Agile-and-Adaptive-Robotics/Bipedal_Robot/Documentation/Posters/Template/biorobotics_poster_template.pptx

The Insect Brain as a Model for Robotic Sensing
and Decision Making

Andrew D. Horchler¹, Roy E. Ritzmann², and Roger D. Quinn¹

1) Dept. of Mechanical and Aerospace Engineering and 2) Dept. of Biology, Case Western Reserve University

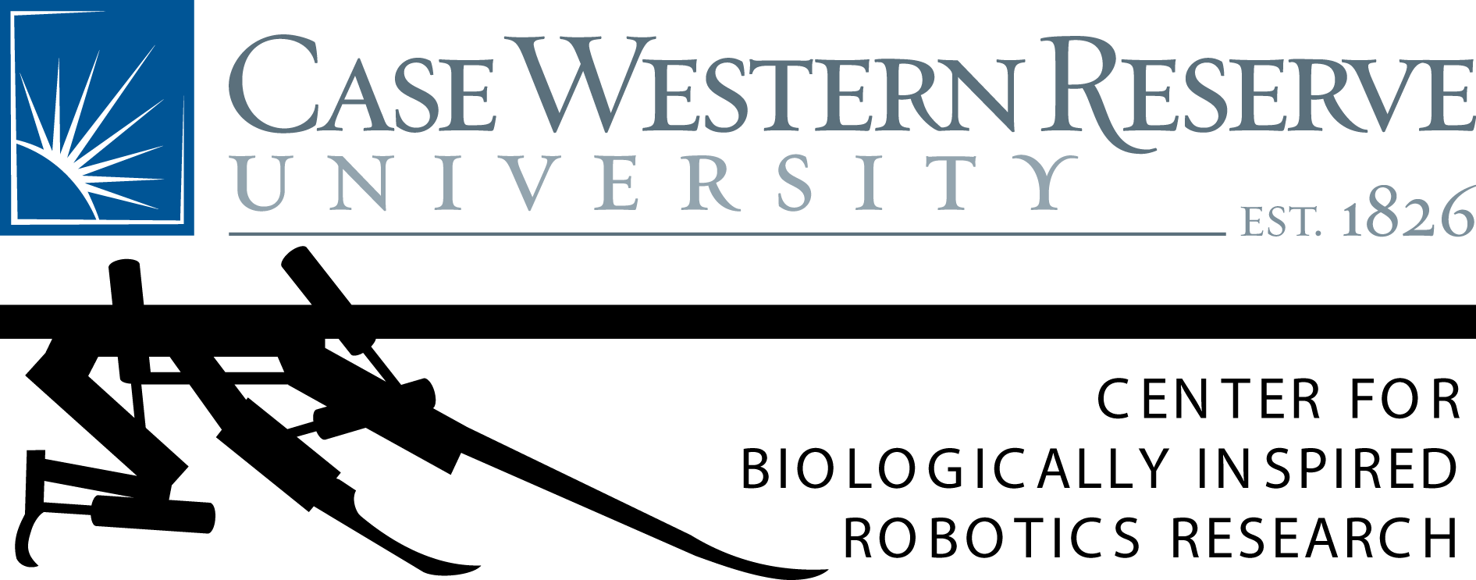
[picture p17: figure]

Introduction
Despite many technical advances, current mobile robots lack true autonomy, often require an operator, are restricted to constrained environments and tasks, and are difficult to program and tune. Insects function well in dynamic and uncertain environments that challenge the sensing and autonomous capabilities of existing robots. The insect brain relies on multiple sensory channels and a large behavioral repertoire to accomplish the complex goal-directed tasks needed for survival. The multi-sensory integration and decision-making capabilities of a brain are necessary to trigger, modulate, and provide context to the low-level, reflexive motor control. We’re developing a biologically-inspired sensorimotor system modeled on the architecture and behavioral functionality of the central complex (CC) of the insect brain and general principles of vertebrate brains to enhance the state-of-the-art in sensory integration and control for mobile robots. A simulated agent uses simple models of antennal sensing, vision, and ego-motion to navigate a 2-D environment. Percepts are organized via sensory maps that correlate the unique spatiotemporal and statistical properties of each sensing modality. These topographic maps are based on the distinct columnar design of the insect CC and are modeled as arrays of interconnected neural populations using Wilson-Cowan equations. The maps converge onto a network of neural circuits, based on a model of the primate lateral intraparietal cortex, that accumulates time-varying evidence in order to make behavioral decisions. The attractor dynamics of these circuits generate a winner-take-all competition that guarantees a decision within a fixed time period and the overall activity pattern captures the associated degree of confidence. Experiments have been performed to characterize the robustness of this biophysically plausible architecture in the presence noisy, ambiguous, and conflicting multi-sensory stimuli in the agent’s environment.

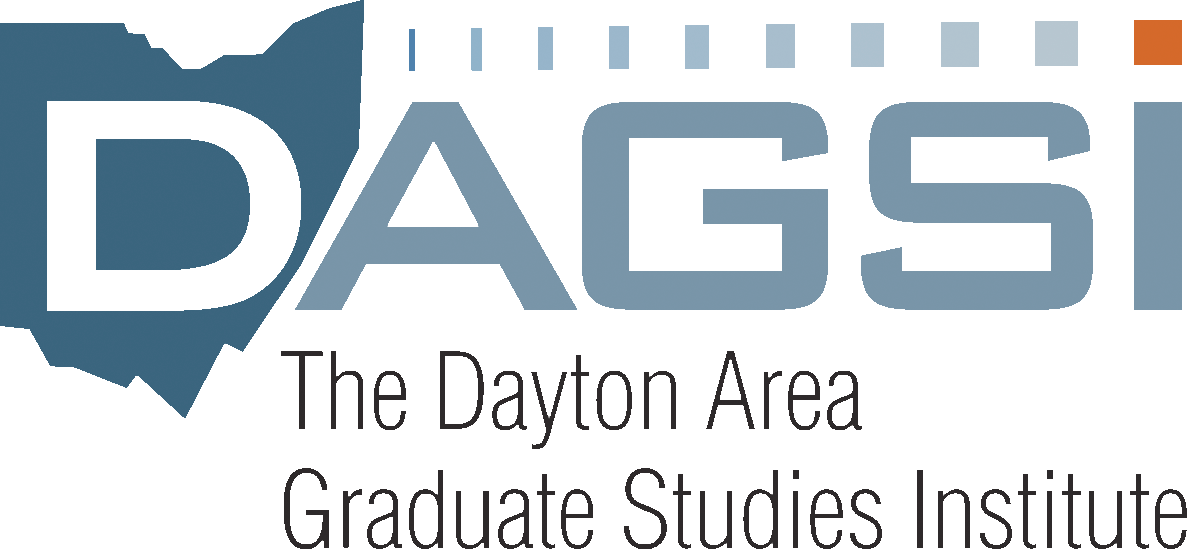
[picture p18: figure]
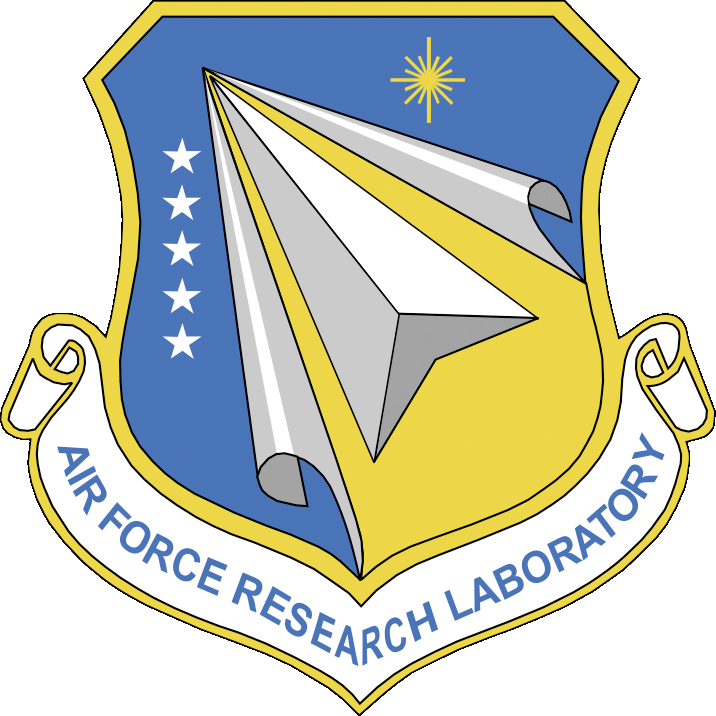
[picture p19: figure]
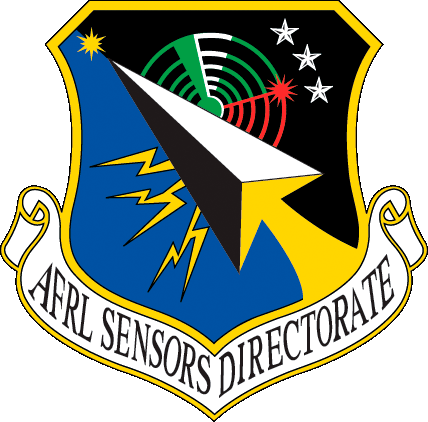
[picture p20: figure]

Heading

Regular text
- Bullet 1
- Bullet 2

References
1. Reference 1
2. Reference 2
3. Reference 3
