Agile-and-Adaptive-Robotics/Bipedal_Robot/Documentation/Meeting Notes/Bipedal Project Fa2020.rtf

Bipedal project meetings
Fall Term, 2020
10-6-2020

- Ben recap of priorities
- High priority: Femur and Tibia design. Two mounting holes, 1/4-20.
- Hose air fittings: design, test, print -> repeat as needed
- Note to self: Check out Microsoft surfacebook (pro 2.0?).
- Figure out questions we're hoping to answer with knee paper. what we're hoping to learn from the knee test.
- Quadriceps wrapping around knee or attach to a patella?
- Which method of calculating moment arm is correct?
- Insights from comparison of hamstring and quad?
- What torque values about the knee do we get from muscle x of xx diameter and xx length?
- How much time do we have to work on the project?
- Lindie, one class, but hopes to be done with project by the end of November.
- Ben, one class, but can spend a lot of time on the class.
- Lindie shows a prototype of the testing jig.
- Discussion about photographic data discussion. Ben and Lindie will both investigate methods to do it accurately. Connor will review for potential problems.
- Deliverables:
• Lindie: One or two more iterations of the prototype. Manufacturing in the garage will take a while.
• Ben: Have Femur and Tibia design done by the weekend. Where to put attachment point locations. Pin one end. How to wrap around knee? Multiple conisderations. Have design for review by the weekend, but don't necessarily print it
