Agile-and-Adaptive-Robotics/Bipedal_Robot/Documentation/Reports and Papers/Aidan Vogt Summer Overview.pptx

## KneeTest.m

- Used with KneeTorqueTest.ino and SLoadCell_ZeroFactorSketch.ino
- With KneeTorqueTest, Run command like this:
- Opens valve and reads pressure and force data

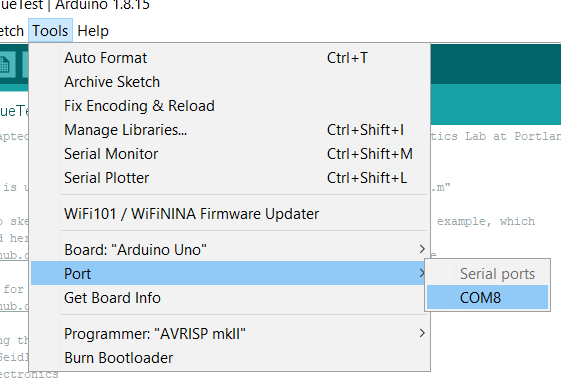
[picture p27: figure]

Protocol id (1 for zeroing the load cell, 2 for knee torque test)

The number of data points to collect

Port that the arduino is connected to (the number after the COM as seen in the example)

## KneeTorqueTest.ino

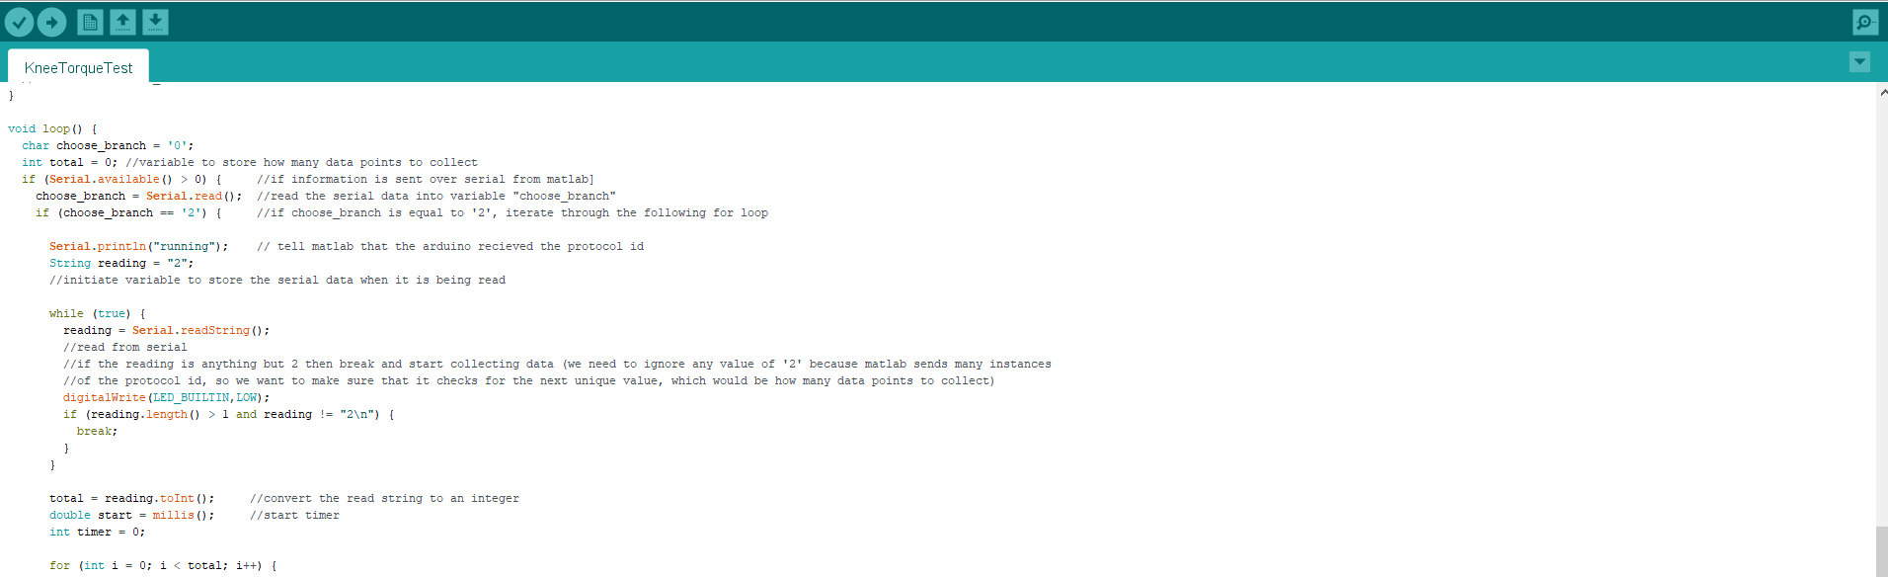
[picture p28: figure]

- Used with KneeTest.m
- To use without KneeTest.m:
  a. Open serial monitor inside arduino
  b. Send “2” until “running” is received
  c. Send number for how many data points to collect
  d. The arduino will start sending the data and open the valve

A

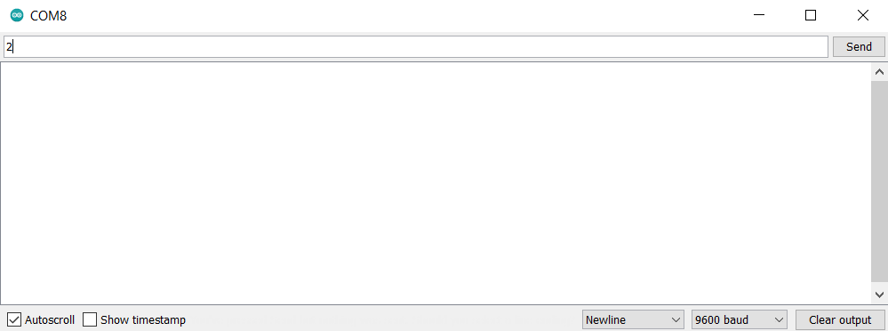
[picture p29: figure]
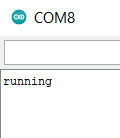
[picture p30: figure]

B

C

D

## ValvePWM.m

- Used with ValvePWM.ino
- Split into two phases: inflating and deflating
- Run command like this:

Amount of data points to be inflating

Period while inflating

Pulse width while deflating

Protocol id (2 for pwm test)

Port of arduino board (COM4 in this example)

Amount of data points to be deflating

Pulse width while inflating

Period while deflating

## ValvePWM.ino

- Used with ValvePWM.m
- To use without ValvePWM.m
  - Open Serial Monitor
  - Send “2” until “running” is received
  - Send values for data_in, data_out, pw_in, period_in, pw_out, and period_out in that order, separated by commas

## PressureTest.m

- Used for leak/fill test with PressureTest.ino
- Operated in the same way as KneeTest.m
- Only reports pressure

## PressureTest.ino

- Used for leak/fill test with PressureTest.m
- Operated in the same way as KneeTorqueTest.ino
- Only reports pressure

## Slide 7

Knee Joint

Physical Connection

BPA

Pressurized Air

Physical Connection

Valves

Air

Air

Air

Pressure Sensor

Load Cell

Data

Amp

Data

Data

Microcontroller

Transistors

Negative

On/Off

24V

Ground

Power Supply

Knee Test

## Slide 8

BPA

Pressurized Air

Physical Connection

Valves

Air

Air

Air

Pressure Sensor

Load Cell

Data

Amp

Data

Data

Microcontroller

Transistors

Negative

On/Off

24V

Ground

Power Supply

BPA characterization

## Slide 9

BPA

Pressurized Air

Valves

Air

Air

Air

Pressure Sensor

Data

Microcontroller

Transistors

Negative

On/Off

24V

Ground

Power Supply

Leak/fill test

## Slide 10

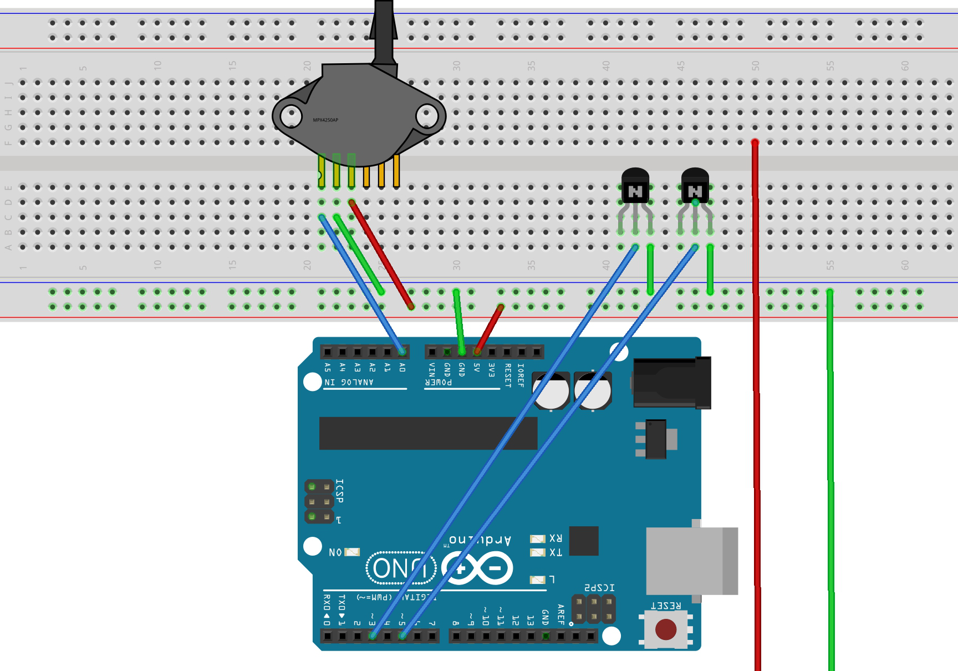
[picture p31: figure]

24v

24v

GND
