Agile-and-Adaptive-Robotics/Bipedal_Robot/Documentation/Reports and Papers/Bolen_3MT_PresentationSpeech.rtf

Neural control of locomotion is a complex process of sensing, processing, and acting that is not well understood. Greater understanding of this complex process necessitates modeling biomechanics and neural circuits, and investigating how interactions between the nervous system, the body, and the environment result in effective movement and behaviors. I propose that creating a bipedal (bipedal which means "two legs") robot that uses biologically inspired neural controllers to mimic human movements will deepen our understanding of muscle motor control.
Some of my work has been to design, from a biomechancial and engineering design approach, a bipedal human-like robot that mimics human movements. Our focus is on the lower portion of the human body. The picture on the left is a 3D printed skeleton. The bone segments are moved, or actuated, by Festo-brand pneumatic artificial muscles (PAMs). Theses artificial muscless can be used as muscles because they have force-length curves grossly similar to real muscles. The picture in the middle shows these artificial muscles as red lines attached to the robot skeleton. The attachment points of these muscles follow a similar path to human muscles, but slightly adjusted so that we can get similar joint torques as are found in human bodies.
So that's the physical robot side. My other work is to integrate these robots with neural controllers and feedback. [Feedback types include touch, stretch, and proprioception (the sixth sense)]. The picture on the right is the current neural controller schematic. It represents a 2-layer central pattern generator. This is how we believe certain movements are controlled via spinal cord circuits, before the need to involve higher order control from the brain. [Integrating biologically inspired neural controllers with biologically inspired robots will improve our understanding of neuroscience and biomechanics]
Much of my research work revolves around humanoid robots but the results are broadly applicable to other biomimetic robots that use PAMs, including the quadruped robot our lab is working on. Indeed, it is my hope that these robots will deepen our understanding of biological systems. Thank you for your consideration.

In our current work we build part of that robot (the knee, femur, and tibia), with uniarticular knee flexor and extensor PAMs, to test for the maximum isometric torque about the knee joint at various knee positions. However, previous experiments have only fully characterized the 10 mm diameter Festo PAM. Since our design uses 20 and 40 mm diameter Festo PAMs, we thought it important to fully characterize these PAM sizes and the results are included in this work. We compare the measured isometric torque values about the knee joint to the expected results, and discuss any deviation of the results. The results of these experiments help in better modeling and designing biomimetic humanoid robots.
