Agile-and-Adaptive-Robotics/Bipedal_Robot/Documentation/Reports and Papers/Solidworks Naming Convention.docx

Solidworks Naming Convention

Having the same naming convention for our parts and assemblies are important, especially when merging files and doing collaborative projects.

Here is the standard naming convention to use for Solidworks files:

Naming components

Separate with Underscores.

project #, assembly #, subassembly #, part #, Initials

Example:

01_01_01_01_AC

This is an example of the convention used for a project, the first assembly for it (which should be the main assembly), the subassembly (even if you don't really have a subassembly, just use the 01, you or someone else might make a second subassembly later), and the part number, which should start at 01 and continue (02 then 03 next, etc) in the timeline that you make the parts, regardless of assembly or subassembly.

Keep in mind that your timeline of parts creation should make sense (ex: main foot part > front foot part > toe part), that way your part names are somewhat recognized as being grouped, even without opening an assembly.

Naming Assemblies

Separate with underscores.

Project #, assembly #, subassembly #, Initials

Example

01_01_01_AC

This was a first project, first and main assembly, first subassembly, and initials. Refer to the explanation above for more information.

Suggestions for Naming Assemblies List (As created):

One project being worked on is the Bipedal Robot, it is considered project 01, with the below assembly numbers:

1. Foot Group
2. Lower leg Group
3. Knee Group
4. Upper leg Group

EX: A part for the knee group for the bipedal robot would be 01_03_01_01_AC
