Agile-and-Adaptive-Robotics/Bipedal_Robot/Code/Matlab/Bone_Mesh_Plots/Bone_Mesh_Plots_Readme.docx

Folder: Bone_Mesh_Plots

These scripts are meant to visualize both the skeletal structure and the muscle placement on the skeleton. No outputs are generated other than plots for quickly seeing how the muscles are placed on the structure.

Files and Descriptions:

Bone_Mesh_Plotting.m – This scrip plots the OpenSim skeletal points in Matlab. This script should be listed at the end of an muscle optimization script, as it will also pull location data from the optimization and plot the muscle on the skeletal structure. Requires no user input to run.

BoneMeshCode.m – This script creates a plot for ever skeletal structure from OpenSim as well as the overall skeleton. Requires no user input to run.

HipMotion.m – This script plots the OpenSim skeletal structure and rotates the Hip joint through it’s full range of flexion. Includes two muscles to display how they change in length as the hip actuates. Requires no user input to run
