Agile-and-Adaptive-Robotics/Bipedal_Robot/Documentation/Reports and Papers/Solidworks Naming Tree.xlsx

Prospective Parts | 01_00_00_Foot | 01_02_00_Foot | 01_01_02_01_FAxle.SLDPRT
 |  |  | 01_01_02_01_SmallAxle_Copy.SLDPRT
 |  |  | 01_01_02_02_FTLock.SLDPRT
 |  |  | 01_01_02_03_largeAxleLock.SLDPRT
 |  |  | 01_01_02_04_LeftMidFoot.SLDPRT
 |  |  | 01_01_02_05_NewFoot_Copy_ Copy.SLDPRT
 |  |  | 01_01_02_06_NewFrontFoot _Copy.SLDPRT
 |  |  | 01_01_02_07_NewFrontFoot.SLDPRT
 |  |  | 01_01_02_08_SmallAxleLock.SLDPRT
 |  |  | 01_01_02_09_SmallAxle.SLDPRT
 |  |  | 01_01_02_10_Toe.SLDPRT
 |  | 01_01_00_Ankle
 |  |  | 01_01_01_00_Ankle.SLDASM
 |  |  | 01_01_01_01_ABottom.SLDPRT
 |  |  | 01_01_01_02_AExterior.SLDPRT
 |  |  | 01_01_01_03_AInterior.SLDPRT
 |  |  | 01_01_01_04_ALock1.SLDPRT
 |  |  | 01_01_01_05_ALock2.SLDPRT
 |  |  | 01_01_01_06_AMiddleShell.SLDPRT
 |  |  | 01_01_01_07_FootAxle.SLDPRT
 |  |  | 01_01_01_08_Foot T Lock.SLDPRT
 | 02_00_00_InternFoot
 |  | 01_01_00_01_ML.SLDPRT
 |  | 01_01_00_02_ML.SLDPRT
 |  | 01_01_00_03_ML.SLDPRT
 |  | 01_01_00_04_ML.SLDPRT
 |  | 01_01_01_01_ML.SLDPRT
 |  | 01_01_01_02_ML.SLDPRT
 |  | 01_01_01_03_ML.SLDPRT
 |  | 01_01_01_ML.SLDASM
 |  | 01_ML.SLDASM
RobotAssembly2019 | 01-Vertebrae
 |  | 01_01_L2 with Attachments.SLDPRT
 |  | 01_02_L4.SLDPRT
 |  | 01_02_L5 with Attatchments.SLDPRT
 | 02-Sacrum
 |  | 02_01_Sacrum.SLDPRT
 | 03-Ilium
 |  | 03_01_Left Ilium Wing.SLDPRT
 |  | 03_02_Right Ilium Wing.SLDPRT
 | 04-Femor
 |  | 04_01_Femoral Knob.SLDPRT
 |  | 04_02_Femoral Head.SLDPRT
 |  | 04_03_Femoral Head Mirrored.SLDPRT
 |  | 04_04_Femor Bone.SLDPRT
 |  | 04_05_Femor Bone Mirrored.SLDPRT
 |  | 04_05_Femoral End.SLDPRT
 |  | 04_06_Femoral End Mirrored.SLDPRT
 |  | 04_07_Femor-Tibia Link.SLDPRT
 |  | Femoral end with hardware - Latest.SLDPRT
 | 05-Tibia
 |  | 05_01_Tibial Head.SLDPRT
 |  | 05_02_Tibial Head Mirrored.SLDPRT
 |  | 05_03_Tibial Rotator.SLDPRT
 |  | 05_04_Tibial Rotator Mirrored.SLDPRT
 |  | 05_05_Tibial Bone Connection.SLDPRT
 |  | 05_06_Tibial End.SLDPRT
 |  | 05_07_Tibial End Mirrored.SLDPRT
 |  | Base part tibial bone connection.SLDPRT
 |  | Tibial assemb.SLDASM
 |  | Tibial head with hardware - bone connection - test.SLDPRT
 |  | Tibial head with hardware - bone connection -Latest.SLDPRT
 | 06-Foot
 |  | 06_01_Foot.SLDASM
 |  | Metatarsals - Left side.SLDPRT
 |  | Metatarsals.SLDPRT
 |  | Phalanges - Left side.SLDPRT
 |  | Phalanges.SLDPRT
 |  | Talus - New201810205.SLDPRT
 | 07-David Leg | RobotAssembly2019_07_01-David Femor
 |  |  | FemorBone_111219_V2_DP.SLDPRT
 |  |  | FemorKneeEnd_103119_V13_DP.SLDPRT
 |  |  | FemoralHead_010620_V1_DP.SLDPRT
 |  |  | ~$FemorBone_111219_V2_DP.SLDPRT
 |  |  | ~$FemorKneeEnd_103119_V13_DP.SLDPRT
 |  |  | ~$FemoralHead_010620_V1_DP.SLDPRT
 |  | RobotAssembly2019_07_02-David Tibia
 |  |  | TibialHead_103119_V1_DP.SLDPRT
 |  |  | Tibial_011020_V2_DP.SLDPRT
 |  |  | ~$TibialHead_103119_V1_DP.SLDPRT
 |  |  | ~$Tibial_011020_V2_DP.SLDPRT
 |  | RobotAssembly2019_07_03-David Connection
 |  |  | BackLinkV1.SLDPRT
 |  |  | BoneConnectionScrews_97763A348_McMaster.SLDPRT
 |  |  | BrassInsert_94459A380_McMaster.SLDPRT
 |  |  | CushioningWasher_93650A145_McMaster.SLDPRT
 |  |  | FrontLinkV1.SLDPRT
 |  |  | ThreadedStud_97042A216_McMaster.SLDPRT
 |  |  | ~$BackLinkV1.SLDPRT
 |  |  | ~$BoneConnectionScrews_97763A348_McMaster.SLDPRT
 |  |  | ~$BrassInsert_94459A380_McMaster.SLDPRT
 |  |  | ~$CushioningWasher_93650A145_McMaster.SLDPRT
 |  |  | ~$FrontLinkV1.SLDPRT
 |  |  | ~$ThreadedStud_97042A216_McMaster.SLDPRT
 |  | FemoralAssembly_V3_022820.SLDASM
 |  | ~$FemoralAssembly_V3_022820.SLDASM
 | robot2019.SLDASM
 | ~$Tibial assemb.SLDASM
 | ~$Tibial head with hardware - bone connection - test.SLDPRT
