Agile-and-Adaptive-Robotics/Bipedal_Robot/Documentation/Reports and Papers/Isometric_Force_Test/Paper Gantt chart.xlsx

Sheet: Project schedule
Knee Torque paper |  |  |  |  | Project start: |  |  |  |  |  |  |  | 2023-12-07
Ben Bolen | Project lead |  |  |  | Display week: |  |  |  |  |  |  |  | 1
SIMPLE GANTT CHART by Vertex42.com (https://www.vertex42.com/ExcelTemplates/simple-gantt-chart.html)
https://www.vertex42.com/ExcelTemplates/simple-gantt-chart.html |  |  |  |  | 2023-12-04 |  |  |  |  |  |  | 2023-12-11 |  |  |  |  |  |  | 2023-12-18 |  |  |  |  |  |  | 2023-12-25 |  |  |  |  |  |  | 2024-01-01 |  |  |  |  |  |  | 2024-01-08 |  |  |  |  |  |  | 2024-01-15 |  |  |  |  |  |  | 2024-01-22
TASK | ASSIGNED TO | PROGRESS | START | END | 2023-12-04 | 2023-12-05 | 2023-12-06 | 2023-12-07 | 2023-12-08 | 2023-12-09 | 2023-12-10 | 2023-12-11 | 2023-12-12 | 2023-12-13 | 2023-12-14 | 2023-12-15 | 2023-12-16 | 2023-12-17 | 2023-12-18 | 2023-12-19 | 2023-12-20 | 2023-12-21 | 2023-12-22 | 2023-12-23 | 2023-12-24 | 2023-12-25 | 2023-12-26 | 2023-12-27 | 2023-12-28 | 2023-12-29 | 2023-12-30 | 2023-12-31 | 2024-01-01 | 2024-01-02 | 2024-01-03 | 2024-01-04 | 2024-01-05 | 2024-01-06 | 2024-01-07 | 2024-01-08 | 2024-01-09 | 2024-01-10 | 2024-01-11 | 2024-01-12 | 2024-01-13 | 2024-01-14 | 2024-01-15 | 2024-01-16 | 2024-01-17 | 2024-01-18 | 2024-01-19 | 2024-01-20 | 2024-01-21 | 2024-01-22 | 2024-01-23 | 2024-01-24
 |  |  |  |  | M | T | W | T | F | S | S | M | T | W | T | F | S | S | M | T | W | T | F | S | S | M | T | W | T | F | S | S | M | T | W | T | F | S | S | M | T | W | T | F | S | S | M | T | W | T | F | S | S | M | T | W
Initiation
Submit paper | Ben Bolen | 15% | 2023-11-30 | 2023-12-18
Revise draft | Ben Bolen | 0% | 2023-12-12 | 2023-12-17
Working draft | Ben Bolen | 50% | 2023-11-30 | 2023-12-12
Analysis
Update algorithms with new 10,20 mm force equations | Ben Bolen | 25% | 2023-12-02 | 2023-12-07
Create optimization for KSE | Ben Bolen | 25% | 2023-12-07 | 2023-12-08
Compare and run algorithm | Ben Bolen | 0% | 2023-12-02 | 2023-12-09
Update other algorithms with KSE | Ben Bolen |  | 2023-12-09 | 2023-12-10
Revise figures | Ben Bolen |  | 2023-12-10 | 2023-12-11
total | Ben Bolen |  | 2023-12-02 | 2023-12-11
Section writing
Intro: C3NS references | Ben Bolen | 2% | 2023-12-08 | 2023-12-09
Method: Hybrid torque | Ben Bolen | 2% | 2023-12-07 | 2023-12-10
Method: optimization? | Ben Bolen | 2% | 2023-12-07 | 2023-12-09
Results | Ben Bolen | 66% | 2023-12-07 | 2023-12-11
Conclusion | Ben Bolen | 5% | 2023-12-11 | 2023-12-12
total | Ben Bolen | 0% | 2023-12-07 | 2023-12-12
Figures
Fmax (A) | Ben Bolen | 100% | 2023-12-09 | 2023-12-12
Fmax (D) | Ben Bolen | 100% | 2023-12-12 | 2023-12-13
10mm biomimetic extensor | Ben Bolen | 50% | 2023-12-14 | 2023-12-15
20mm biomimetic flexor | Ben Bolen | 33% | 2023-12-15 | 2023-12-16
total | Ben Bolen | 10% | 2023-12-09 | 2023-12-16
Insert new rows ABOVE this one

Sheet: About
SIMPLE GANTT CHART by Vertex42.com (https://www.vertex42.com/ExcelTemplates/simple-gantt-chart.html)
About This Template
This template provides a simple way to create a Gantt chart to help visualize and track your project. Simply enter your tasks and start and end dates - no formulas required. The bars in the Gantt chart represent the duration of the task and are displayed using conditional formatting. Insert new tasks by inserting new rows.
Guide for Screen Readers
There are 2 worksheets in this workbook. TimeSheet About The instructions for each worksheet are in the A column starting in cell A1 of each worksheet. They are written with hidden text. Each step guides you through the information in that row. Each subsequent step continues in cell A2, A3, and so on, unless otherwise explicitly directed. For example, instruction text might say "continue to cell A6" for the next step. This hidden text will not print. To remove these instructions from the worksheet, simply delete column A.
Additional Help
Click on the link below to visit vertex42.com and learn more about how to use this template, such as how to calculate days and work days, create task dependencies, change the colors of the bars, add a scroll bar to make it easier to change the display week, extend the date range displayed in the chart, etc.
How to Use the Simple Gantt Chart (https://www.vertex42.com/ExcelTemplates/simple-gantt-chart.html)
More Project Management Templates
Visit Vertex42.com to download other project management templates, including different types of project schedules, Gantt charts, tasks lists, etc.
Project Management Templates (https://www.vertex42.com/ExcelTemplates/excel-project-management.html)
About Vertex42
Vertex42.com provides over 300 professionally designed spreadsheet templates for business, home, and education - most of which are free to download. Their collection includes a variety of calendars, planners, and schedules as well as personal finance spreadsheets for budgeting, debt reduction, and loan amortization.
Businesses will find invoices, time sheets, inventory trackers, financial statements, and project planning templates. Teachers and students will find resources such as class schedules, grade books, and attendance sheets. Organize your family life with meal planners, checklists, and exercise logs. Each template is thoroughly researched, refined, and improved over time through feedback from thousands of users.
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
