Agile-and-Adaptive-Robotics/Bipedal_Robot/Code/Matlab/github_repo/HX711.jpg

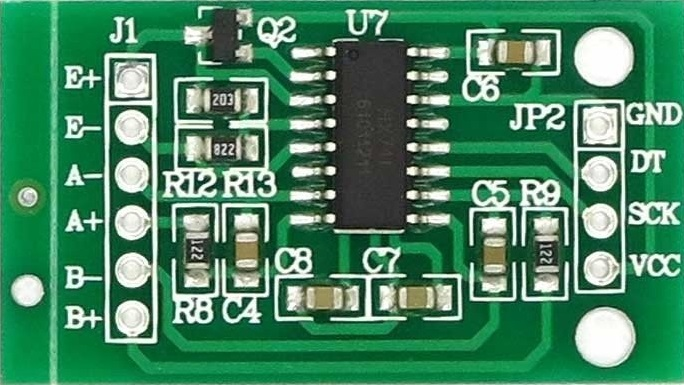
Code/Matlab/github_repo/HX711.jpg
