Agile-and-Adaptive-Robotics/Bipedal_Robot/Documentation/Posters/Bolen_NWBS_2021/Bolen_B9.jpg

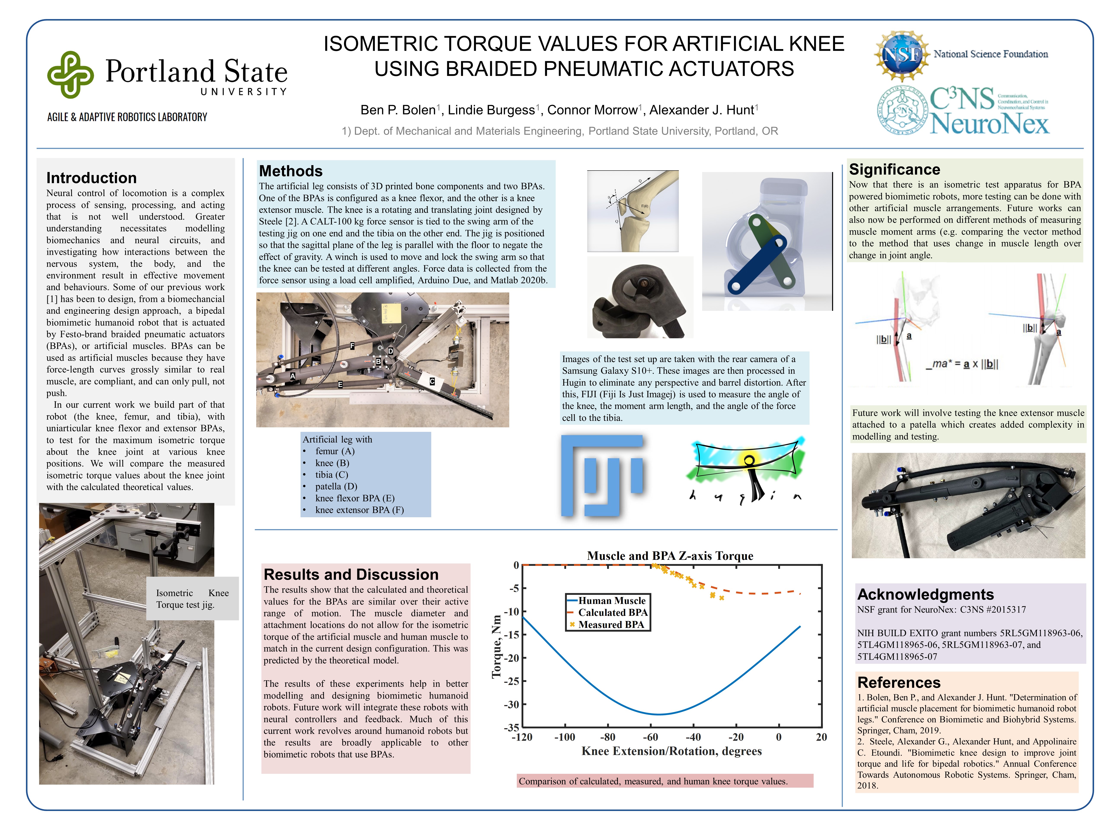
Documentation/Posters/Bolen_NWBS_2021/Bolen_B9.jpg
