Agile-and-Adaptive-Robotics/Bipedal_Robot/Documentation/Reports and Papers/Bolen_LM2023/Figures/GeneralizedForceFit.png

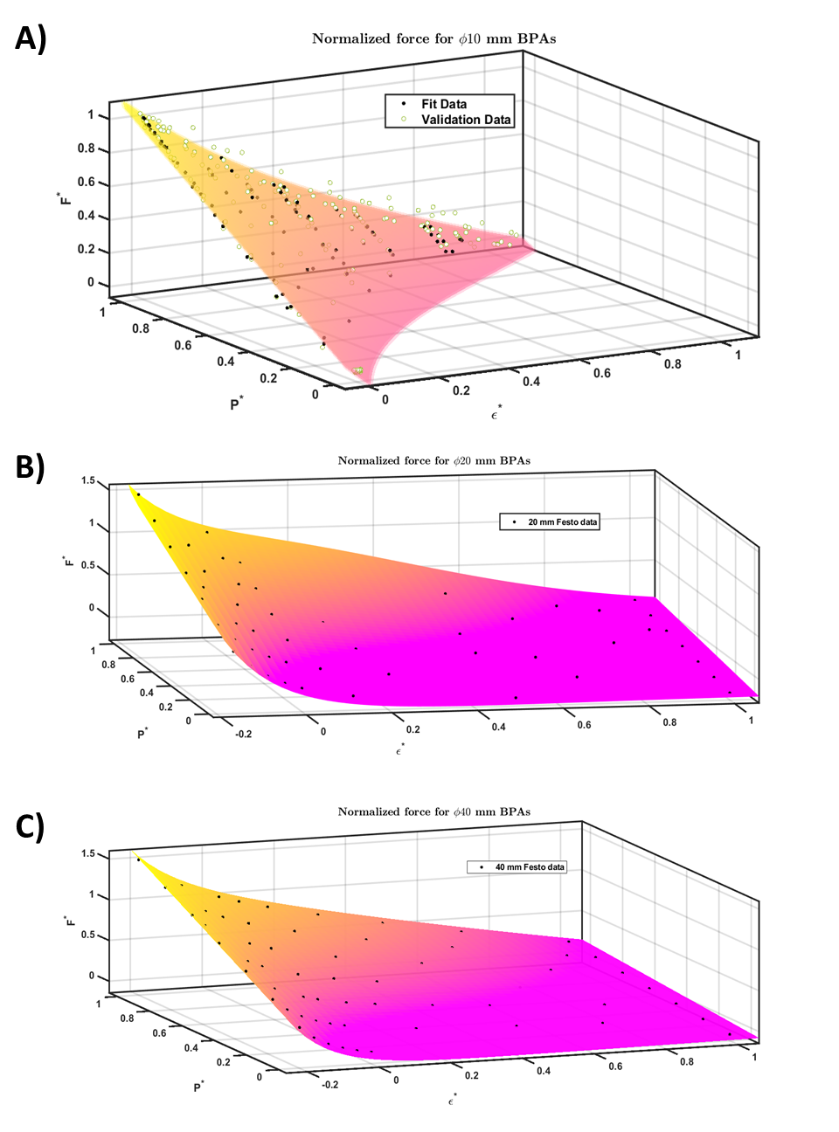
Documentation/Reports and Papers/Bolen_LM2023/Figures/GeneralizedForceFit.png
