Agile-and-Adaptive-Robotics/Bipedal_Robot/Pictures/PictureAnalysis/20mm_fullinflate.PNG

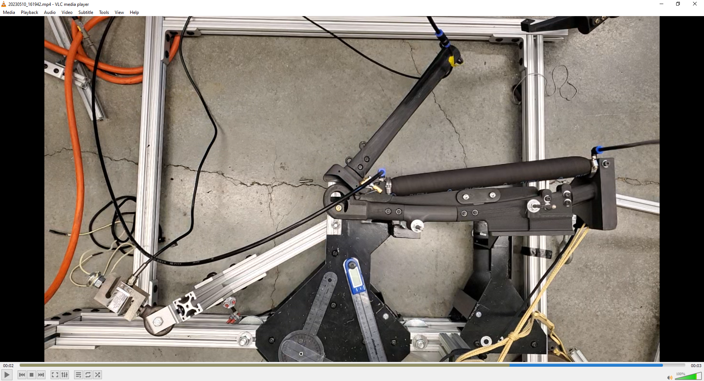
Pictures/PictureAnalysis/20mm_fullinflate.PNG
