Agile-and-Adaptive-Robotics/Bipedal_Robot/Pictures/PictureAnalysis/20mm_inflating_90deg.PNG

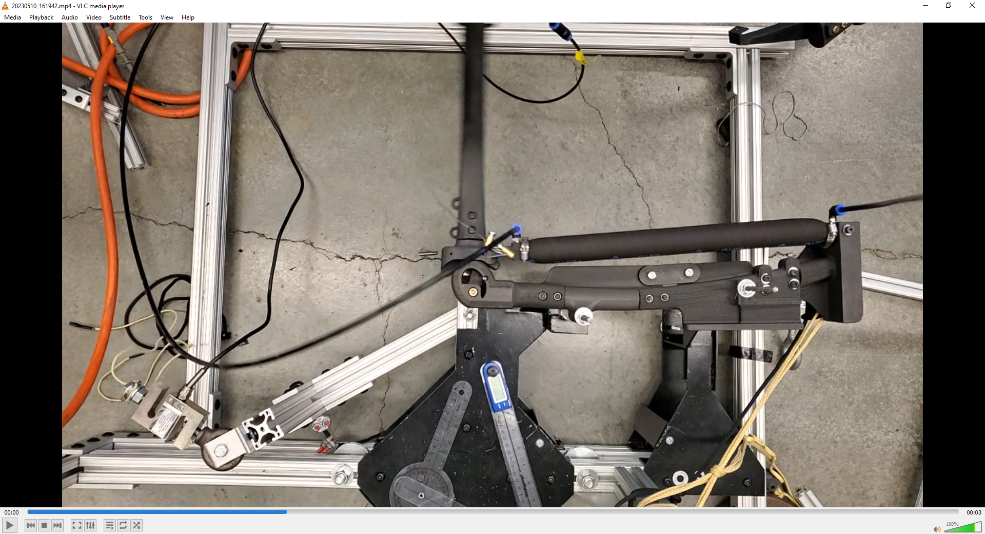
Pictures/PictureAnalysis/20mm_inflating_90deg.PNG
