Agile-and-Adaptive-Robotics/Bipedal_Robot/Pictures/PictureAnalysis/20mm_uninflate.PNG

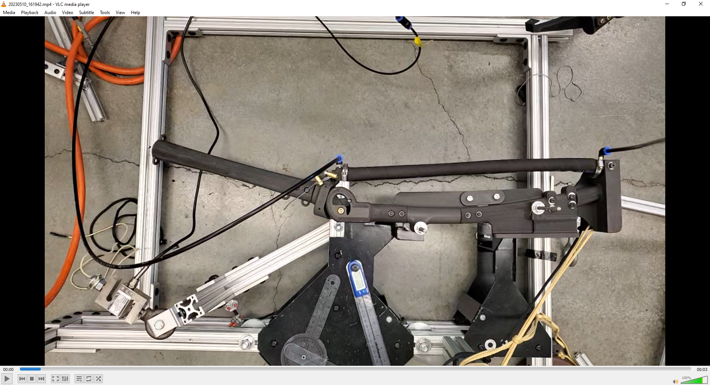
Pictures/PictureAnalysis/20mm_uninflate.PNG
