Agile-and-Adaptive-Robotics/Bipedal_Robot/Pictures/PictureAnalysis/20220202_134828.jpg

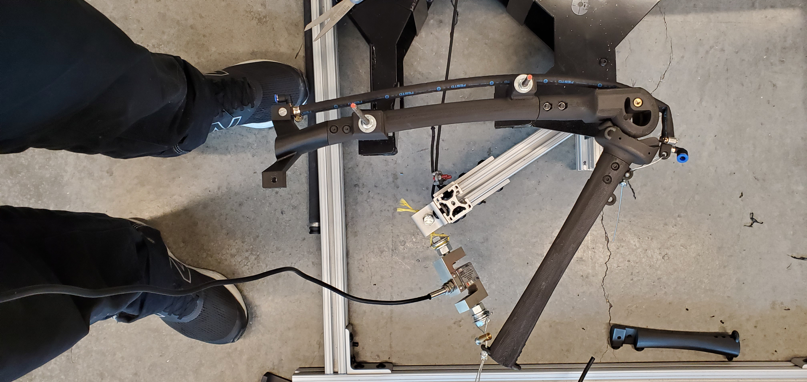
Pictures/PictureAnalysis/20220202_134828.jpg
