Agile-and-Adaptive-Robotics/Bipedal_Robot/Pictures/PictureAnalysis/20220307_222908.jpg

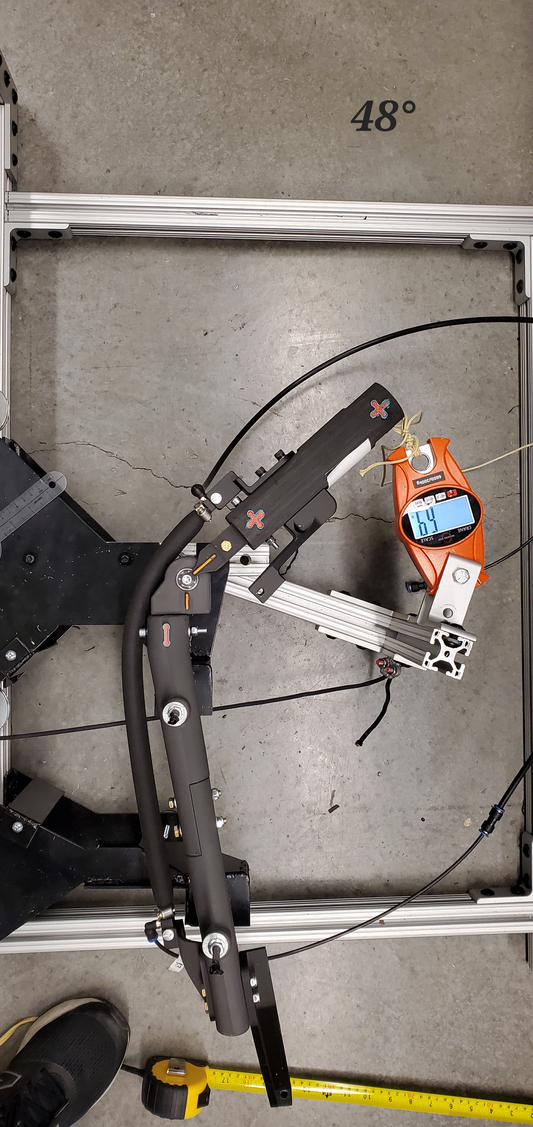
Pictures/PictureAnalysis/20220307_222908.jpg
