Agile-and-Adaptive-Robotics/Bipedal_Robot/Pictures/PictureAnalysis/20220308_031822.jpg

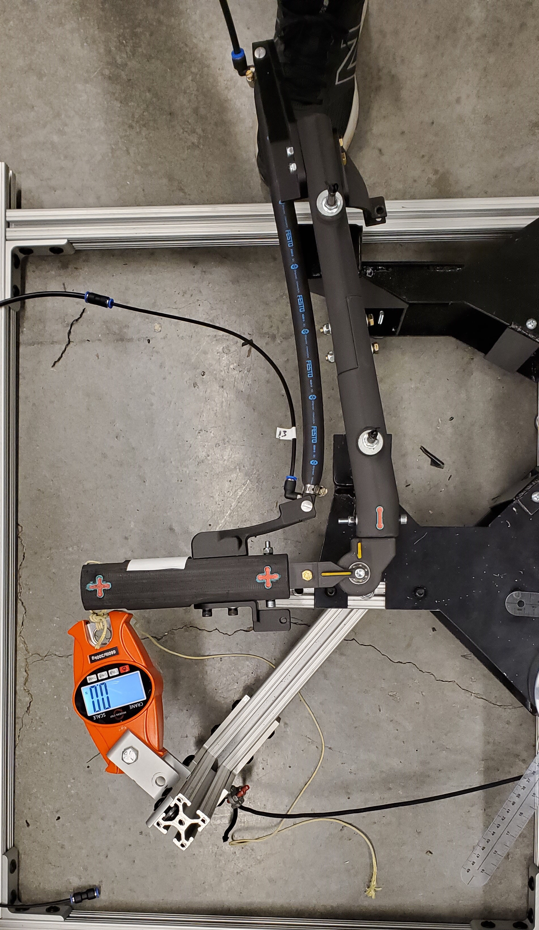
Pictures/PictureAnalysis/20220308_031822.jpg
