Agile-and-Adaptive-Robotics/Bipedal_Robot/Pictures/PictureAnalysis/20220308_032827.jpg

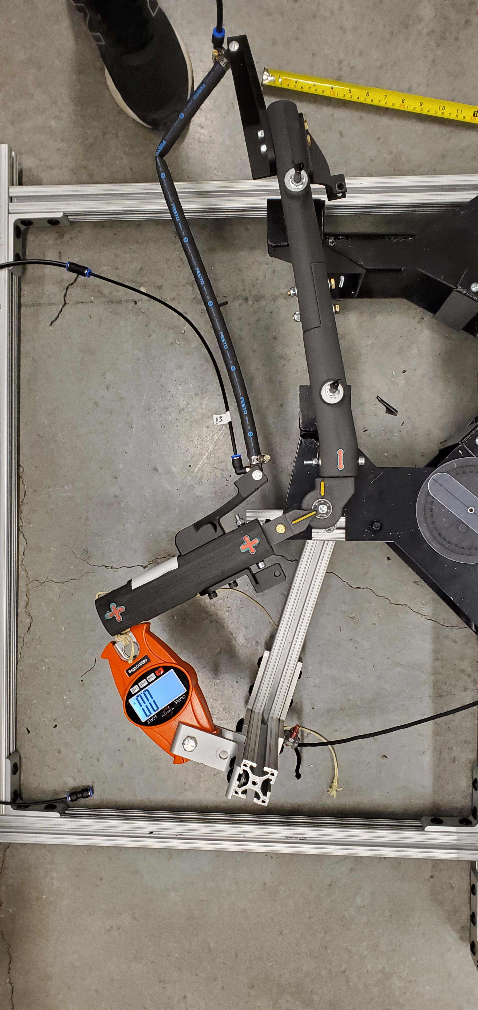
Pictures/PictureAnalysis/20220308_032827.jpg
