Agile-and-Adaptive-Robotics/Bipedal_Robot/Pictures/PictureAnalysis/20220319_150454.jpg

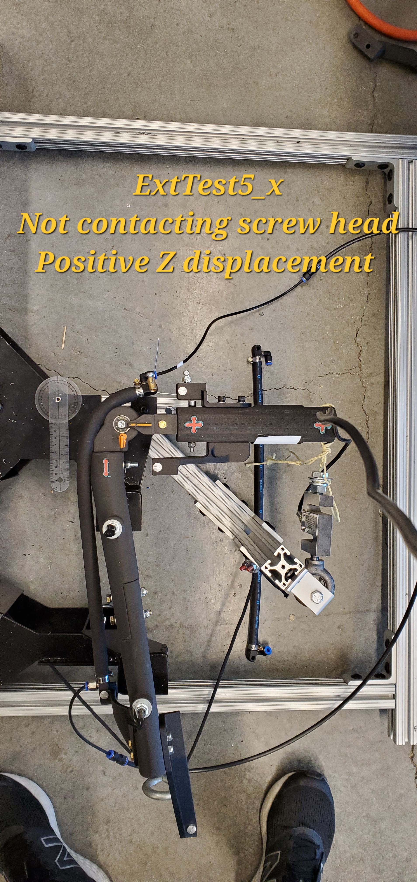
Pictures/PictureAnalysis/20220319_150454.jpg
