Agile-and-Adaptive-Robotics/Bipedal_Robot/Pictures/PictureAnalysis/20230419_225929.jpg

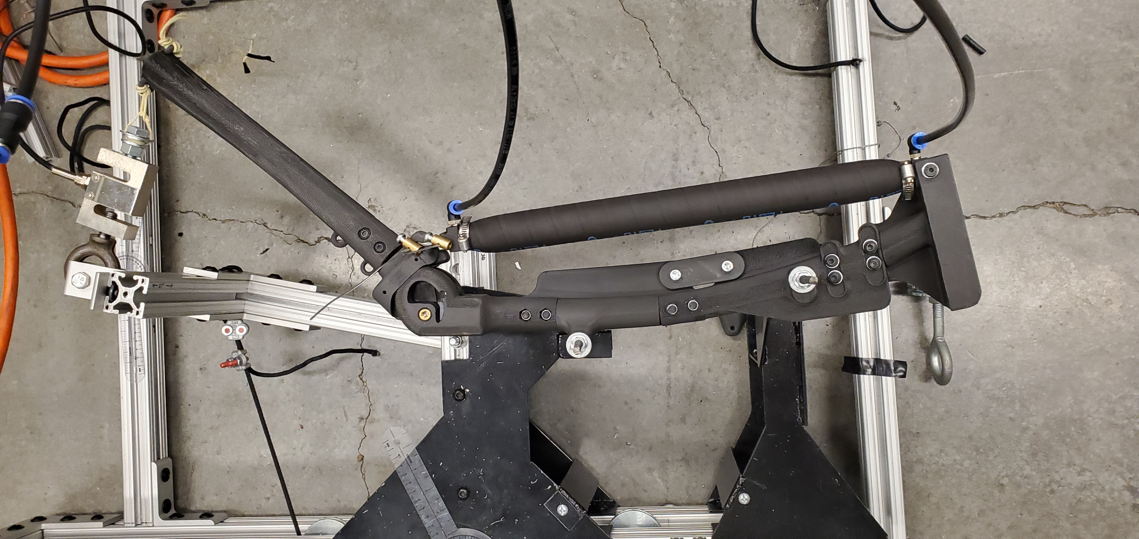
Pictures/PictureAnalysis/20230419_225929.jpg
