Agile-and-Adaptive-Robotics/Bipedal_Robot/Pictures/PictureAnalysis/20230419_230556.jpg

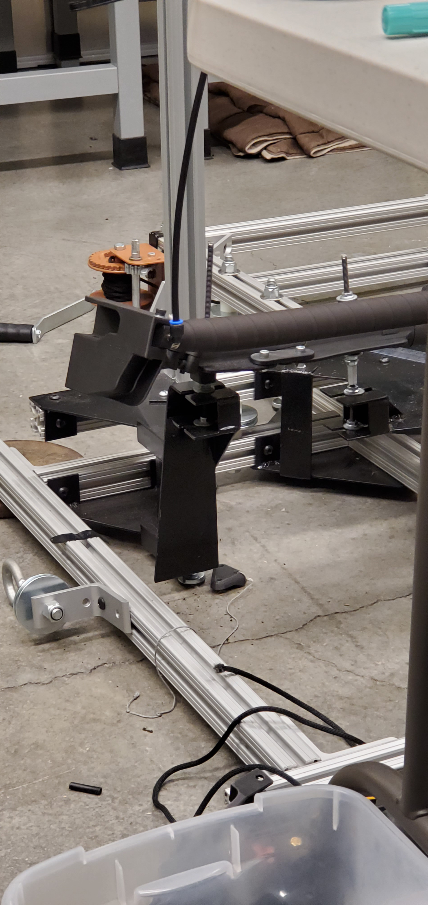
Pictures/PictureAnalysis/20230419_230556.jpg
