Agile-and-Adaptive-Robotics/Bipedal_Robot/Pictures/PictureAnalysis/FlexText4_pinned_FishScale_leak.jpg

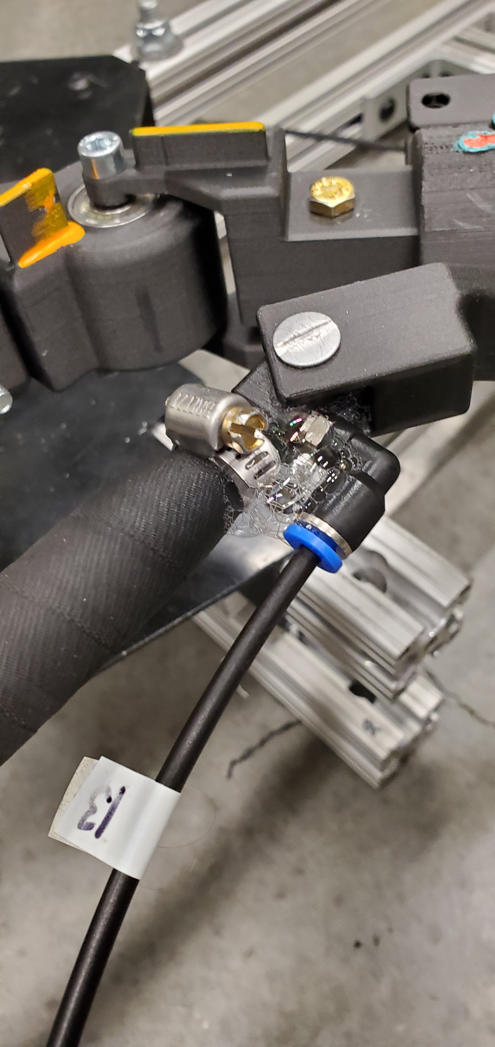
Pictures/PictureAnalysis/FlexText4_pinned_FishScale_leak.jpg
