Agile-and-Adaptive-Robotics/Bipedal_Robot/Pictures/PictureAnalysis/KneeExt_10mm_passthru.png

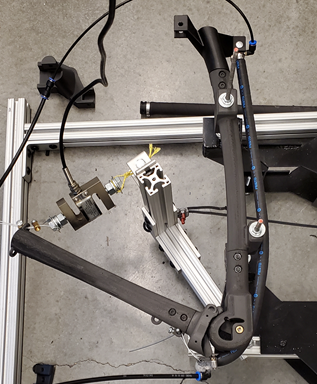
Pictures/PictureAnalysis/KneeExt_10mm_passthru.png
