Agile-and-Adaptive-Robotics/Bipedal_Robot/Pictures/PictureAnalysis/Screenshot_20230113-141339_Gallery.png

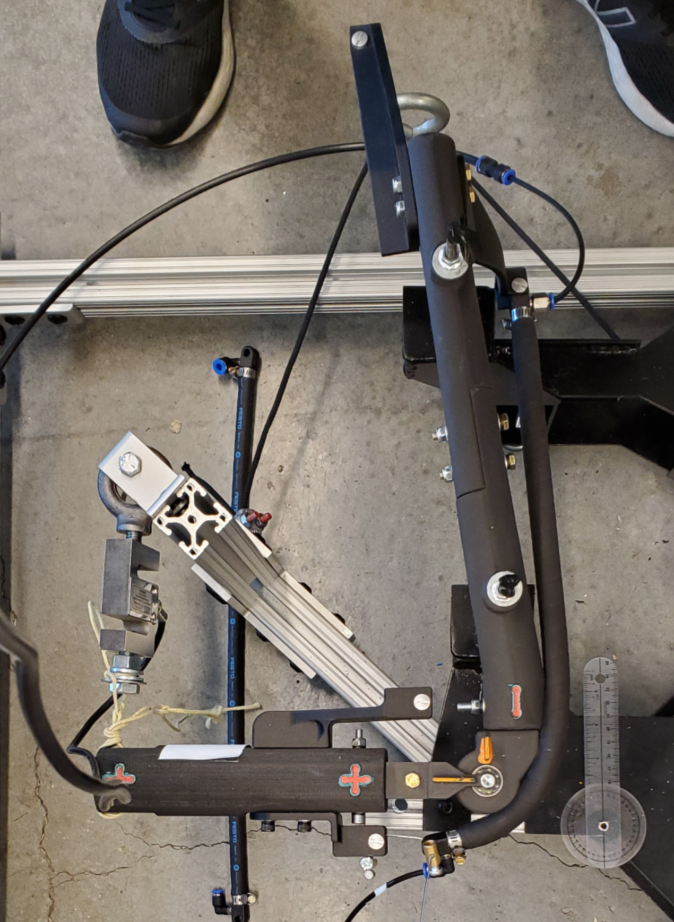
Pictures/PictureAnalysis/Screenshot_20230113-141339_Gallery.png
