Agile-and-Adaptive-Robotics/Bipedal_Robot/Pictures/PictureAnalysis/Screenshot_20230113-141639_Gallery.png

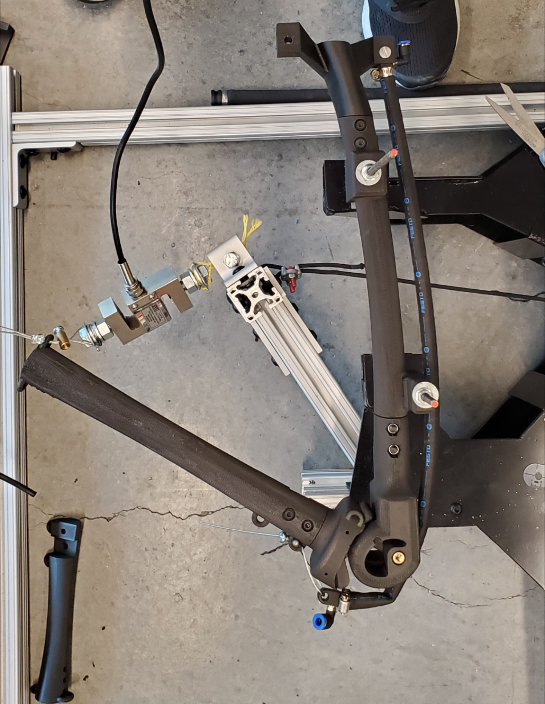
Pictures/PictureAnalysis/Screenshot_20230113-141639_Gallery.png
