Agile-and-Adaptive-Robotics/Bipedal_Robot/Pictures/PictureAnalysis/Screenshot_20230113_141917.png

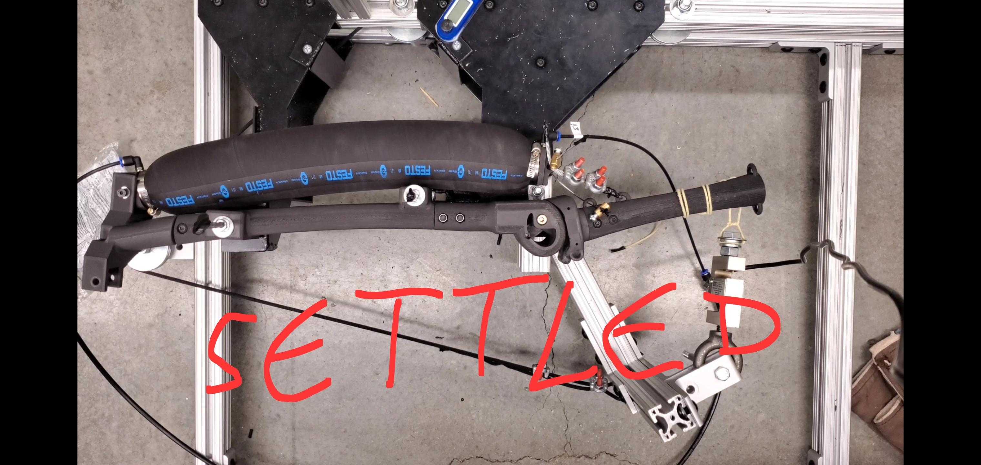
Pictures/PictureAnalysis/Screenshot_20230113_141917.png
