Agile-and-Adaptive-Robotics/Bipedal_Robot/Pictures/PictureAnalysis/Screenshot_20230122_211647.png

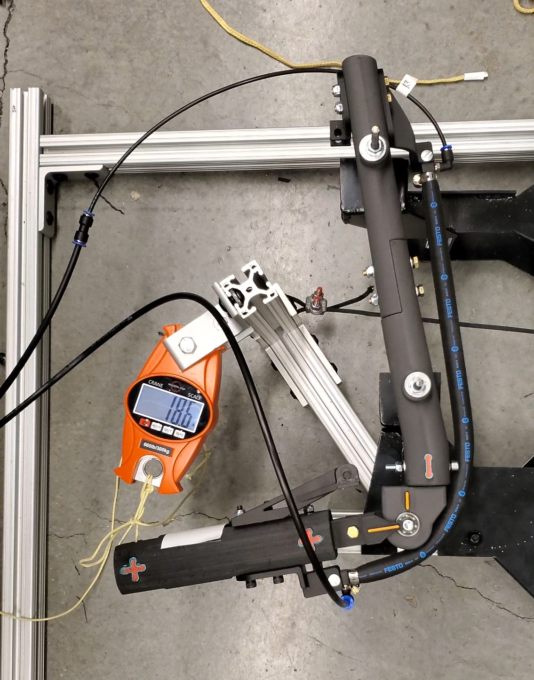
Pictures/PictureAnalysis/Screenshot_20230122_211647.png
