Agile-and-Adaptive-Robotics/Bipedal_Robot/Pictures/PictureAnalysis/Screenshot_20240324_184313.png

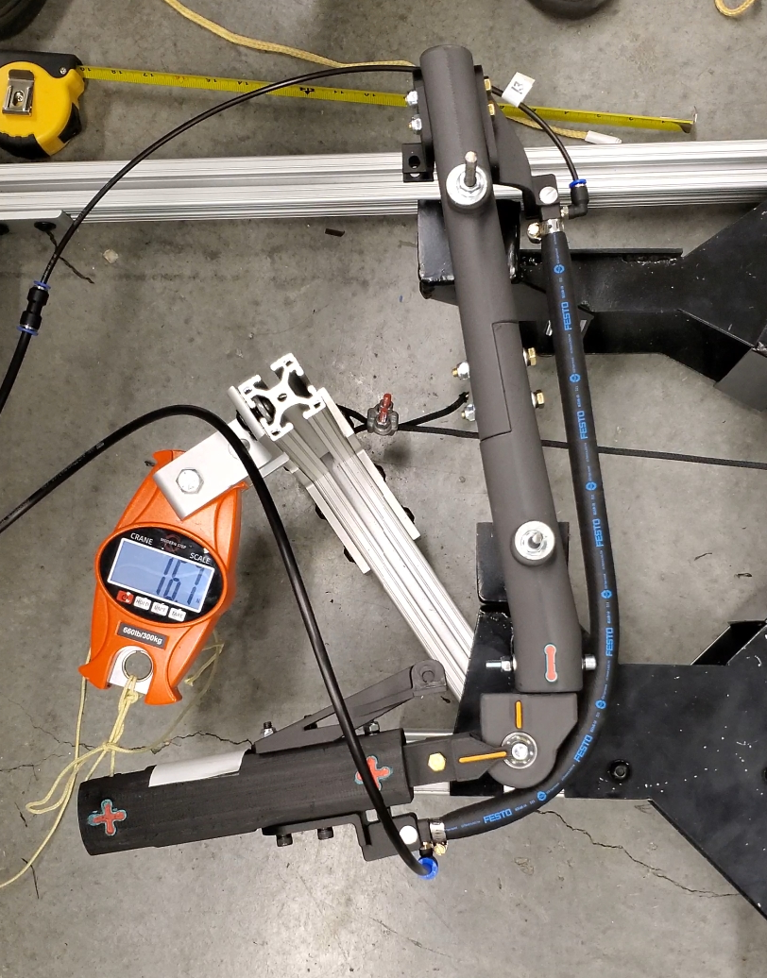
Pictures/PictureAnalysis/Screenshot_20240324_184313.png
