Agile-and-Adaptive-Robotics/Bipedal_Robot/Solid_Models/Biomimetics_2022-Knee_Test/Artificial tendon concepts/caliper-brake-anatomy.jpg

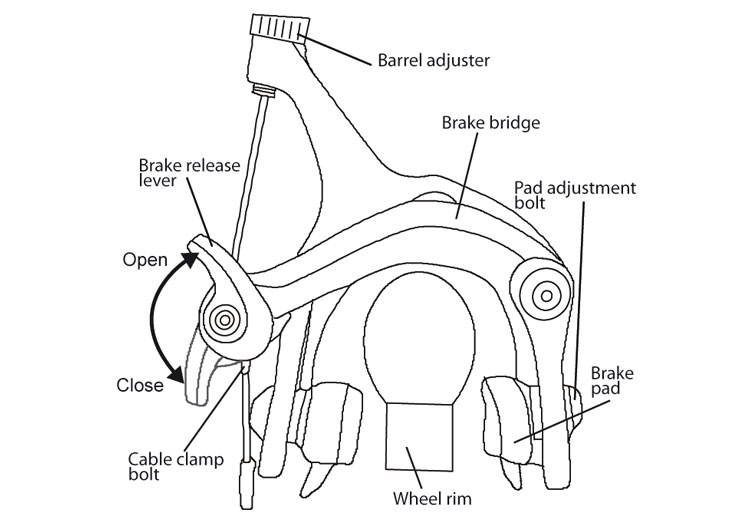
Solid_Models/Biomimetics_2022-Knee_Test/Artificial tendon concepts/caliper-brake-anatomy.jpg
