Agile-and-Adaptive-Robotics/Bipedal_Robot/Solid_Models/Biomimetics_2022-Knee_Test/Artificial tendon concepts/Push-pull cable.jpg

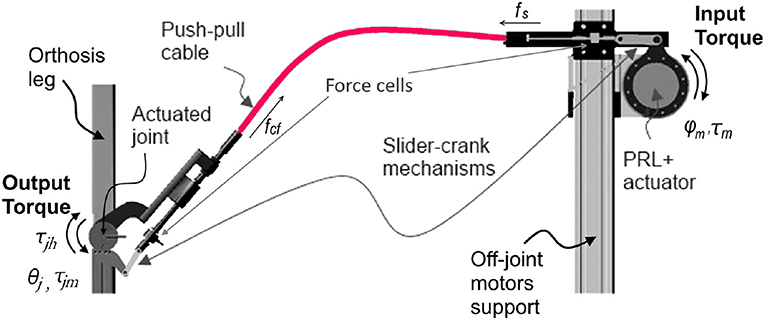
Solid_Models/Biomimetics_2022-Knee_Test/Artificial tendon concepts/Push-pull cable.jpg
