Agile-and-Adaptive-Robotics/Bipedal_Robot/Solid_Models/Vendor_Parts/BoM.xlsx

Part Number | Type | Description | Vendor | File | Ordering Link
5779K246 | Push-to-Connect Tube Fitting for Air | Straight Adapter, for 1/4" Tube OD x 10-32 Thread Male | McMaster-Carr | 5779K246_PUSH-TO-CONNECT TUBE FITTING FOR AIR.SLDPRT | https://www.mcmaster.com/5779K246/
5779K494 | Push-to-Connect Tube Fitting for Air | Straight Adapter for 1/4" Tube OD, M5 x 0.8 Male | McMaster-Carr | 5779K494_PUSH-TO-CONNECT TUBE FITTING FOR AIR.SLDPRT | https://www.mcmaster.com/5779K494/
5779K109 | Push-to-Connect Tube Fitting for Air | Straight Adapter, for 1/4" Tube OD x 1/4 NPT Male | McMaster-Carr | 5779K109_PUSH-TO-CONNECT TUBE FITTING FOR AIR.SLDPRT | https://www.mcmaster.com/5779K109/
5779K286 | Push-to-Connect Tube Fitting for Air | 90 Degree Swivel Elbow, 1/4" Tube x 10-32 Thread Male Pipe | McMaster-Carr | 5779K286_PUSH-TO-CONNECT TUBE FITTING FOR AIR.SLDPRT | https://www.mcmaster.com/5779K286/
5225K566 | Push-to-Connect Tube Fitting for Air | 90 Degree Swivel Elbow, 6 mm Tube, M5 x 0.8 mm Pipe | McMaster-Carr | 5225K566_PUSH-TO-CONNECT TUBE FITTING FOR AIR.SLDPRT | https://www.mcmaster.com/5225K566/
5779K152 | Push-to-Connect Tube Fitting for Air | 90 Degree Swivel Elbow, for 1/4" Tube OD x 1/4 NPT Male | McMaster-Carr | 5779K152_PUSH-TO-CONNECT TUBE FITTING FOR AIR.SLDPRT | https://www.mcmaster.com/5779K152/
5388K18 | Worm-Drive Clamps for Firm Hose and Tube | Steel Screw, 5/16" Band Width, 9/16" to 1-1/16" Clamp ID | McMaster-Carr | 5388K180_WORM-DRIVE CLAMPS FOR FIRM HOSE AND TUBE.SLDPRT | https://www.mcmaster.com/5388K18/
5388K26 | Worm-Drive Clamps for Firm Hose and Tube | Steel Screw, 5/16" Wide Band, 1-3/16" to 1-3/4" Clamp ID | McMaster-Carr | 5388K260_WORM-DRIVE CLAMPS FOR FIRM HOSE AND TUBE.SLDPRT | https://www.mcmaster.com/5388K26/
91239A418 | Button Head Hex Drive Screw | Black-Oxide Alloy Steel, M8 x 1.25 mm Thread, 16 mm Long | McMaster-Carr | 91239A418_CLASS 10.9 STL BUTTON-HEAD SOCKET CAP SCREW.SLDPRT | https://www.mcmaster.com/91239A418/
96025A249 | Clipped Washer | Steel, for M8 Screw Size, 8.4 mm ID, 15 mm OD | McMaster-Carr | 96025A249_CLIPPED WASHER.SLDPRT | https://www.mcmaster.com/96025a249
93800A650 | Nylon Hex Nut | M8 x 1.25 mm Thread | McMaster-Carr |  | https://www.mcmaster.com/93800A650/
