Agile-and-Adaptive-Robotics/Bipedal_Robot/Solid_Models/00_BipedalRobot_Redesign/07_HardWare/BOM.xlsx

Part | Usage | McMaster Part # | Link
Button Head Screw | Connecting various parts | 91239A330 | Link (https://www.mcmaster.com/91239A330/)
Locknut | Nut for screw, nylon resists loosening | 94645A205 | Link (https://www.mcmaster.com/94645A205/)
Thin Hex Nut | Used for the tightening the femoral neck bolt to the femur | 90695A038 | Link (https://www.mcmaster.com/90695A038/)
Hex Head Screw | Femoral Neck that connects the femur to the ball | 95327A531 | Link (https://www.mcmaster.com/95327A531/)
Dowel Pin | for Connecting the 2 part Ilium together | 91595A476 | Link (https://www.mcmaster.com/91595A476/)
