Agile-and-Adaptive-Robotics/Bipedal_Robot/Documentation/Reports and Papers/Bolen_LM2023/Figures/Figure components/Fmax_fit/Fmax_fit.pptx

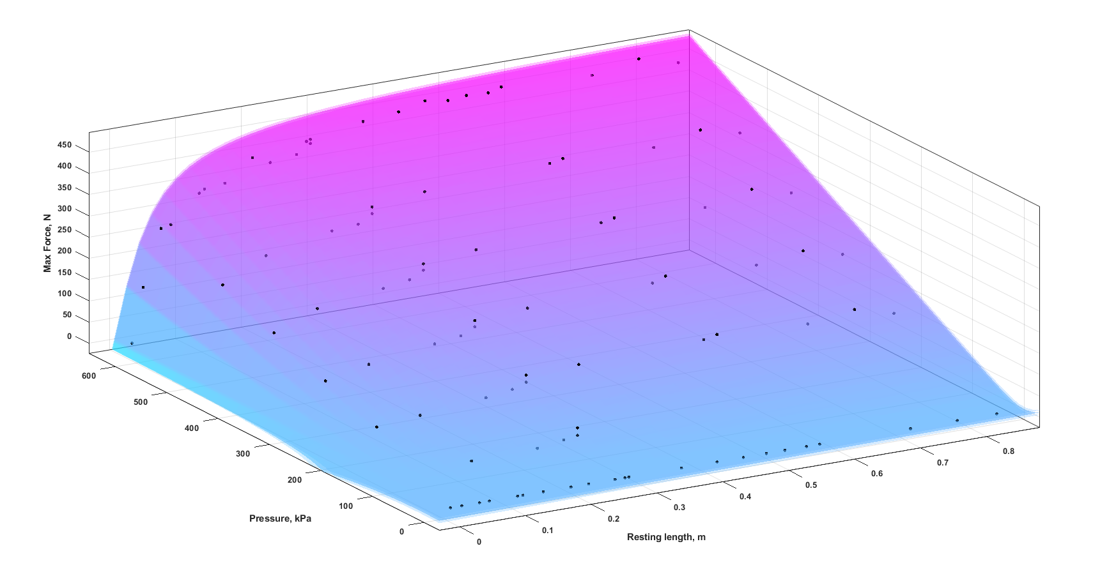
[picture p92: figure]

A

B

C
