Agile-and-Adaptive-Robotics/Bipedal_Robot/Documentation/Reports and Papers/Bolen_LM2023/Figures/Figure components/GeneralizedFoceFit/GeneralizedForceFit.pptx

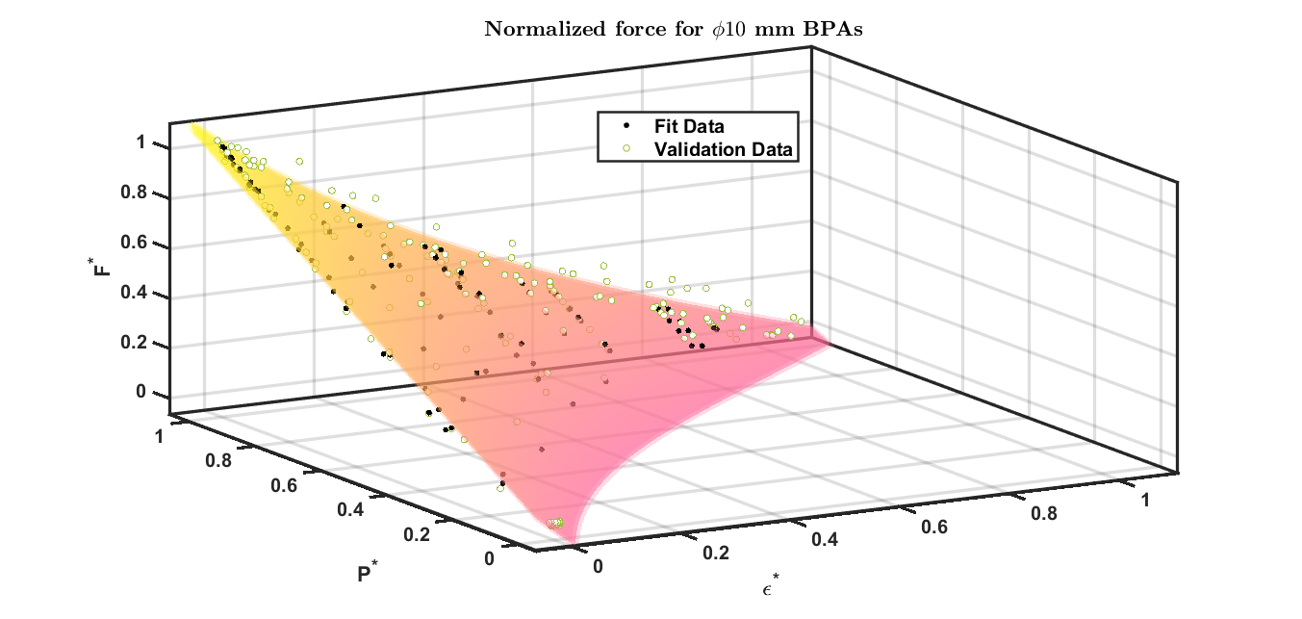
[picture p93: figure]

A)

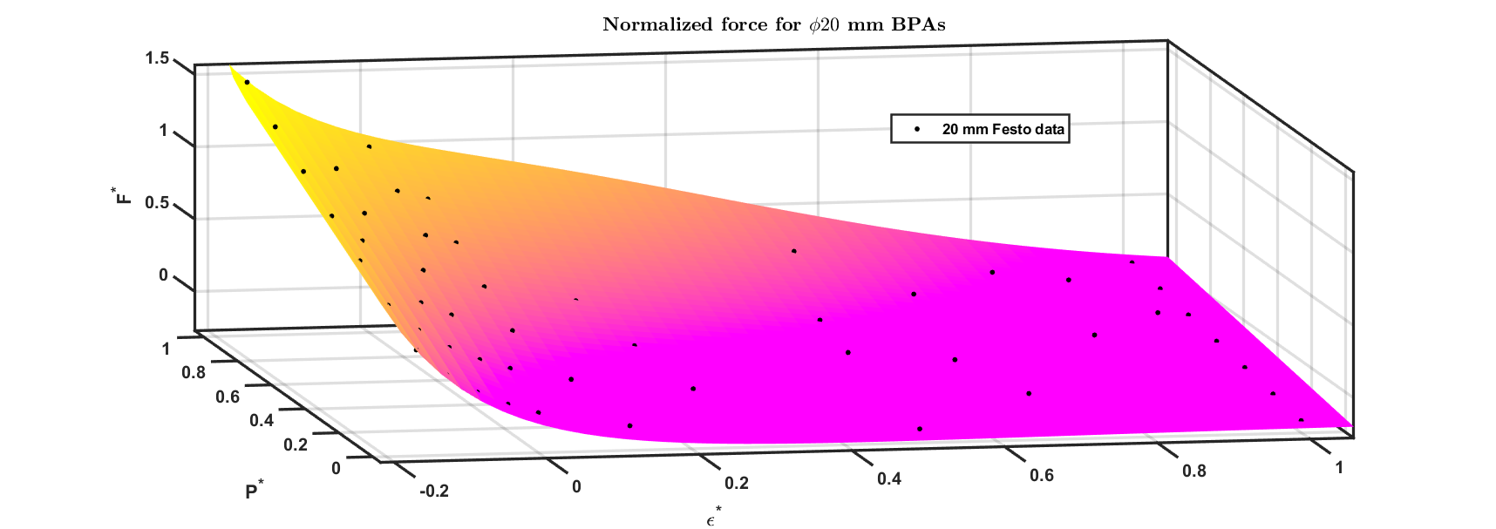
[picture p94: figure]

B)

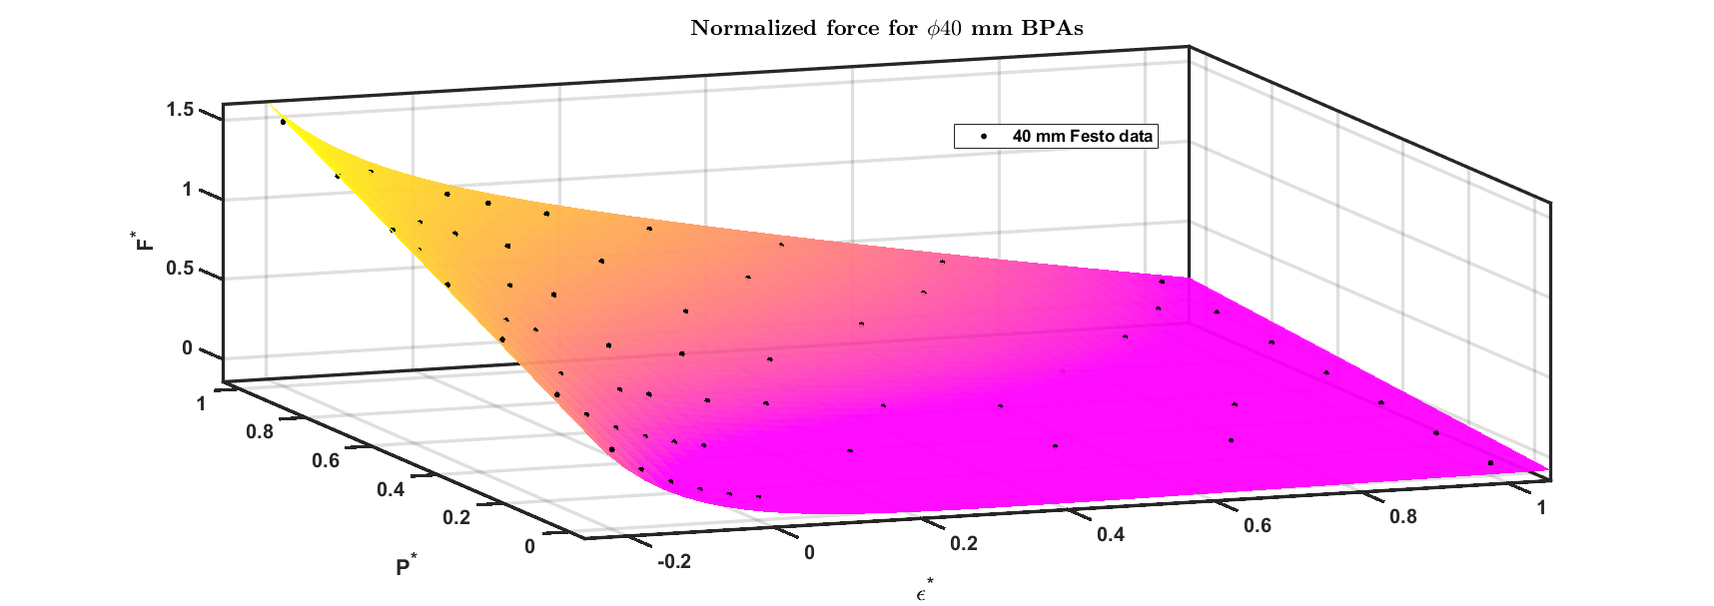
[picture p95: figure]

C)
