Agile-and-Adaptive-Robotics/Bipedal_Robot/Documentation/Reports and Papers/Knee_Torque_Test/Figures/Figure components/bktFrame/bktFrame.pptx

(A)

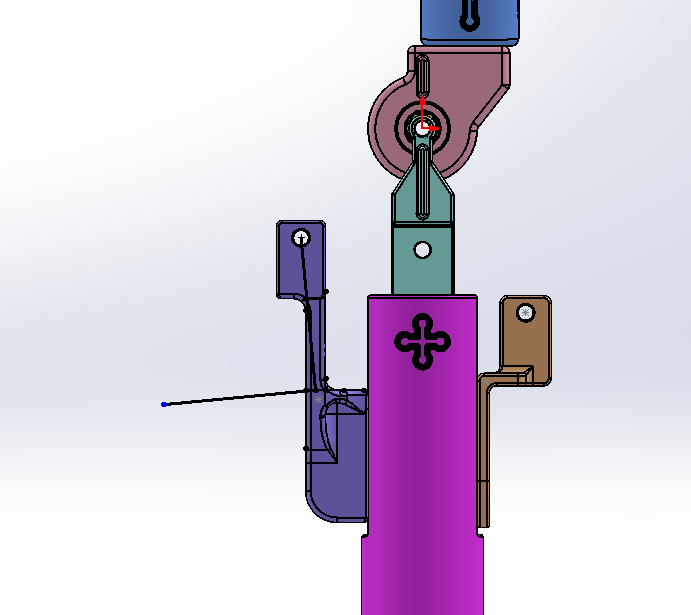
[picture p96: figure]

(B)

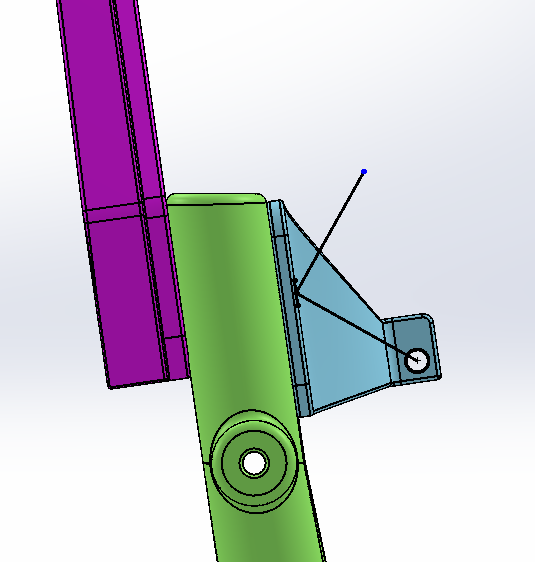
[picture p97: figure]

Xbr

Ybr

Ybr

Xbr

(C)

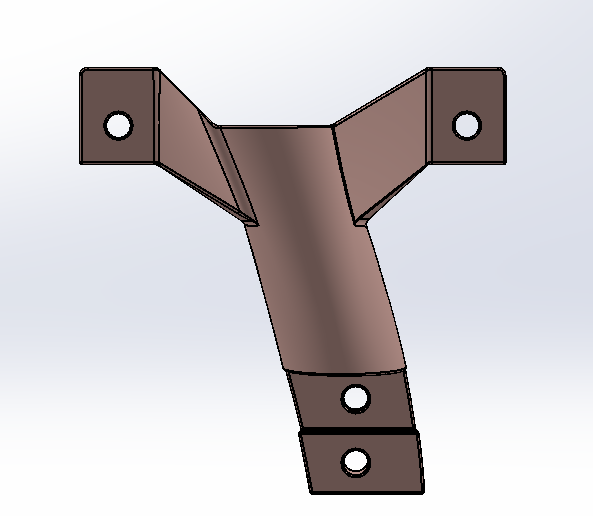
[picture p98: figure]

Ybr

(D)

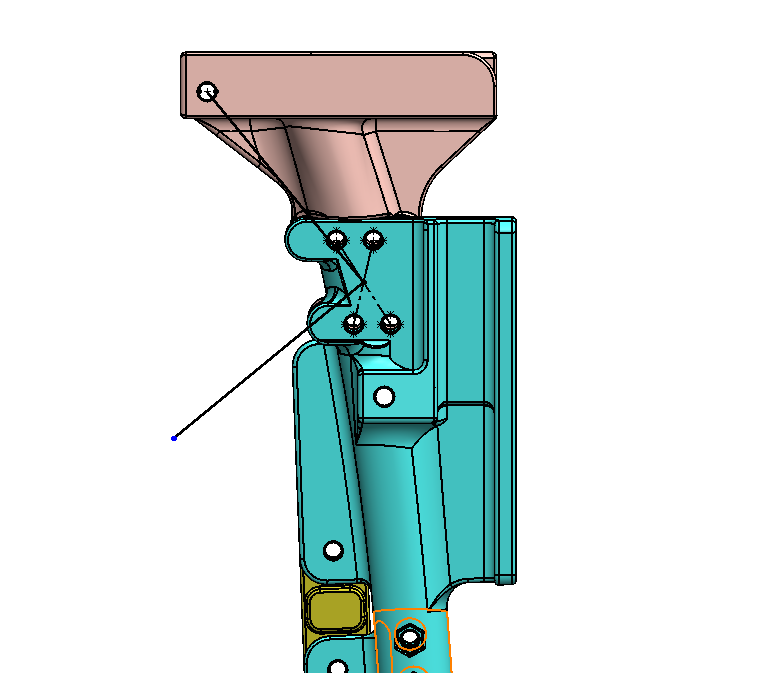
[picture p99: figure]

Xbr

Xbr

Xbr

Ybr

Ybr
