Agile-and-Adaptive-Robotics/Bipedal_Robot/Documentation/Reports and Papers/Knee_Torque_Test/Figures/Figure components/Flx_brktBend/Flx_brktBend.pptx

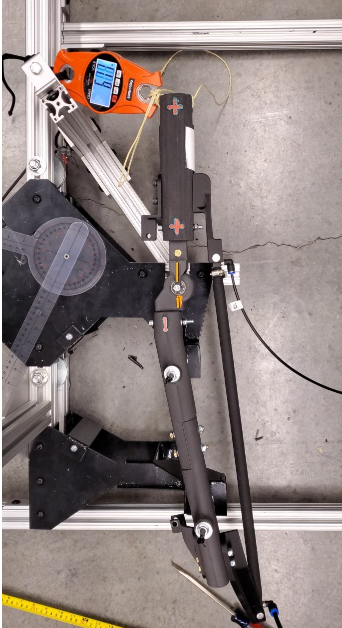
[picture p100: figure]
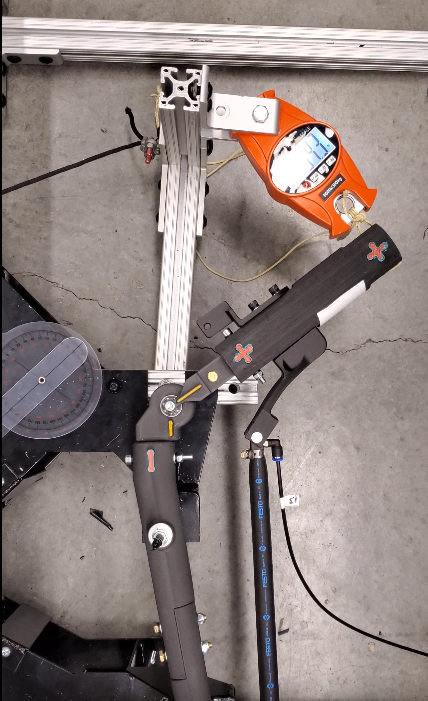
[picture p101: figure]
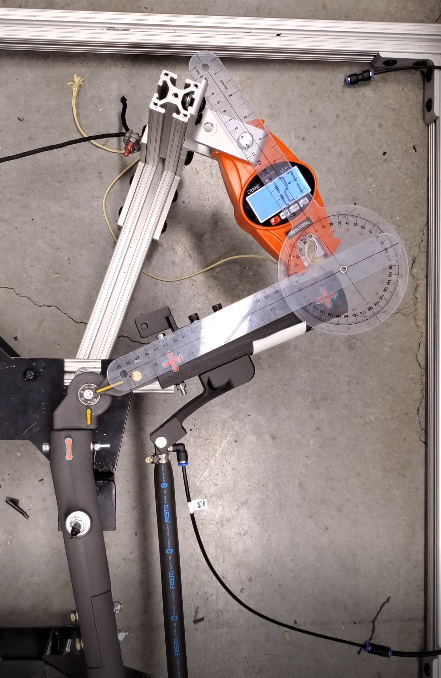
[picture p102: figure]

A

B

C
