Agile-and-Adaptive-Robotics/Bipedal_Robot/Documentation/Reports and Papers/Bolen_LM2023/Figures/Figure components/GeneralizedFoceFit/GeneralizedForceFit10.pdf

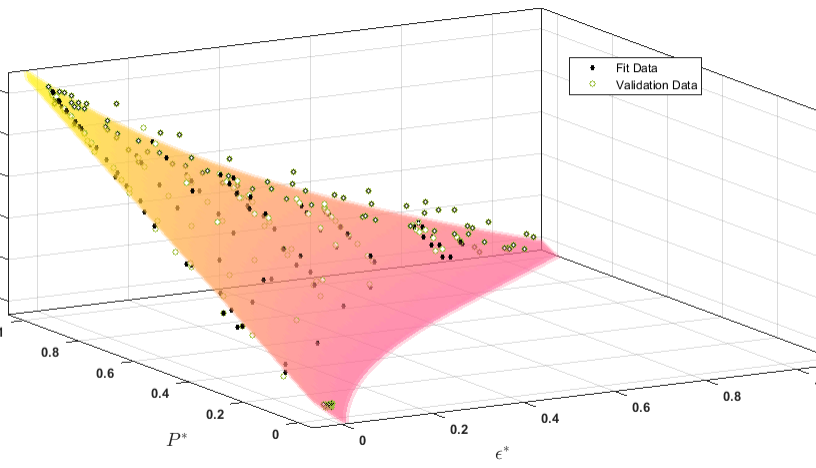
[picture p103: figure]
