Agile-and-Adaptive-Robotics/Bipedal_Robot/Documentation/Reports and Papers/Bolen_LM2023/Figures/Figure components/GeneralizedFoceFit/GenForce.pdf

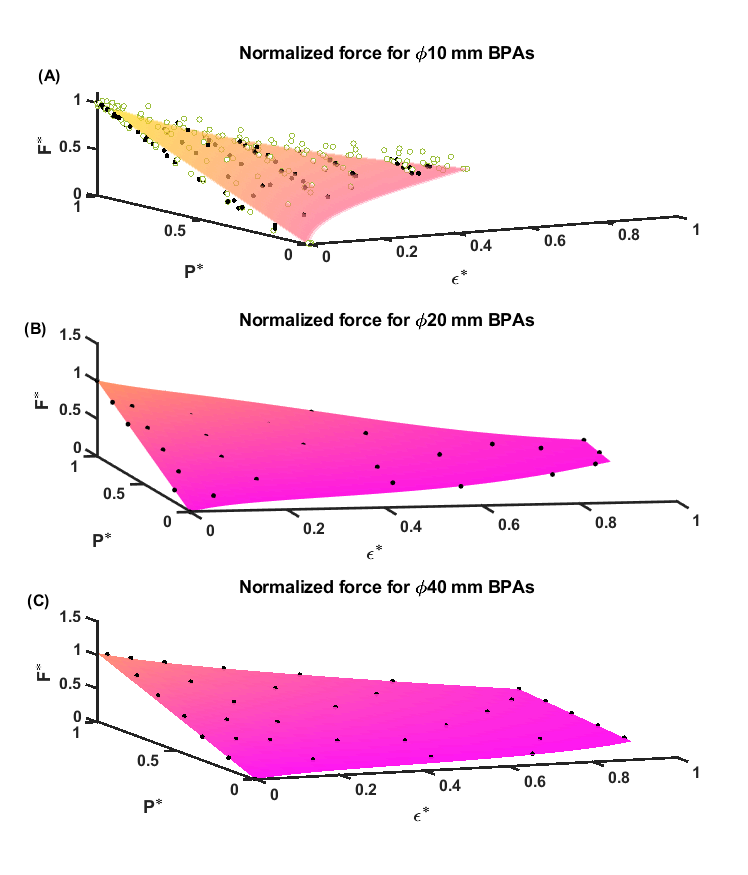
[picture p104: page 1]
