Agile-and-Adaptive-Robotics/Bipedal_Robot/Documentation/Reports and Papers/Knee_Torque_Test/Figures/Figure components/KneeICR/KneeICR.pdf

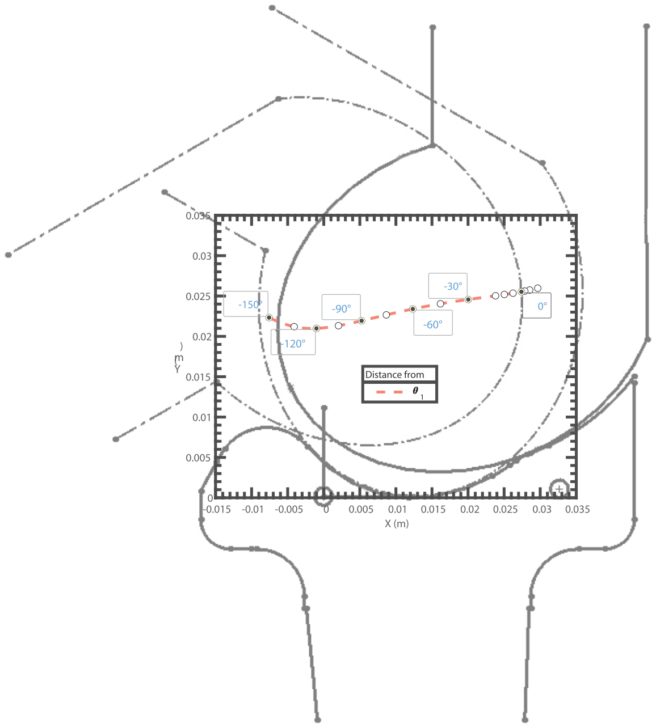
[picture p105: page 1]

-0.015 -0.01 -0.005 0 0.005 0.01 0.015 0.02 0.025 0.03 0.035 X(m)

0

0.005

0.01

0.015

0.02

0.025

0.03

0.035

Y

(m

)

-150° | -90°

-120°

-60°

-30°
0°

1

Distancefrom
