Agile-and-Adaptive-Robotics/Bipedal_Robot/Documentation/Reports and Papers/Knee_Torque_Test/Figures/Figure components/_deprecated/extensor_misalign/extensor_misalign.pptx

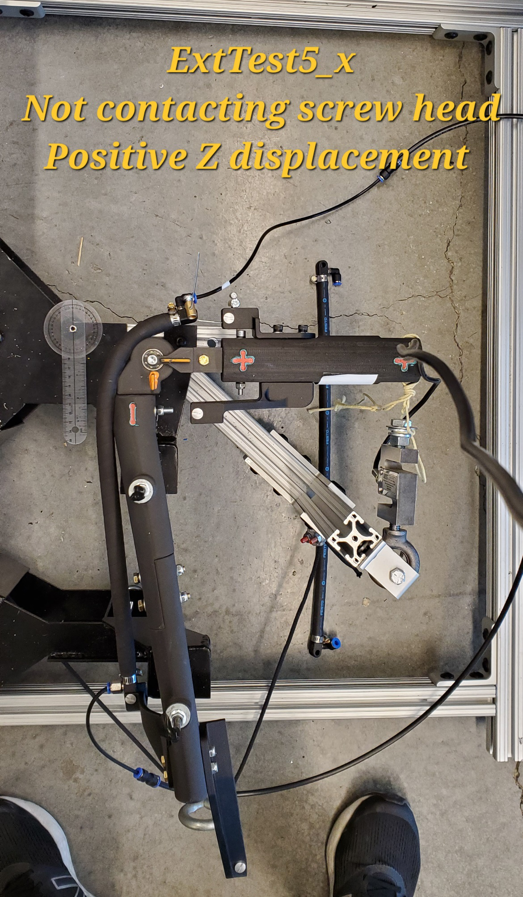
[picture p106: figure]

A

B

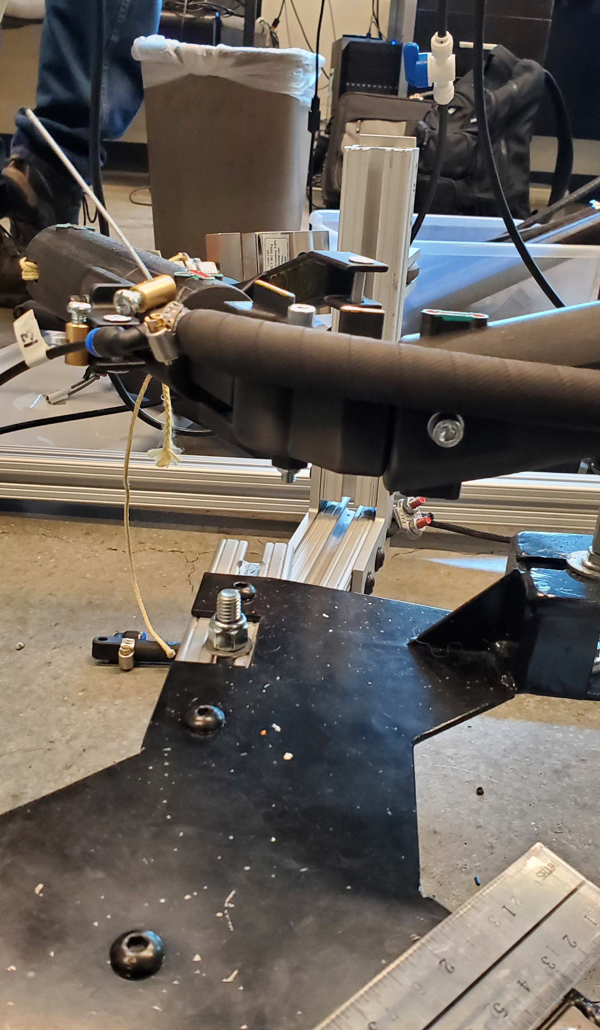
[picture p107: figure]

+20 mm z axis
