Agile-and-Adaptive-Robotics/Bipedal_Robot/Documentation/Reports and Papers/Knee_Torque_Test/Figures/Figure components/_deprecated/KneeJoint_loc/KneeJoint_loc.pptx

A

B

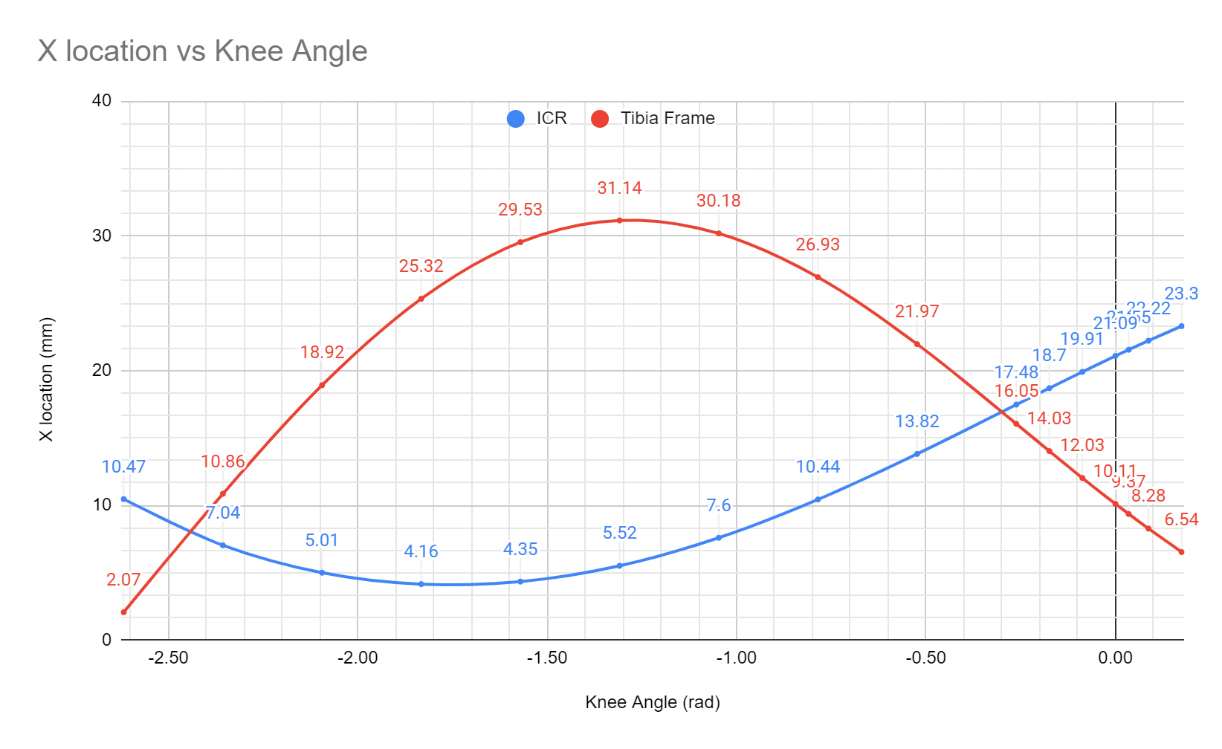
[picture p108: figure]
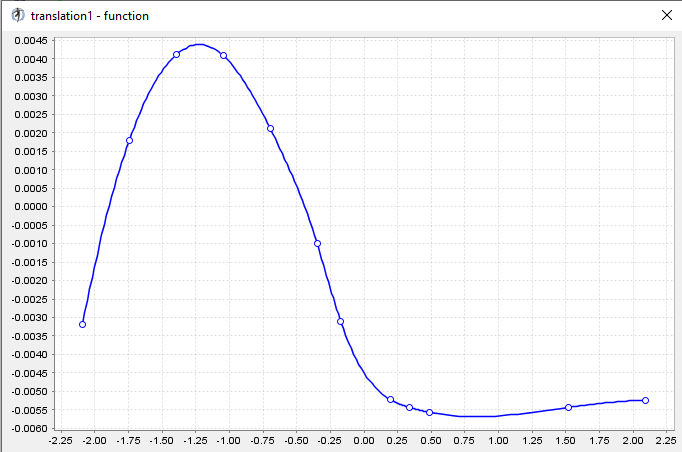
[picture p109: figure]

C

D

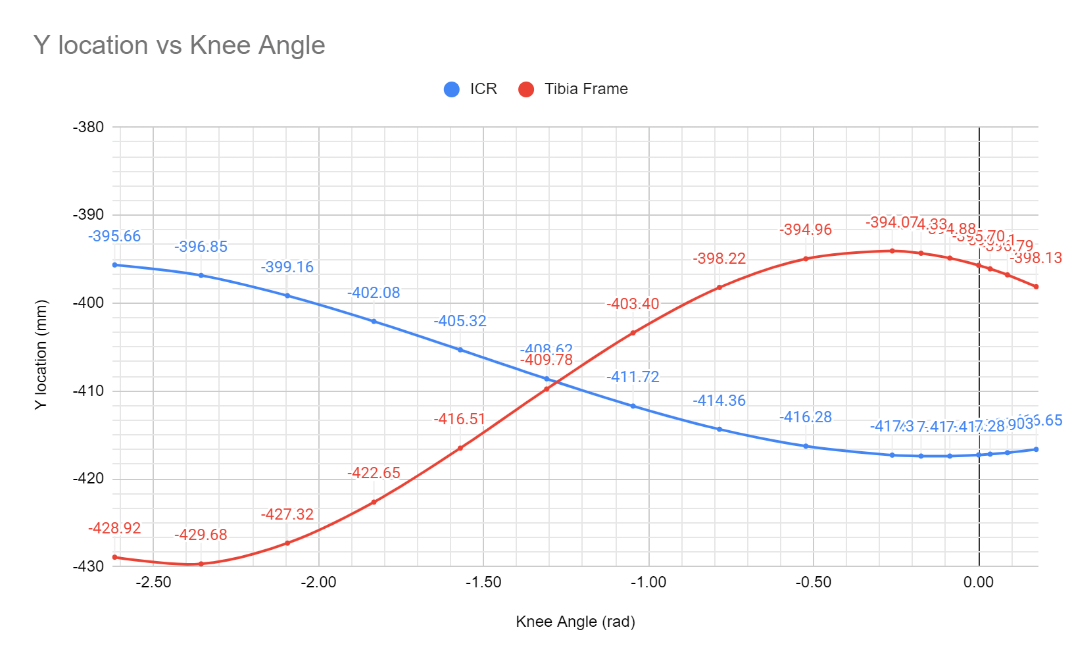
[picture p110: figure]
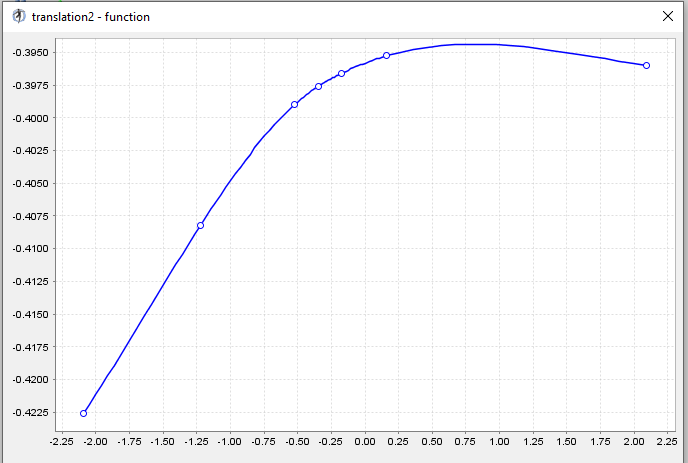
[picture p111: figure]
