Agile-and-Adaptive-Robotics/Bipedal_Robot/Documentation/Reports and Papers/Knee_Torque_Test/Figures/Figure components/_deprecated/RobotSim_frames/RobotSim_frames.pptx

A

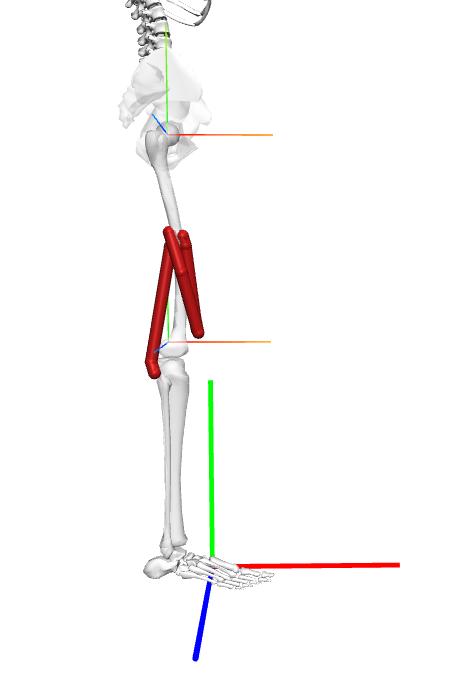
[picture p112: figure]

B

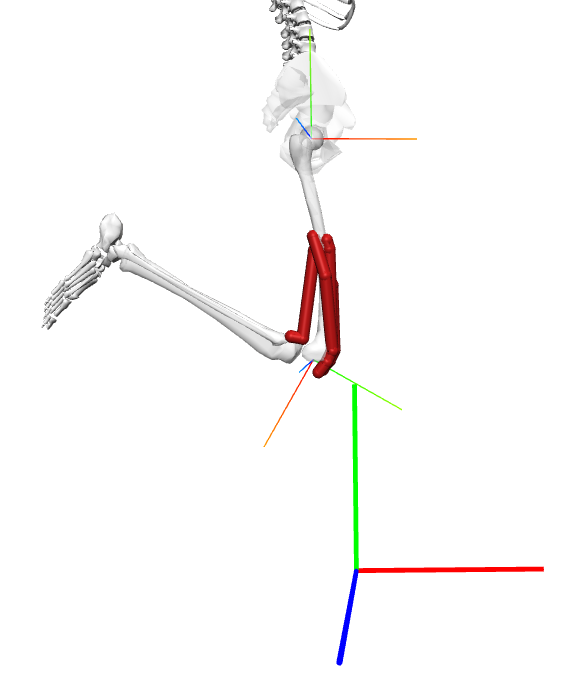
[picture p113: figure]
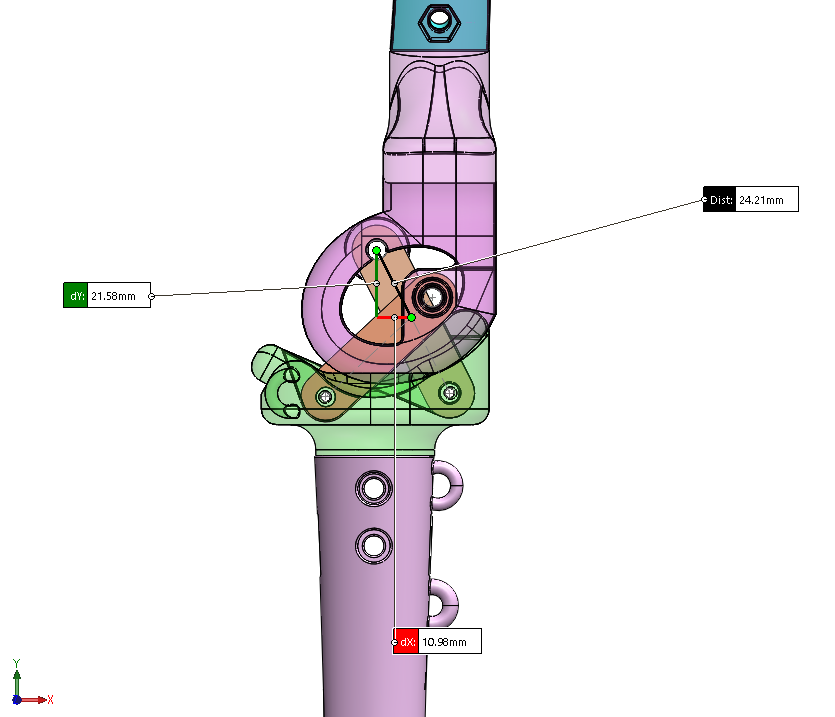
[picture p114: figure]

C

D

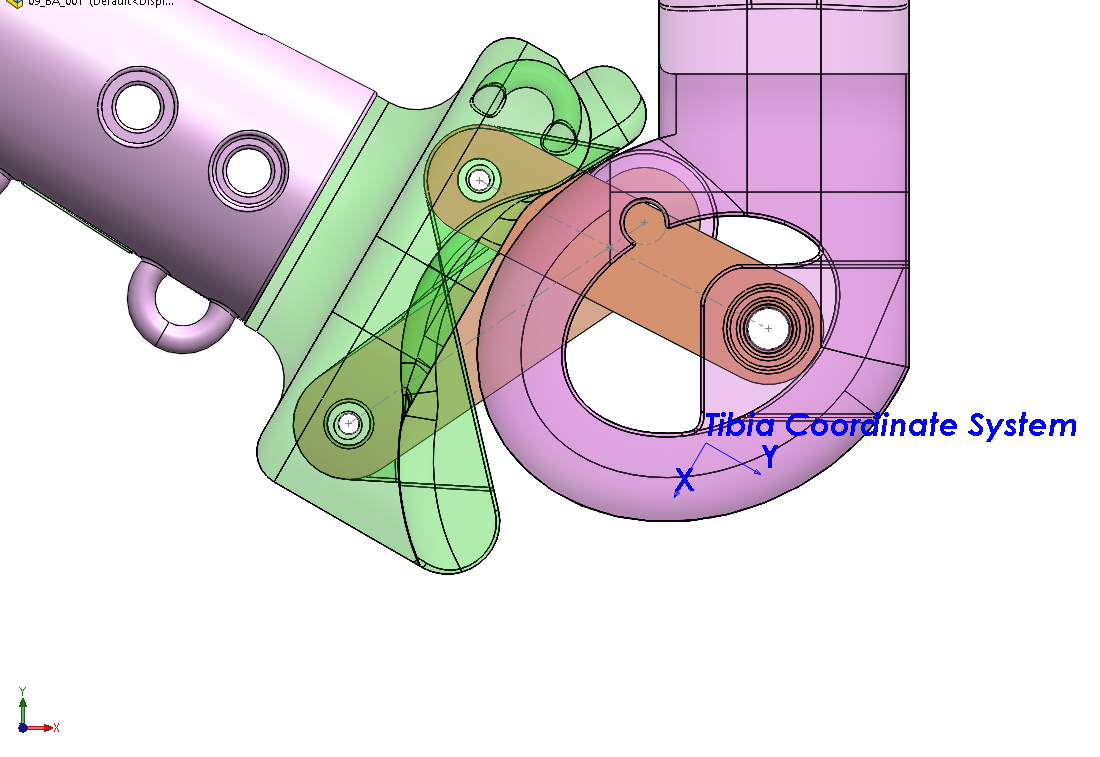
[picture p115: figure]
