Agile-and-Adaptive-Robotics/Bipedal_Robot/Documentation/Reports and Papers/Knee_Torque_Test/Figures/Figure components/_deprecated/KneeJoint_loc.pdf

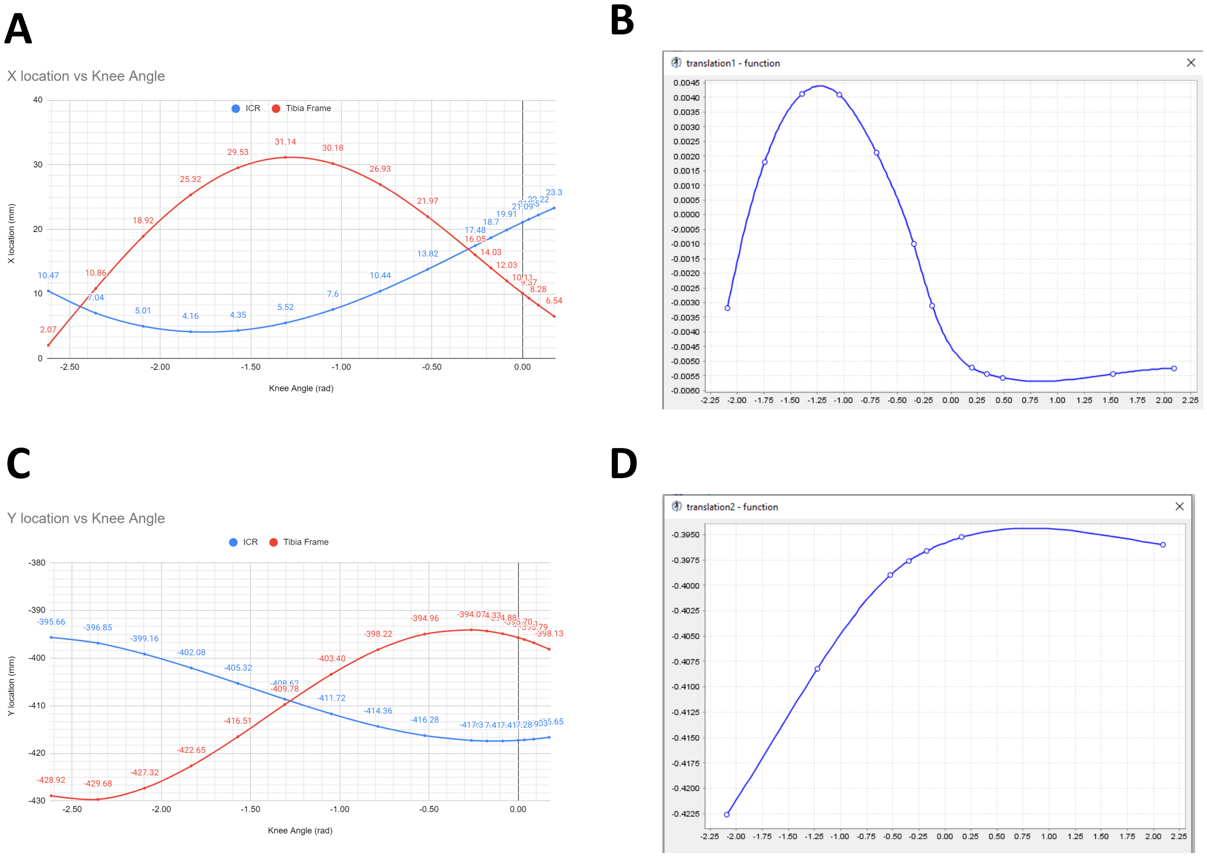
[picture p116: page 1]

A

B

C

D
