Agile-and-Adaptive-Robotics/Bipedal_Robot/Documentation/Reports and Papers/Knee_Torque_Test/Figures/Figure components/_deprecated/RobotSim_frames.pdf

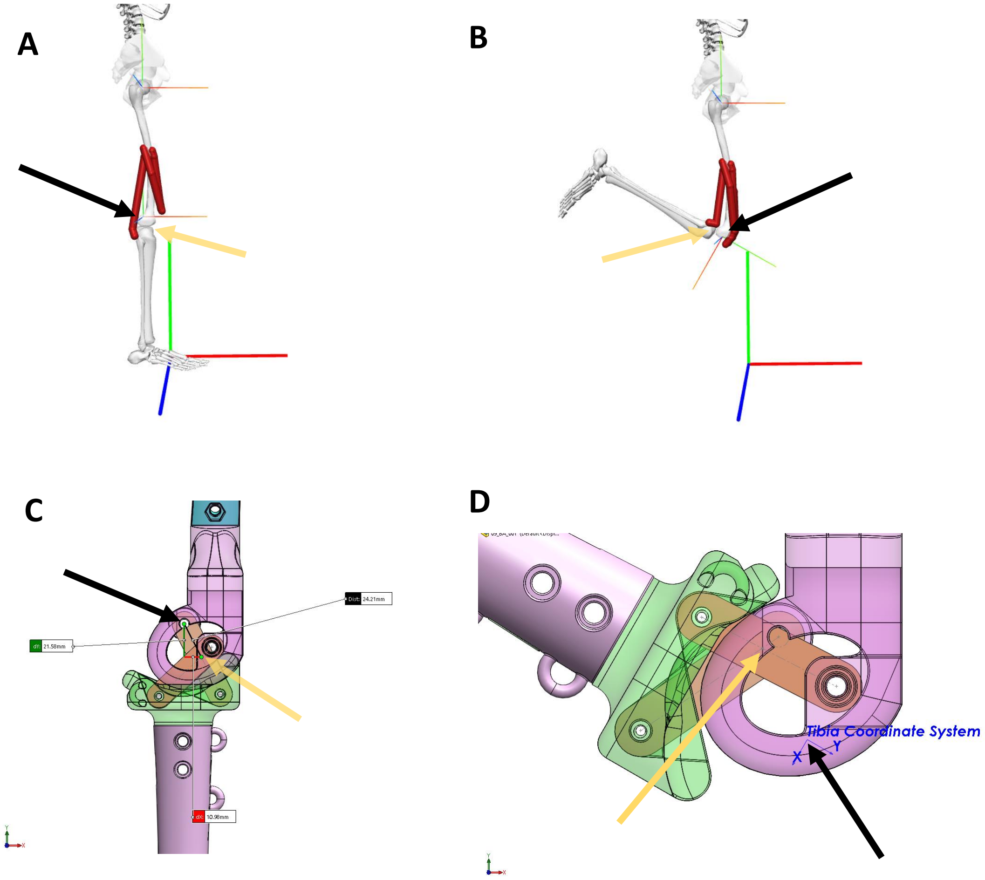
[picture p117: page 1]

A

B

C

D
