Agile-and-Adaptive-Robotics/Bipedal_Robot/Documentation/Reports and Papers/Knee_Torque_Test/Figures/Figure components/Ext40m_56_cm/Ext40mm_56cm.png

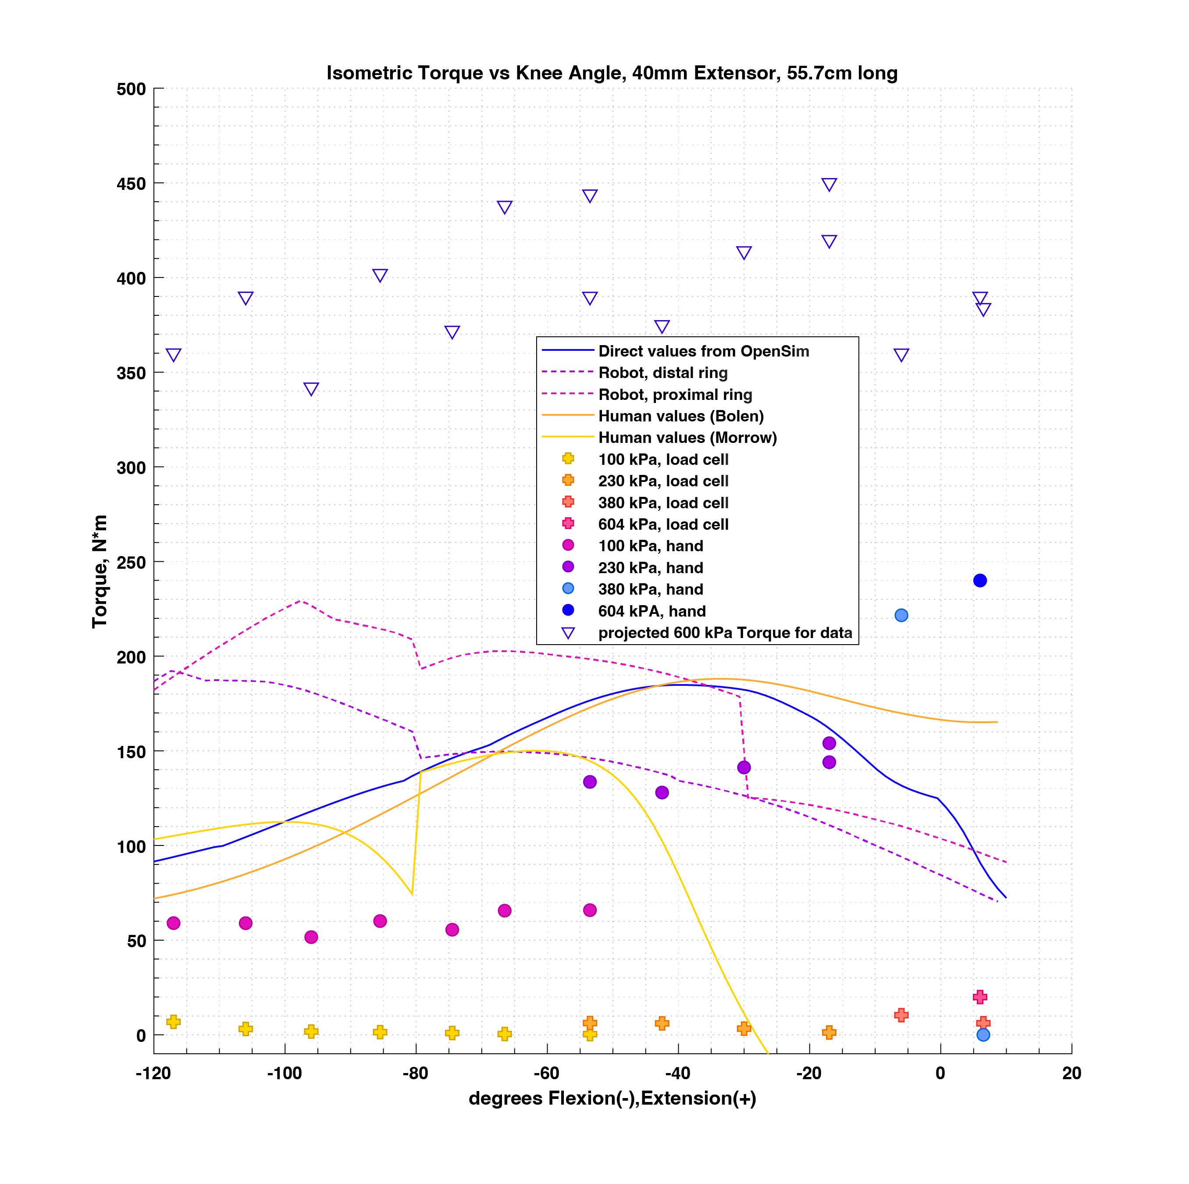
Documentation/Reports and Papers/Knee_Torque_Test/Figures/Figure components/Ext40m_56_cm/Ext40mm_56cm.png
