Agile-and-Adaptive-Robotics/Bipedal_Robot/Documentation/Reports and Papers/Knee_Torque_Test/Figures/Figure components/ExtPin_group/ExtPin_group.png

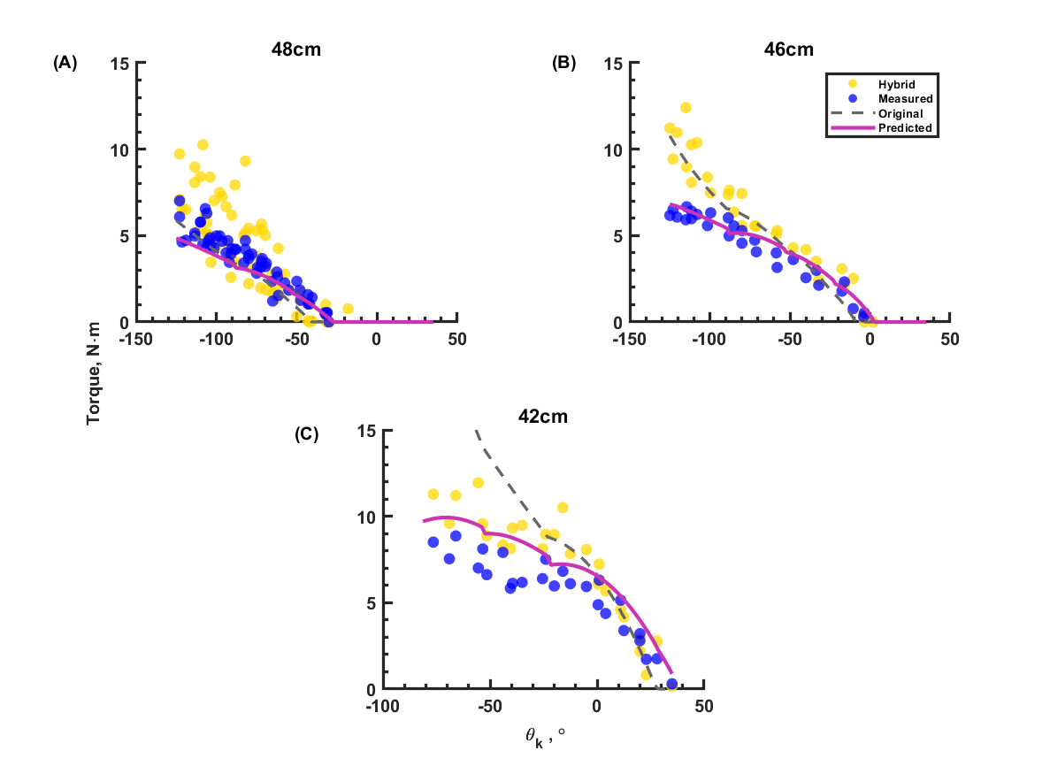
Documentation/Reports and Papers/Knee_Torque_Test/Figures/Figure components/ExtPin_group/ExtPin_group.png
