Agile-and-Adaptive-Robotics/Bipedal_Robot/Documentation/Reports and Papers/Knee_Torque_Test/Figures/Figure components/Flx_brktBend/KneeFlxPin_10mm_bendBrkt.PNG

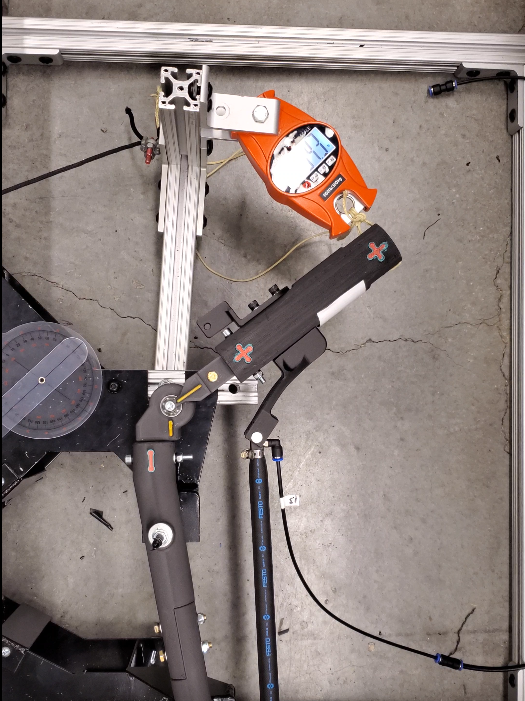
Documentation/Reports and Papers/Knee_Torque_Test/Figures/Figure components/Flx_brktBend/KneeFlxPin_10mm_bendBrkt.PNG
