Agile-and-Adaptive-Robotics/Bipedal_Robot/Documentation/Reports and Papers/Knee_Torque_Test/Figures/Figure components/KneeICR/Capture.PNG

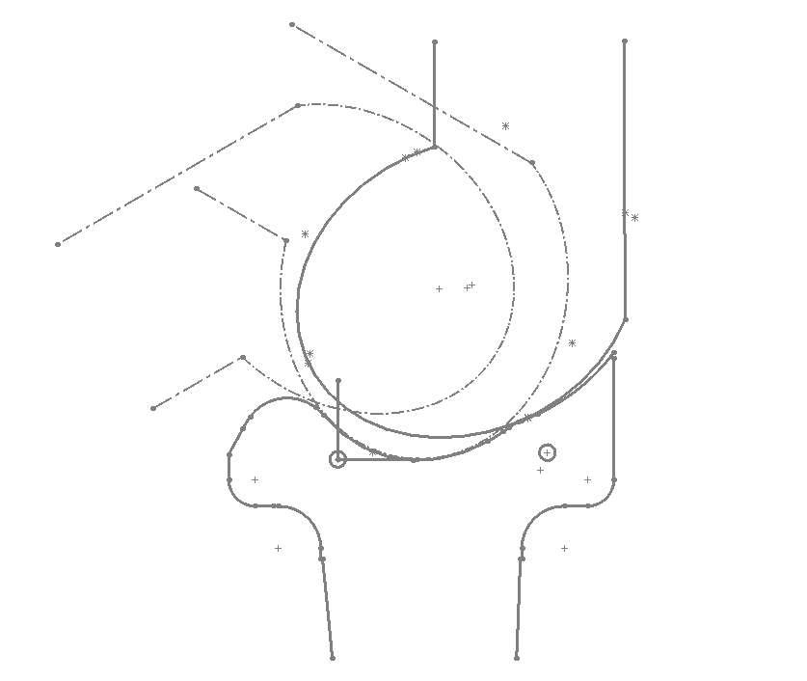
Documentation/Reports and Papers/Knee_Torque_Test/Figures/Figure components/KneeICR/Capture.PNG
