Agile-and-Adaptive-Robotics/Bipedal_Robot/Solid_Models/Prospective_Parts/Ty Ankle Foot/Agility Robotics/IMG_9767.jpeg

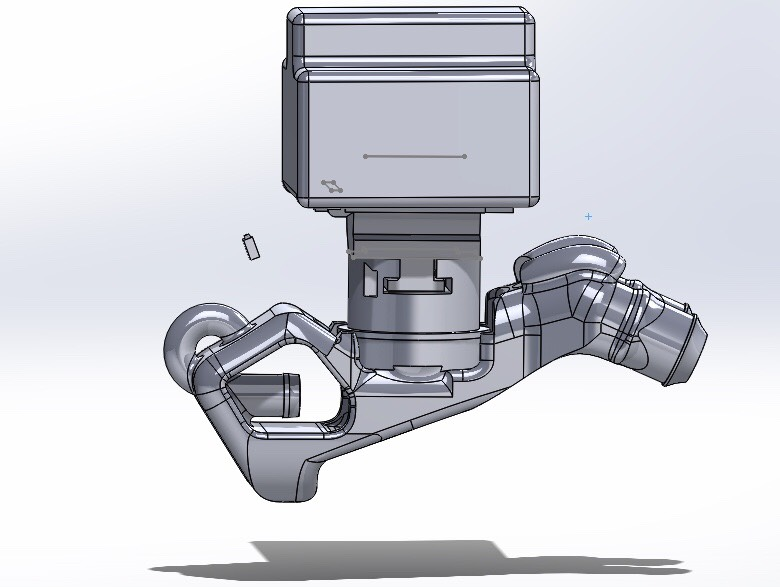
Solid_Models/Prospective_Parts/Ty Ankle Foot/Agility Robotics/IMG_9767.jpeg
