Agile-and-Adaptive-Robotics/Bipedal_Robot/Solid_Models/Prospective_Parts/Ty Ankle Foot/Agility Robotics/Screenshot (26).png

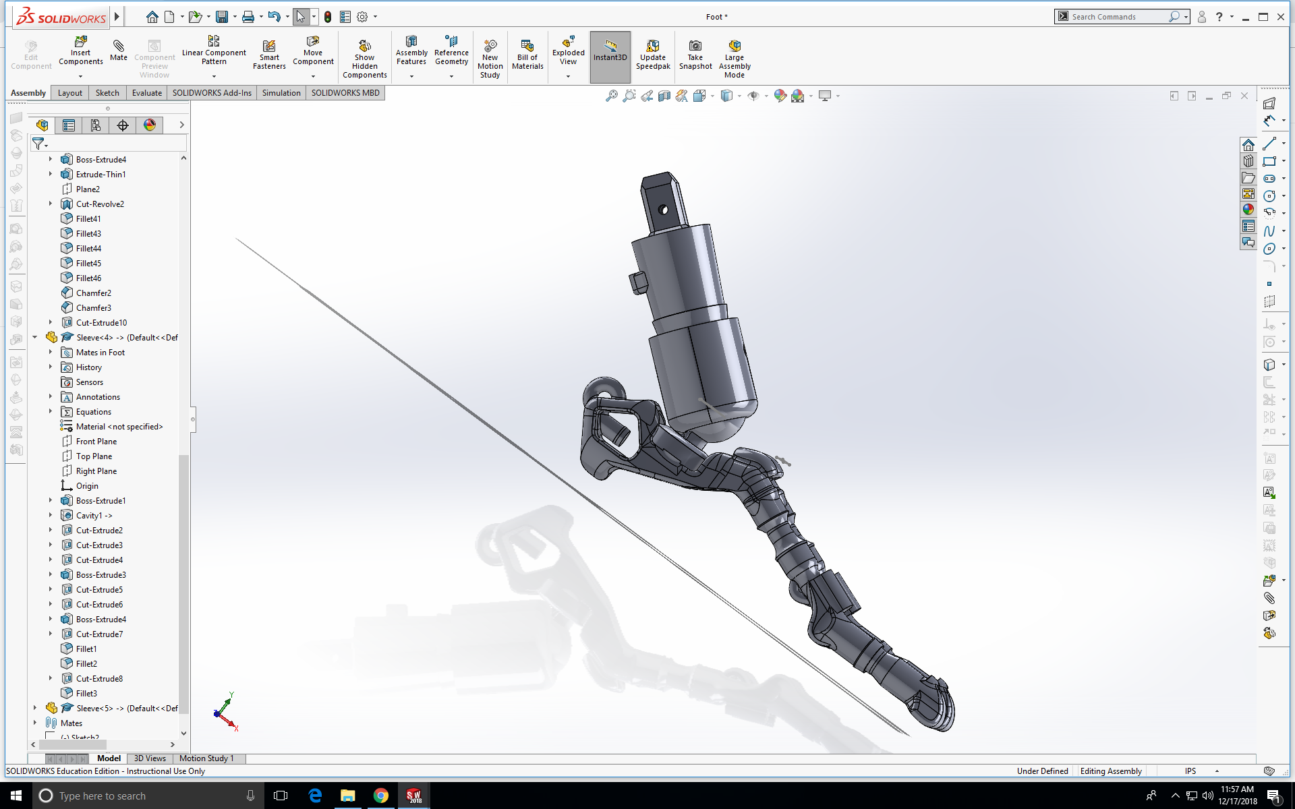
Solid_Models/Prospective_Parts/Ty Ankle Foot/Agility Robotics/Screenshot (26).png
