Agile-and-Adaptive-Robotics/Bipedal_Robot/Solid_Models/00_BipedalRobot_Redesign/09_BA_001.SLDASM

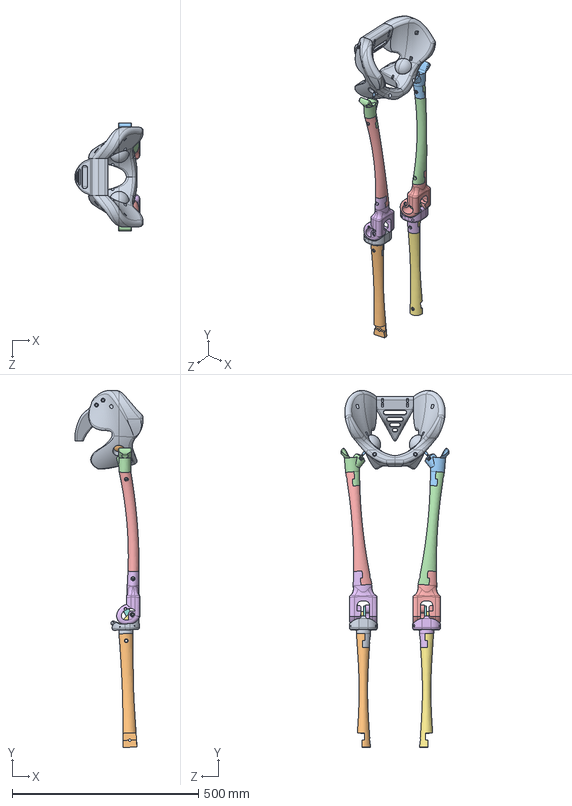
[picture p127: CAD file, 2021-10-08]
Solid_Models/00_BipedalRobot_Redesign/09_BA_001.SLDASM
182.9 x 957.3 x 290.8 mm
02_01_PE_001
6630T310_METRIC BLACK POLYPROPYLENE BALL KNOB x 2
92997A108_CORROSION-RESISTANT SETUP STUD x 2
03_02_FH_R_001
03_01_FB_R_001
04_01_KT_R_001
04_05_BL_001 x 2
04_06_FL_001 x 2
04_02_KB_R_001
05_01_TI_R_001
03_04_FH_L_001
03_03_FB_L_001
04_03_KT_L_001
04_04_KB_L_001
05_02_TI_001
