Agile-and-Adaptive-Robotics/Bipedal_Robot/Solid_Models/Prospective_Parts/01_00_00_Foot/FootAnkle.SLDASM

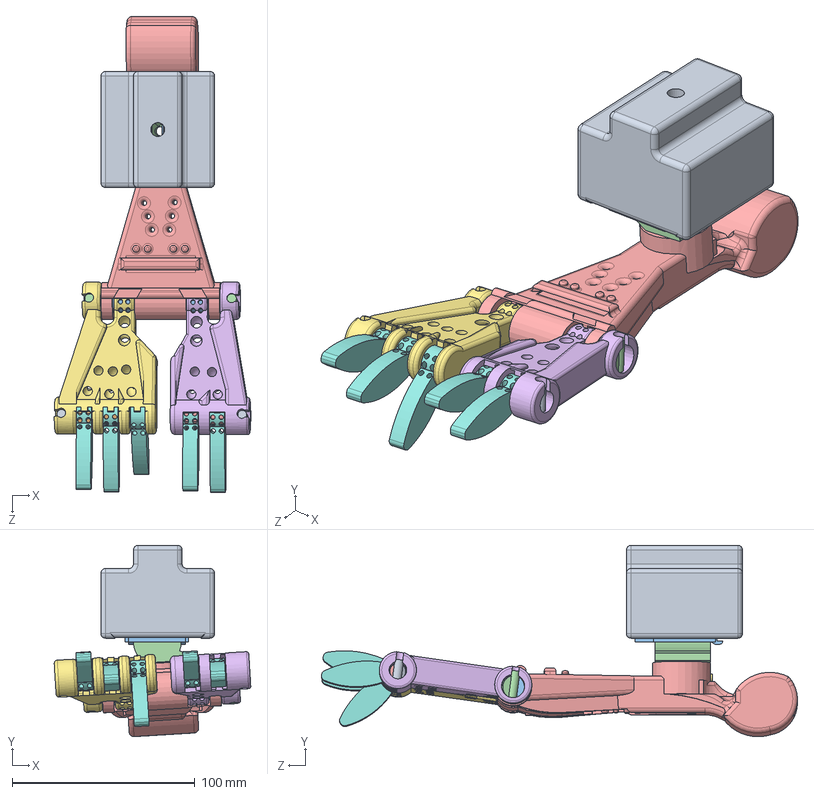
[picture p128: CAD file, 2020-07-20]
Solid_Models/Prospective_Parts/01_00_00_Foot/FootAnkle.SLDASM
107.5 x 104.6 x 260.2 mm
Ankle Exterior
Ankle Middle Joint Shell
Ankle Interior Joint
Ankle Bottom Joint
New foot - Copy - Copy
Left mid foot
New Front foot
Toe x 5
small axle lock x 2
small axle
foot axle x 2
large axle lock x 2
small axle - Copy
Ankle Lock 1
Foot T Lock
