Agile-and-Adaptive-Robotics/Bipedal_Robot/Solid_Models/Prospective_Parts/David Leg/FemoralAssembly_V3_022820.SLDASM

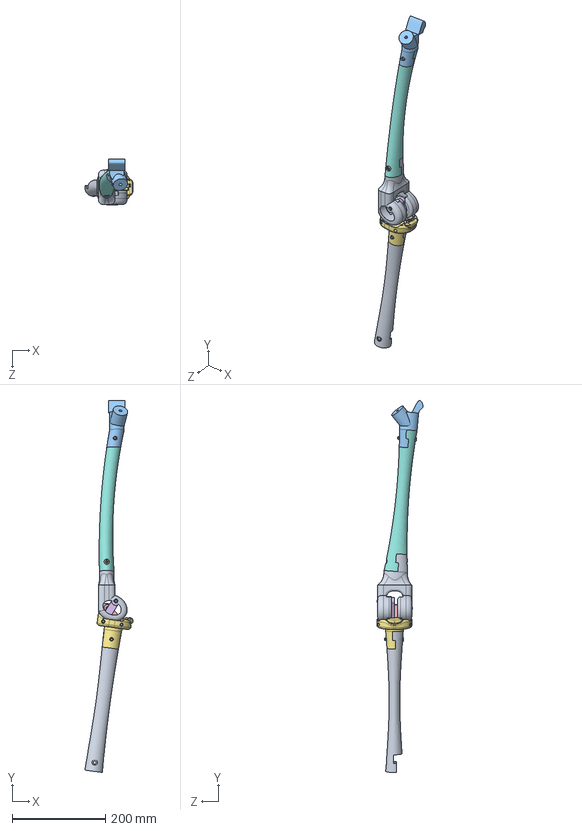
[picture p129: CAD file, 2020-09-08]
Solid_Models/Prospective_Parts/David Leg/FemoralAssembly_V3_022820.SLDASM
103.7 x 797.9 x 99.0 mm
FemorKneeEnd_103119_V13_DP
CushioningWasher_93650A145_McMaster x 2
BrassInsert_94459A380_McMaster x 7
ThreadedStud_97042A216_McMaster x 4
BackLinkV1
FrontLinkV1
TibialHead_103119_V1_DP
FemorBone_111219_V2_DP
Tibial_011020_V2_DP
BoneConnectionScrews_97763A348_McMaster x 3
FemoralHead_010620_V1_DP
