Agile-and-Adaptive-Robotics/Bipedal_Robot/Solid_Models/00_Bipedal_Robot/04_Femur_Left/04_Femur_Left.SLDASM

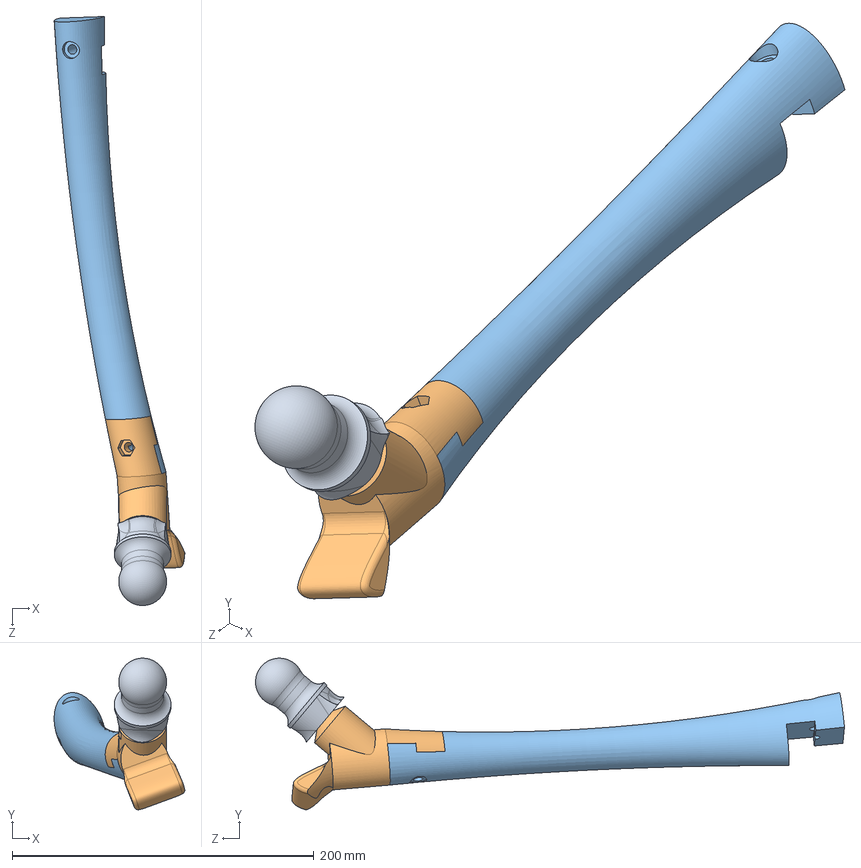
[picture p130: CAD file, 2021-10-08]
Solid_Models/00_Bipedal_Robot/04_Femur_Left/04_Femur_Left.SLDASM
86.7 x 100.6 x 390.6 mm
04_01_FK_L_001
04_02_FH_L_001
04_03_FE_L_001
