Agile-and-Adaptive-Robotics/Bipedal_Robot/Solid_Models/Biomimetics_2022-Knee_Test/Knee - reference/Assem3 - LEFT.SLDASM

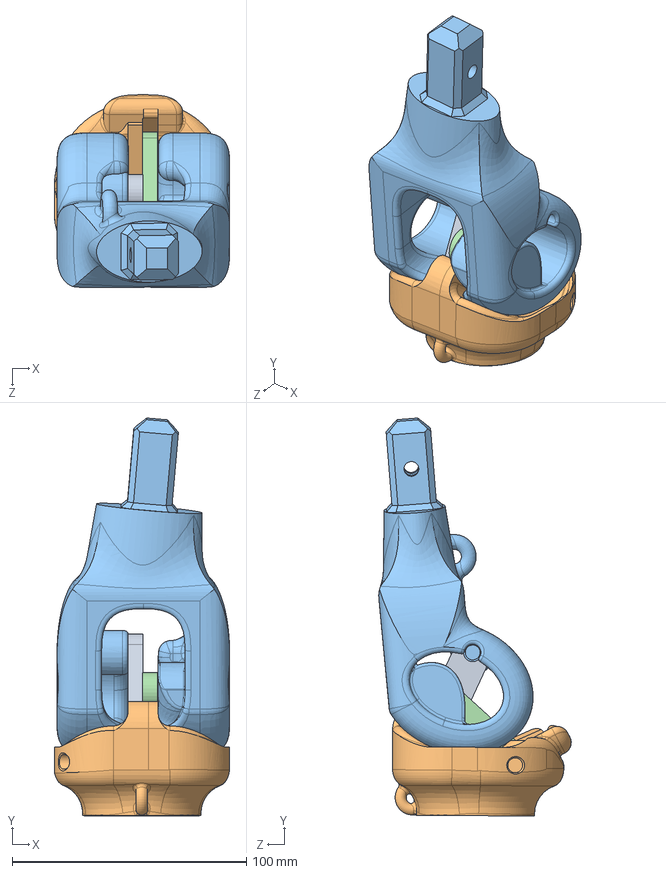
[picture p132: CAD file, 2020-10-16]
Solid_Models/Biomimetics_2022-Knee_Test/Knee - reference/Assem3 - LEFT.SLDASM
74.8 x 169.9 x 82.2 mm
New link 1
Tibial head with hardware - bone connection - Latest - LEFT
Femoral end with hardware - Latest - LEFT
Split link 2
