Agile-and-Adaptive-Robotics/Bipedal_Robot/Solid_Models/Prospective_Parts/02_00_00_InternFoot/01_01_01_ML.SLDASM

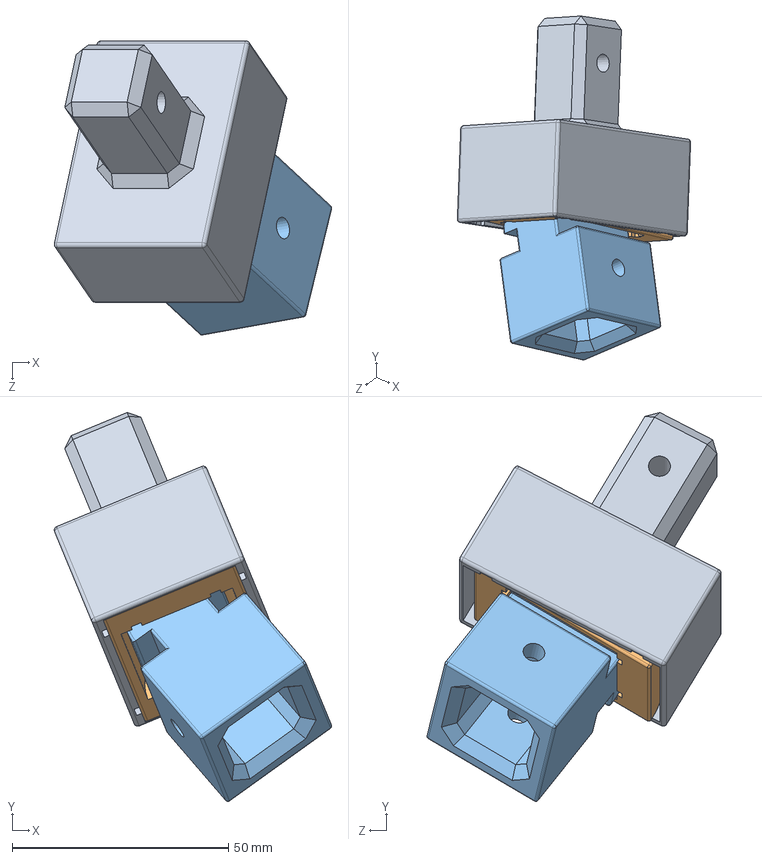
[picture p133: CAD file, 2020-09-08]
Solid_Models/Prospective_Parts/02_00_00_InternFoot/01_01_01_ML.SLDASM
64.1 x 89.9 x 67.9 mm
01_01_01_01_ML
01_01_01_02_ML
01_01_01_03_ML
