Agile-and-Adaptive-Robotics/Bipedal_Robot/Solid_Models/Prospective_Parts/Assem1.SLDASM

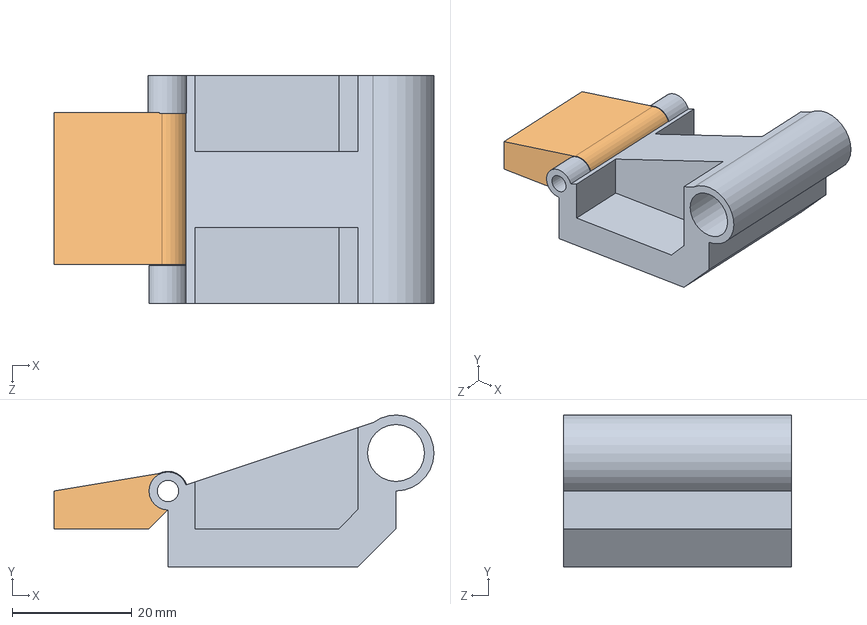
[picture p135: CAD file, 2020-09-08]
Solid_Models/Prospective_Parts/Assem1.SLDASM
63.5 x 25.4 x 38.1 mm
