Agile-and-Adaptive-Robotics/Bipedal_Robot/Solid_Models/Biomimetics_2022-Knee_Test/TAROS Knee/Assem2.51.SLDASM

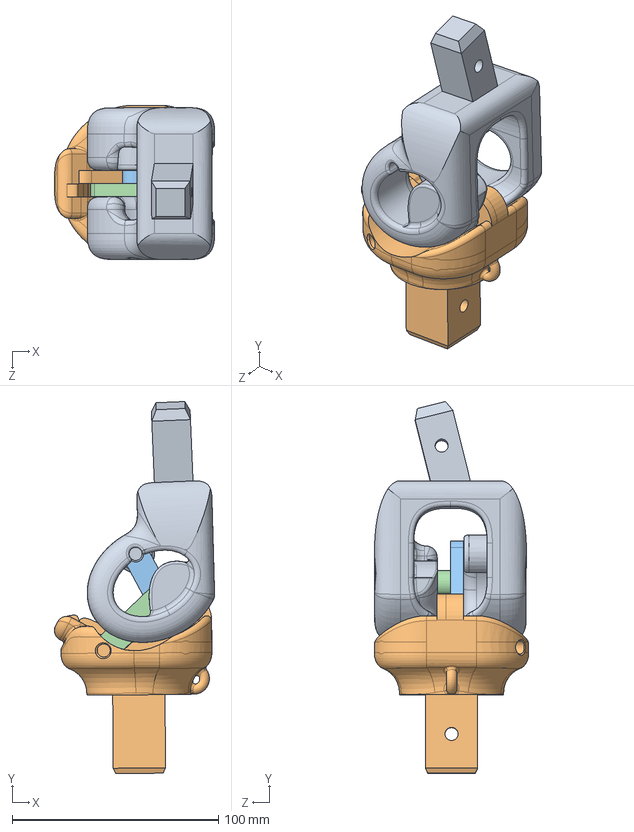
[picture p136: CAD file, 2020-10-16]
Solid_Models/Biomimetics_2022-Knee_Test/TAROS Knee/Assem2.51.SLDASM
77.7 x 180.5 x 74.9 mm
Femoral end with hardware - bone connection
Tibial head with hardware - bone connection
New link 1
Split link 2
