Agile-and-Adaptive-Robotics/Bipedal_Robot/Solid_Models/Prospective_Parts/Ty Ankle Foot/Agility Robotics/Room assembly.SLDASM

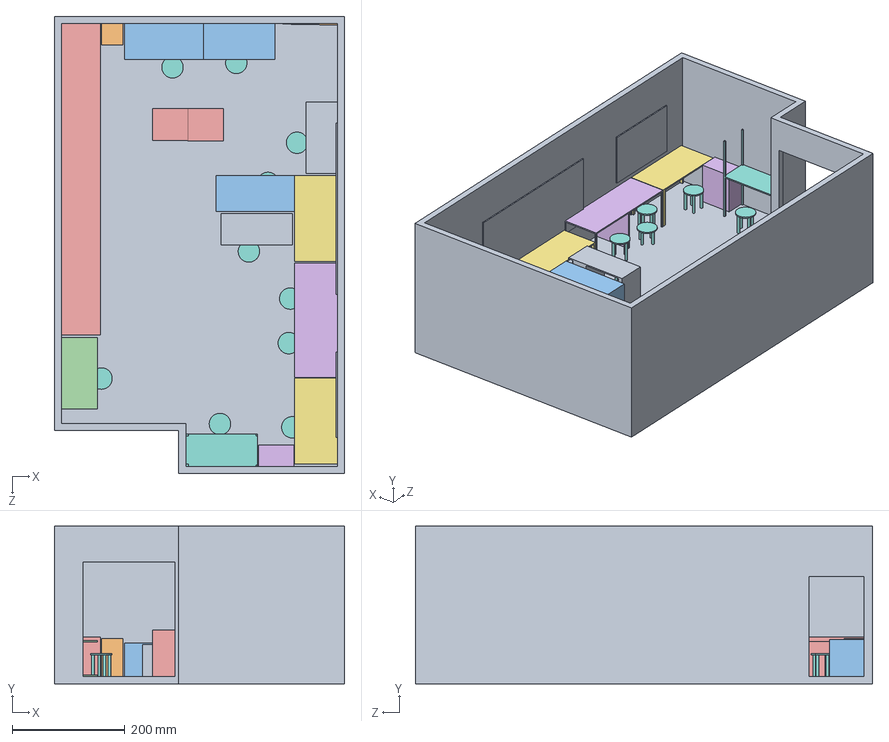
[picture p137: CAD file, 2020-06-29]
Solid_Models/Prospective_Parts/Ty Ankle Foot/Agility Robotics/Room assembly.SLDASM
514.4 x 279.4 x 810.8 mm
Room outline
Door
Connor_s desk x 2
Linux desk
Tool desk
Circuits floating desk
Table that has concrete on it
Dog treadmill
Cody_s desk x 2
Fridge
New computer_s desk
random file cabnet
Fusball thing x 2
Andreas cabnet
Andreas table
chair x 11
