Agile-and-Adaptive-Robotics/Bipedal_Robot/Solid_Models/Prospective_Parts/01_00_00_Foot/01_01_00_Ankle/01_01_01_00_Ankle.SLDASM

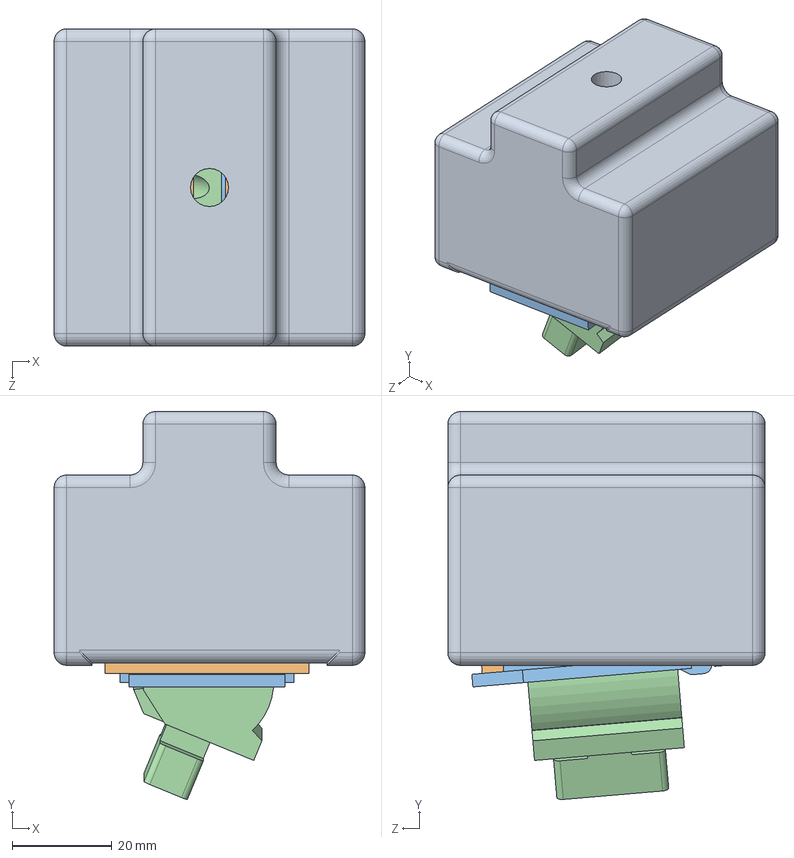
[picture p138: CAD file, 2020-07-20]
Solid_Models/Prospective_Parts/01_00_00_Foot/01_01_00_Ankle/01_01_01_00_Ankle.SLDASM
62.2 x 77.6 x 63.5 mm
Ankle Exterior
Ankle Middle Joint Shell
Ankle Interior Joint
Ankle Bottom Joint
Ankle Lock 1
Ankle Lock 2
