Agile-and-Adaptive-Robotics/Bipedal_Robot/Solid_Models/Prospective_Parts/Ty Ankle Foot/Foot and ankle (11-20-19)/Foot assembly.SLDASM

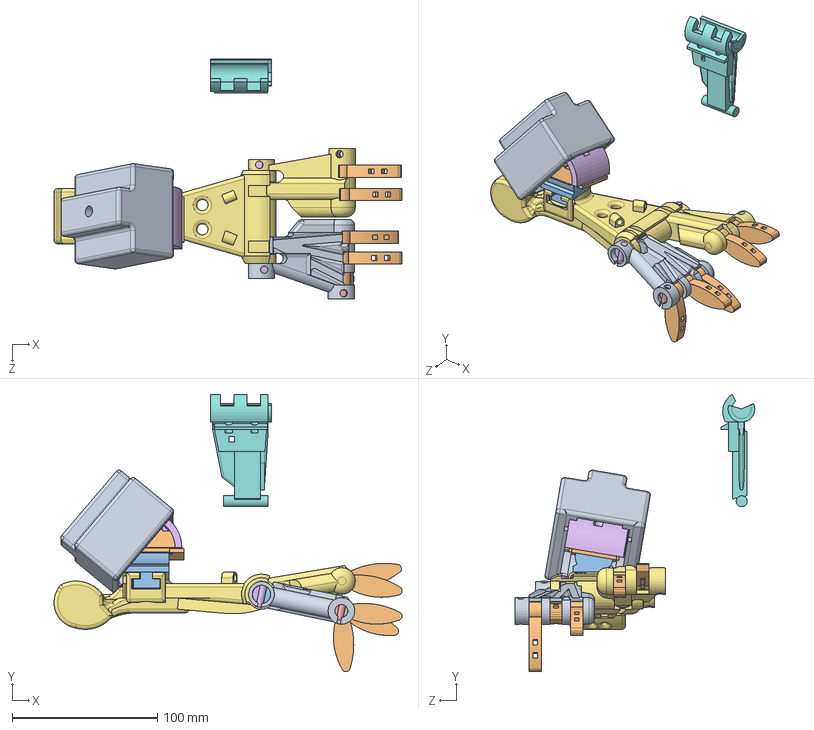
[picture p139: CAD file, 2020-06-29]
Solid_Models/Prospective_Parts/Ty Ankle Foot/Foot and ankle (11-20-19)/Foot assembly.SLDASM
239.4 x 190.7 x 164.8 mm
Ty talus
Ty Part 2
Part 3 Talus
Part 5 Ty
Part 4 Ty
Ankle shell
New foot
Midfoot
Toe x 5
foot axle
small axle
small axle lock
large axle lock x 2
Midfoot - Copy (2)
