Agile-and-Adaptive-Robotics/Bipedal_Robot/Solid_Models/00_Bipedal_Robot/knee encoder/02_Pelvis/02_11_Pelvis_Assembly.SLDASM

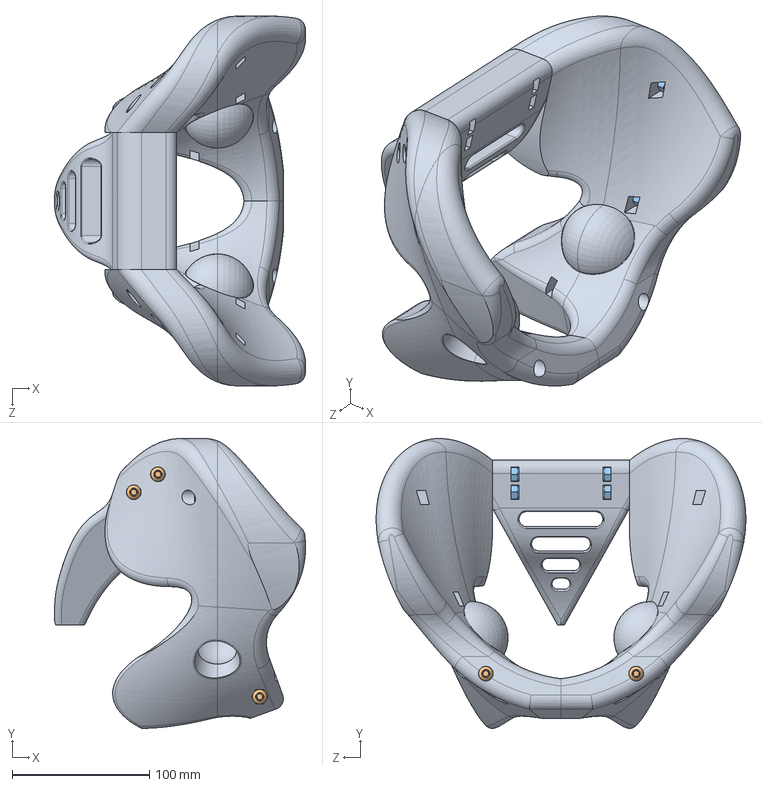
[picture p140: CAD file, 2022-02-05]
Solid_Models/00_Bipedal_Robot/knee encoder/02_Pelvis/02_11_Pelvis_Assembly.SLDASM
182.9 x 211.1 x 269.2 mm
02_01_Pelvis
91239A330_CLASS 10.9 STL BUTTON-HEAD SOCKET CAP SCREW x 11
94645A205_HIGH-STRENGTH STEEL NYLON-INSERT LOCKNUT x 11
