Agile-and-Adaptive-Robotics/Bipedal_Robot/Solid_Models/Biomimetics_2022-Knee_Test/Knee - reference/Assem - test.SLDASM

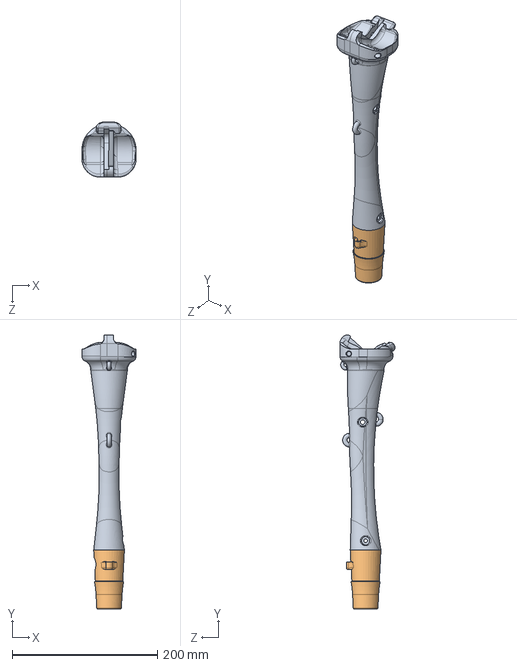
[picture p141: CAD file, 2020-10-16]
Solid_Models/Biomimetics_2022-Knee_Test/Knee - reference/Assem - test.SLDASM
74.8 x 377.7 x 76.3 mm
Tibial head with hardware - bone connection - test
Tibial End
