Agile-and-Adaptive-Robotics/Bipedal_Robot/Solid_Models/Biomimetics_2022-Knee_Test/Reference models/03_Femur_Right.SLDASM

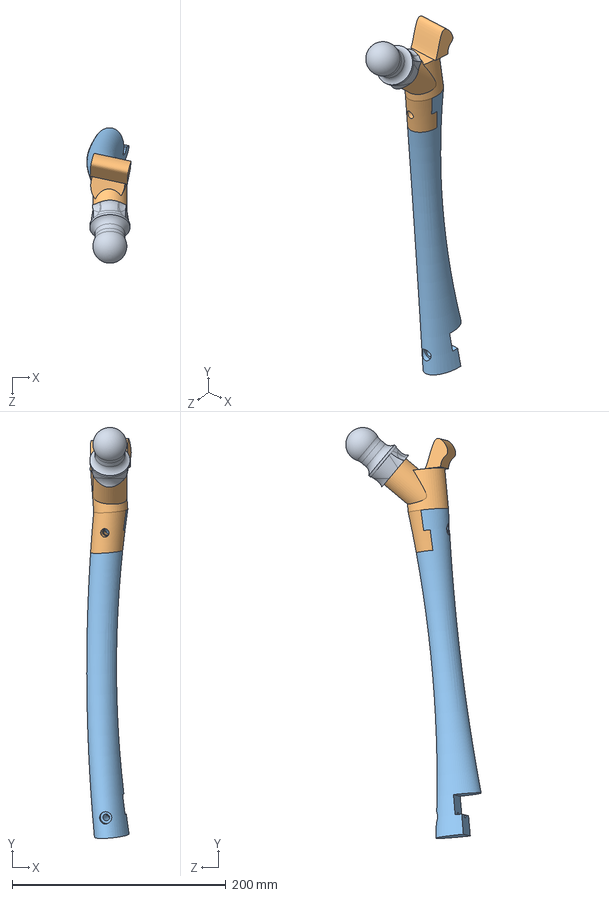
[picture p142: CAD file, 2020-11-11]
Solid_Models/Biomimetics_2022-Knee_Test/Reference models/03_Femur_Right.SLDASM
41.6 x 384.3 x 126.6 mm
03_01_Femoral_Knob_Right
03_02_Femoral_Head_Right
03_03_Femur_Right
