Agile-and-Adaptive-Robotics/Bipedal_Robot/Solid_Models/Prospective_Parts/02_00_00_InternFoot/01_ML.SLDASM

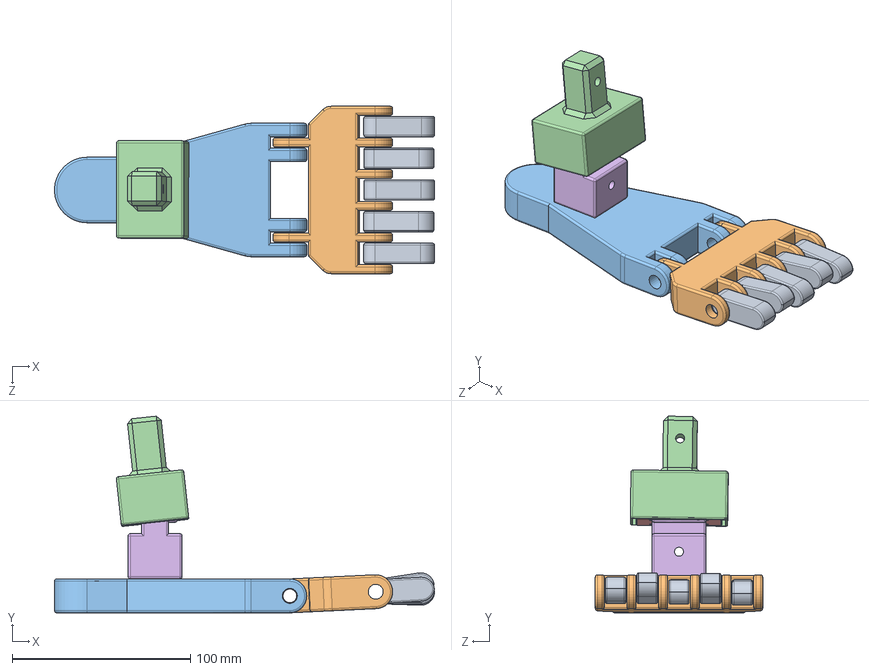
[picture p143: CAD file, 2020-09-08]
Solid_Models/Prospective_Parts/02_00_00_InternFoot/01_ML.SLDASM
213.2 x 110.4 x 94.0 mm
01_01_00_01_ML x 5
01_01_00_02_ML
01_01_00_03_ML
01_01_01_01_ML
01_01_01_02_ML
01_01_01_03_ML
