Agile-and-Adaptive-Robotics/Bipedal_Robot/Solid_Models/Prospective_Parts/Ty Ankle Foot/Agility Robotics/Foot - side_to_side_motion.SLDASM

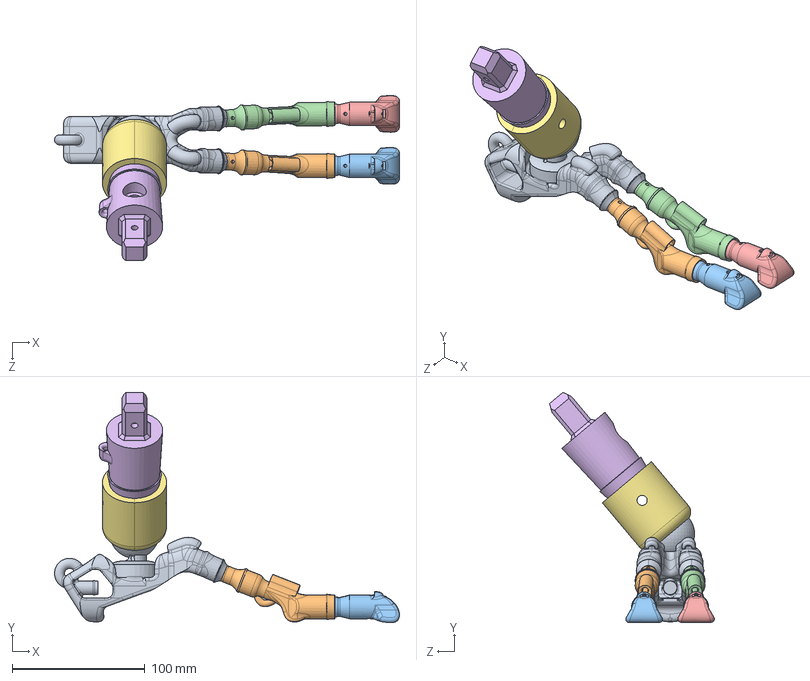
[picture p144: CAD file, 2020-06-29]
Solid_Models/Prospective_Parts/Ty Ankle Foot/Agility Robotics/Foot - side_to_side_motion.SLDASM
259.6 x 173.3 x 124.1 mm
Talus - New
Metatarsals
Phalanges
Metatarsals - Left side
Phalanges - Left side
Tibial End
Sleeve x 2
