Agile-and-Adaptive-Robotics/Bipedal_Robot/Solid_Models/Biomimetics_2022-Knee_Test/Test_Jig/Test_Jig.SLDASM

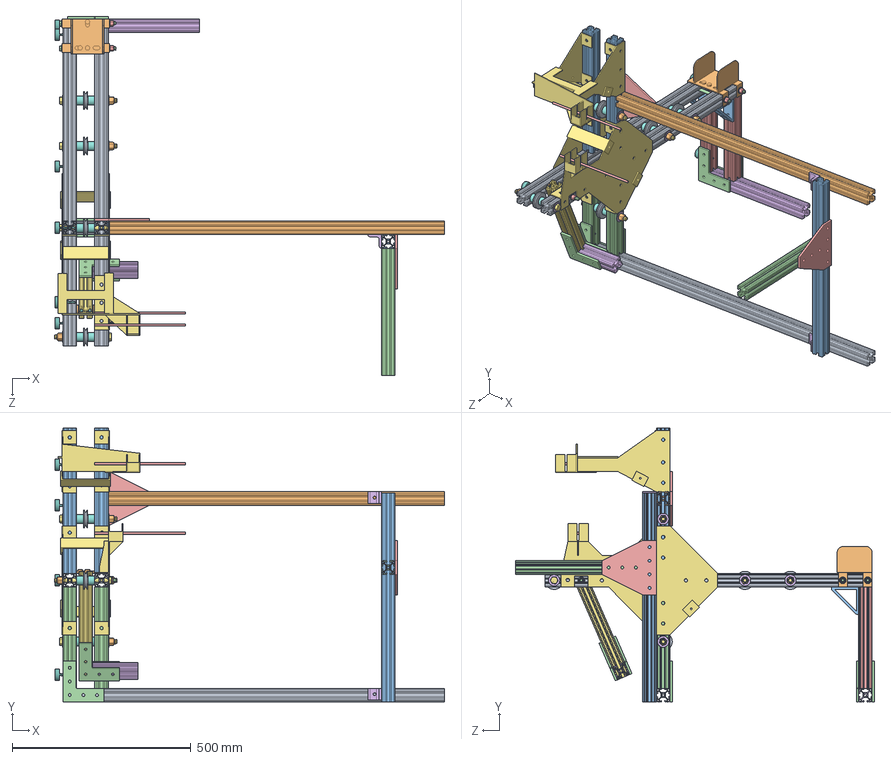
[picture p145: CAD file, 2026-01-05]
Solid_Models/Biomimetics_2022-Knee_Test/Test_Jig/Test_Jig.SLDASM
1090.8 x 765.2 x 1003.3 mm
8020_1515UL_GeneralFrameHorizontal_36in x 2
WinchAndSled
McCarr_Washer_0.375 x 6
McCarr_Bolt_0.375inx6in x 3
McCarr_Nut_0.375 x 3
McCarr_Washer_0.5 x 10
McCarr_Bolt_0.5inx6in x 5
McCarr_Spacer_0.75 x 10
McCarr_Pulley_0.5inD x 5
McCarr_Nut_0.5 x 5
8020_1515UL_GeneralFrame_UpperPulleySupport_20in x 2
8020_1515UL_GeneralFrame_LowerPulleySupport_12in x 2
8020_1515UL_GeneralFrame_LowerRearUpright_12in x 2
8020_1515UL_GeneralFrame_Foot_15in
8020_1515UL_SwingLength_12in
McCarr_FlangedSleeveBearing_0.375ID x 2
McCarr_SleeveBearing_0.375ID
McCarr_Spacer_0.1875 x 2
8020_90TallCornerBrace x 2
8020_LFlat x 6
0.25-20_Rod_Model x 2
8020_1515UL_SwingArm
FemurJig
McCarr_LevelingMount_0.25-20x1.5in x 7
8020_1515UL_GeneralFrame_Foot_42in
8020_1515UL_CameraFrame_37in
8020_1515UL_CameraFrame_23in
8020_1515UL_CameraFrame_14in
8020_TeeFlatPlate x 2
8020_inside90 x 2
