Agile-and-Adaptive-Robotics/Bipedal_Robot/Solid_Models/Prospective_Parts/Tibia_Right/Tibial assemb.SLDASM

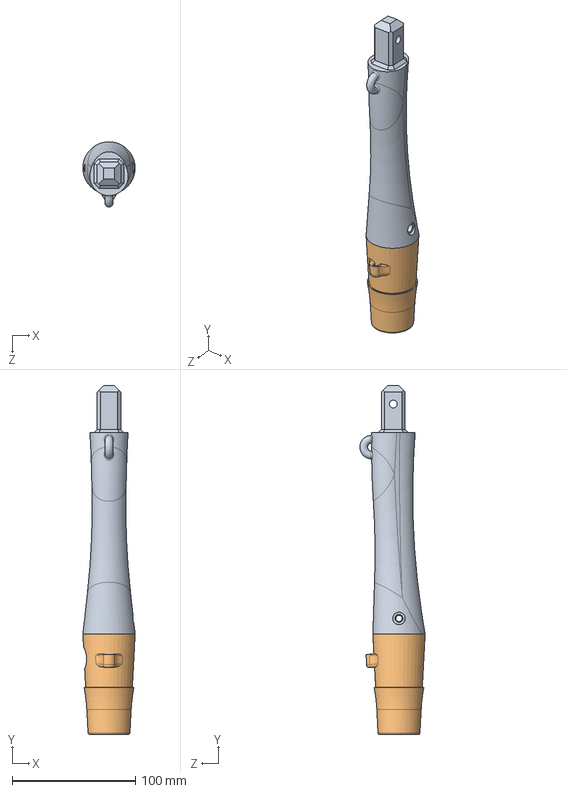
[picture p146: CAD file, 2020-06-24]
Solid_Models/Prospective_Parts/Tibia_Right/Tibial assemb.SLDASM
42.4 x 282.6 x 52.9 mm
Tibial head with hardware - bone connection - test
Tibial End - New air plug
