Agile-and-Adaptive-Robotics/Bipedal_Robot/Solid_Models/Biomimetics_2022-Knee_Test/AARL_Puppy_18_02_01_000-FLFE/AARL_Puppy_18_02_01_000.SLDASM

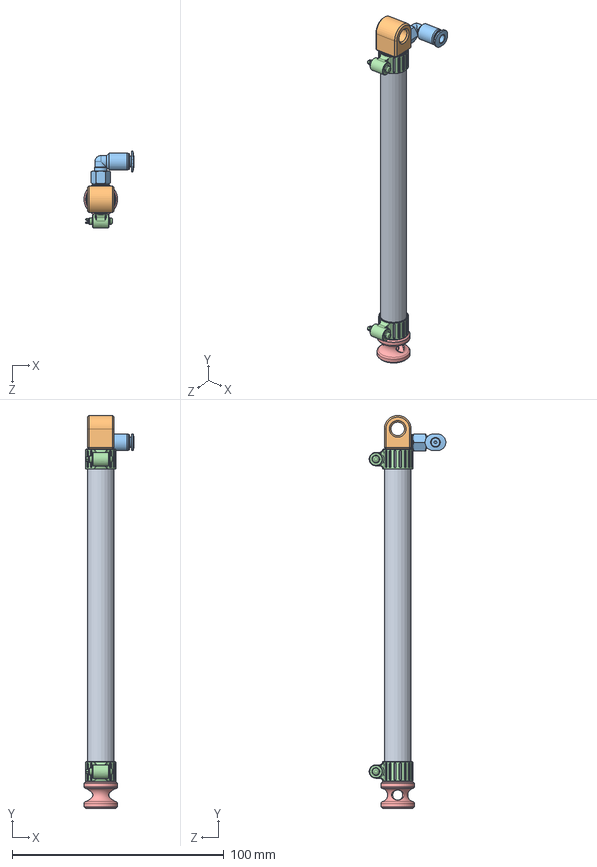
[picture p147: CAD file, 2021-07-26]
Solid_Models/Biomimetics_2022-Knee_Test/AARL_Puppy_18_02_01_000-FLFE/AARL_Puppy_18_02_01_000.SLDASM
23.6 x 185.8 x 36.2 mm
AARL_Puppy_18_02_01_001
AARL_Puppy_18_02_01_002
AARL_Puppy_18_02_01_004-QSML-M3-4
AARL_Puppy_18_02_01_005-SK-8-16 x 2
AARL_Puppy_18_02_01_007
