Agile-and-Adaptive-Robotics/Bipedal_Robot/Solid Models/Updated Robot parts with attachments/Assem2.SLDASM

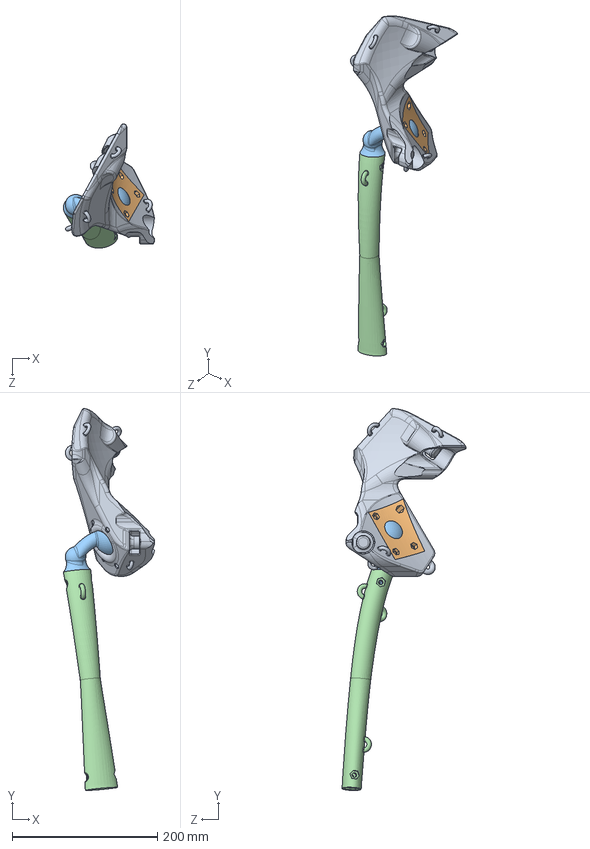
[picture p148: CAD file, 2020-06-24]
Solid Models/Updated Robot parts with attachments/Assem2.SLDASM
125.9 x 526.7 x 171.3 mm
hip ball_socket
illiumbackplate
ball3
femor bone mirror
