Agile-and-Adaptive-Robotics/Bipedal_Robot/Solid Models/Updated Robot parts with attachments/more sizing.SLDASM

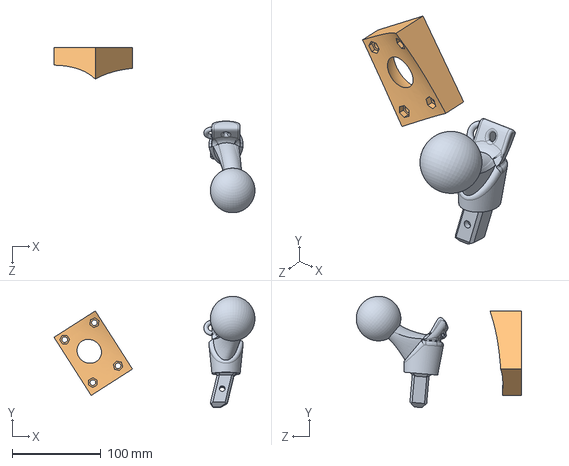
[picture p149: CAD file, 2020-06-24]
Solid Models/Updated Robot parts with attachments/more sizing.SLDASM
226.5 x 125.4 x 186.5 mm
Femoral head attachments ball
illiumbackplate
