Agile-and-Adaptive-Robotics/Bipedal_Robot/Solid Models/Updated Robot parts with attachments/ball and socket assembly.SLDASM

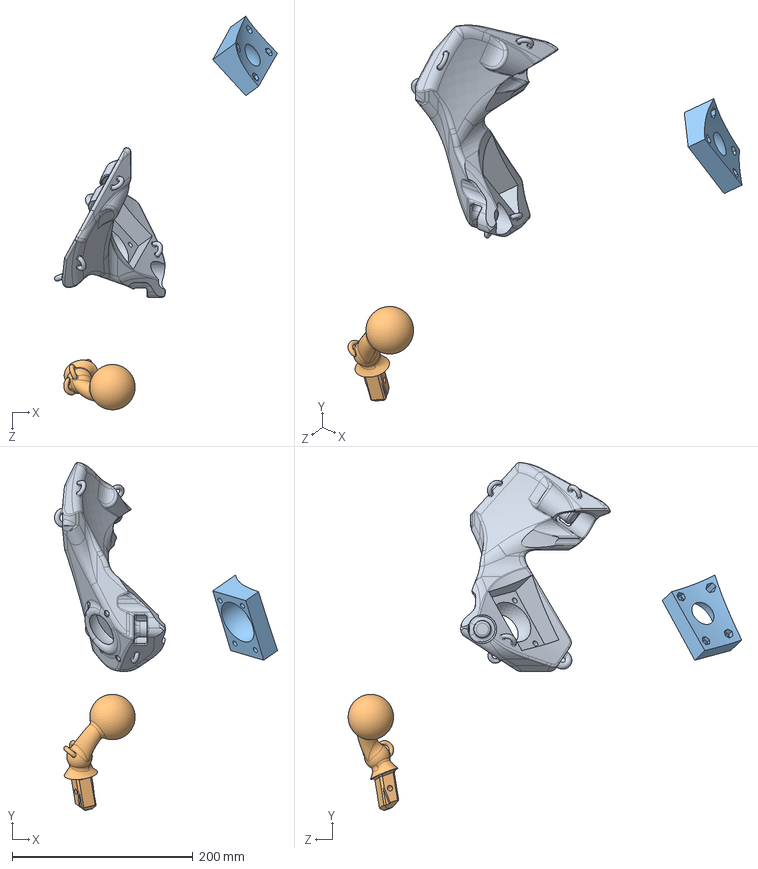
[picture p150: CAD file, 2020-06-24]
Solid Models/Updated Robot parts with attachments/ball and socket assembly.SLDASM
247.1 x 385.4 x 436.0 mm
hip ball_socket
ball3
illiumbackplate
