Agile-and-Adaptive-Robotics/Bipedal_Robot/Solid Models/Updated Robot parts with attachments/sizing.SLDASM

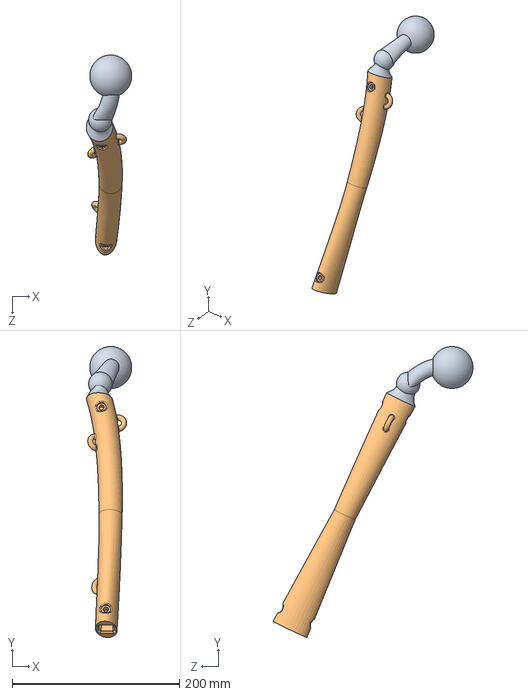
[picture p151: CAD file, 2020-06-24]
Solid Models/Updated Robot parts with attachments/sizing.SLDASM
54.4 x 348.4 x 239.4 mm
ball3
femor bone mirror
