Agile-and-Adaptive-Robotics/Bipedal_Robot/Solid Models/Updated Robot parts with attachments/femoral head sizing.SLDASM

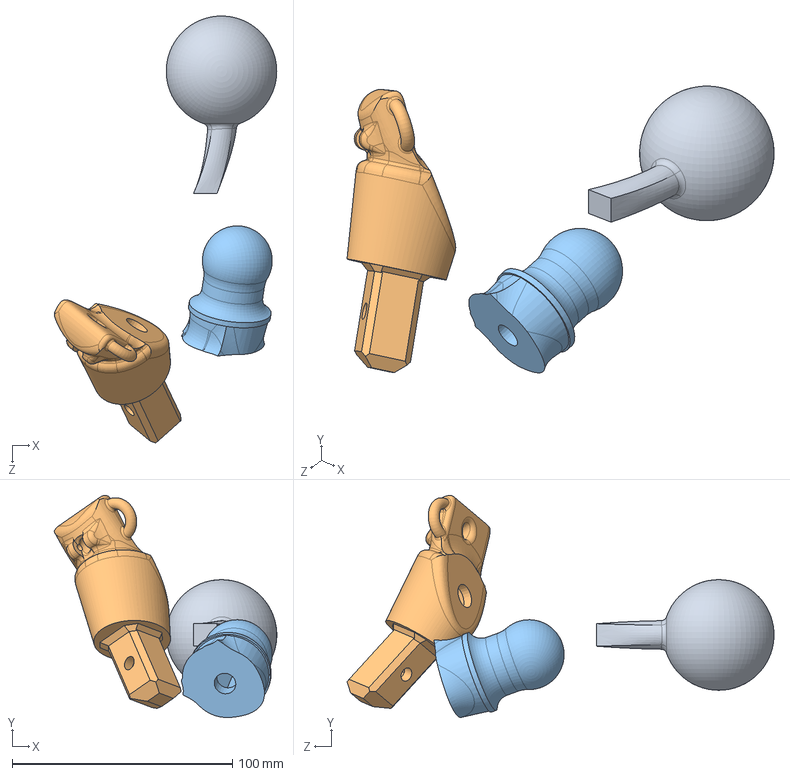
[picture p152: CAD file, 2020-06-24]
Solid Models/Updated Robot parts with attachments/femoral head sizing.SLDASM
101.1 x 100.9 x 194.0 mm
ball2
Femoral head attachments
Femoral knob 011819
