Agile-and-Adaptive-Robotics/Bipedal_Robot/Solid_Models/Prospective_Parts/Ty Ankle Foot/Agility Robotics/Ankle assembly.SLDASM

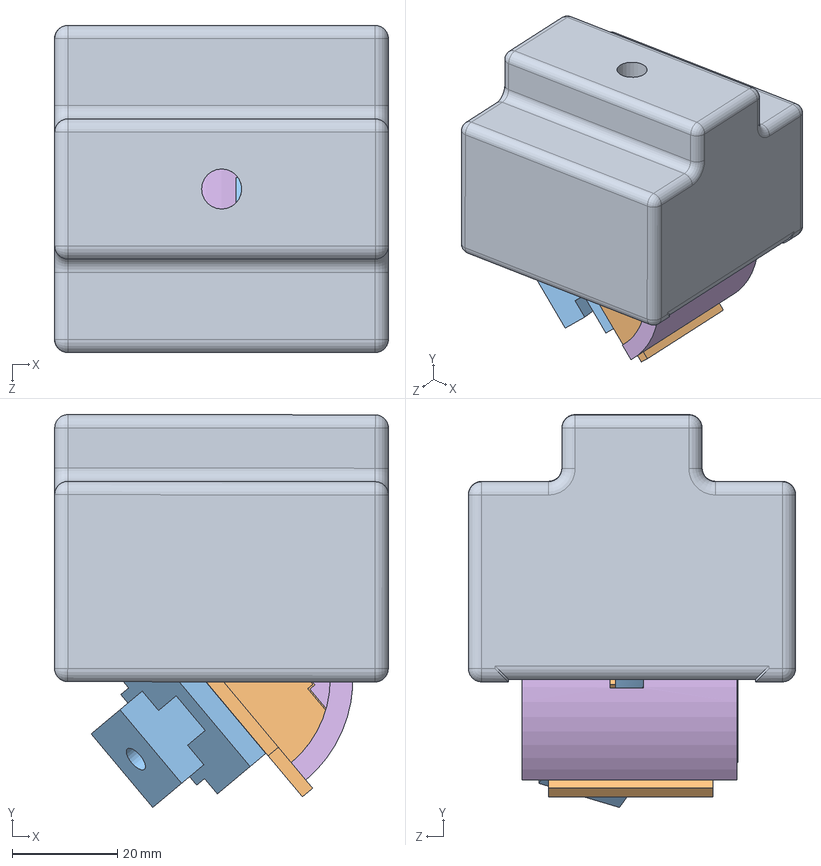
[picture p153: CAD file, 2020-06-29]
Solid_Models/Prospective_Parts/Ty Ankle Foot/Agility Robotics/Ankle assembly.SLDASM
63.6 x 74.7 x 62.2 mm
Ty talus
Ty Part 2
Part 3 Talus
Part 5 Ty
Part 4 Ty
Ankle shell
