Agile-and-Adaptive-Robotics/Bipedal_Robot/Solid_Models/Biomimetics_2022-Knee_Test/Knee assembly/09_BA_001.SLDASM

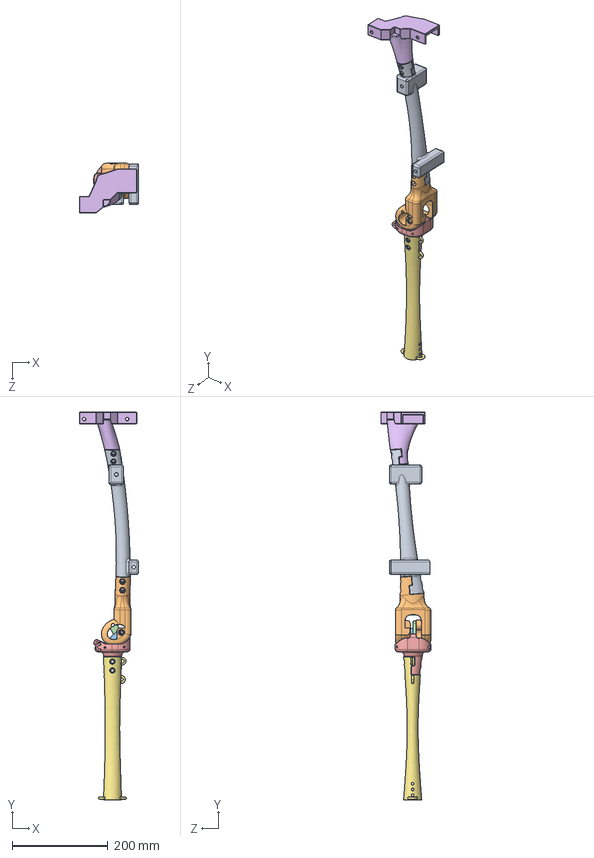
[picture p154: CAD file, 2022-03-13]
Solid_Models/Biomimetics_2022-Knee_Test/Knee assembly/09_BA_001.SLDASM
123.9 x 811.7 x 104.9 mm
03_01_FB_R_002
04_01_KT_R_002
04_05_BL_001
04_06_FL_001
04_02_KB_R_002
MuscleOrigins_001
05_01_TI_R_003
