Agile-and-Adaptive-Robotics/Bipedal_Robot/Solid_Models/Prospective_Parts/Ty Ankle Foot/Agility Robotics/Ty foot.SLDASM

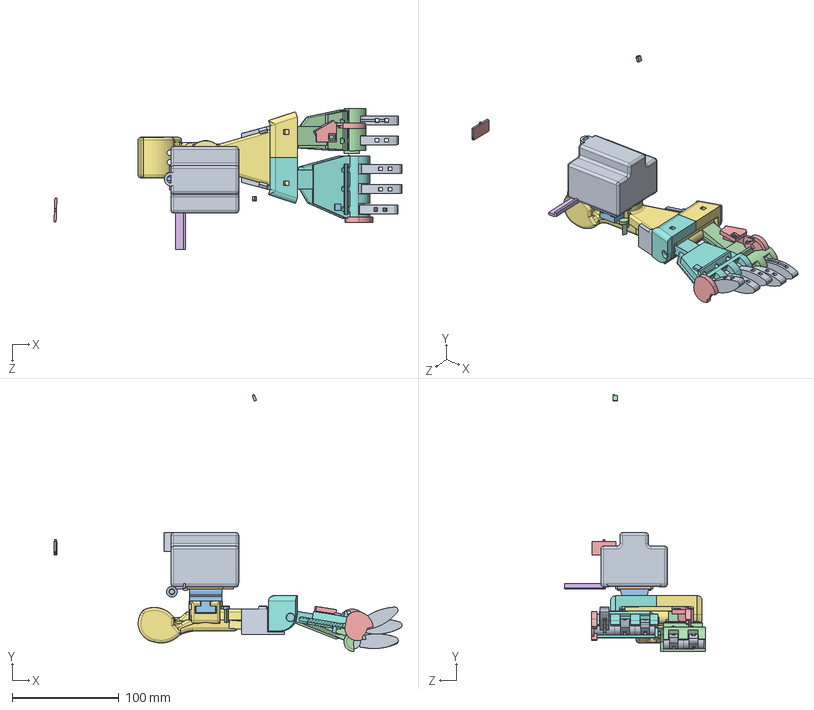
[picture p155: CAD file, 2020-06-29]
Solid_Models/Prospective_Parts/Ty Ankle Foot/Agility Robotics/Ty foot.SLDASM
326.0 x 240.9 x 131.8 mm
Ty talus
Ty Part 2
Part 3 Talus
Ty Lock
Part 5 Ty
Part 4 Ty
New foot
Falanges RB
Toe x 5
Foot Pin
pin 2
Ankle shell
Foot cover
Axle
Wheel
Falanges RL new
lock
