Agile-and-Adaptive-Robotics/Bipedal_Robot/Solid_Models/Prospective_Parts/Ty Ankle Foot/Agility Robotics/Foot assembly.SLDASM

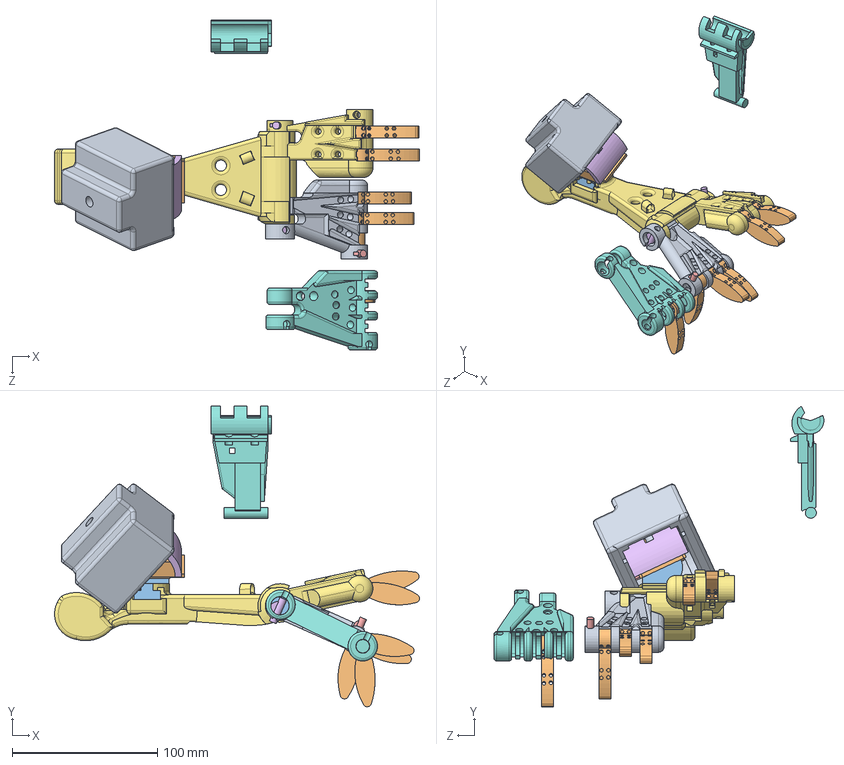
[picture p156: CAD file, 2020-06-29]
Solid_Models/Prospective_Parts/Ty Ankle Foot/Agility Robotics/Foot assembly.SLDASM
251.6 x 207.2 x 227.4 mm
Ty talus
Ty Part 2
Part 3 Talus
Part 5 Ty
Part 4 Ty
Ankle shell
New foot
Midfoot
Toe x 6
foot axle
small axle
Midfoot - Copy (2)
large axle lock
New Front foot
