Agile-and-Adaptive-Robotics/Bipedal_Robot/Solid_Models/Prospective_Parts/Ty Ankle Foot/Agility Robotics/Shell foot.SLDASM

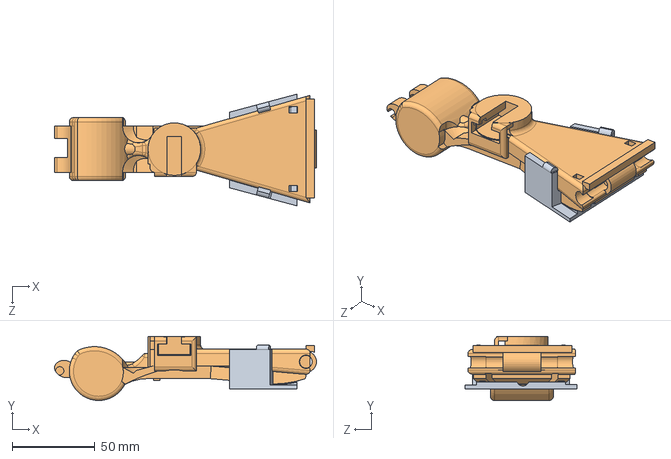
[picture p157: CAD file, 2020-06-29]
Solid_Models/Prospective_Parts/Ty Ankle Foot/Agility Robotics/Shell foot.SLDASM
158.0 x 38.6 x 67.4 mm
foot shell
New foot
