Agile-and-Adaptive-Robotics/Bipedal_Robot/Solid_Models/Prospective_Parts/Ty Ankle Foot/Agility Robotics/Foot.SLDASM

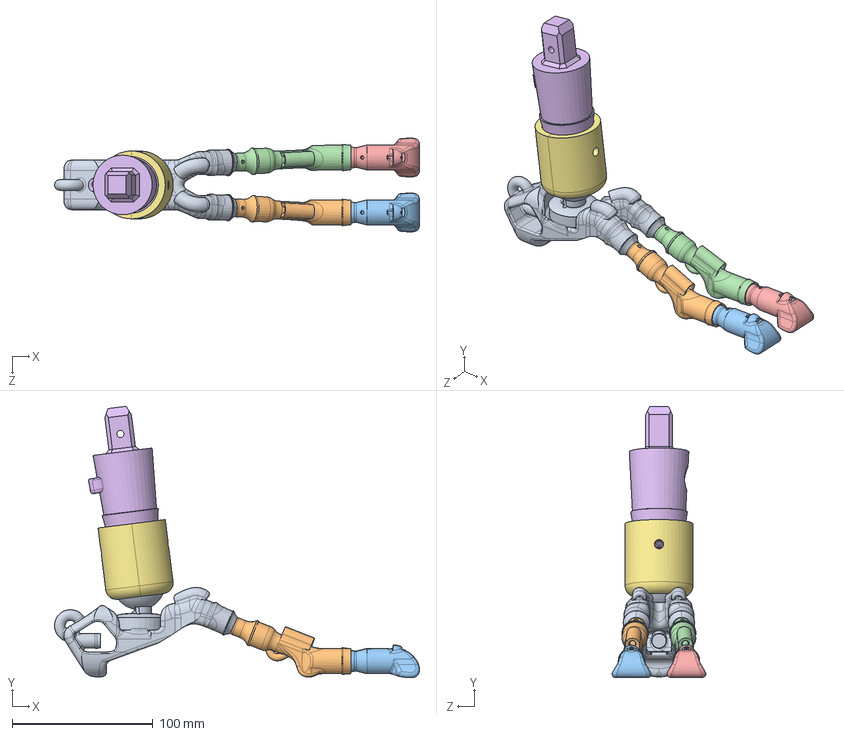
[picture p158: CAD file, 2020-06-29]
Solid_Models/Prospective_Parts/Ty Ankle Foot/Agility Robotics/Foot.SLDASM
259.6 x 193.1 x 66.7 mm
Talus - New
Metatarsals
Phalanges
Metatarsals - Left side
Phalanges - Left side
Tibial End
Sleeve x 2
