Agile-and-Adaptive-Robotics/Bipedal_Robot/Solid_Models/Prospective_Parts/Ty Ankle Foot/Agility Robotics/Sleeve-redone.SLDASM

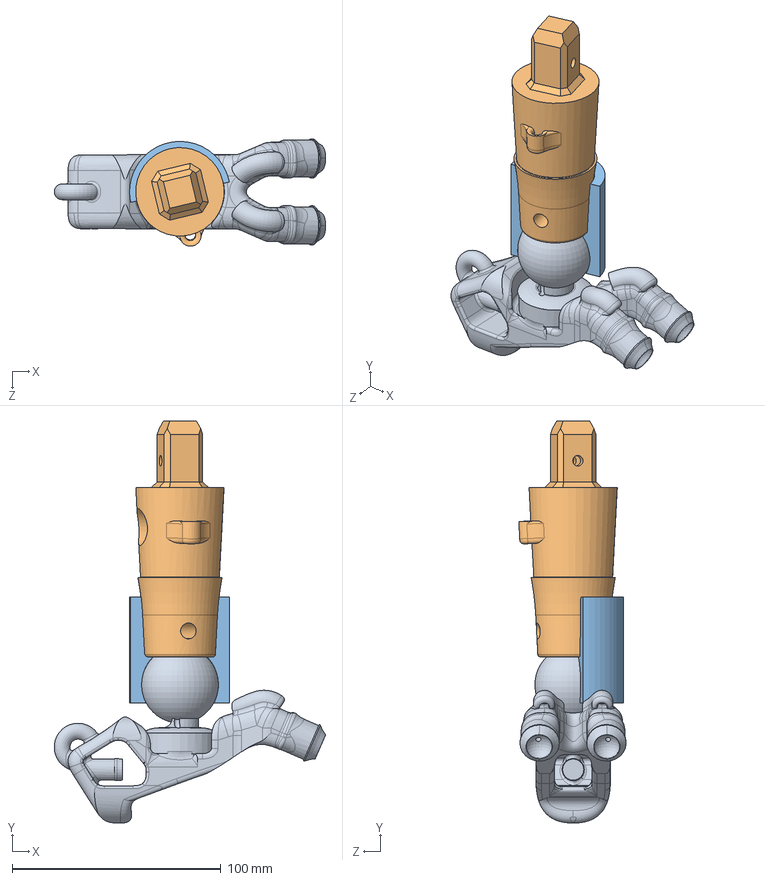
[picture p159: CAD file, 2020-06-29]
Solid_Models/Prospective_Parts/Ty Ankle Foot/Agility Robotics/Sleeve-redone.SLDASM
130.1 x 192.6 x 51.5 mm
Talus - New
Tibial End
