Agile-and-Adaptive-Robotics/Bipedal_Robot/Solid Models/Living Machines 2021 - Knee Test/STL Files/Tibia.STL

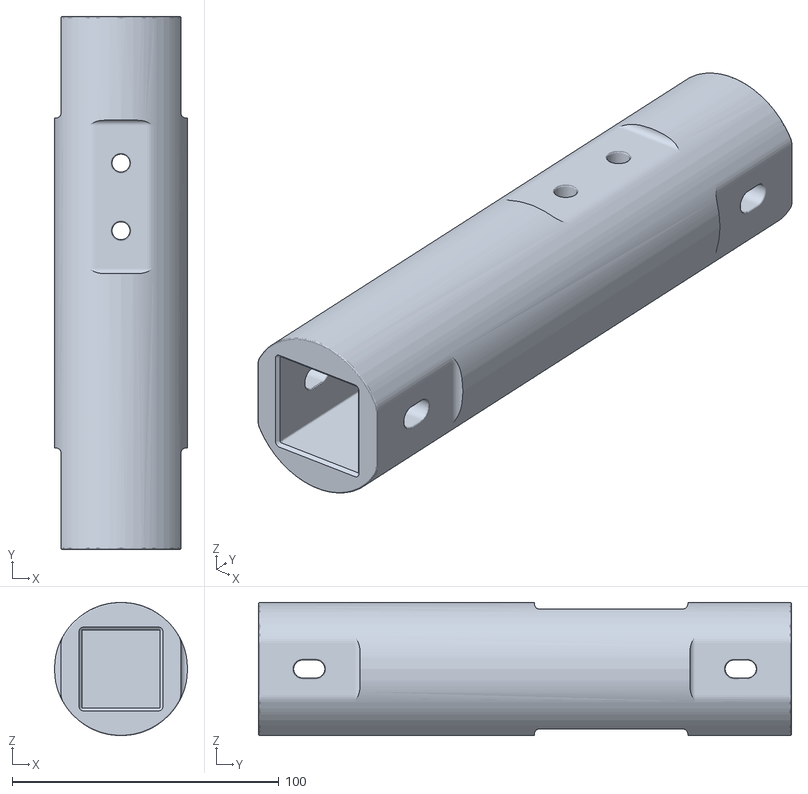
[picture p161: CAD file, 2020-11-11]
Solid Models/Living Machines 2021 - Knee Test/STL Files/Tibia.STL
50.0 x 200.0 x 50.0
