Agile-and-Adaptive-Robotics/Bipedal_Robot/Solid Models/Updated Robot parts with attachments/Tibial Rotator-Split11.SLDPRT

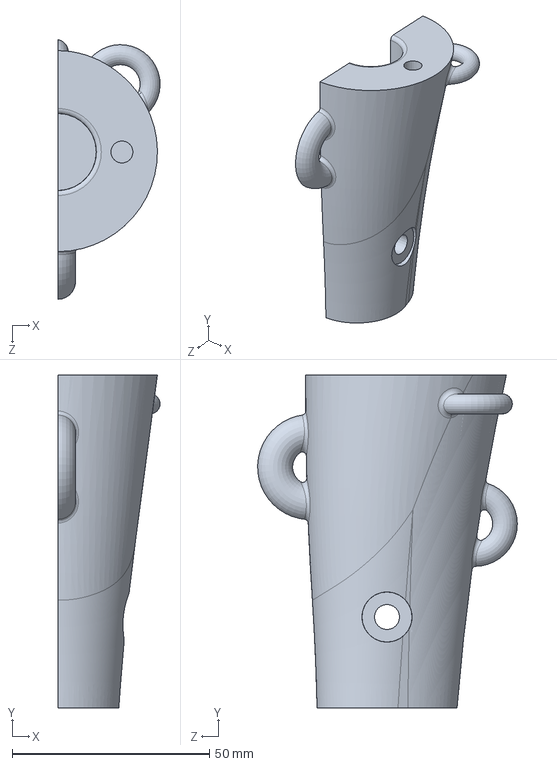
[picture p162: CAD file, 2020-06-24]
Solid Models/Updated Robot parts with attachments/Tibial Rotator-Split11.SLDPRT
25.9 x 84.5 x 65.9 mm
