Agile-and-Adaptive-Robotics/Bipedal_Robot/Solid_Models/00_Bipedal_Robot/04_Femur_Left/04_02_FH_L_001.SLDPRT

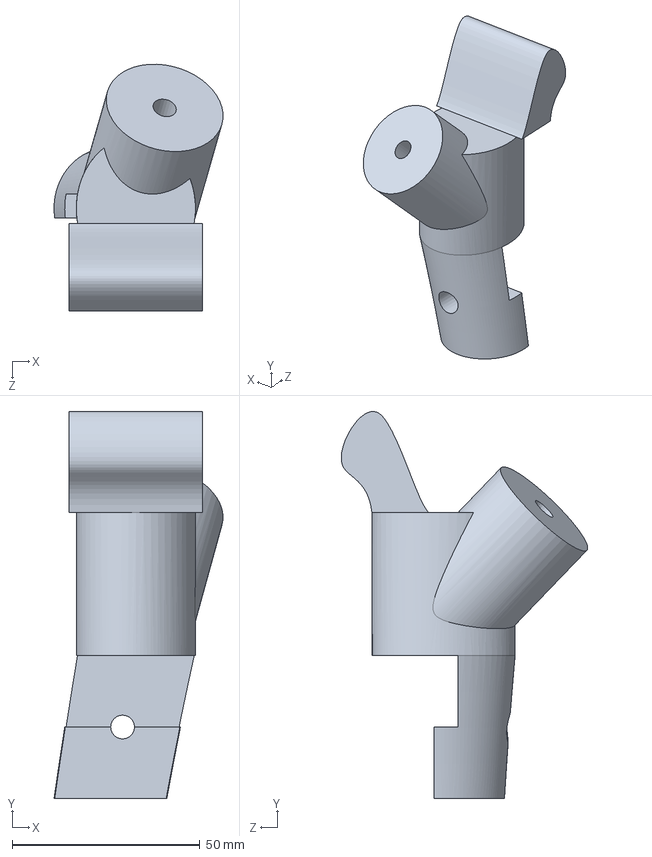
[picture p163: CAD file, 2021-10-08]
Solid_Models/00_Bipedal_Robot/04_Femur_Left/04_02_FH_L_001.SLDPRT
45.0 x 103.1 x 65.7 mm
