Agile-and-Adaptive-Robotics/Bipedal_Robot/Solid_Models/00_Bipedal_Robot/05_Knee_Right/05_01_KT_R_001.SLDPRT

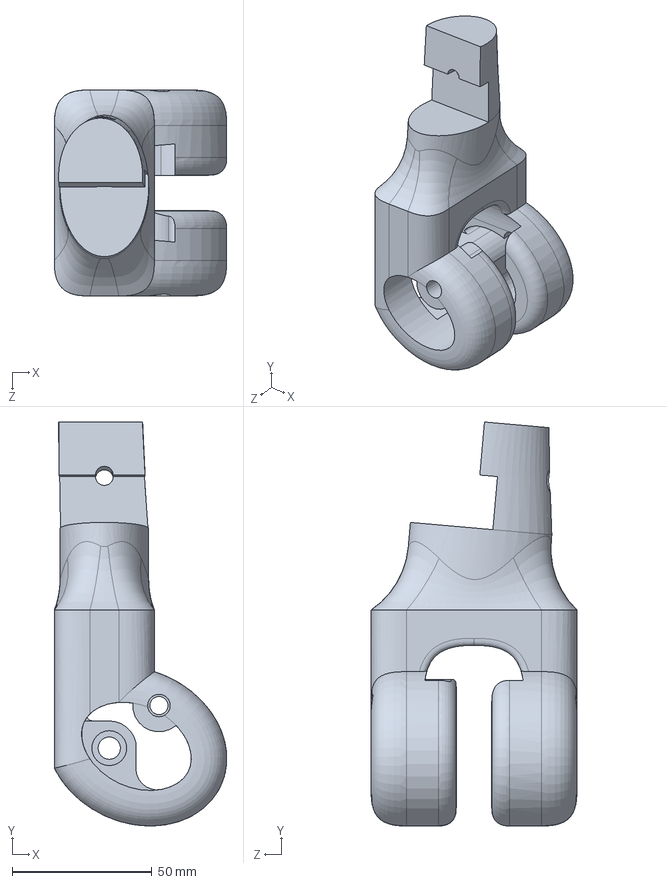
[picture p164: CAD file, 2022-02-05]
Solid_Models/00_Bipedal_Robot/05_Knee_Right/05_01_KT_R_001.SLDPRT
61.7 x 144.5 x 73.7 mm
