Agile-and-Adaptive-Robotics/Bipedal_Robot/Solid_Models/00_Bipedal_Robot/07_Tibia_Right/07_TI_R_001.SLDPRT

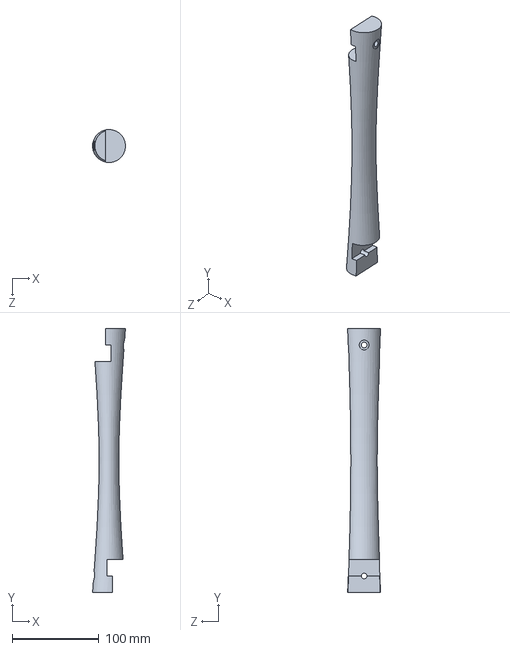
[picture p165: CAD file, 2021-06-29]
Solid_Models/00_Bipedal_Robot/07_Tibia_Right/07_TI_R_001.SLDPRT
38.1 x 304.8 x 38.0 mm
