Agile-and-Adaptive-Robotics/Bipedal_Robot/Solid_Models/00_Bipedal_Robot/10_Foot_Left/10_07_MM_L_001.SLDPRT

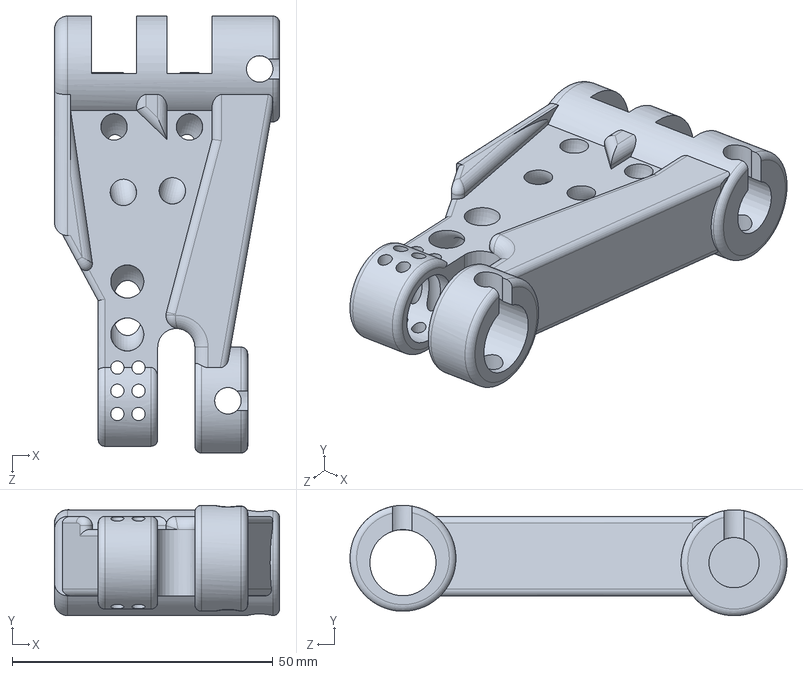
[picture p166: CAD file, 2021-10-08]
Solid_Models/00_Bipedal_Robot/10_Foot_Left/10_07_MM_L_001.SLDPRT
43.2 x 21.2 x 83.8 mm
