Agile-and-Adaptive-Robotics/Bipedal_Robot/Solid_Models/00_Bipedal_Robot/knee encoder/03_Femur/03_04_FemurHead_Left.SLDPRT

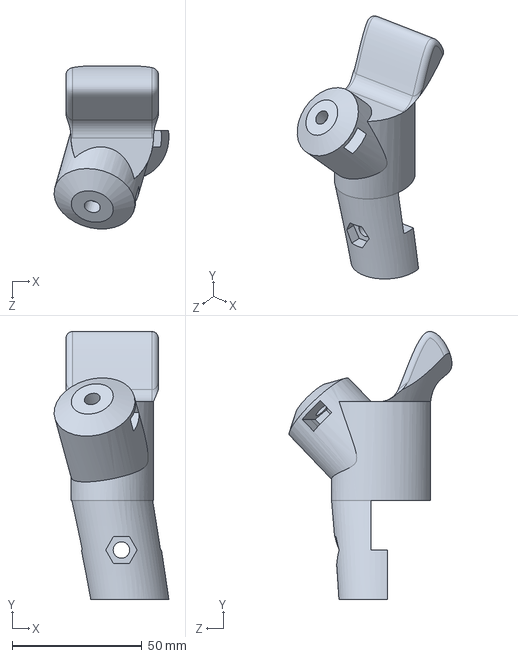
[picture p167: CAD file, 2022-02-05]
Solid_Models/00_Bipedal_Robot/knee encoder/03_Femur/03_04_FemurHead_Left.SLDPRT
44.2 x 103.1 x 62.7 mm
