Agile-and-Adaptive-Robotics/Bipedal_Robot/Solid_Models/00_Bipedal_Robot/knee encoder/03_Femur/03_06_FemurHeadConnection_3dPrinted/Femoral_Head_Ver1_Cap.SLDPRT

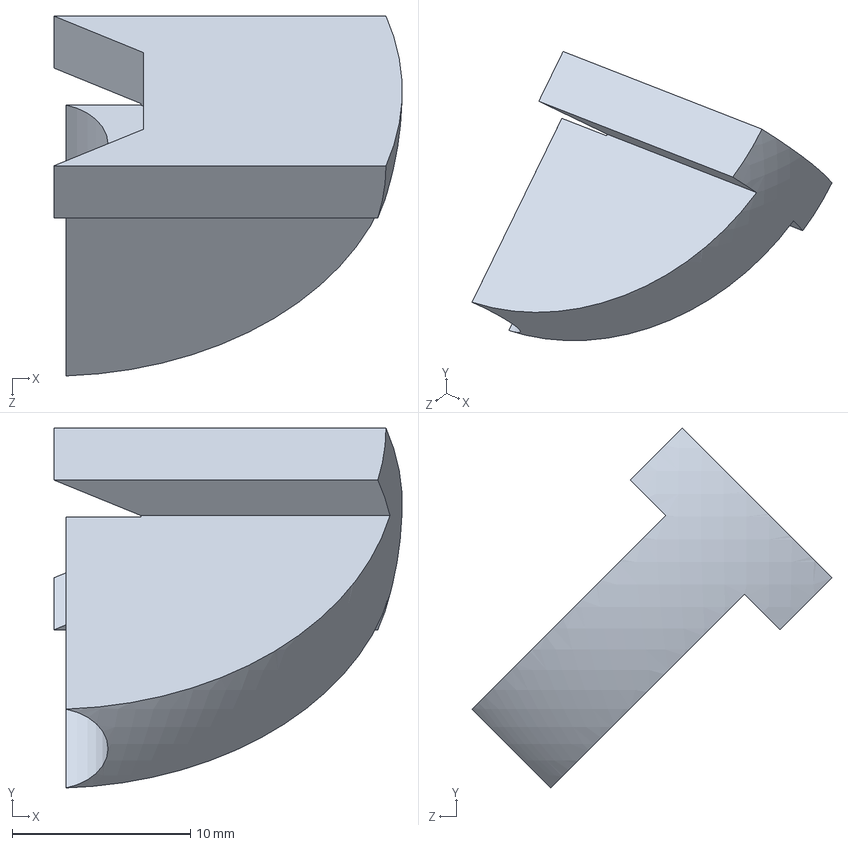
[picture p168: CAD file, 2021-10-08]
Solid_Models/00_Bipedal_Robot/knee encoder/03_Femur/03_06_FemurHeadConnection_3dPrinted/Femoral_Head_Ver1_Cap.SLDPRT
19.5 x 20.2 x 20.2 mm
