Agile-and-Adaptive-Robotics/Bipedal_Robot/Solid_Models/00_Bipedal_Robot/knee encoder/04_Knee/04_01_KneeTop_Right.SLDPRT

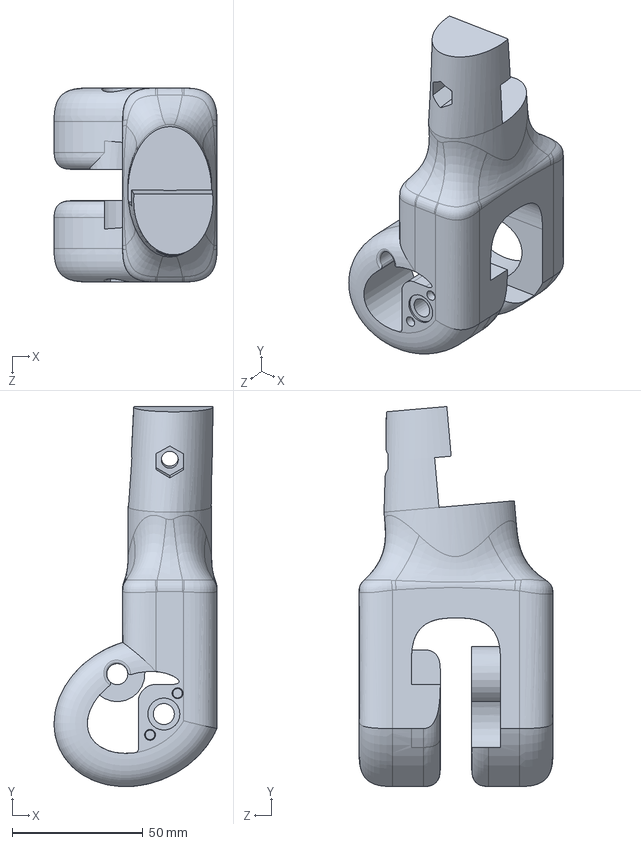
[picture p169: CAD file, 2022-02-05]
Solid_Models/00_Bipedal_Robot/knee encoder/04_Knee/04_01_KneeTop_Right.SLDPRT
62.2 x 145.1 x 74.0 mm
