Agile-and-Adaptive-Robotics/Bipedal_Robot/Solid_Models/00_Bipedal_Robot/knee encoder/05_Tibia/05_01_Tibial_Right.SLDPRT

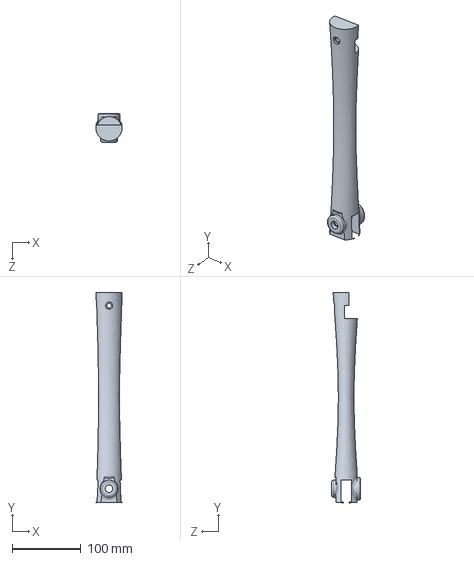
[picture p170: CAD file, 2022-02-05]
Solid_Models/00_Bipedal_Robot/knee encoder/05_Tibia/05_01_Tibial_Right.SLDPRT
38.0 x 304.8 x 41.5 mm
