Agile-and-Adaptive-Robotics/Bipedal_Robot/Solid_Models/Biomimetics_2022-Knee_Test/AARL_Puppy_18_02_01_000-FLFE/AARL_Puppy_18_02_01_010.SLDPRT

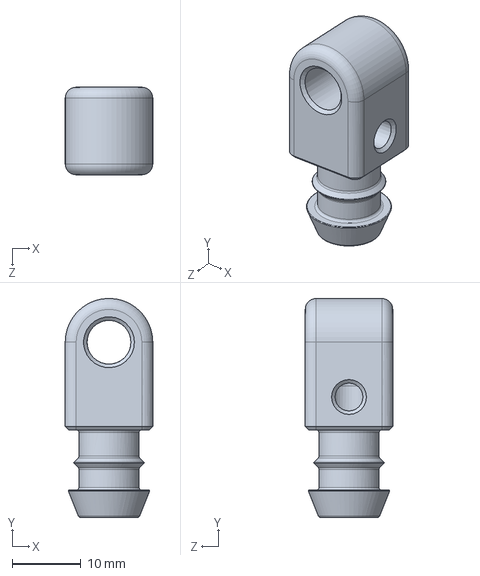
[picture p171: CAD file, 2026-01-05]
Solid_Models/Biomimetics_2022-Knee_Test/AARL_Puppy_18_02_01_000-FLFE/AARL_Puppy_18_02_01_010.SLDPRT
12.7 x 31.7 x 12.7 mm
