Agile-and-Adaptive-Robotics/Bipedal_Robot/Solid_Models/Biomimetics_2022-Knee_Test/Knee - reference/Femoral end with hardware - Latest.SLDPRT

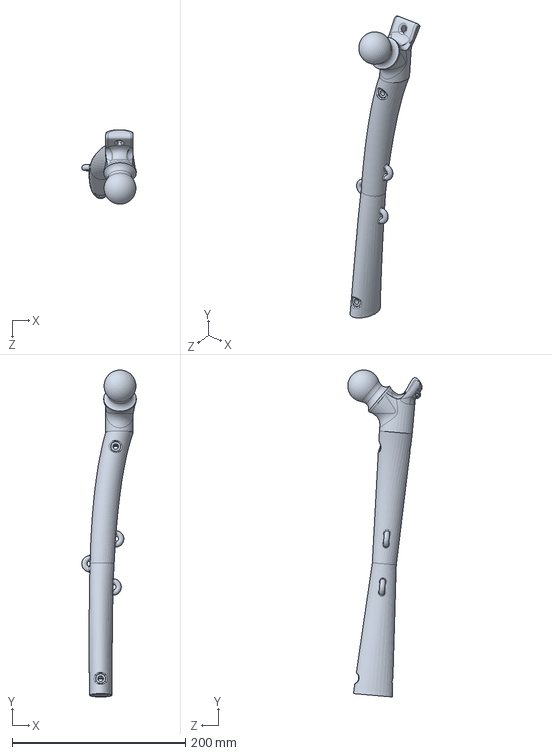
[picture p172: CAD file, 2020-11-11]
Solid_Models/Biomimetics_2022-Knee_Test/Knee - reference/Femoral end with hardware - Latest.SLDPRT
63.0 x 377.6 x 85.9 mm
