Agile-and-Adaptive-Robotics/Bipedal_Robot/Solid_Models/Biomimetics_2022-Knee_Test/Knee assembly/BifemSH_brkt_origin.SLDPRT

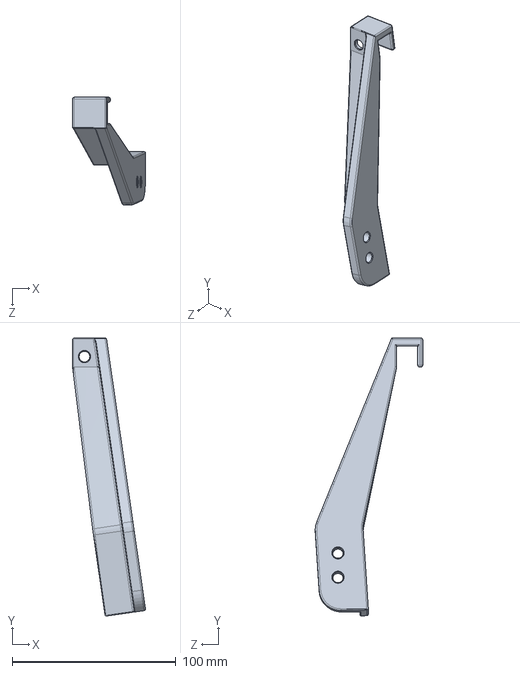
[picture p173: CAD file, 2026-01-05]
Solid_Models/Biomimetics_2022-Knee_Test/Knee assembly/BifemSH_brkt_origin.SLDPRT
44.5 x 169.7 x 65.7 mm
