Agile-and-Adaptive-Robotics/Bipedal_Robot/Solid_Models/Biomimetics_2022-Knee_Test/Point_cloud/Assem2^Assem2.51_test_with_patella_sketch.SLDPRT

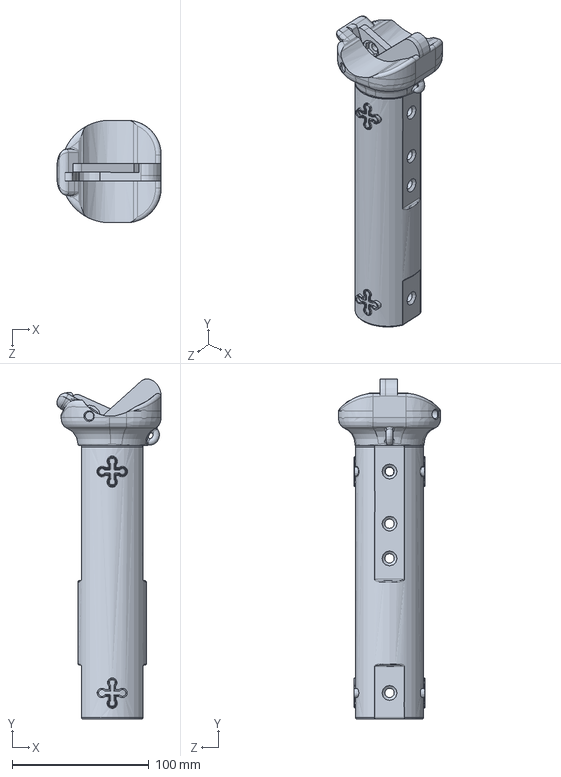
[picture p174: CAD file, 2022-02-05]
Solid_Models/Biomimetics_2022-Knee_Test/Point_cloud/Assem2^Assem2.51_test_with_patella_sketch.SLDPRT
76.3 x 248.6 x 74.9 mm
