Agile-and-Adaptive-Robotics/Bipedal_Robot/Solid_Models/Biomimetics_2022-Knee_Test/Reference models/Femoral head - Knee Test.SLDPRT

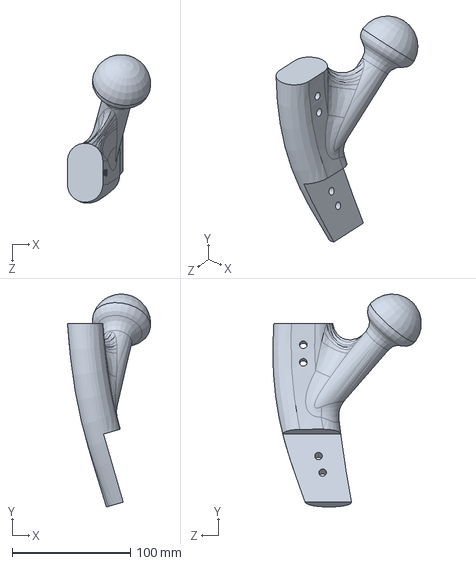
[picture p175: CAD file, 2021-03-03]
Solid_Models/Biomimetics_2022-Knee_Test/Reference models/Femoral head - Knee Test.SLDPRT
70.4 x 180.4 x 125.7 mm
