Agile-and-Adaptive-Robotics/Bipedal_Robot/Solid_Models/Biomimetics_2022-Knee_Test/STL Files/AARL_Puppy_18_02_01_012_Festo20mm_M5port_ring.STL

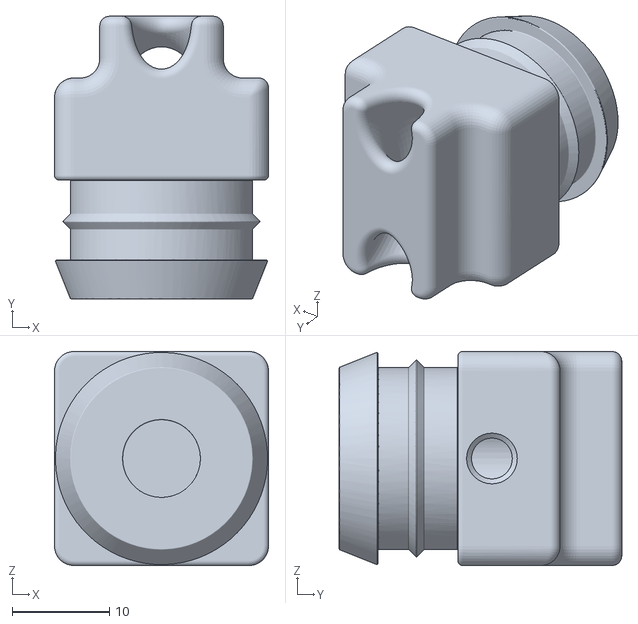
[picture p176: CAD file, 2026-01-05]
Solid_Models/Biomimetics_2022-Knee_Test/STL Files/AARL_Puppy_18_02_01_012_Festo20mm_M5port_ring.STL
22.0 x 29.1 x 22.0
