Agile-and-Adaptive-Robotics/Bipedal_Robot/Solid_Models/Biomimetics_2022-Knee_Test/TAROS Knee/Tibial head with hardware - bone connection.SLDPRT

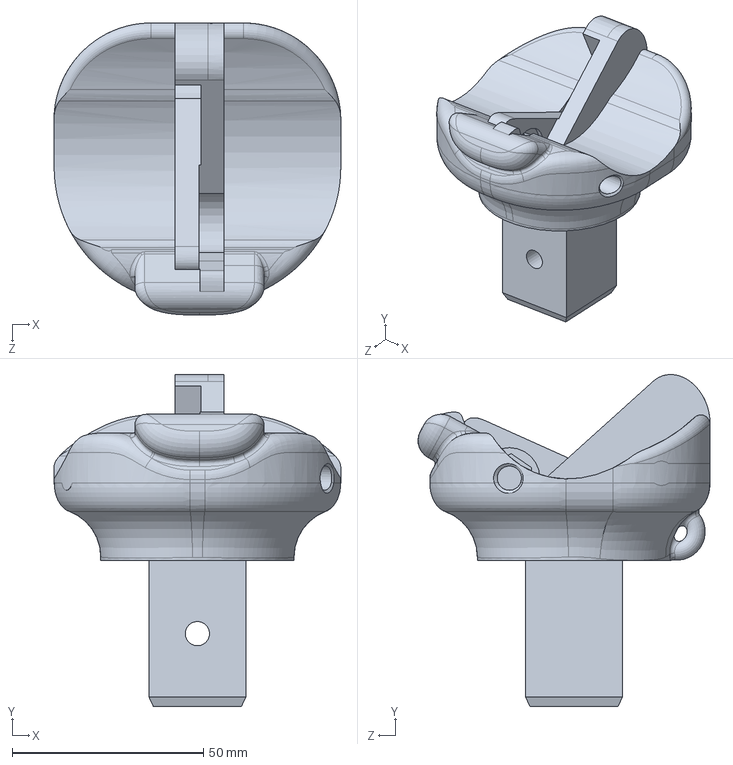
[picture p177: CAD file, 2021-03-03]
Solid_Models/Biomimetics_2022-Knee_Test/TAROS Knee/Tibial head with hardware - bone connection.SLDPRT
74.9 x 86.8 x 76.3 mm
