Agile-and-Adaptive-Robotics/Bipedal_Robot/Solid_Models/Biomimetics_2022-Knee_Test/Test_Jig/8020_1515UL_SwingArm.SLDPRT

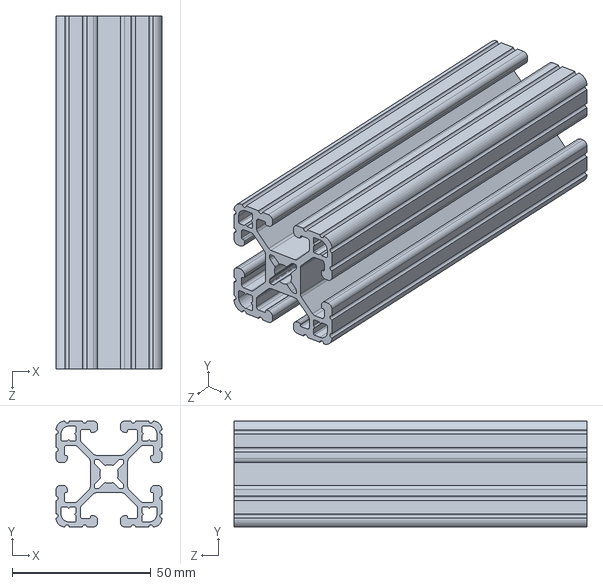
[picture p178: CAD file, 2026-01-05]
Solid_Models/Biomimetics_2022-Knee_Test/Test_Jig/8020_1515UL_SwingArm.SLDPRT
38.1 x 38.1 x 127.0 mm
