Agile-and-Adaptive-Robotics/Bipedal_Robot/Solid_Models/Prospective_Parts/01_00_00_Foot/01_01_00_Ankle/01_01_01_01_ABottom.SLDPRT

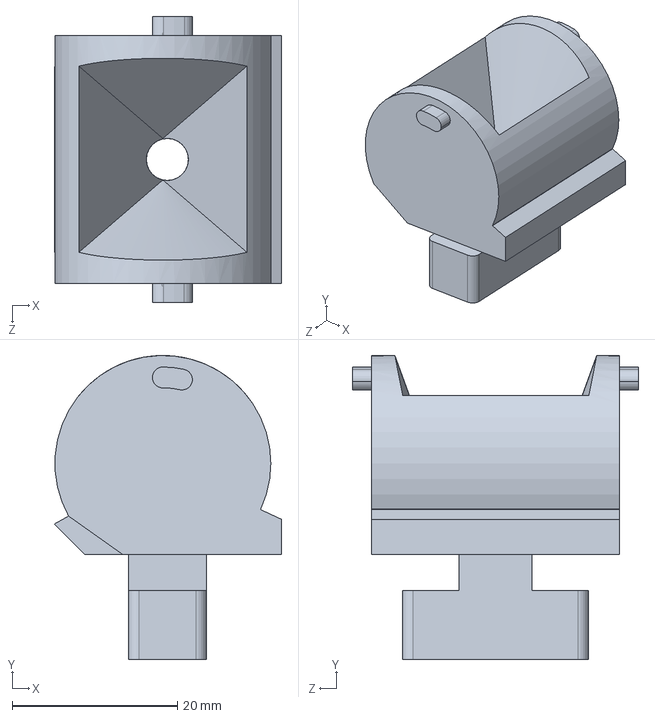
[picture p179: CAD file, 2020-07-20]
Solid_Models/Prospective_Parts/01_00_00_Foot/01_01_00_Ankle/01_01_01_01_ABottom.SLDPRT
27.5 x 36.8 x 34.7 mm
