Agile-and-Adaptive-Robotics/Bipedal_Robot/Solid_Models/Prospective_Parts/01_00_00_Foot/01_02_00_Foot/01_01_02_01_SmallAxle_Copy.SLDPRT

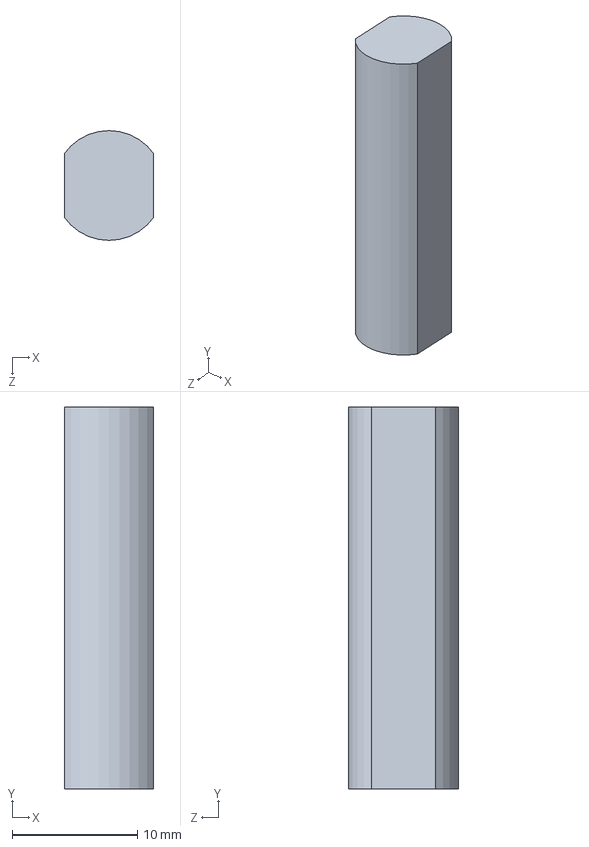
[picture p180: CAD file, 2020-07-20]
Solid_Models/Prospective_Parts/01_00_00_Foot/01_02_00_Foot/01_01_02_01_SmallAxle_Copy.SLDPRT
7.14 x 30.5 x 8.76 mm
