Agile-and-Adaptive-Robotics/Bipedal_Robot/Solid_Models/Prospective_Parts/02_00_00_InternFoot/01_01_00_03_ML.SLDPRT

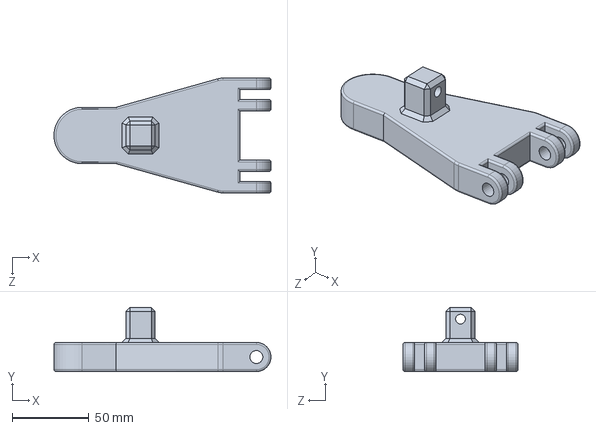
[picture p181: CAD file, 2020-09-08]
Solid_Models/Prospective_Parts/02_00_00_InternFoot/01_01_00_03_ML.SLDPRT
141.6 x 41.9 x 74.9 mm
