Agile-and-Adaptive-Robotics/Bipedal_Robot/Solid_Models/Prospective_Parts/02_00_00_InternFoot/STL Files/01_ML - 01_01_01_ML-1 01_01_01_03_ML-1.STL

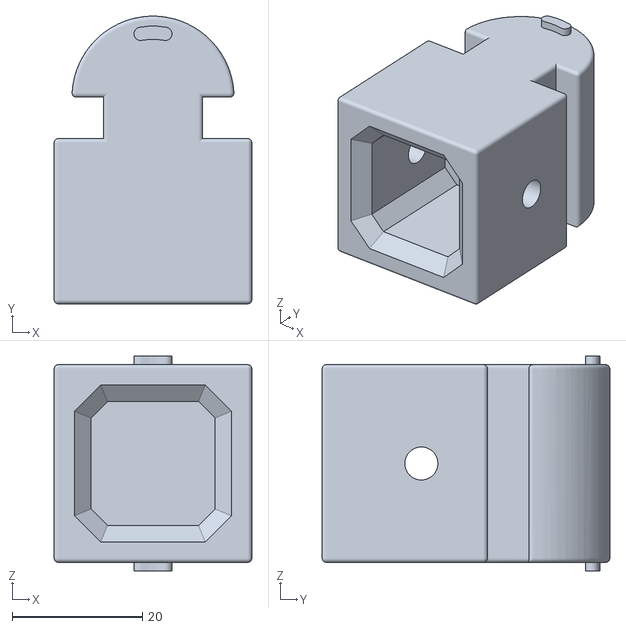
[picture p182: CAD file, 2020-09-08]
Solid_Models/Prospective_Parts/02_00_00_InternFoot/STL Files/01_ML - 01_01_01_ML-1 01_01_01_03_ML-1.STL
30.4 x 44.2 x 33.0
