Agile-and-Adaptive-Robotics/Bipedal_Robot/Solid_Models/Prospective_Parts/David Leg/RobotAssembly2019_07_01-David Femor/FemorBone_111219_V2_DP.SLDPRT

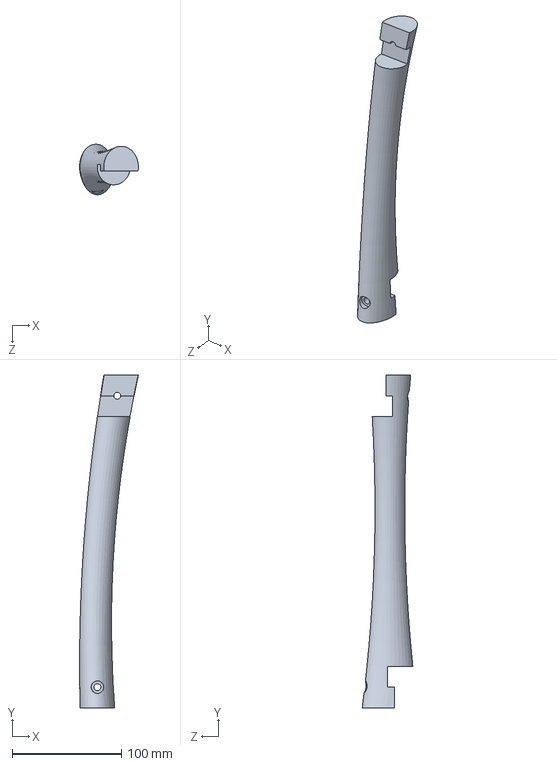
[picture p183: CAD file, 2020-09-08]
Solid_Models/Prospective_Parts/David Leg/RobotAssembly2019_07_01-David Femor/FemorBone_111219_V2_DP.SLDPRT
53.9 x 304.8 x 46.4 mm
