Agile-and-Adaptive-Robotics/Bipedal_Robot/Solid_Models/Prospective_Parts/Part4.SLDPRT

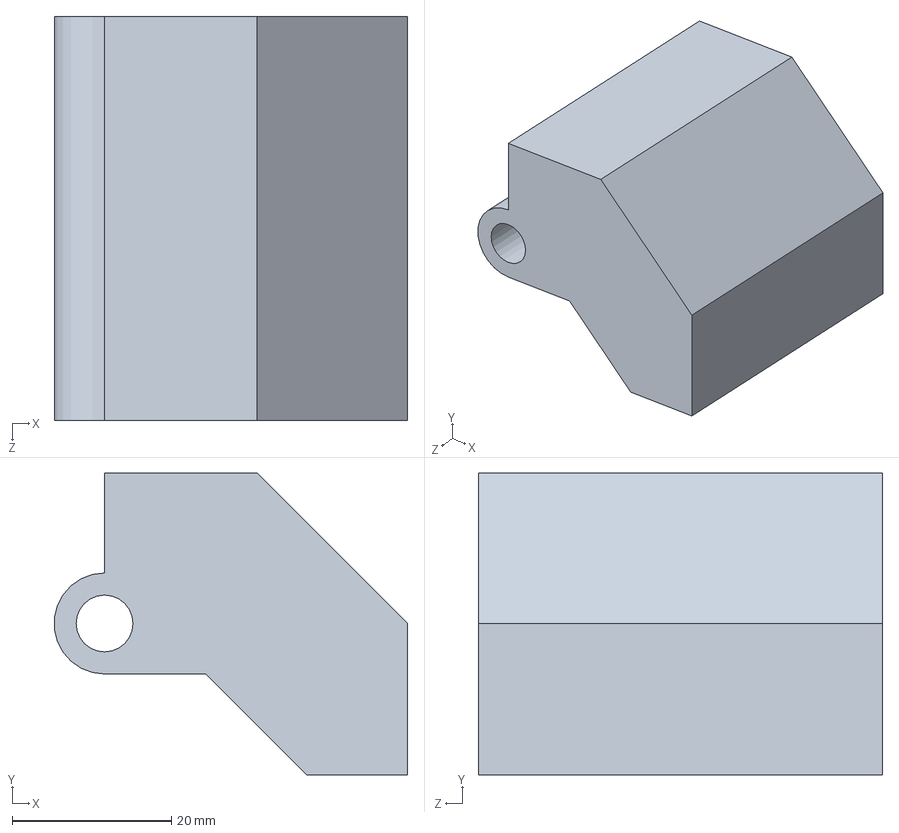
[picture p184: CAD file, 2020-09-08]
Solid_Models/Prospective_Parts/Part4.SLDPRT
44.4 x 38.0 x 50.8 mm
