Agile-and-Adaptive-Robotics/Bipedal_Robot/Solid_Models/Prospective_Parts/Tibia_Right/04_03_Tibial Rotator.SLDPRT

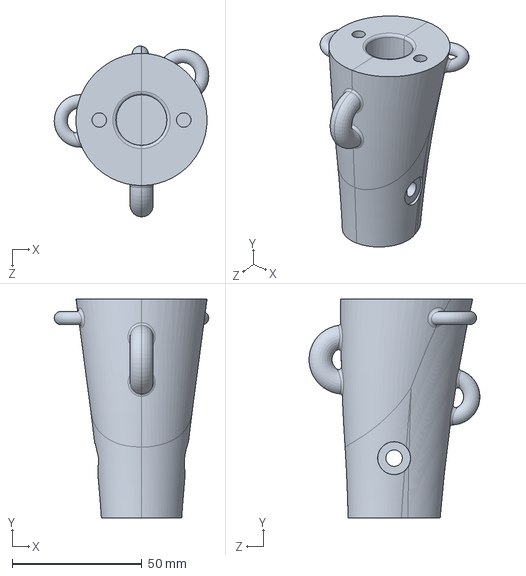
[picture p185: CAD file, 2020-09-08]
Solid_Models/Prospective_Parts/Tibia_Right/04_03_Tibial Rotator.SLDPRT
59.6 x 84.5 x 65.9 mm
