Agile-and-Adaptive-Robotics/Bipedal_Robot/Solid_Models/Prospective_Parts/Ty Ankle Foot/Foot and ankle (11-20-19)/Part 4 Ty.SLDPRT

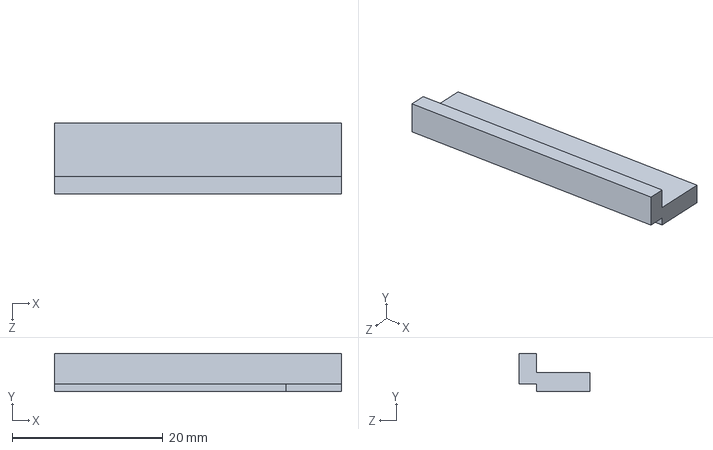
[picture p187: CAD file, 2020-06-29]
Solid_Models/Prospective_Parts/Ty Ankle Foot/Foot and ankle (11-20-19)/Part 4 Ty.SLDPRT
38.1 x 5.08 x 9.40 mm
