Agile-and-Adaptive-Robotics/Bipedal_Robot/Solid Models/Updated Robot parts with attachments/Femoral knob 011819.SLDPRT

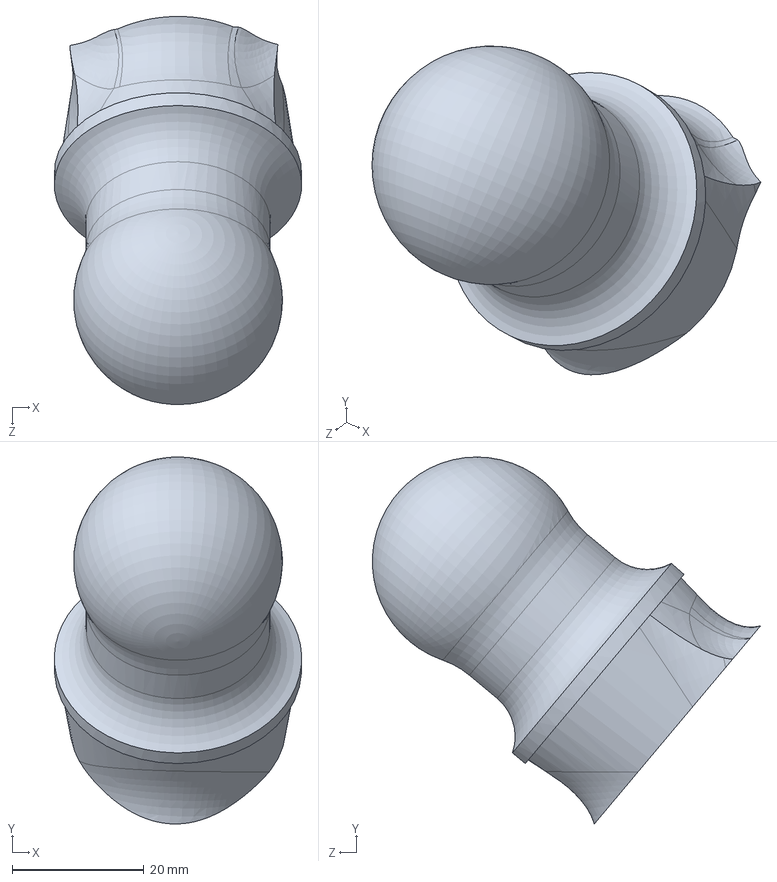
[picture p188: CAD file, 2020-06-24]
Solid Models/Updated Robot parts with attachments/Femoral knob 011819.SLDPRT
37.6 x 55.8 x 59.0 mm
