Agile-and-Adaptive-Robotics/Bipedal_Robot/Solid_Models/00_Bipedal_Robot/01_Vertebrae/01_01_L2.001.SLDPRT

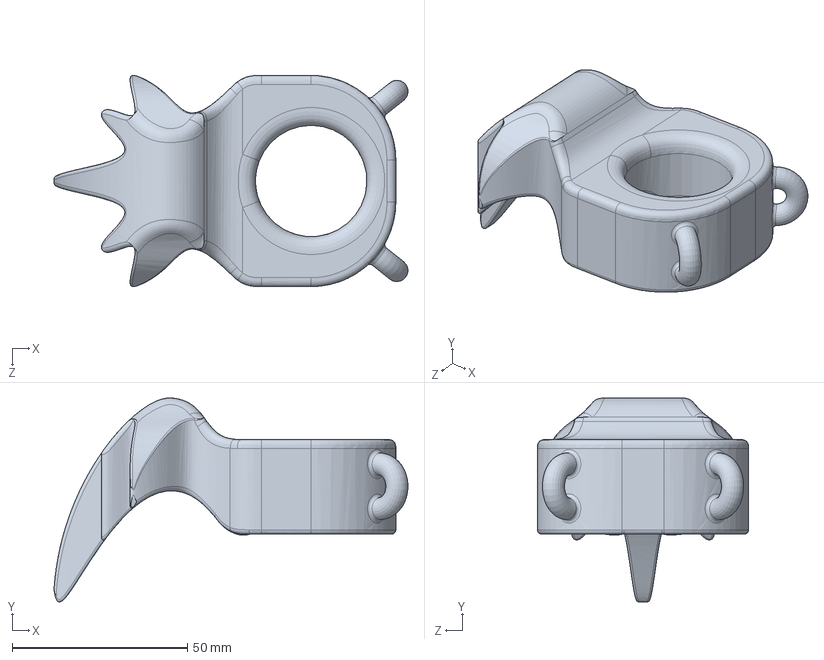
[picture p189: CAD file, 2020-09-08]
Solid_Models/00_Bipedal_Robot/01_Vertebrae/01_01_L2.001.SLDPRT
100.9 x 58.2 x 60.2 mm
