Agile-and-Adaptive-Robotics/Bipedal_Robot/Solid_Models/00_Bipedal_Robot/05_Knee_Right/05_03_PL_R_001.SLDPRT

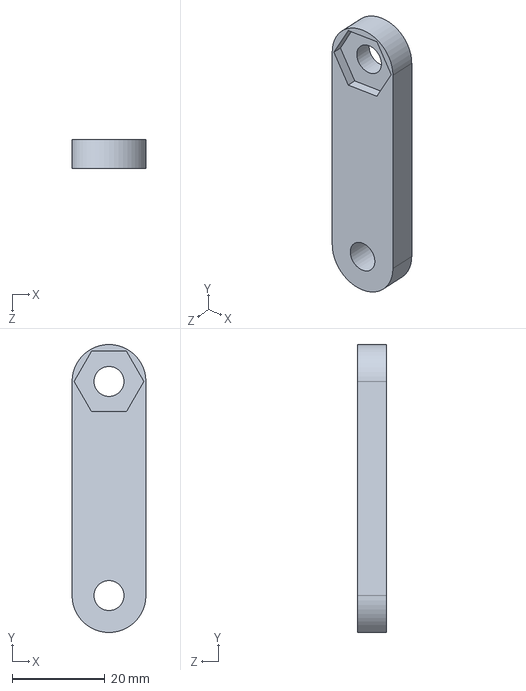
[picture p190: CAD file, 2022-02-05]
Solid_Models/00_Bipedal_Robot/05_Knee_Right/05_03_PL_R_001.SLDPRT
16.0 x 62.2 x 6.35 mm
