Agile-and-Adaptive-Robotics/Bipedal_Robot/Solid_Models/00_Bipedal_Robot/06_Knee_Left/06_02_KB_L_001.SLDPRT

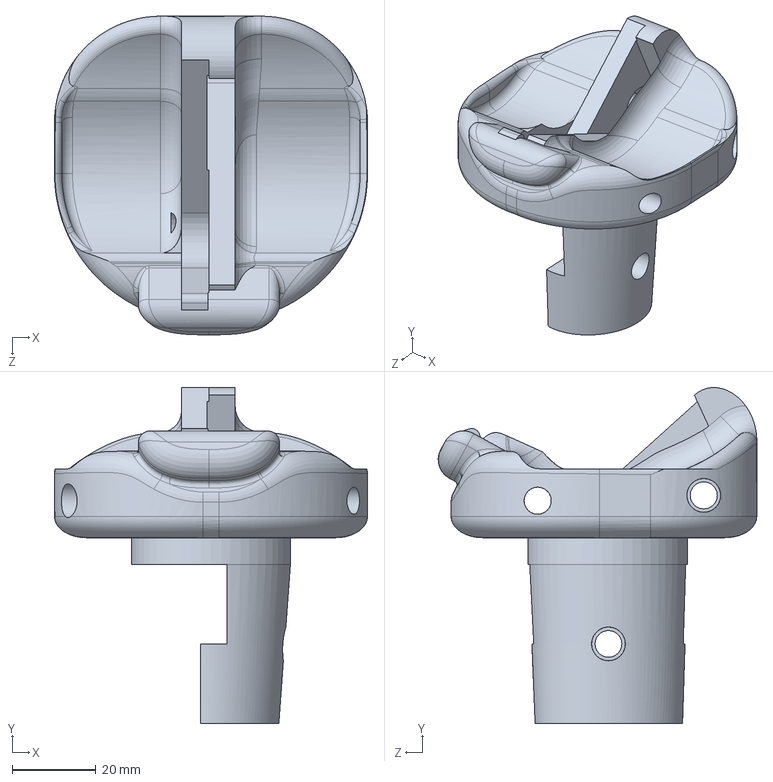
[picture p191: CAD file, 2021-06-29]
Solid_Models/00_Bipedal_Robot/06_Knee_Left/06_02_KB_L_001.SLDPRT
74.9 x 80.4 x 76.3 mm
