Agile-and-Adaptive-Robotics/Bipedal_Robot/Solid_Models/00_Bipedal_Robot/09_Foot_Right/09_05_AL_R_001.SLDPRT

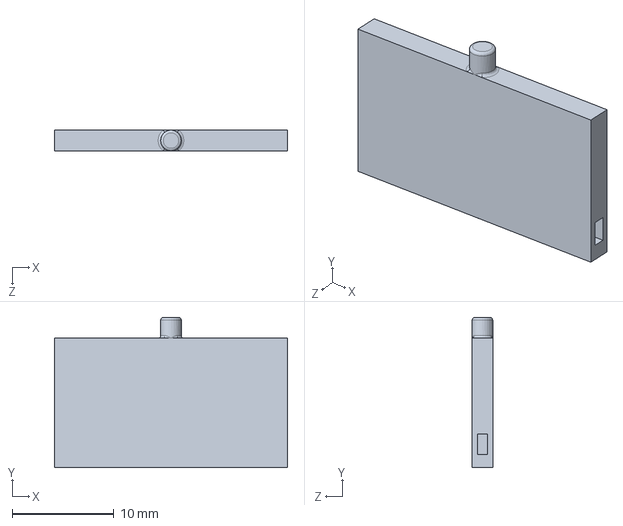
[picture p192: CAD file, 2020-09-08]
Solid_Models/00_Bipedal_Robot/09_Foot_Right/09_05_AL_R_001.SLDPRT
22.9 x 14.7 x 2.03 mm
