Agile-and-Adaptive-Robotics/Bipedal_Robot/Solid_Models/00_Bipedal_Robot/knee encoder/03_Femur/03_06_FemurHeadConnection_3dPrinted/Femoral_Head_ver1.SLDPRT

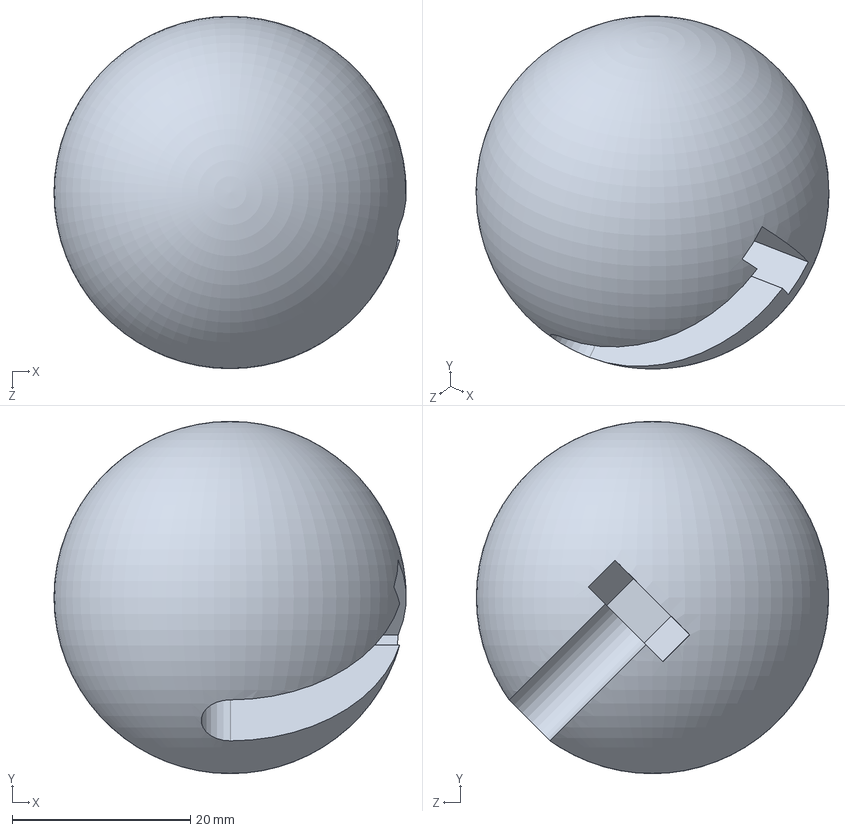
[picture p193: CAD file, 2021-10-08]
Solid_Models/00_Bipedal_Robot/knee encoder/03_Femur/03_06_FemurHeadConnection_3dPrinted/Femoral_Head_ver1.SLDPRT
39.5 x 39.5 x 39.5 mm
