Agile-and-Adaptive-Robotics/Bipedal_Robot/Solid_Models/00_BipedalRobot_Redesign/04_Knee/04_04_KB_L_001.SLDPRT

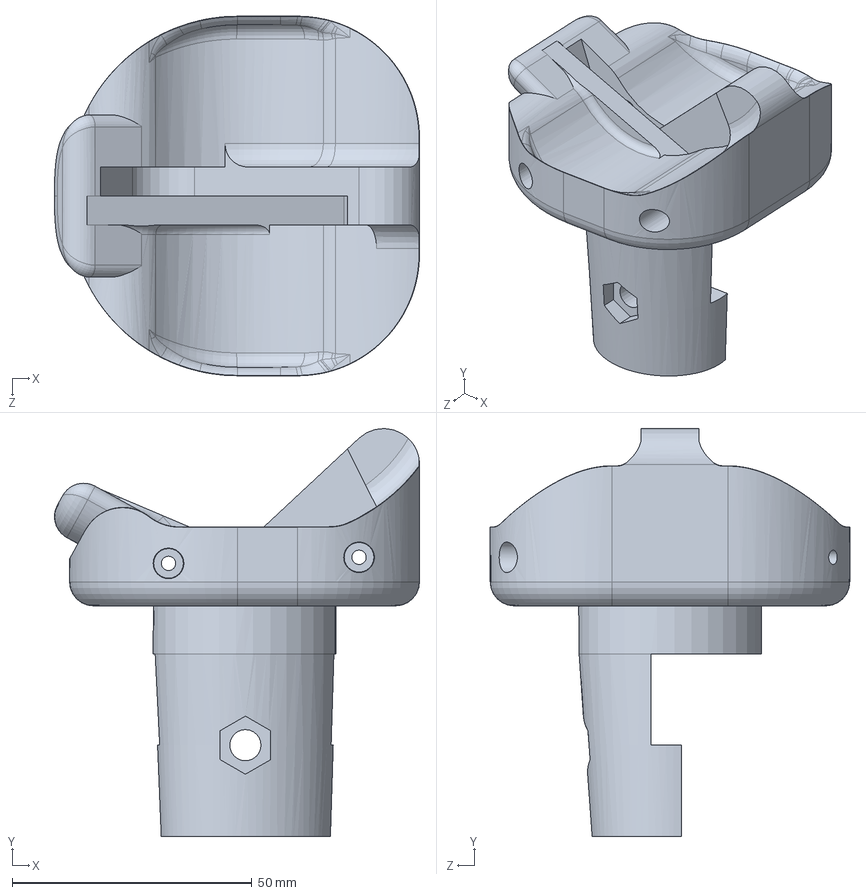
[picture p194: CAD file, 2021-10-08]
Solid_Models/00_BipedalRobot_Redesign/04_Knee/04_04_KB_L_001.SLDPRT
76.1 x 85.1 x 75.0 mm
