Agile-and-Adaptive-Robotics/Bipedal_Robot/Solid_Models/00_BipedalRobot_Redesign/11_NutHoldingTool.SLDPRT

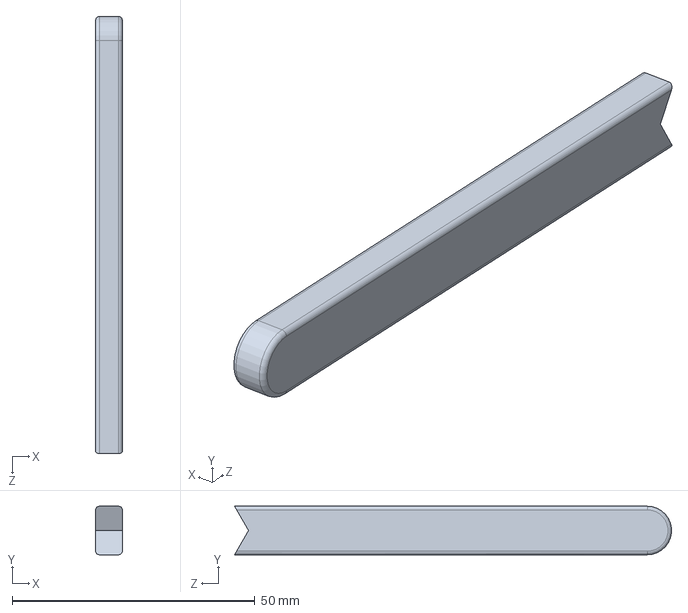
[picture p195: CAD file, 2021-10-08]
Solid_Models/00_BipedalRobot_Redesign/11_NutHoldingTool.SLDPRT
5.50 x 10.0 x 90.0 mm
