Agile-and-Adaptive-Robotics/Bipedal_Robot/Solid_Models/Biomimetics_2022-Knee_Test/AARL_Puppy_18_02_01_000-FLFE/AARL_Puppy_18_02_01_011.SLDPRT

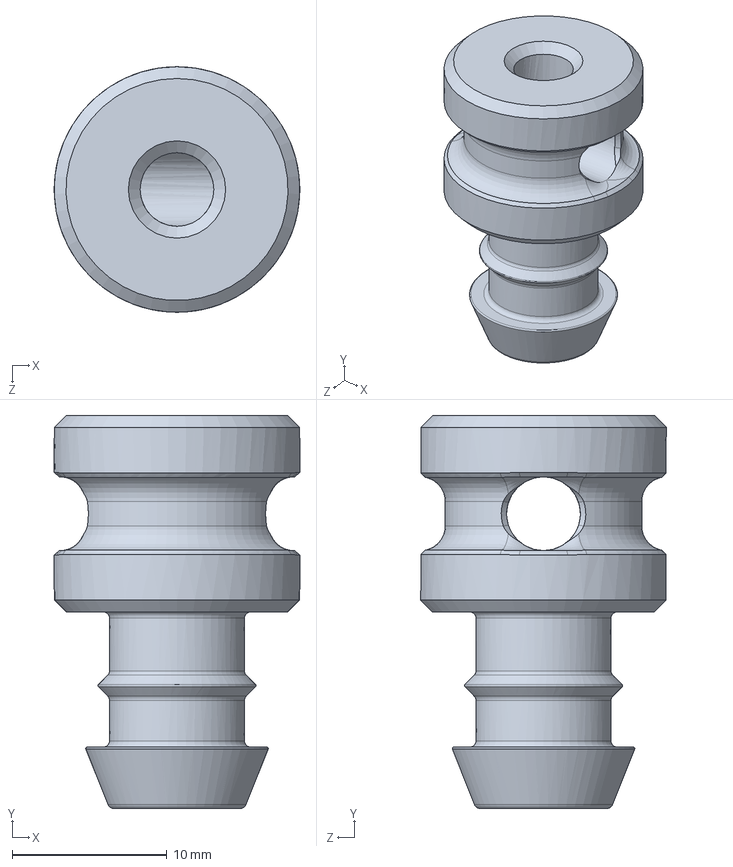
[picture p196: CAD file, 2026-01-05]
Solid_Models/Biomimetics_2022-Knee_Test/AARL_Puppy_18_02_01_000-FLFE/AARL_Puppy_18_02_01_011.SLDPRT
15.9 x 25.4 x 15.9 mm
