Agile-and-Adaptive-Robotics/Bipedal_Robot/Solid_Models/Biomimetics_2022-Knee_Test/Knee - reference/Tibial head with hardware - bone connection -Latest.SLDPRT

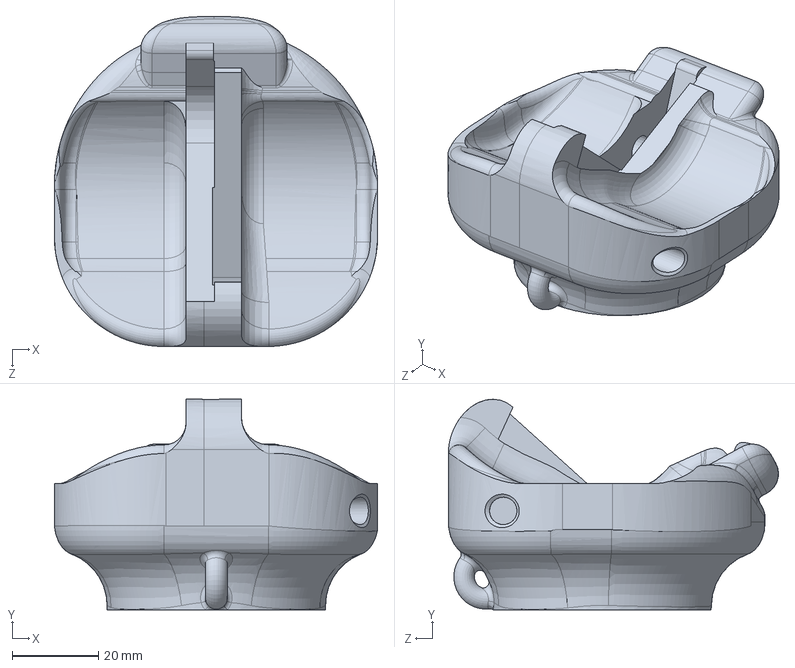
[picture p197: CAD file, 2020-10-16]
Solid_Models/Biomimetics_2022-Knee_Test/Knee - reference/Tibial head with hardware - bone connection -Latest.SLDPRT
74.8 x 48.7 x 76.3 mm
