Agile-and-Adaptive-Robotics/Bipedal_Robot/Solid_Models/Biomimetics_2022-Knee_Test/Knee assembly/Tibia.SLDPRT

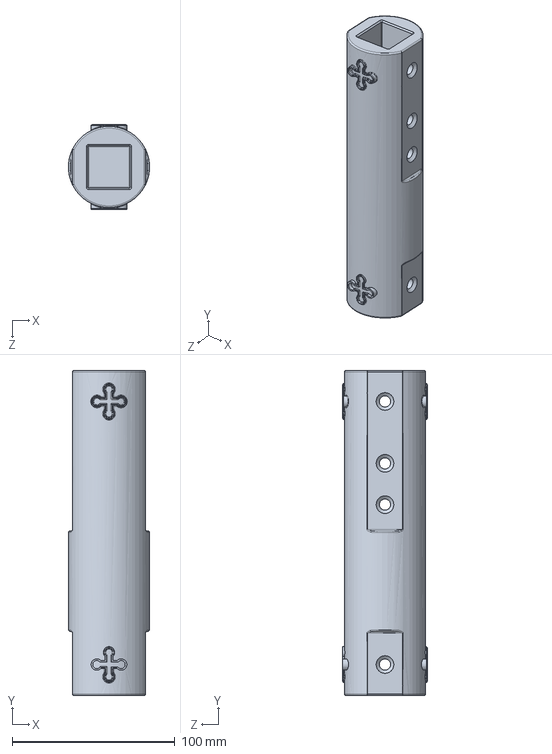
[picture p198: CAD file, 2026-01-05]
Solid_Models/Biomimetics_2022-Knee_Test/Knee assembly/Tibia.SLDPRT
49.9 x 200.0 x 52.0 mm
