Agile-and-Adaptive-Robotics/Bipedal_Robot/Solid_Models/Biomimetics_2022-Knee_Test/Reference models/Femur shaft - knee test.SLDPRT

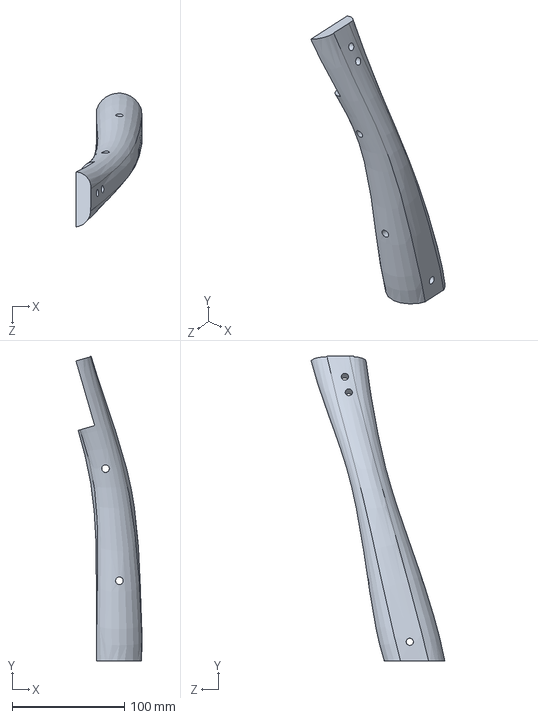
[picture p199: CAD file, 2020-11-11]
Solid_Models/Biomimetics_2022-Knee_Test/Reference models/Femur shaft - knee test.SLDPRT
59.0 x 272.1 x 119.3 mm
