Agile-and-Adaptive-Robotics/Bipedal_Robot/Solid_Models/Biomimetics_2022-Knee_Test/STL Files/03_01_FB_R_004_upper.STL

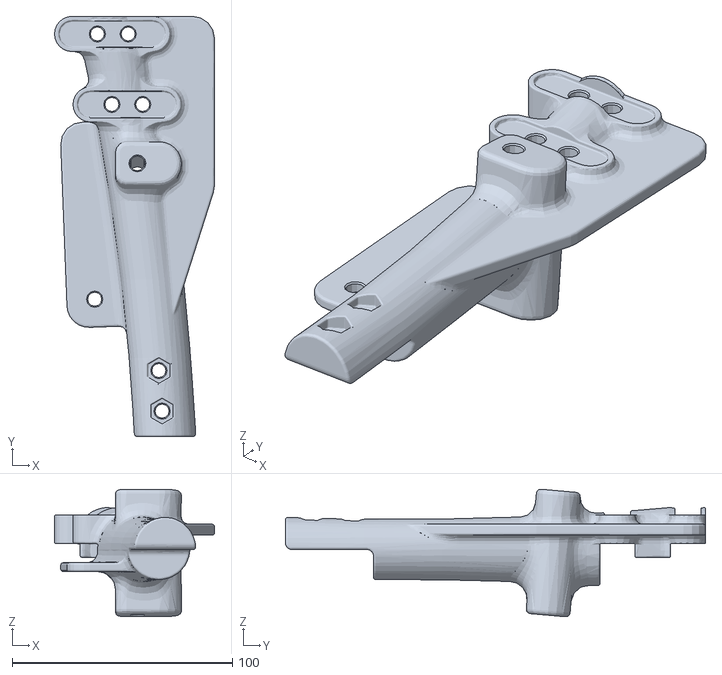
[picture p200: CAD file, 2026-01-05]
Solid_Models/Biomimetics_2022-Knee_Test/STL Files/03_01_FB_R_004_upper.STL
72.6 x 190.8 x 57.9
