Agile-and-Adaptive-Robotics/Bipedal_Robot/Solid_Models/Biomimetics_2022-Knee_Test/TAROS Knee/Split link 2.SLDPRT

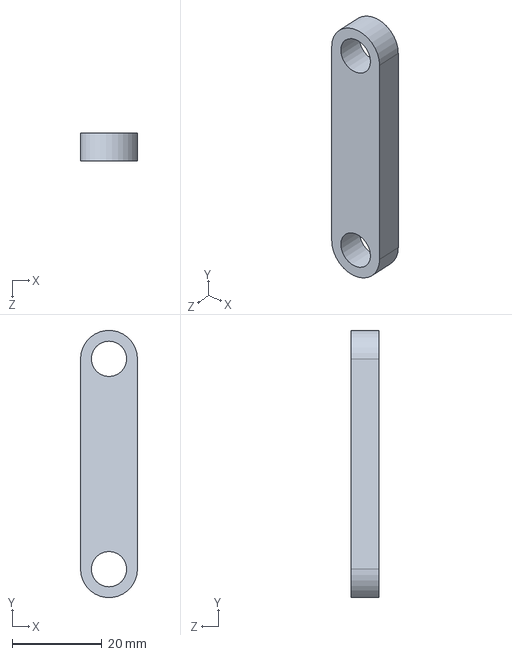
[picture p201: CAD file, 2020-11-11]
Solid_Models/Biomimetics_2022-Knee_Test/TAROS Knee/Split link 2.SLDPRT
12.7 x 59.5 x 6.35 mm
