Agile-and-Adaptive-Robotics/Bipedal_Robot/Solid_Models/Prospective_Parts/01_00_00_Foot/01_01_00_Ankle/01_01_01_06_AMiddleShell.SLDPRT

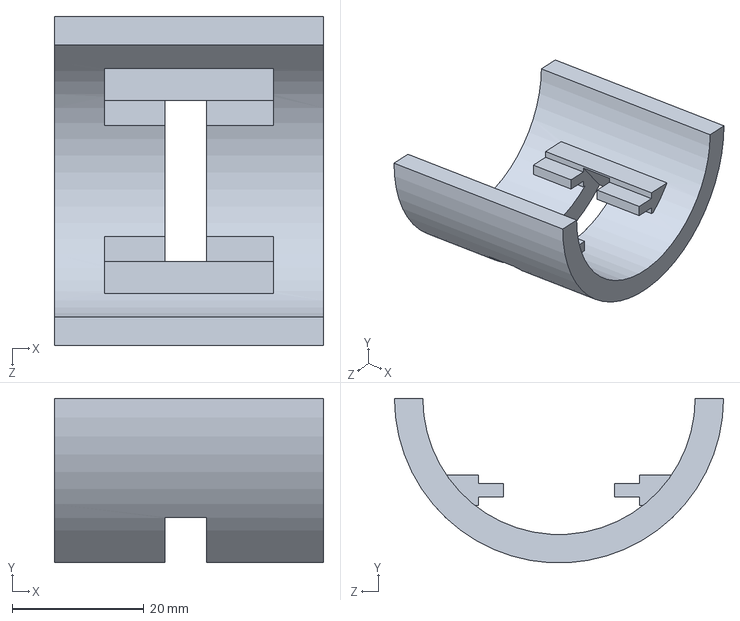
[picture p202: CAD file, 2020-07-20]
Solid_Models/Prospective_Parts/01_00_00_Foot/01_01_00_Ankle/01_01_01_06_AMiddleShell.SLDPRT
40.9 x 25.0 x 50.0 mm
