Agile-and-Adaptive-Robotics/Bipedal_Robot/Solid_Models/Prospective_Parts/02_00_00_InternFoot/01_01_00_02_ML.SLDPRT

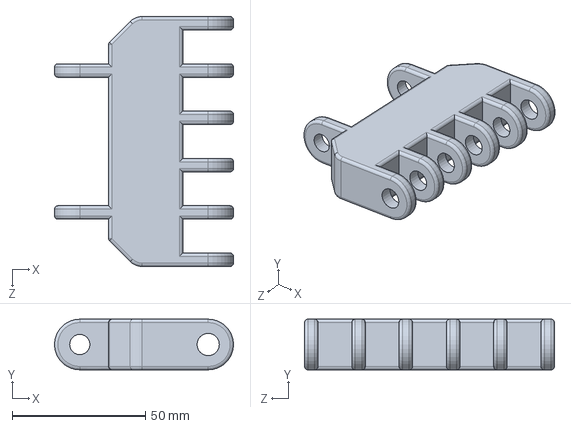
[picture p204: CAD file, 2020-09-08]
Solid_Models/Prospective_Parts/02_00_00_InternFoot/01_01_00_02_ML.SLDPRT
67.3 x 19.1 x 94.0 mm
