Agile-and-Adaptive-Robotics/Bipedal_Robot/Solid_Models/Prospective_Parts/02_00_00_InternFoot/STL Files/01_ML - 01_01_00_03_ML-1.STL

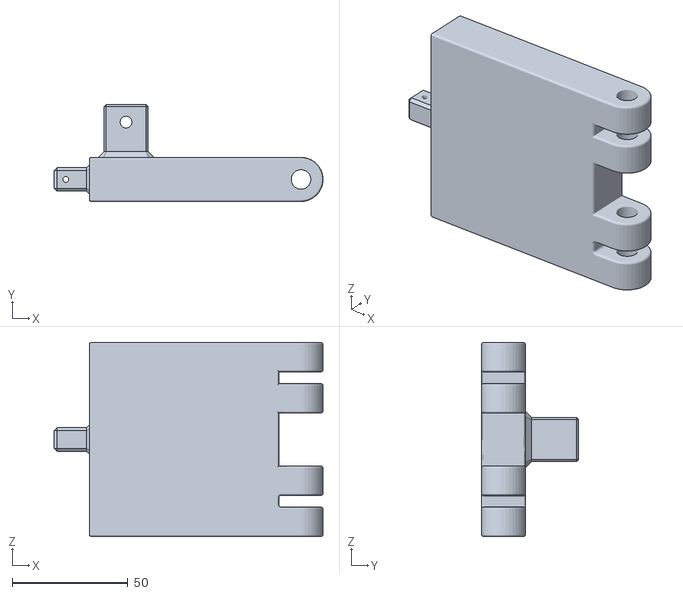
[picture p205: CAD file, 2020-09-08]
Solid_Models/Prospective_Parts/02_00_00_InternFoot/STL Files/01_ML - 01_01_00_03_ML-1.STL
116.2 x 41.9 x 83.8
