Agile-and-Adaptive-Robotics/Bipedal_Robot/Solid_Models/Prospective_Parts/David Leg/RobotAssembly2019_07_03-David Connection/FrontLinkV1.SLDPRT

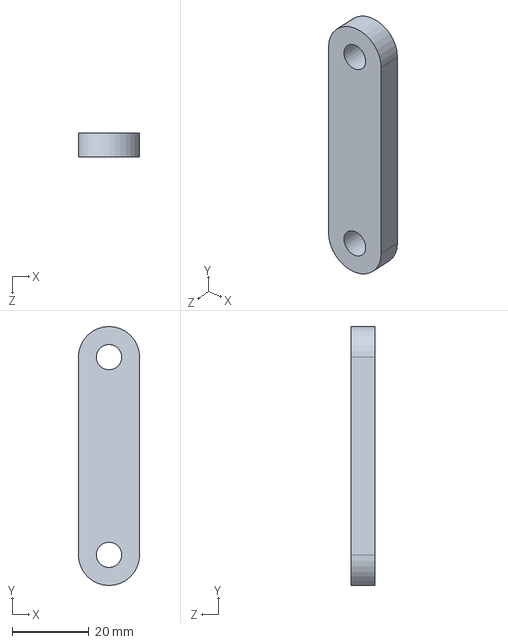
[picture p206: CAD file, 2020-09-08]
Solid_Models/Prospective_Parts/David Leg/RobotAssembly2019_07_03-David Connection/FrontLinkV1.SLDPRT
16.0 x 67.4 x 6.35 mm
