Agile-and-Adaptive-Robotics/Bipedal_Robot/Solid_Models/Prospective_Parts/Part2.SLDPRT

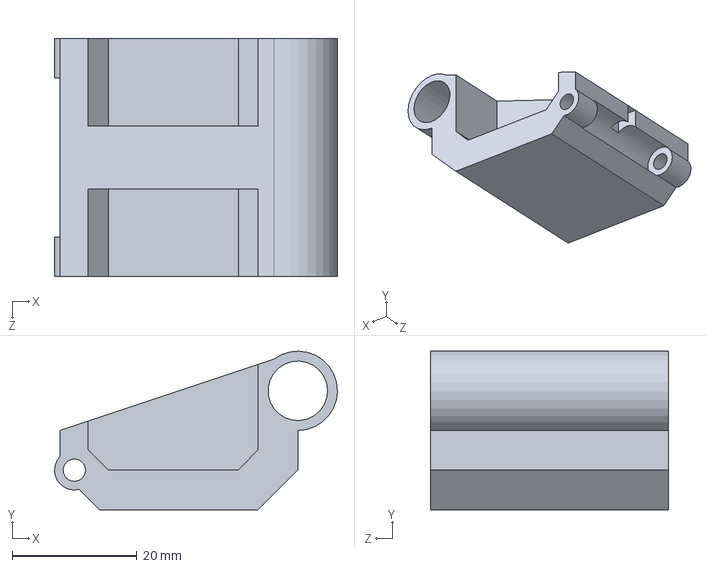
[picture p207: CAD file, 2020-09-08]
Solid_Models/Prospective_Parts/Part2.SLDPRT
45.3 x 25.4 x 38.1 mm
