Agile-and-Adaptive-Robotics/Bipedal_Robot/Solid_Models/Prospective_Parts/Tibia_Right/04_07_Tibial End Mirrored.SLDPRT

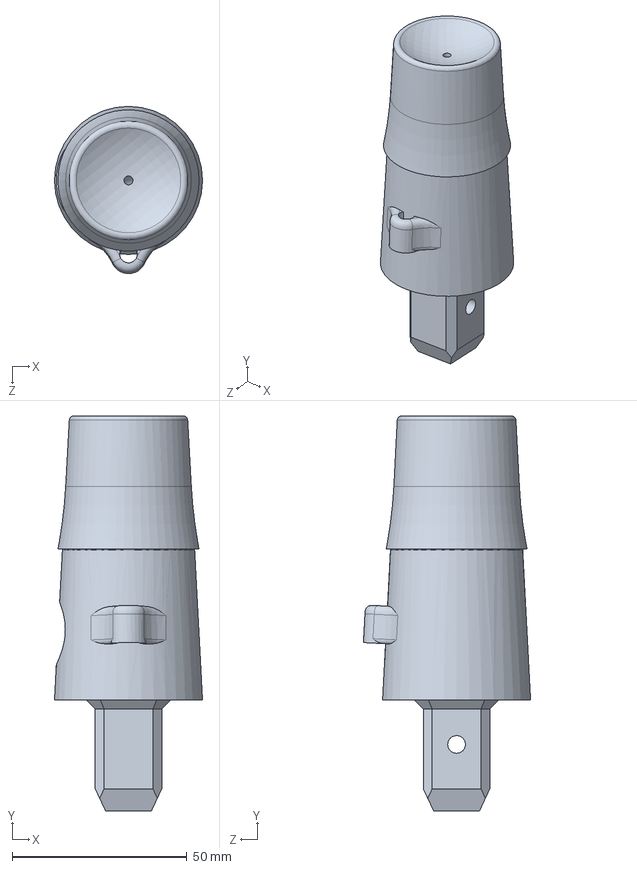
[picture p208: CAD file, 2020-09-08]
Solid_Models/Prospective_Parts/Tibia_Right/04_07_Tibial End Mirrored.SLDPRT
42.4 x 113.1 x 47.9 mm
