Agile-and-Adaptive-Robotics/Bipedal_Robot/Solid_Models/Prospective_Parts/Ty Ankle Foot/Foot and ankle (11-20-19)/small axle.SLDPRT

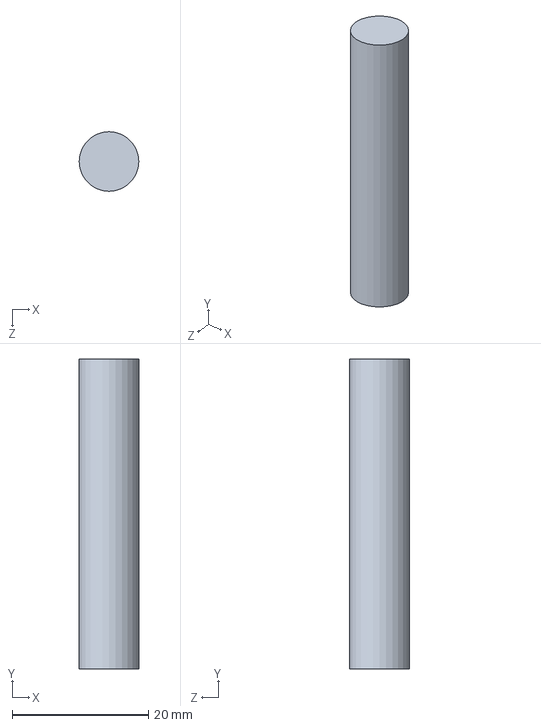
[picture p210: CAD file, 2020-06-29]
Solid_Models/Prospective_Parts/Ty Ankle Foot/Foot and ankle (11-20-19)/small axle.SLDPRT
8.76 x 45.5 x 8.76 mm
