Agile-and-Adaptive-Robotics/Bipedal_Robot/Solid_Models/Prospective_Parts/Ty Ankle Foot/Foot and Ankle Design, Newest (7-17-20)/New foot - Copy - Copy.SLDPRT

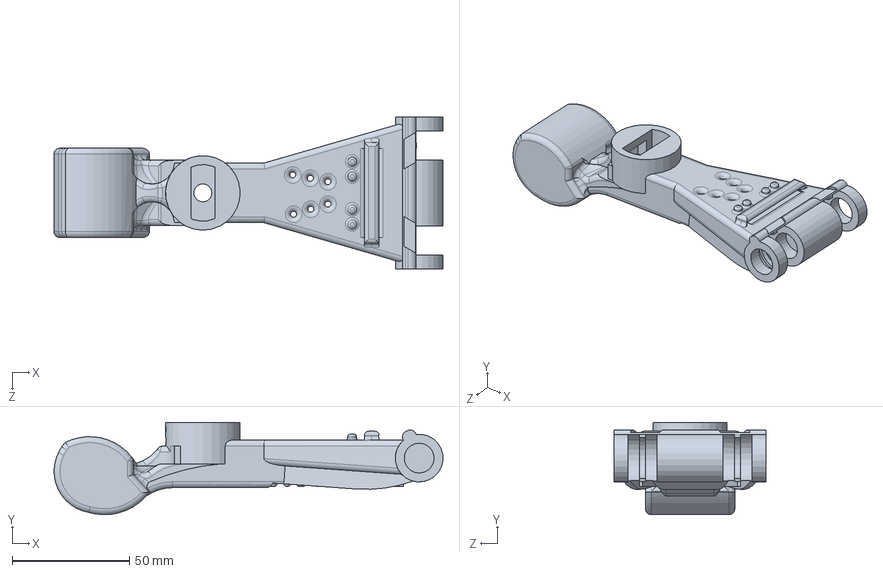
[picture p211: CAD file, 2020-09-08]
Solid_Models/Prospective_Parts/Ty Ankle Foot/Foot and Ankle Design, Newest (7-17-20)/New foot - Copy - Copy.SLDPRT
165.6 x 39.3 x 64.9 mm
