Agile-and-Adaptive-Robotics/Bipedal_Robot/Solid_Models/00_Bipedal_Robot/09_Foot_Right/09_09_PH_R_001.SLDPRT

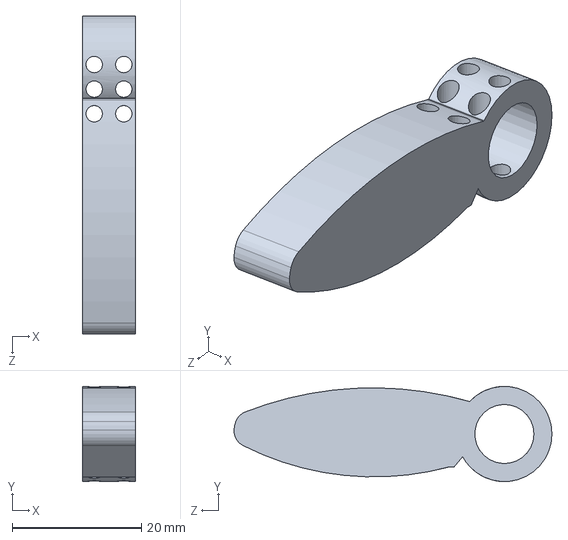
[picture p213: CAD file, 2020-09-08]
Solid_Models/00_Bipedal_Robot/09_Foot_Right/09_09_PH_R_001.SLDPRT
8.13 x 14.7 x 49.2 mm
