Agile-and-Adaptive-Robotics/Bipedal_Robot/Solid_Models/00_Bipedal_Robot/knee encoder/03_Femur/03_01_FemurBone_Right.SLDPRT

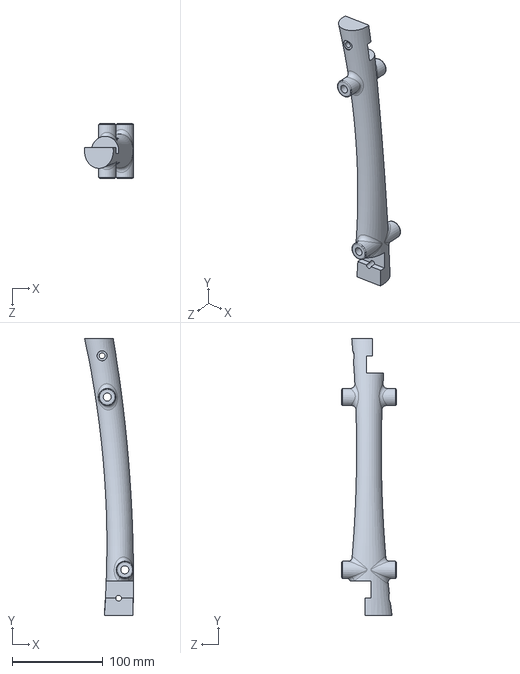
[picture p214: CAD file, 2022-02-05]
Solid_Models/00_Bipedal_Robot/knee encoder/03_Femur/03_01_FemurBone_Right.SLDPRT
53.9 x 304.8 x 60.0 mm
