Agile-and-Adaptive-Robotics/Bipedal_Robot/Solid_Models/00_Bipedal_Robot/knee encoder/04_Knee/04_06_FrontLink.SLDPRT

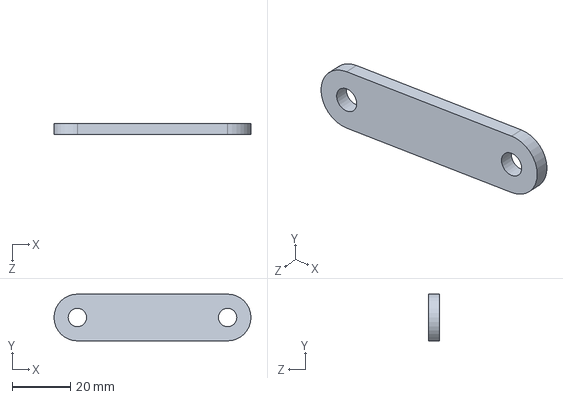
[picture p215: CAD file, 2022-02-05]
Solid_Models/00_Bipedal_Robot/knee encoder/04_Knee/04_06_FrontLink.SLDPRT
67.4 x 16.0 x 3.90 mm
