Agile-and-Adaptive-Robotics/Bipedal_Robot/Solid_Models/Biomimetics_2022-Knee_Test/AARL_Puppy_18_02_01_000-FLFE/AARL_Puppy_18_02_01_009-5388K140_Hose-Clamp.SLDPRT

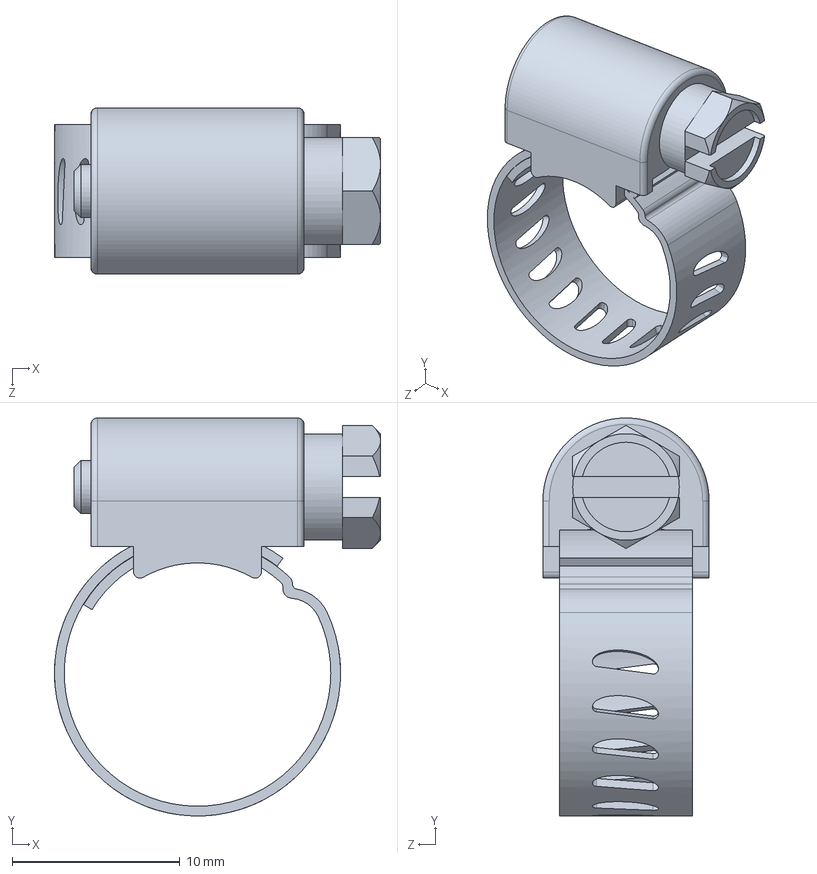
[picture p216: CAD file, 2026-01-05]
Solid_Models/Biomimetics_2022-Knee_Test/AARL_Puppy_18_02_01_000-FLFE/AARL_Puppy_18_02_01_009-5388K140_Hose-Clamp.SLDPRT
19.4 x 23.7 x 9.91 mm
