Agile-and-Adaptive-Robotics/Bipedal_Robot/Solid_Models/Biomimetics_2022-Knee_Test/Knee assembly/03_01_FB_R_003.SLDPRT

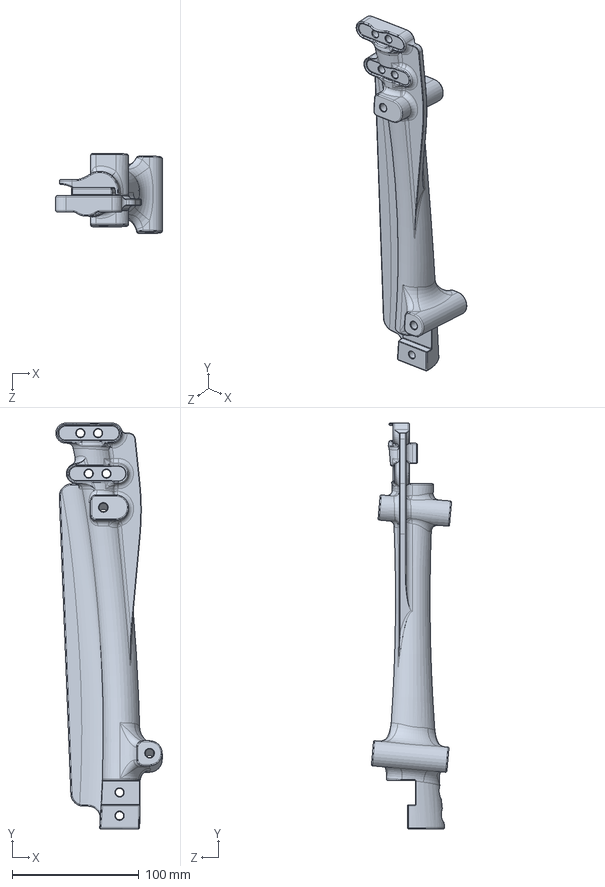
[picture p217: CAD file, 2026-01-05]
Solid_Models/Biomimetics_2022-Knee_Test/Knee assembly/03_01_FB_R_003.SLDPRT
84.2 x 320.8 x 63.3 mm
