Agile-and-Adaptive-Robotics/Bipedal_Robot/Solid_Models/Biomimetics_2022-Knee_Test/Reference models/ball3.SLDPRT

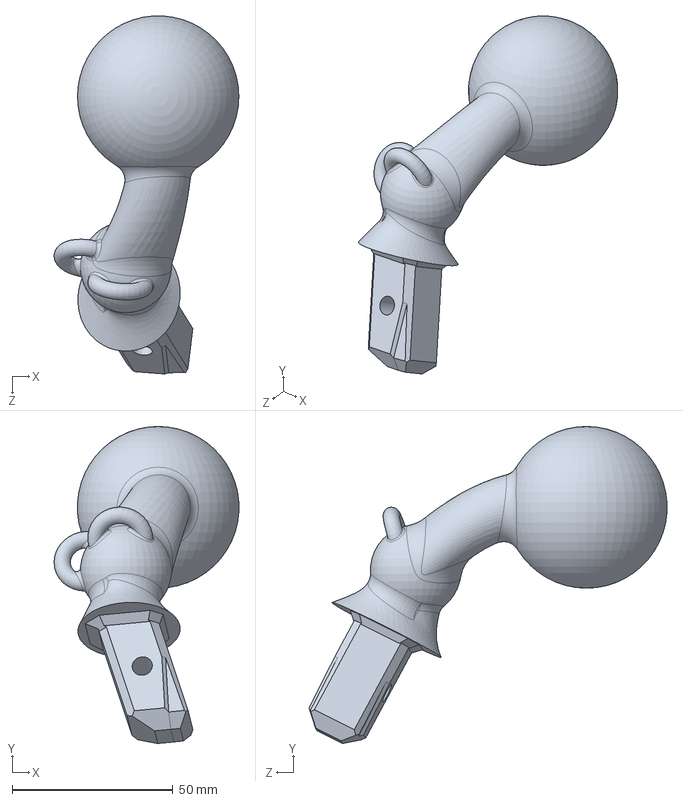
[picture p218: CAD file, 2020-11-11]
Solid_Models/Biomimetics_2022-Knee_Test/Reference models/ball3.SLDPRT
57.5 x 98.6 x 111.3 mm
