Agile-and-Adaptive-Robotics/Bipedal_Robot/Solid_Models/Biomimetics_2022-Knee_Test/TAROS Knee/Femoral end with hardware - bone connection.SLDPRT

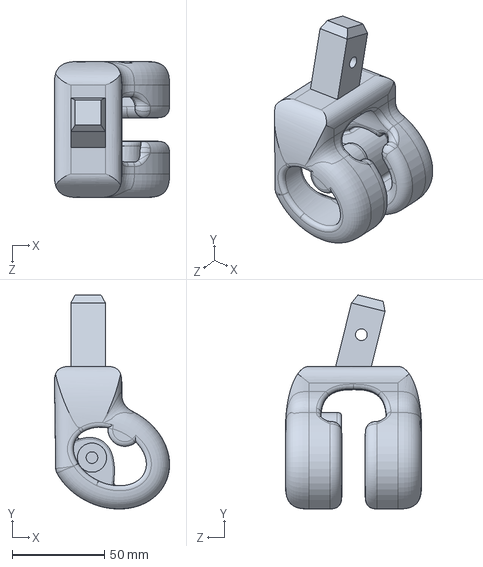
[picture p219: CAD file, 2020-11-11]
Solid_Models/Biomimetics_2022-Knee_Test/TAROS Knee/Femoral end with hardware - bone connection.SLDPRT
62.4 x 116.0 x 73.7 mm
