Agile-and-Adaptive-Robotics/Bipedal_Robot/Solid_Models/Biomimetics_2022-Knee_Test/Test_Jig/McCarr_Pulley_0.5inD.SLDPRT

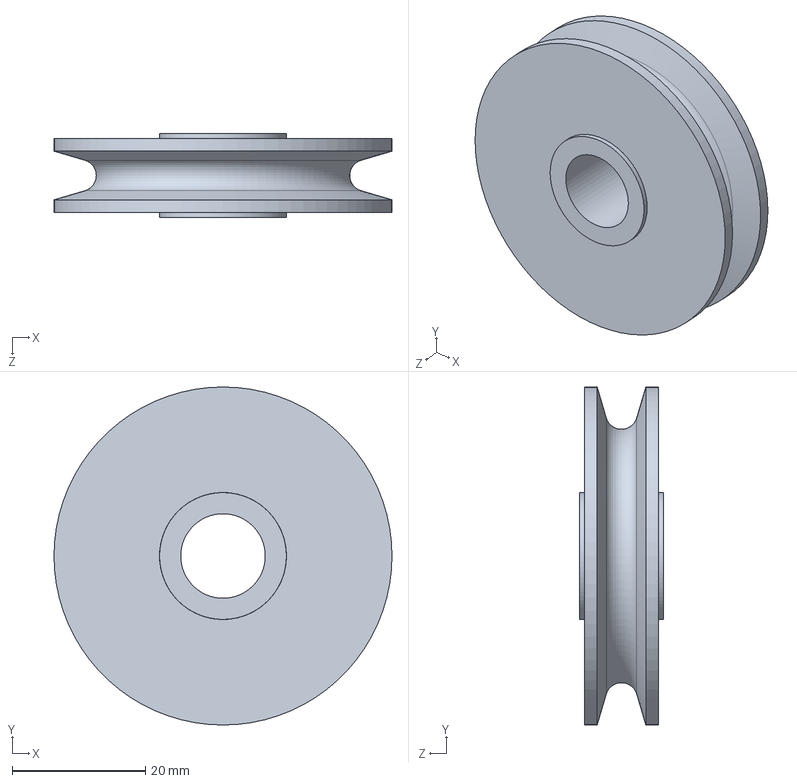
[picture p220: CAD file, 2026-01-05]
Solid_Models/Biomimetics_2022-Knee_Test/Test_Jig/McCarr_Pulley_0.5inD.SLDPRT
50.8 x 50.8 x 12.7 mm
