Agile-and-Adaptive-Robotics/Bipedal_Robot/Solid_Models/Prospective_Parts/01_00_00_Foot/01_01_00_Ankle/01_01_01_02_AExterior.SLDPRT

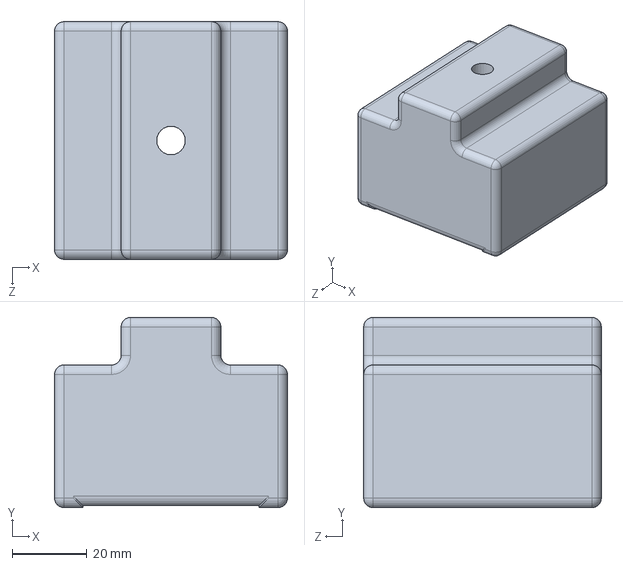
[picture p221: CAD file, 2020-07-20]
Solid_Models/Prospective_Parts/01_00_00_Foot/01_01_00_Ankle/01_01_01_02_AExterior.SLDPRT
62.2 x 50.8 x 63.5 mm
