Agile-and-Adaptive-Robotics/Bipedal_Robot/Solid_Models/Prospective_Parts/01_00_00_Foot/01_02_00_Foot/01_01_02_02_FTLock.SLDPRT

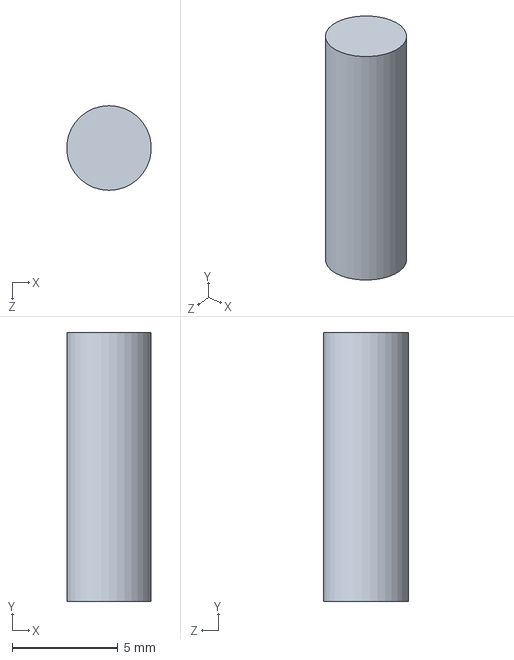
[picture p222: CAD file, 2020-07-20]
Solid_Models/Prospective_Parts/01_00_00_Foot/01_02_00_Foot/01_01_02_02_FTLock.SLDPRT
3.98 x 12.7 x 4.00 mm
