Agile-and-Adaptive-Robotics/Bipedal_Robot/Solid_Models/Prospective_Parts/02_00_00_InternFoot/STL Files/01_ML - 01_01_00_01_ML-4.STL

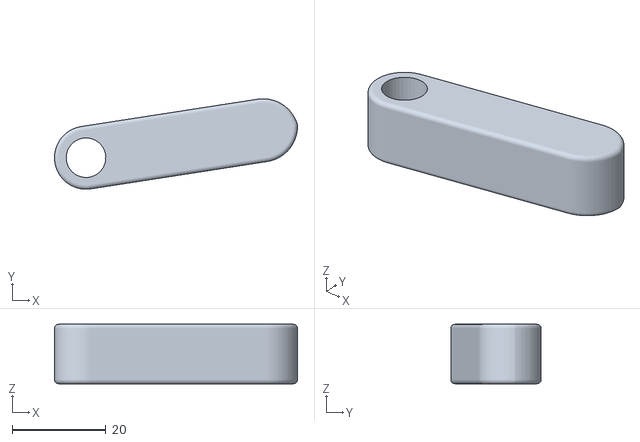
[picture p223: CAD file, 2020-09-08]
Solid_Models/Prospective_Parts/02_00_00_InternFoot/STL Files/01_ML - 01_01_00_01_ML-4.STL
51.9 x 19.3 x 12.7
