Agile-and-Adaptive-Robotics/Bipedal_Robot/Solid_Models/Prospective_Parts/David Leg/RobotAssembly2019_07_01-David Femor/RedoneFemoralHead.SLDPRT

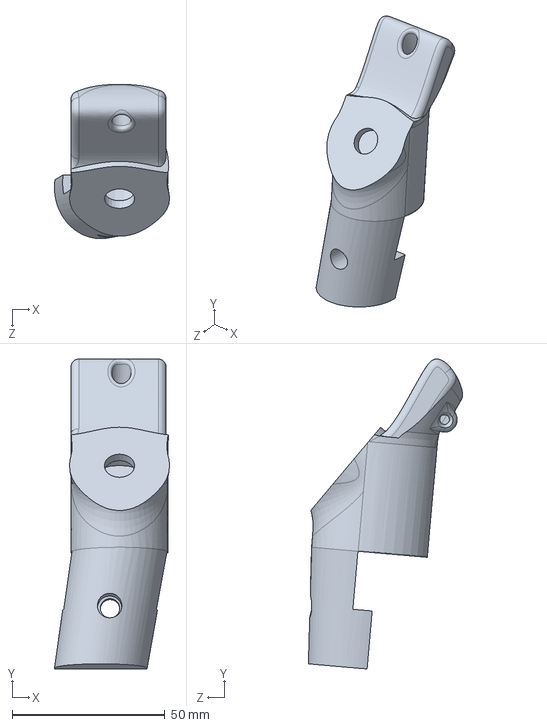
[picture p224: CAD file, 2020-09-08]
Solid_Models/Prospective_Parts/David Leg/RobotAssembly2019_07_01-David Femor/RedoneFemoralHead.SLDPRT
37.7 x 101.4 x 50.5 mm
