Agile-and-Adaptive-Robotics/Bipedal_Robot/Solid_Models/Prospective_Parts/Part3.SLDPRT

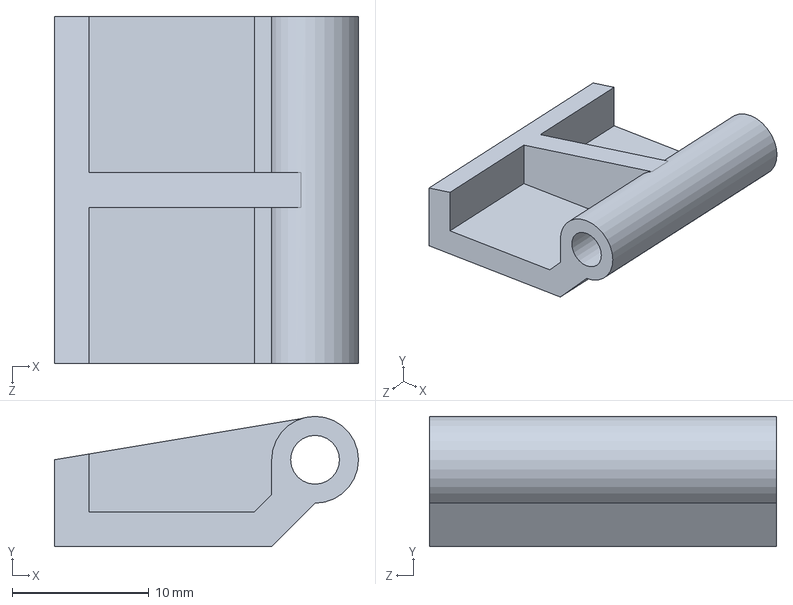
[picture p226: CAD file, 2020-09-08]
Solid_Models/Prospective_Parts/Part3.SLDPRT
22.2 x 9.52 x 25.4 mm
