Agile-and-Adaptive-Robotics/Bipedal_Robot/Solid_Models/Prospective_Parts/Tibia_Right/04_02_Tibial Head Mirrored.SLDPRT

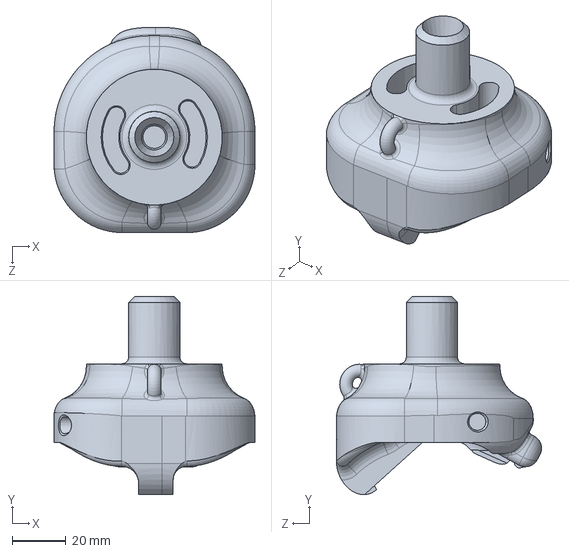
[picture p227: CAD file, 2020-09-08]
Solid_Models/Prospective_Parts/Tibia_Right/04_02_Tibial Head Mirrored.SLDPRT
74.8 x 73.8 x 76.3 mm
