Agile-and-Adaptive-Robotics/Bipedal_Robot/Solid_Models/00_Bipedal_Robot/01_Vertebrae/01_02_L4_001.SLDPRT

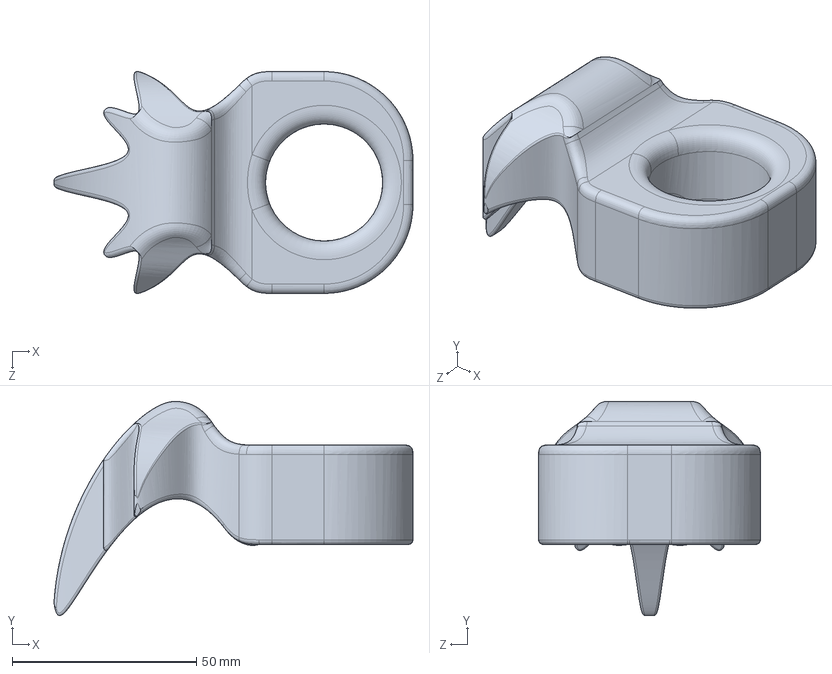
[picture p229: CAD file, 2020-09-08]
Solid_Models/00_Bipedal_Robot/01_Vertebrae/01_02_L4_001.SLDPRT
97.5 x 58.1 x 60.2 mm
