Agile-and-Adaptive-Robotics/Bipedal_Robot/Solid_Models/00_Bipedal_Robot/01_Vertebrae/01_Spine.SLDASM

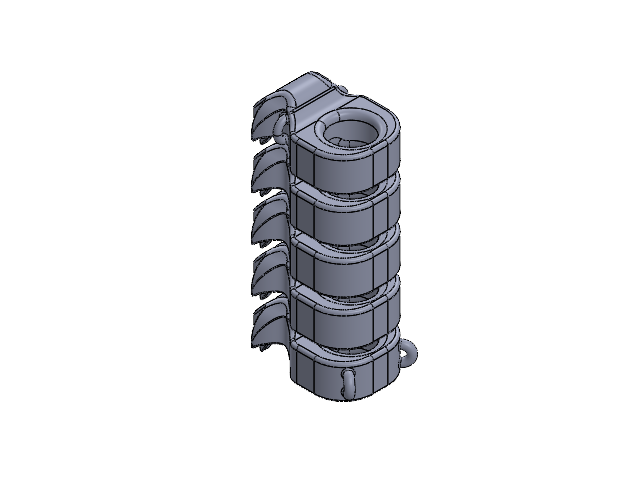
[picture p230: CAD file, 2021-06-29]
Solid_Models/00_Bipedal_Robot/01_Vertebrae/01_Spine.SLDASM
01_01_L2.001
01_02_L4_001 x 4
