Agile-and-Adaptive-Robotics/Bipedal_Robot/Solid_Models/00_Bipedal_Robot/03_Femur_Right/03_Femur_Right.SLDASM

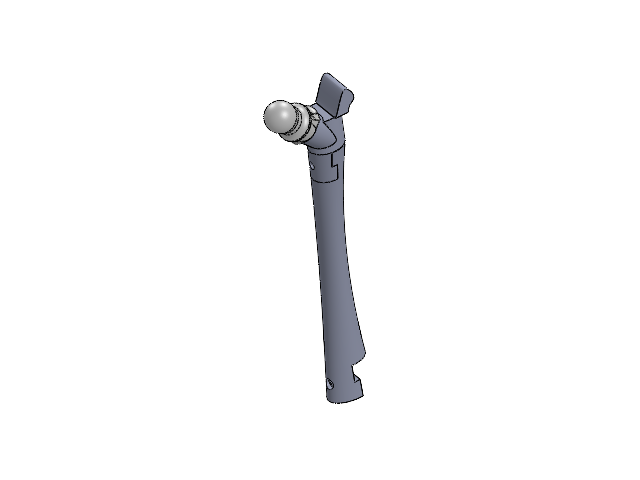
[picture p231: CAD file, 2021-10-08]
Solid_Models/00_Bipedal_Robot/03_Femur_Right/03_Femur_Right.SLDASM
03_01_FK_R_001
03_02_FH_R_001
03_03_FE_R_001
