Agile-and-Adaptive-Robotics/Bipedal_Robot/Solid_Models/00_Bipedal_Robot/06_Knee_Left/06_Knee_Left.SLDASM

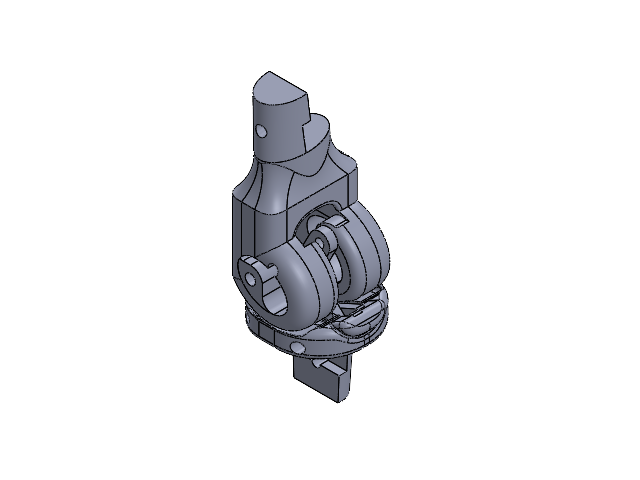
[picture p232: CAD file, 2021-06-29]
Solid_Models/00_Bipedal_Robot/06_Knee_Left/06_Knee_Left.SLDASM
06_01_KT_L_001
06_02_KB_L_001
06_03_PL_L_001
06_04_AL_L_001
