Agile-and-Adaptive-Robotics/Bipedal_Robot/Solid_Models/00_Bipedal_Robot/09_Foot_Right/09_Foot_Ankle.SLDASM

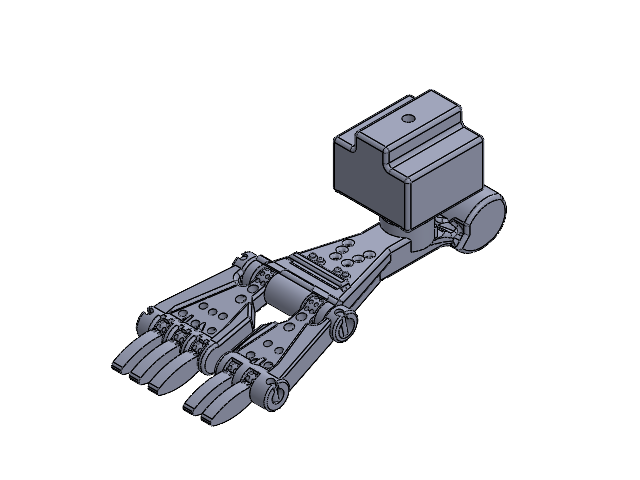
[picture p233: CAD file, 2021-06-29]
Solid_Models/00_Bipedal_Robot/09_Foot_Right/09_Foot_Ankle.SLDASM
09_01_AE_R_001
09_02_AM_R_001
09_03_AI_R_001
09_04_AB_R_001
09_06_FT_R_001
09_07_MM_R_001
09_08_LM_R_001
09_09_PH_R_001 x 5
09_14_ML_R_001 x 2
09_13_LA_R_001
09_10_TA_R_001 x 2
09_11_TL_R_001 x 2
09_12_MA_R_001
09_05_AL_R_001
09_15_FL_R_001
