Agile-and-Adaptive-Robotics/Bipedal_Robot/Solid_Models/00_Bipedal_Robot/10_Foot_Left/10_Foot_Left.SLDASM

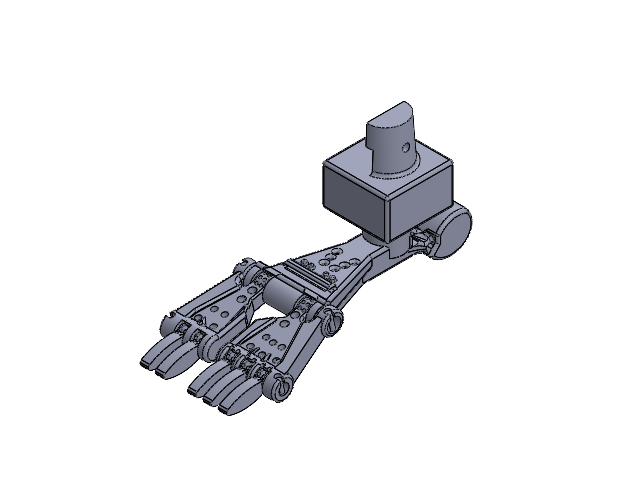
[picture p234: CAD file, 2021-10-08]
Solid_Models/00_Bipedal_Robot/10_Foot_Left/10_Foot_Left.SLDASM
10_01_AE_L_001
10_02_AM_L_001
10_03_AI_L_001
10_04_AB_L_001
10_05_AL_L_001
10_06_FT_L_001
10_07_MM_L_001
10_08_LM_L_001
10_09_PH_L_001 x 5
10_10_TA_L_001 x 2
10_11_TL_L_001 x 2
10_12_MA_L_001
10_13_LA_L_001
10_14_ML_L_001 x 2
10_15_FL_L_001
