Agile-and-Adaptive-Robotics/Bipedal_Robot/Solid_Models/00_Bipedal_Robot/05_Knee_Right/05_Knee_Right.SLDASM

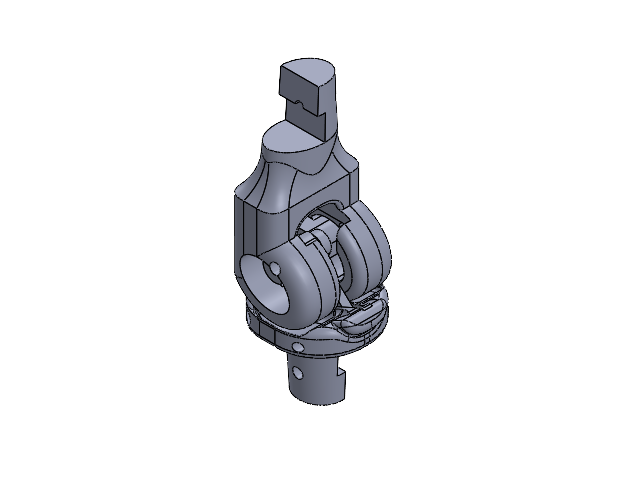
[picture p235: CAD file, 2021-06-29]
Solid_Models/00_Bipedal_Robot/05_Knee_Right/05_Knee_Right.SLDASM
05_01_KT_R_001
05_02_KB_R_001
05_03_PL_R_001
05_04_AL_R_001
