Agile-and-Adaptive-Robotics/Bipedal_Robot/(list of files, cad)

Other CAD files:
Solid_Models/00_Bipedal_Robot/knee encoder/09_BipedalRobot_Assembly.SLDASM
Solid_Models/00_BipedalRobot_Redesign/02_Pelvis/02_11_PA_001.SLDASM
Solid_Models/Prospective_Parts/Ty Ankle Foot/Foot and Ankle Design, Newest (7-17-20)/Foot Ankle.SLDASM
Solid_Models/00_Bipedal_Robot/08_Tibia_Left/08_TI_L_001.SLDPRT
Solid_Models/00_Bipedal_Robot/knee encoder/02_Pelvis/02_08_Ilium_Front_Left.SLDPRT
Solid_Models/00_Bipedal_Robot/knee encoder/02_Pelvis/02_11_XYZPoints/OpenSimXYZpoints_right_Ilium.SLDPRT
Solid_Models/00_Bipedal_Robot/knee encoder/Part3.SLDPRT
Solid_Models/00_BipedalRobot_Redesign/02_Pelvis/02_03_IB_R_001.SLDPRT
Solid_Models/00_BipedalRobot_Redesign/02_Pelvis/02_11_XYZPoints/SacrumXYZPoints.SLDPRT
Solid_Models/00_BipedalRobot_Redesign/03_Femur/03_04_FH_L_001.SLDPRT
Solid_Models/00_BipedalRobot_Redesign/04_Knee/04_01_KT_R_001.SLDPRT
Solid_Models/00_BipedalRobot_Redesign/05_Tibia/05_01_TI_R_001.SLDPRT
Solid_Models/Prospective_Parts/David Leg/RobotAssembly2019_07_02-David Tibia/Tibial_011020_V2_DP.SLDPRT
Solid_Models/00_Bipedal_Robot/03_Femur_Right/03_03_FE_R_001.SLDPRT
Solid_Models/00_Bipedal_Robot/knee encoder/02_Pelvis/02_03_Ilium_Back_Right.SLDPRT
Solid_Models/00_Bipedal_Robot/knee encoder/02_Pelvis/02_11_XYZPoints/SacrumXYZPoints.SLDPRT
Solid_Models/00_Bipedal_Robot/knee encoder/03_Femur/03_03_FemurBone_Left.SLDPRT
Solid_Models/00_Bipedal_Robot/knee encoder/04_Knee/04_03_KneeTop_Left.SLDPRT
Solid_Models/00_Bipedal_Robot/knee encoder/05_Tibia/05_02_Tibial_Left.SLDPRT
Solid_Models/00_Bipedal_Robot/knee encoder/Part4.SLDPRT
Solid_Models/00_BipedalRobot_Redesign/02_Pelvis/02_08_IF_L_001.SLDPRT
Solid_Models/00_BipedalRobot_Redesign/02_Pelvis/02_11_XYZPoints/OpenSimXYZpoints_right_Ilium.SLDPRT
Solid_Models/00_BipedalRobot_Redesign/03_Femur/03_03_FB_L_001.SLDPRT
Solid_Models/00_BipedalRobot_Redesign/05_Tibia/05_02_TI_001.SLDPRT
Solid_Models/Prospective_Parts/David Leg/RobotAssembly2019_07_01-David Femor/FemoralHead_010620_V1_DP.SLDPRT
Solid_Models/Prospective_Parts/David Leg/RobotAssembly2019_07_02-David Tibia/TibialHead_103119_V1_DP.SLDPRT
Solid Models/Updated Robot parts with attachments/tibial end mirrored.SLDPRT
Solid_Models/00_Bipedal_Robot/03_Femur_Right/03_01_FK_R_001.SLDPRT
Solid_Models/00_Bipedal_Robot/04_Femur_Left/04_03_FE_L_001.SLDPRT
Solid_Models/00_Bipedal_Robot/06_Knee_Left/06_01_KT_L_001.SLDPRT
Solid_Models/00_Bipedal_Robot/10_Foot_Left/10_06_FT_L_001.SLDPRT
Solid_Models/00_Bipedal_Robot/knee encoder/02_Pelvis/02_10_SocketShell_Front_Left.SLDPRT
Solid_Models/00_BipedalRobot_Redesign/02_Pelvis/02_06_SF_R_001.SLDPRT
Solid_Models/00_BipedalRobot_Redesign/03_Femur/03_02_FH_R_001.SLDPRT
Solid_Models/00_BipedalRobot_Redesign/04_Knee/04_03_KT_L_001.SLDPRT
Solid_Models/Biomimetics_2022-Knee_Test/STL Files/03_01_FB_R_003.STL
Solid_Models/Prospective_Parts/Ty Ankle Foot/Foot and Ankle Design, Newest (7-17-20)/small axle lock.SLDPRT
Solid Models/Updated Robot parts with attachments/L2 with attachments.SLDPRT
Solid Models/Updated Robot parts with attachments/Femoral end.SLDPRT
Solid Models/Updated Robot parts with attachments/Femoral head attachments ball.SLDPRT
Solid Models/Updated Robot parts with attachments/L4.SLDPRT
Solid Models/Updated Robot parts with attachments/L5 with attachments.SLDPRT
Solid Models/Updated Robot parts with attachments/Sacrum with att.SLDPRT
Solid Models/Updated Robot parts with attachments/Tibial Rotator-Split1.SLDPRT
Solid Models/Updated Robot parts with attachments/Tibial Rotator-Split1.STL
Solid Models/Updated Robot parts with attachments/Tibial Rotator-Split11.STL
Solid Models/Updated Robot parts with attachments/Tibial head.SLDPRT
Solid Models/Updated Robot parts with attachments/ball2.SLDPRT
Solid Models/Updated Robot parts with attachments/ball3.SLDPRT
Solid Models/Updated Robot parts with attachments/femor bone mirror.SLDPRT
Solid Models/Updated Robot parts with attachments/femoral connection mirrored.SLDPRT
Solid Models/Updated Robot parts with attachments/femoral end mirrored.SLDPRT
Solid Models/Updated Robot parts with attachments/femoral head attachments mirrored.SLDPRT
Solid Models/Updated Robot parts with attachments/hip ball_socket.STL
Solid Models/Updated Robot parts with attachments/junk_part.SLDPRT
Solid Models/Updated Robot parts with attachments/tibial bone connection mirrored.SLDPRT
Solid Models/Updated Robot parts with attachments/tibial bone.SLDPRT
Solid Models/Updated Robot parts with attachments/tibial head mirrored.SLDPRT
Solid Models/Updated Robot parts with attachments/tibial rotator mirrored.SLDPRT
Solid_Models/00_BipedalRobot_Redesign/02_Pelvis/02_01_PE_001.SLDPRT
Solid_Models/00_BipedalRobot_Redesign/02_Pelvis/02_02_SA_001.SLDPRT
Solid_Models/00_BipedalRobot_Redesign/02_Pelvis/02_04_IF_R_001.SLDPRT
Solid_Models/00_BipedalRobot_Redesign/02_Pelvis/02_05_SB_R_001.SLDPRT
Solid_Models/00_BipedalRobot_Redesign/02_Pelvis/02_07_IB_L_001.SLDPRT
Solid_Models/00_BipedalRobot_Redesign/02_Pelvis/02_09_SB_L_001.SLDPRT
Solid_Models/00_BipedalRobot_Redesign/02_Pelvis/02_10_SF_L_001.SLDPRT
Solid_Models/00_BipedalRobot_Redesign/03_Femur/03_01_FB_R_001.SLDPRT
Solid_Models/00_BipedalRobot_Redesign/03_Femur/03_06_FemurHeadConnection_3dPrinted/95327A531_HIGH-STRG ZINC YELLOW-CHROMATE PLTD CAP SCREW.SLDPRT
Solid_Models/00_BipedalRobot_Redesign/04_Knee/04_02_KB_R_001.SLDPRT
Solid_Models/00_BipedalRobot_Redesign/04_Knee/04_05_BL_001.SLDPRT
Solid_Models/00_BipedalRobot_Redesign/04_Knee/04_06_FL_001.SLDPRT
Solid_Models/00_BipedalRobot_Redesign/07_HardWare/6630T310_METRIC BLACK POLYPROPYLENE BALL KNOB.SLDPRT
Solid_Models/00_BipedalRobot_Redesign/07_HardWare/90695A038_CLASS 04 STEEL THIN HEX NUT - DIN 439B.SLDPRT
Solid_Models/00_BipedalRobot_Redesign/07_HardWare/91239A330_CLASS 10.9 STL BUTTON-HEAD SOCKET CAP SCREW.SLDPRT
Solid_Models/00_BipedalRobot_Redesign/07_HardWare/91595A476_METRIC ALLOY STEEL DOWEL PIN.SLDPRT
Solid_Models/00_BipedalRobot_Redesign/07_HardWare/92997A108_CORROSION-RESISTANT SETUP STUD.SLDPRT
Solid_Models/00_BipedalRobot_Redesign/07_HardWare/94510A255_BRASS SCREW-TO-EXPAND INSERTS.SLDPRT
Solid_Models/00_BipedalRobot_Redesign/07_HardWare/94645A205_HIGH-STRENGTH STEEL NYLON-INSERT LOCKNUT.SLDPRT
Solid_Models/00_BipedalRobot_Redesign/07_HardWare/97493A126_ METRIC PARTIALLY THREADED STUDS.SLDPRT
Solid_Models/00_Bipedal_Robot/03_Femur_Right/03_02_FH_R_001.SLDPRT
Solid_Models/00_Bipedal_Robot/04_Femur_Left/04_01_FK_L_001.SLDPRT
Solid_Models/00_Bipedal_Robot/05_Knee_Right/05_02_KB_R_001.SLDPRT
Solid_Models/00_Bipedal_Robot/05_Knee_Right/05_04_AL_R_001.SLDPRT
Solid_Models/00_Bipedal_Robot/06_Knee_Left/06_03_PL_L_001.SLDPRT
Solid_Models/00_Bipedal_Robot/06_Knee_Left/06_04_AL_L_001.SLDPRT
Solid_Models/00_Bipedal_Robot/09_Foot_Right/09_01_AE_R_001.SLDPRT
Solid_Models/00_Bipedal_Robot/09_Foot_Right/09_02_AM_R_001.SLDPRT
Solid_Models/00_Bipedal_Robot/09_Foot_Right/09_03_AI_R_001.SLDPRT
Solid_Models/00_Bipedal_Robot/09_Foot_Right/09_04_AB_R_001.SLDPRT
Solid_Models/00_Bipedal_Robot/09_Foot_Right/09_06_FT_R_001.SLDPRT
Solid_Models/00_Bipedal_Robot/09_Foot_Right/09_07_MM_R_001.SLDPRT
Solid_Models/00_Bipedal_Robot/10_Foot_Left/10_01_AE_L_001.SLDPRT
Solid_Models/00_Bipedal_Robot/10_Foot_Left/10_02_AM_L_001.SLDPRT
Solid_Models/00_Bipedal_Robot/10_Foot_Left/10_03_AI_L_001.SLDPRT
Solid_Models/00_Bipedal_Robot/10_Foot_Left/10_04_AB_L_001.SLDPRT
Solid_Models/00_Bipedal_Robot/10_Foot_Left/10_05_AL_L_001.SLDPRT
Solid_Models/00_Bipedal_Robot/10_Foot_Left/10_08_LM_L_001.SLDPRT
Solid_Models/00_Bipedal_Robot/knee encoder/02_Pelvis/02_01_Pelvis.SLDPRT
Solid_Models/00_Bipedal_Robot/knee encoder/02_Pelvis/02_02_Sacrum.SLDPRT
Solid_Models/00_Bipedal_Robot/knee encoder/02_Pelvis/02_04_Ilium_Front_Right.SLDPRT
Solid_Models/00_Bipedal_Robot/knee encoder/02_Pelvis/02_05_SocketShell_Back_Right.SLDPRT
Solid_Models/00_Bipedal_Robot/knee encoder/02_Pelvis/02_06_SocketShell_Front_Right.SLDPRT
Solid_Models/00_Bipedal_Robot/knee encoder/02_Pelvis/02_07_Ilium_Back_Left.SLDPRT
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
