Agile-and-Adaptive-Robotics/Bipedal_Robot/Documentation/Reports and Papers/Knee_Torque_Test/Figures/Figure components/testJigs2/JigAssembly_saggital_labeled.pptx

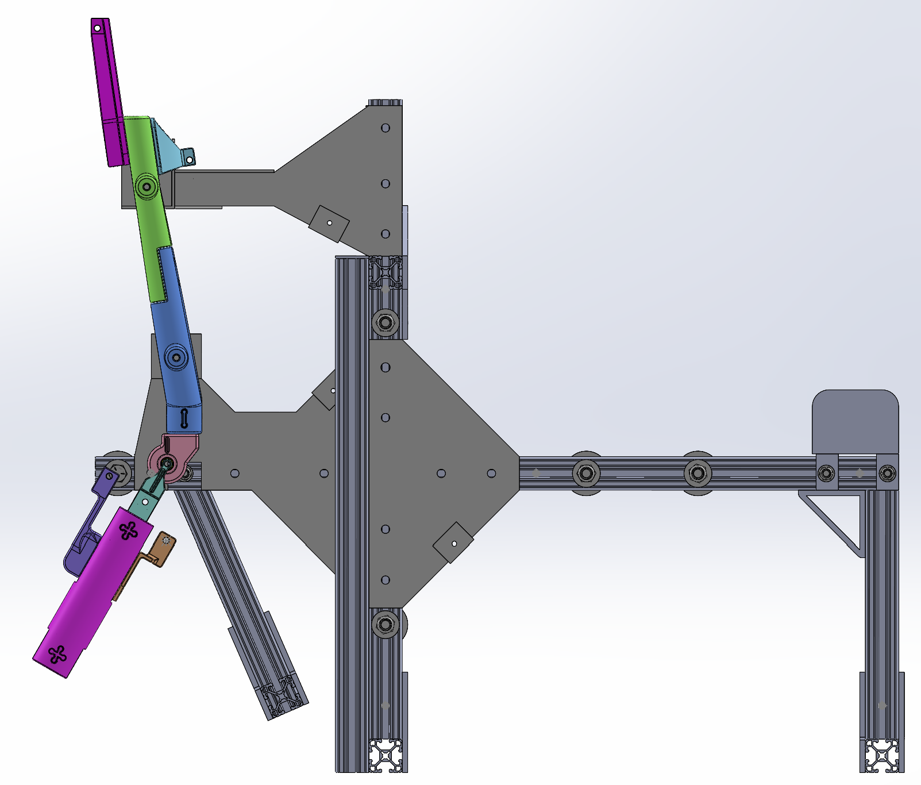
[picture p236: figure]

Test jig assembly
mounting locations

BPA

Femur

Winch housing

Knee joint

Tibia

θ

Winch cable

Swing arm

Load cell
