Agile-and-Adaptive-Robotics/Bipedal_Robot/Documentation/Reports and Papers/Knee_Torque_Test/Figures/Figure components/assemblies_iso/assembliesFig.pptx

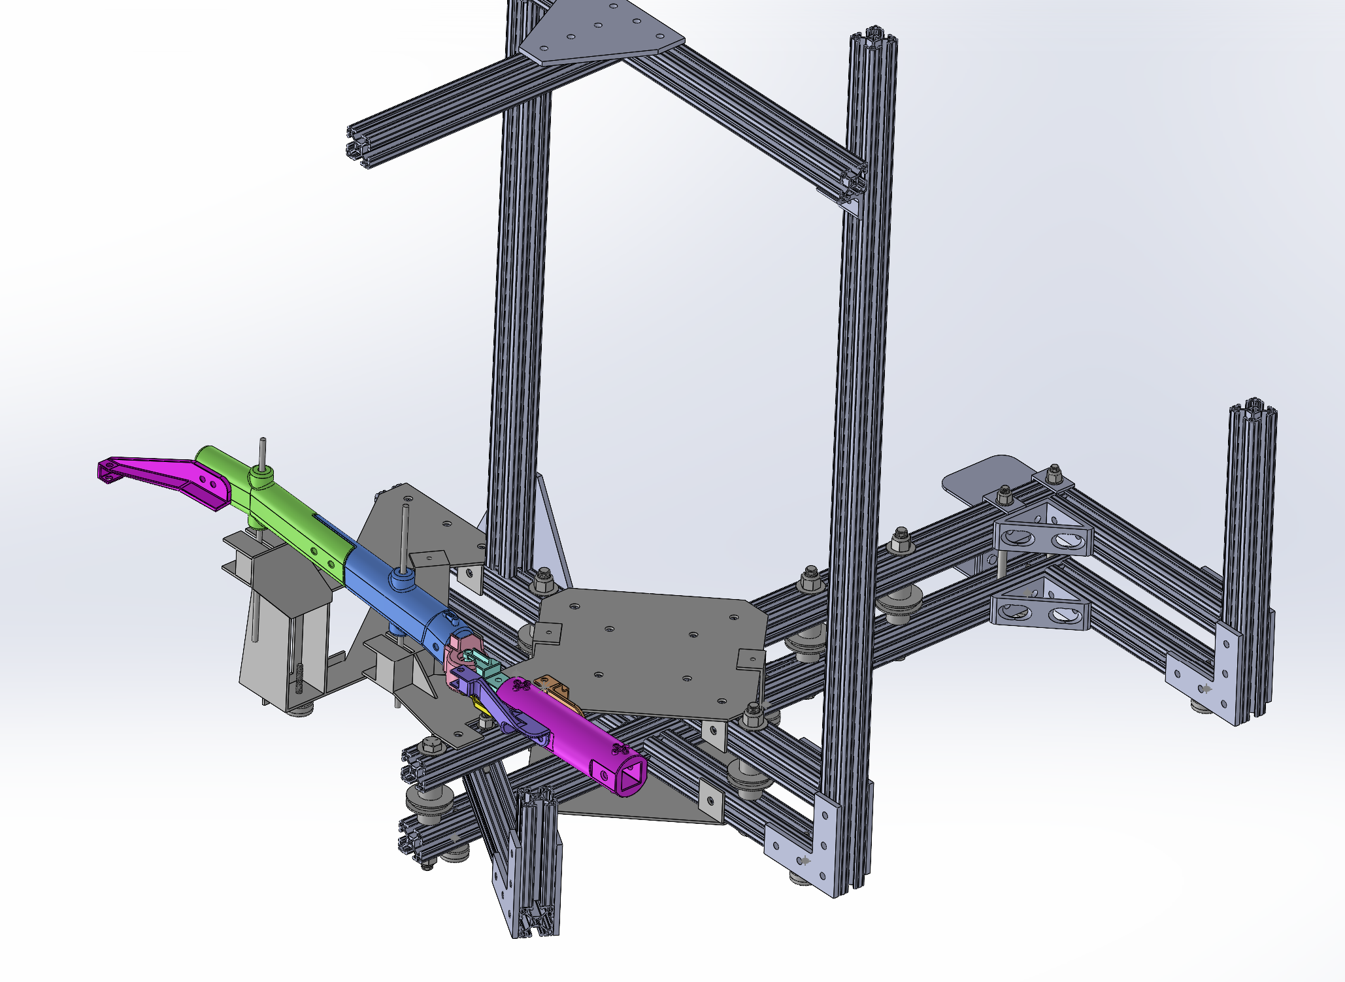
[picture p237: figure]

A

B

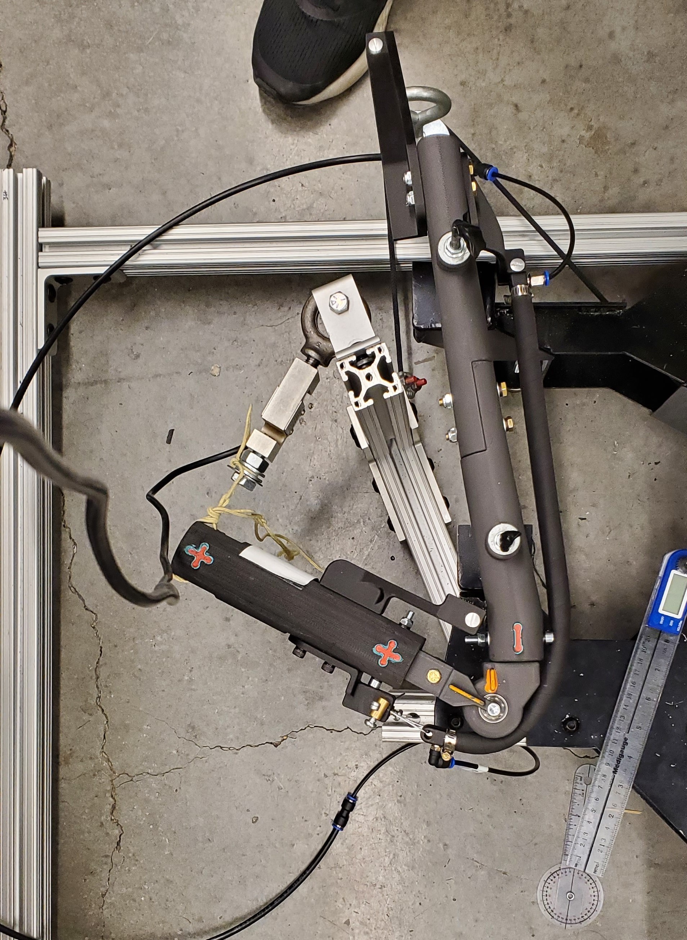
[picture p238: figure]
