Agile-and-Adaptive-Robotics/Bipedal_Robot/Documentation/Reports and Papers/Knee_Torque_Test/Figures/Figure components/assemblies_iso/Assem3_iso.png

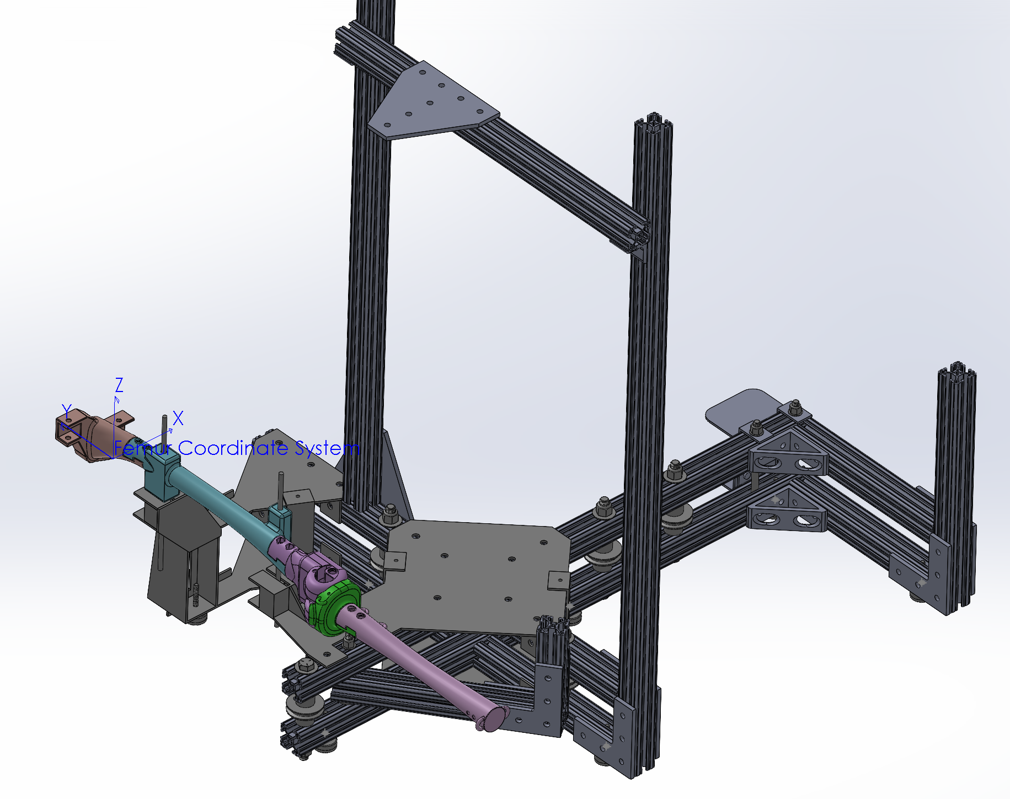
Documentation/Reports and Papers/Knee_Torque_Test/Figures/Figure components/assemblies_iso/Assem3_iso.png
