Agile-and-Adaptive-Robotics/Bipedal_Robot/Documentation/Reports and Papers/Knee_Torque_Test/Figures/Figure components/testJigs2/JigAssembly_saggital_labeled.png

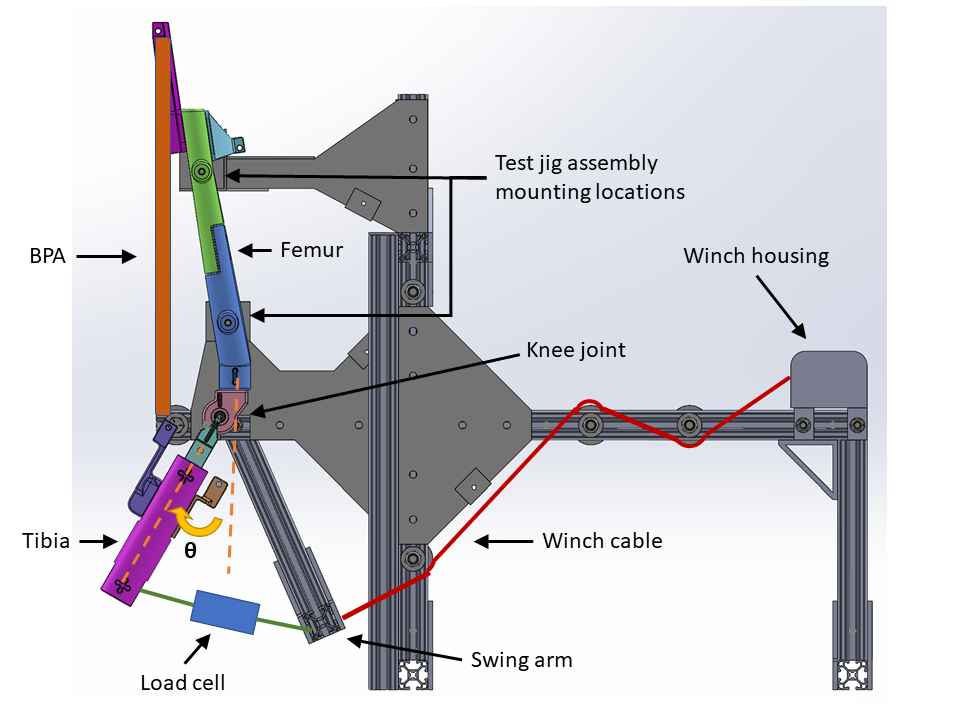
Documentation/Reports and Papers/Knee_Torque_Test/Figures/Figure components/testJigs2/JigAssembly_saggital_labeled.png
