Agile-and-Adaptive-Robotics/Bipedal_Robot/Pictures/Hugin_Tutorial/Tutorial2_3 - Tutorial2_3.tif

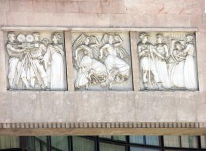
Pictures/Hugin_Tutorial/Tutorial2_3 - Tutorial2_3.tif
