Agile-and-Adaptive-Robotics/Bipedal_Robot/Pictures/Hugin_Tutorial/Tutorial2_3.jpg

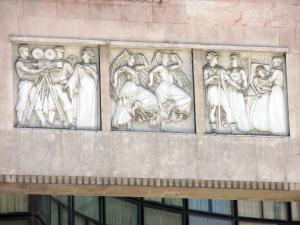
Pictures/Hugin_Tutorial/Tutorial2_3.jpg
