Agile-and-Adaptive-Robotics/Bipedal_Robot/Pictures/Hugin_Tutorial/Tutorial2_4.jpg

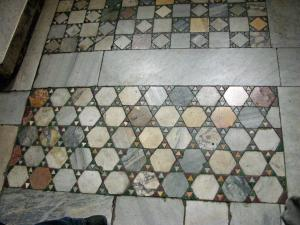
Pictures/Hugin_Tutorial/Tutorial2_4.jpg
