Agile-and-Adaptive-Robotics/Bipedal_Robot/Solid_Models/00_Bipedal_Robot/knee encoder/08_Media/09_BipedalRobot_Assembly_IsoView.JPG

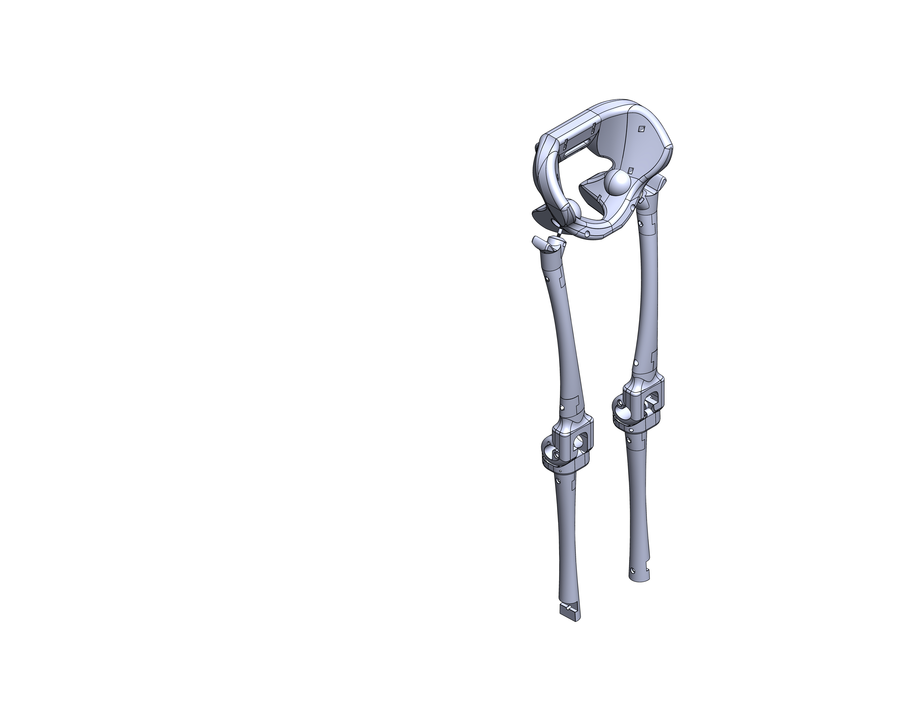
Solid_Models/00_Bipedal_Robot/knee encoder/08_Media/09_BipedalRobot_Assembly_IsoView.JPG
