Agile-and-Adaptive-Robotics/Bipedal_Robot/Documentation/Reports and Papers/Isometric_Force_Test/Highlights.docx

# Highlights

- Braided Pneumatic Actuator maximum isometric force is a function of resting length
- Forces curves can be normalized with pressure and maximum contraction
- A high-fidelity predictive force model is developed using few coefficients
