Agile-and-Adaptive-Robotics/Bipedal_Robot/Documentation/Reports and Papers/Isometric_Force_Test/Review_round_1/Reviewer_checklist.docx

Reviewer 1

1. Illustration of different lines in Fig. 2A and Fig. 2B should be added to these two subfigures, respectively. Double check such problems across this manuscript.
  a. For clarification, are you asking for a figure legend? The figure has been updated.
2. The size of word in Figure 4 is too small, which should be revised.
  a. The size of Figures 2 through 4 have been increased.
3. There should be a space between the value and the unit, such as, 490 N. Check and revise across this manuscript.
  a. We’ve used package siunitx with the standard /, space. We checked the document and corrected a few that had a simple space. We change can change the default options to a larger space, it if needed, but would need approval from MDPI copy-editors.
4. A section of Conclusion should be added after the Discussion.
  a. The last two paragraphs have now been organized under a Conclusion section.
5. The proposed models are largely empirical. How to demonstrate the versatility of the empirical model for Festo BPAs with different diameters?
  a. This work applies to the 10 and 20 mm, which are the most common. We anticipate that these equations can but used for the other sizes (5mm and 40 mm), but data would need to be collected. The shapes of the 5 mm and 40 mm BPAs are similar. If one considers coefficients c1 and c2 to be exponential shaping factors, and c0 to be the relative importance of the exponential decay, then the equations should fit the similar curves but with different coefficients.
6. What is the stiffness of the Festo BPA when a zero pressure is applied? Characterization of such a passive stiffness is demanded.
  a. Agree that this is interesting, especially when considering active/passive elements of biological muscle. We do not currently have the test setup for this. We believe that this question is outside the scope of this work as we have focused on lengths between 0 and 1 relative strain without the use of external force. The Festo Fluidic Muscle DMSP (2026) manual mentions to avoid an unpressurized state and leave a residual pressure of up to 0.5 bar, and therefore should the passive stiffness at this pressure should also be considered?
7. Experiments are limited to Festo BPAs of two diameters; effects of manufacturing variations are not analyzed. Add necessary discussion on these influences.
  a. Noted on our analysis of maximum strain. We do not currently have a systematic analysis of the effects of manufacturing variations on BPA properties, but have noticed that seems to be more prominent in the 10 mm BPAs. Normalizing helps account for manufacturing variations. In addition, we have added error bars to Figure 3(b) to show the effect of being +/- 1 mm in measuring resting length or contracted length at 620 kPa.
8. No analysis of force degradation over cyclic loading or long-term drift is provided. Add these data.
  a. We agree that this is interesting to look at. We can mention it in the discussion. We don’t currently have a test setup for this and believe it is outside the scope of this paper. There are no papers that measure this experimentally, only some that mention the Festo Fluidic Muscle datasheet. Festo (2026) mentions that a 40 mm BPA can do 1 million cycles at 6000 N (maximum rated load), or 10 million cycles at 4000 N. They do not mention the service life of the other size BPAs. The Festo DMSP/MAS 2018 Fluidic Muscle manual (https://www.festo.com/net/en_us/SupportPortal/Files/732773/DMSP_MAS_2018-01f_8081496g1.pdf, page 11) mentions factors that can decrease service life, but not how the force degrades over time. The 2018 version also says to inspect the BPA every 500,000 cycles for signs of aging.
9. Quantitative comparison with existing models on the same dataset should be conducted to clarify the superiority of proposed model.
  a. We would like some clarification on this question. Would you like to see an additional table to compare our data with both the Martins and Boblan and Sarosi et al. models at various lengths?
10. Why 620 kPa is chosen as the normalization reference? Whether other pressures can also be employed?
  a. Common building supply pressure here (90 psi). Other pressures could relatively easily be used, like 600 kPa maximum rated pressure for the 20 mm BPA, or 800 kPa which is the maximum rated pressure for the 10 mm BPA. Picking different values in working BPA pressure range would affect coefficients minimally. Doesn’t serve as a true maximum. It allowed us to reduce Equation 8 from 6 coefficients to 3. This discussion is in the paragraph before the Conclusions section.
11. Can the proposed model be embedded into real-time control or simulation? Clarify it in Discussion.
  a. Yes. Small equation. Can also be used in lookup table for quick real-time control.
12. Double check the format of references [19] and [20].
  a. Yes. The references have been corrected.

Reviewer 2

A simple analysis of a product's performance and the difference between the manufacturer's specifications and the individual device. As a route to characterizing the actuator for use in an eventual product it is acceptable.

1. However, it would be informative for the authors to speculate the reasons for the deviations between their model and the manufacturer's. They identify where but not why. As experienced users of the devices they might be able to give the reader the benefit of their greater insight.
  a. In the 2013 catalogue (https://ftp.festo.com/Public/PNEUMATIC/SOFTWARE_SERVICE/Documentation/2015/EN/DMSP-MAS_EN.PDF), they note that testing was done with BPAs that are 10x the diameter. It is possible model must have a sign with an inverted parameter, because even in some of their documentation they note that force decreases with decreasing length. However, the 100 mm BPA should have much less force than what is shown in the curve. This is our experience and the reason for the testing. They don’t properly account for the end effects of the pressure vessel where end effects dominate: “Clamped ends that fix diameter but allow axial displacement: impose strong boundary conditions that force steep gradients in hoop strain near the ends → boundary layers where bending and shear matter and analytic membrane-only solutions deviate.
    i. Short vs long vessels (50–550 mm):
    ii. Short vessels: end effects dominate; the axial length scale of the boundary layer is comparable to the vessel length, so global solution differs substantially from an infinite cylinder solution.

“

2. One concern is: "The improved Hill-muscle model of Thelen [22] shows an exponential term for a muscle’s passive force-length property concentric loading." This model is specifically for aging muscles. In general the impact of the connective tissue on the curve is a step function. Do the authors have a more general reference for this?
  a. i.e. find older references. This paragraph sort of trails off. Let’s update it clearly tie up ideas and transition to the next paragraph.
3. The figures, especially Figure 4, are quite small, the vertical scale reduced. There are few figures in the paper so I suggest they can afford to take up a little more space.
  a. We have updated these figures for ease of readability.
4. An observation is that the disadvantage of BPAs are: "maximum tensile force occurs at resting (i.e., uninflated) length (lrest) rather than at an optimal fiber length". Is the ability of the natural musculoskeletal system to adapt to the required loads and ranges placed upon them, by changing tenson length, sarcomere and fibre numbers, at least as significant problem when trying to mimic the natural system?
  a. To address this, we will add to discussion section the ways that BPAs are and are not like real muscles.
