Agile-and-Adaptive-Robotics/Bipedal_Robot/Documentation/Reports and Papers/Isometric_Force_Test/Figures/Figure components/testJigs1/testJigs1.pptx

Test Frame

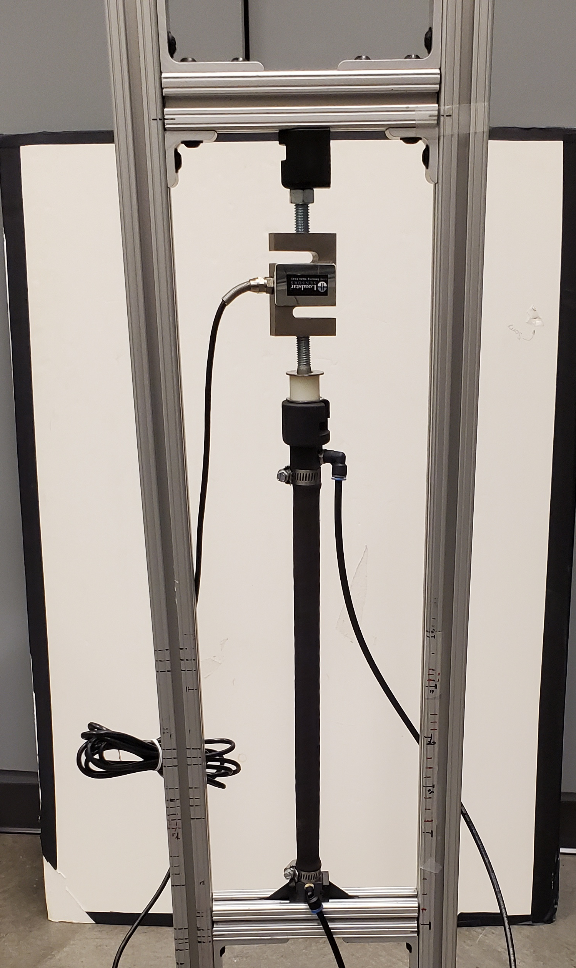
[picture p248: figure]

Load Cell

Air supply

End caps

Hose clamps

BPA Length

Air to pressure sensor
