Agile-and-Adaptive-Robotics/Bipedal_Robot/Documentation/Reports and Papers/Isometric_Force_Test/Submit your manuscript _ Sensors and Actuators_ A. Physical.pdf

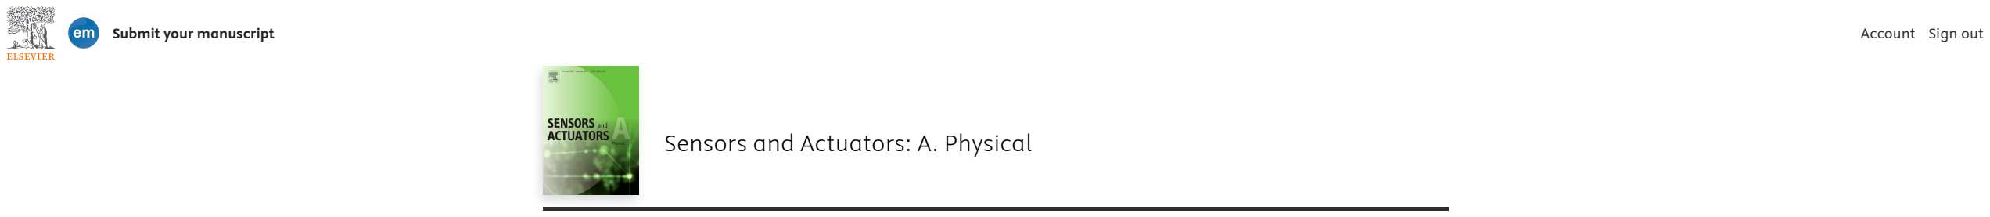
[picture p249: figure]
bmit y; cript; nt Sig

ut Sensors and Actuators: A. Physical This is a new submission service. Your feedback will help us improve it. Your manuscript has now been submitted Here’s what you submitted Submitted: | 13:52, December 18, 2025 Journal: | Sensors and Actuators: A. Physical Article type: Research Paper Title: | Isometric Force Characterization of Braided Pneumatic Actuators Authors: | 1. Ben Bolen | , Portland State University

2.

M

o

h

ama

d

Elz

ein, P
ortla

n

d

State

U

niv

ersity
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
g, P
ortla

n

d

State

U

niv

ersity
4.

Ale

x

a

n

d

er H

u

nt, P
ortla

n

d

State

U

niv

ersity

W

### hat

### happe

n

s

n

e

xt?

Y

o

ur ma

n

u

s

cript a

n

d

oth

er file

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
nt to

S

enso

r

s

and

A

ctu

ato

r

s: A. Physical and the corresponding author (Ben Bolen) will receive a confirmatio n
email. W

e will c

h

e

c

k

y

o

ur s

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
ct y

o

u if

w

e

n

e

e

d

m

ore information. View and track your submission The corresponding author can view and track the submission here. For assistance visit our Support Center or start a chat with us. If you have created other submissions on this platform, you will see the

m (https://submit.elsevier.com/SNA/submissions) listed on the Your submissions page.
