Agile-and-Adaptive-Robotics/Bipedal_Robot/Documentation/Reports and Papers/Knee_Torque_Test/Figures/Figure components/testJigs2/testJigs.pdf

A) B)

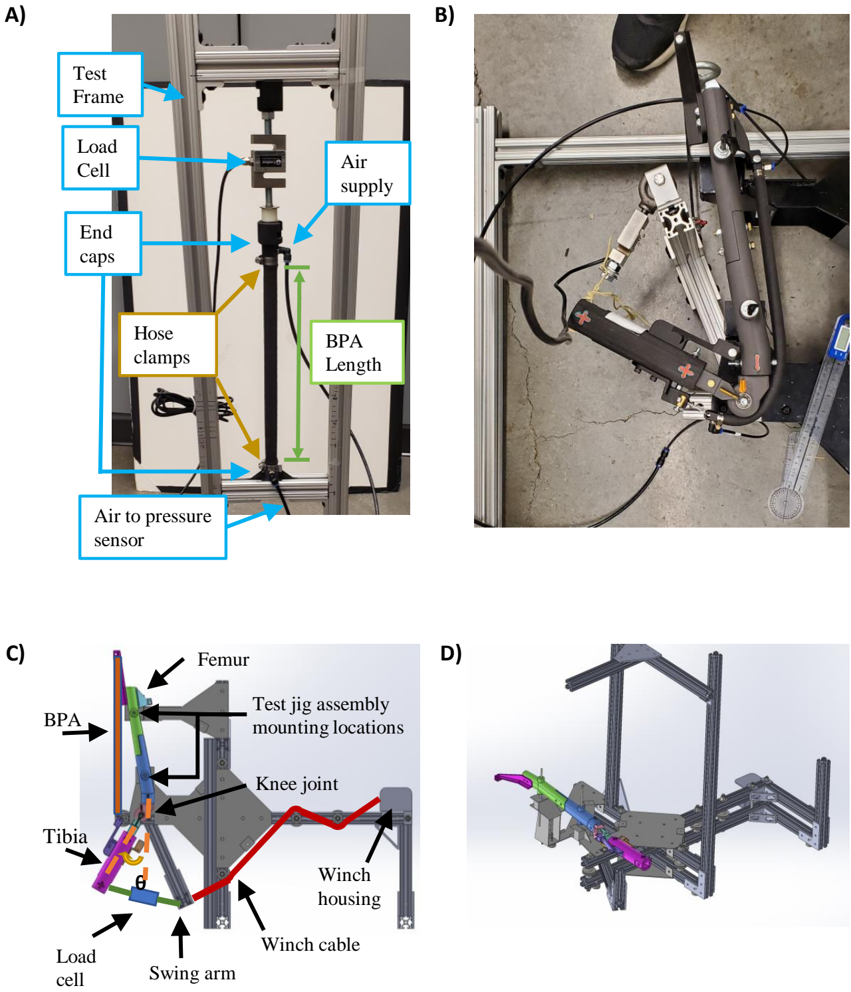
[picture p250: page 1]

θ

Test jig assembly
mounting locations

Load
cell

BPA

Tibia

Femur

Swing arm

Winch cable

Winch
housing

Knee joint

Test
Frame

Load
Cell

BPA
Length

End
caps

Hose
clamps

Air
supply

Air to pressure
sensor
C) D)
