Agile-and-Adaptive-Robotics/Bipedal_Robot/Testing_Data/PressureSensorCalibration.xlsx

Voltage (V) | Pressure (kPA) |  | Voltage (V) | Pressure (kPA)
0.8358 | 0 |  | 0.8358 | 0
2.0674 | 200 |  | 4.7898 | 620
2.737 | 300
3.4164 | 400
4.0469 | 500
4.6481 | 600
4.7898 | 620
 | Sample
 | voltage | pressure |  | Sample
 | 0.8358 | 2.218232 |  | voltage | pressure
 | 4.7703 | 616.157612 |  | 0.8358 | -0.00656
 |  |  |  | 4.7214 | 609.25552
