Agile-and-Adaptive-Robotics/Bipedal_Robot/Testing_Data/2022_02_Festo/Results_table_10mm.xlsx

Sheet: ExtTest10mm
Extensor Test 10mm
Resting muscle length |  | 520
 | expected max contract | 431.6 | actual | 440
 | tendon | 30 | actual | 55
 | Test # | 1 | 2 | 3 | 4 | 5 | 6 | 7 | 8 | 9 | 10 | 11 | 12 | 13 | 14 | 15
 | Load (N) | 16.269 | 11.219 | 10.593 | 11.395 | 10.655 | 7.7816 | 3.958 | 1.909 | 1.22
 | Knee angle | -120 | -108.5 | -93 | -70 | -53.5 | -49 | -21 | -9 | -2
Hand | Load cell angle (real ICR) | 33.6 | 36.7 | 36.1 | 39 | 34 | 38.5 | 36.4 | 33.3 | 34.6
 | Load cell angle (tibia) | 30.5 | 30 | 34 | 42.5 | 40 | 41.5 | 38 | 38 | 35
 | muscle length | 518 | 520 | 510 | 495 | 485 | 475 | 460 | 450 | 450
MA | ICR (spline)
 | Tibia origin (matlab) | 366.05 | 366.05 | 366.05 | 366.05 | 366.05 | 366.05 | 366.05 | 366.05 | 366.05 | 366.05 | 366.05 | 366.05 | 366.05 | 366.05 | 366.05
 | ICR to muscle | 38 | 35 | 40 | 40 | 45 | 45 | 40 | 40 | 41
 | dl/dtheta
 | Torque | 5.284784416 | 3.660735424 | 3.325465724 | 3.220868075 | 3.116935495 | 2.230770431 | 1.187533441 | 0.5727643605 | 0.3789285403 | 0 | 0 | 0 | 0 | 0 | 0
 | Pressure | 601.4829 | 600.7278788 | 585.3714858 | 597.2455816 | 595.7613196 | 597.2455816 | 597.2455816 | 596.5034506 | 595.7613196
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
