Agile-and-Adaptive-Robotics/Bipedal_Robot/Testing_Data/2022_02_Festo/Results_table_FullSize.xlsx

Sheet: ExtTest40mm_1
Extensor Test 40mm
Resting muscle length |  | 557
 | expected max contract | 462.31 | 417.75 |  |  |  |  | 0.05565529623 |  |  |  |  | 0.1795332136
 | tendon | 30 |  |  |  |  |  |  | * |  |  |  |  | **
 | Test # | 1 | 2 | 3 | 4 | 5 | 6 | 7 | 8 | 9 | 10 | 11 | 12 | 13 | 14 | 15
 | Load (N) | 21.395 | 9.8043 | 5.4329 | 1.5627 | 3.1173 | 4.5189 | 1.1431 | 20.043 | 3.3938 | 4.079 | 20.853 | 10.809 | 33.079 | 19.314
 | Knee angle | -117 | -106 | -96 | -66.5 | -74.5 | -85.5 | -53.5 | -53.5 | -17 | -17 | -42.5 | -30 | -6 | 6.5
Hand | Load cell angle (real ICR) | 36.1 | 29 | 26.5 | 32.3 | 31.2 | 27.6 | 33.6 | 36.5 | 36 | 35.2 | 39.9 | 39.7 | 36.2 | 32.5
 | Load cell angle (tibia) | 32 | 34.5 | 31 | 44.5 | 35.5 | 33 | 35.5 | 35 | 35 | 37 | 40.5 | 38 | 34 | 33.5
 | muscle length | 533 | 529.5 | 520 | 524 | 522 | 522 | 526 | 470 | 461 | 461 | 462 | 457 | 440 | 430
 | % contraction | 0.04308797127 | 0.04937163375 | 0.06642728905 | 0.0592459605 | 0.06283662478 | 0.06283662478 | 0.05565529623 | 0.1561938959 | 0.1723518851 | 0.1723518851 | 0.170556553 | 0.1795332136 | 0.21005386 | 0.2280071813
MA | ICR (spline)
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
