Agile-and-Adaptive-Robotics/Bipedal_Robot/Testing_Data/2021_03_Festo10mm/RawData_Mar2021.xlsx

Sheet: Calibration
Zero Factor(Horizontal Configuration) | -17280 | Calibration Factor(Horizontal Configuration) | -15400
Zero Factor (Vertical Configuration) | -27066 | Calibration Factor (Vertical Configuration) | -20240

Sheet: Load(N) Stats
Flexion |  |  |  | Extension |  |  |  | **NOTE: Extension Data is first series of data collected. Throughout Extension tests and even into Flexsion tests, number of data points collected per knee angle was increased from 150 pts to 6000 pts
1 | Mean | n/a |  | 1 | Mean | n/a
 | Median | n/a |  |  | Median | n/a
 | Mode | n/a |  |  | Mode | n/a
 | Standard Dev | n/a |  |  | Standard Dev | n/a
 |  | This column reflects increase in data from 2000pts to 600 pts | This column shows 2000 data points
2 | Mean | 54.7158 | 47.6618 | 2 | Mean | 29.3672
 | Median | 54.7131 | 47.596 |  | Median | 29.3583
 | Mode | 54.7131 | 47.596 |  | Mode | 29.3583
 | Standard Dev | 0.0344 | 0.1702 |  | Standard Dev | 0.1583
3 | Mean | 52.9338 | 42.872 | 3 | Mean | 5.584
 | Median | 52.9338 | 42.7029 |  | Median | 5.7827
 | Mode | 52.9338 | 42.7029 |  | Mode | 5.7827
 | Standard Dev | 0 | 0.2801 |  | Standard Dev | 0.2215
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
