Agile-and-Adaptive-Robotics/Bipedal_Robot/Testing_Data/2021_03_Festo10mm/TorqueByAngle_Mar21.xlsx

Sheet: Flexion
Flexion Image # | Angle of Knee (deg) | Torque
2 | -6 | -12.33081748
3 | -9 | -11.82043624
4 | -14 | -11.42948611
5 | -17 | -10.3865434
6 | -20 | -9.991501739
7 | -21 | -9.190258427
8 | -21 | -8.765456856
9 | -26 | -7.075487011
10 | -22 | -8.328558095
11 | -20 | -10.300211
12 | -21 | -9.776592783
13 | -18 | -10.79272432
14 | -30 | -5.306428066
15 | -35 | -4.307023021
16 | -35 | -4.710288019

Sheet: Extension
Extension Image # | Angle of Knee (deg) | Torque
3 | -137 | 1.268805832
4 | -137 | 1.217679581
5 | -131 | 0.8045846797
6 | -121 | 1.25374224
7 | -121 | 1.179974782
8 | -117 | 0.6043823602
9 | -113 | 0.5026221152
10 | -103 | 0.4982883469
11 | -102 | 0.4026714709
