Agile-and-Adaptive-Robotics/Bipedal_Robot/Testing_Data/2022_02_Festo/OpenSim_Bifem_Results.txt

UNKNOWN			
version=1			
nRows=100			
nColumns=4			
inDegrees=no			
endheader			
time	/jointset/knee_r/knee_angle_r/value	bifemlh_r	bifemsh_r
0	-119.9999999	0.6840905	-2.46121431
1	-118.6868686	0.36728462	-2.99899687
2	-117.3737372	0.05027646	-3.53528366
3	-116.0606059	-0.26711582	-4.06985937
4	-114.7474746	-0.58507631	-4.60250426
5	-113.4343433	-0.90379039	-5.13299389
6	-112.121212	-1.22344369	-5.66109887
7	-110.8080807	-1.54422116	-6.18658467
8	-109.4949494	-1.86630601	-6.70921146
9	-108.181818	-2.18987874	-7.22873399
10	-106.8686867	-2.51511614	-7.74490153
11	-105.5555554	-2.84219031	-8.25745787
12	-104.2424241	-3.17126762	-8.76614137
13	-102.9292928	-3.50250777	-9.27068504
14	-101.6161615	-3.83606276	-9.77081674
15	-100.3030302	-4.17207593	-10.26625934
16	-98.98989883	-4.51069032	-10.75669407
17	-97.67676752	-4.85204928	-11.24174535
18	-96.3636362	-5.19626316	-11.72111079
19	-95.05050489	-5.54342902	-12.19448789
20	-93.73737357	-5.89363057	-12.66157126
21	-92.42424226	-6.24693725	-13.12205323
22	-91.11111094	-6.60340336	-13.57562449
23	-89.79797963	-6.96306719	-14.02197471
24	-88.48484831	-7.32595019	-14.46079331
25	-87.171717	-7.69205619	-14.89177011
26	-85.85858569	-8.06137064	-15.31459618
27	-84.54545437	-8.43385993	-15.72896459
28	-83.23232306	-8.80947073	-16.13457124
29	-81.91919174	-9.18812942	-16.53111566
30	-80.60606043	-9.56974153	-16.9183019
31	-79.29292911	-9.95417335	-17.29595269
32	-77.9797978	-10.34119757	-17.66438361
33	-76.66666648	-10.73064843	-18.0234347
34	-75.35353517	-11.12235087	-18.37286939
35	-74.04040385	-11.51610687	-18.71245717
36	-72.72727254	-11.91169542	-19.04197417
37	-71.41414123	-12.30887251	-19.36120384
38	-70.10100991	-12.70737125	-19.66993752
39	-68.7878786	-13.10693408	-19.96801695
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
