Agile-and-Adaptive-Robotics/Bipedal_Robot/Testing_Data/2022_02_Festo/OpenSim_Vasti_Results.txt

UNKNOWN				
version=1				
nRows=100				
nColumns=5				
inDegrees=no				
endheader				
time	/jointset/knee_r/knee_angle_r/value	vas_int_r	vas_lat_r	vas_med_r
0	-119.9999999	26.65521069	38.21878174	28.71948729
1	-118.6868686	26.99293875	38.58124777	29.09057458
2	-117.3737372	27.35220777	38.93008579	29.45934137
3	-116.0606059	27.73121367	39.26098522	29.82282572
4	-114.7474746	28.1282105	39.5694206	30.17788705
5	-113.4343433	28.54150938	39.85061723	30.52115944
6	-112.121212	28.96946713	40.09950331	30.84899296
7	-110.8080807	29.41046336	40.31064992	31.15738057
8	-109.4949494	29.86290347	40.04961262	31.44188504
9	-108.181818	30.32521096	40.85337168	31.6975468
10	-106.8686867	30.79581979	41.66535081	31.91877417
11	-105.5555554	31.27316701	42.48376082	32.09921191
12	-104.2424241	31.75568558	43.30679594	32.2315833
13	-102.9292928	32.24179761	44.13262435	32.30750031
14	-101.6161615	32.72990783	44.95937948	32.50013979
15	-100.3030302	33.21839761	45.7851522	33.07285221
16	-98.98989883	33.7057188	46.608191	33.64340216
17	-97.67676752	34.19036973	47.42689819	34.21063732
18	-96.3636362	34.67054405	48.23910426	34.77298894
19	-95.05050489	35.14437587	49.04254962	35.32883838
20	-93.73737357	35.60994519	49.83490134	35.87653061
21	-92.42424226	36.06527403	50.61375164	36.41437322
22	-91.11111094	36.5083229	51.37661747	36.94063613
23	-89.79797963	36.93698205	52.12093613	37.45354926
24	-88.48484831	37.34878967	52.84379617	37.95117483
25	-87.171717	37.7413387	53.54233837	38.43160001
26	-85.85858569	38.11231211	54.21379821	38.89295415
27	-84.54545437	38.45931487	54.85535112	39.33333353
28	-83.23232306	38.77959071	55.46376945	39.75056013
29	-81.91919174	39.06221255	56.02570436	40.13543029
30	-80.60606043	40.07740235	56.53332302	40.4826115
31	-79.29292911	40.96441048	56.98550214	40.79170319
32	-77.9797978	41.82233327	57.38949349	41.06926589
33	-76.66666648	42.65204152	57.7449454	41.31537814
34	-75.35353517	43.45387439	58.0499737	41.52879
35	-74.04040385	44.22820026	58.30245592	41.70799428
36	-72.72727254	44.9754203	58.49999117	41.85116729
37	-71.41414123	45.69597135	58.63985186	41.95609522
38	-70.10100991	46.39032794	58.71892641	42.0200827
39	-68.7878786	47.05891131	59.01418146	41.97685689
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
