Agile-and-Adaptive-Robotics/Bipedal_Robot/Testing_Data/2022_02_Festo/PlotPrompt.docx

Here is my Matlab code for minimizeExt10mmX3:

%% MinimizeExtPinX3.m

%Minimization scheme

clear; clc; close all

%% Initial Baseline Evaluation (for constraint bounds)

[a0, ~] = minimizeExtX3(0, Inf, Inf, 0, 1:4); % All for baseline

baselineScores = a0; % RMSE, FVU, Max Residual

fprintf('Baseline: RMSE %.4f, FVU %.4f, Max. Residual %.4f\n', mean(baselineScores(:,1)),mean(baselineScores(:,2)),mean(baselineScores(:,3)));

load minimizeFlxPin10_results.mat sol_actual

sol_actual1 = sol_actual;

[a1, ~] = minimizeExtX3(sol_actual1(1), sol_actual1(2), sol_actual1(3), 0, 1:4); % Use solution from Flexor bracket, and compare results

% clear sol_actual

baselineScores1 = a1; % RMSE, FVU, Max Residual

fprintf('Baseline using previous opt: RMSE %.4f, FVU %.4f, Max. Residual %.4f\n', mean(baselineScores1(:,1)),mean(baselineScores1(:,2)),mean(baselineScores1(:,3)));

%% Cross-validation setup

allBPA = [1,3,4]; %We're going to skip 42cm l_rest with a tendon

labels = ["42cm", "42cm-tendon", "46cm", "48cm"];

validLabels = labels(allBPA);

numBPA = numel(allBPA);

results_cv = cell(1, numBPA);

scores_cv = zeros(numBPA, 3); % Will store RMSE, FVU, Max Resid for held-out validation

%% Problem bounds

% lb = [-0.02 * 100, 3,3, 0]; % [cm, log10(N/m), log10(N/m), unitless]

% ub = [0.03 * 100, 8, 8, 15];

lb = [-0.02 * 100, log10(5e3),log10(5e3), 0]; % [cm, log10(N/m), log10(N/m), unitless]

ub = [0 * 100, log10(5e5), log10(5e5), 2];

clear sol_actual

%% Solver

for k = 1:numel(allBPA)

holdoutIdx = allBPA(k);

fprintf('\n---- Cross-validation: Holding out BPA #%d (%s) ----\n', ...

holdoutIdx, labels(holdoutIdx));

trainIdx = setdiff(allBPA, holdoutIdx);

baseline_train = baselineScores(trainIdx,:);

% GA options

opts = optimoptions('gamultiobj', ...

'UseParallel', true, ...

'Display', 'iter', ...

'PlotFcn', {@gaplotpareto3D_simple}, ...

'InitialPopulationRange',[lb; ub], ...

'PopulationSize', 150, ...

'MaxGenerations', 750, ...

'MutationFcn', {@mutationadaptfeasible}, ...

'CrossoverFraction', 0.8, ...

'CrossoverFcn', {@crossoverscattered}, ...

'FunctionTolerance', 1e-4);

goal = [0 0 0];

weight = [0.33 10 0.1];

opts.HybridFcn = {@fgoalattain, goal, weight};

% opts.OutputFcn = {@debugPop};

% Run optimization

[x, fvals,exitflag,output,population,scores] = gamultiobj(@(X) min1(X, trainIdx), 4, [], [], [], [], ...

lb, ub, [], opts);

% If I want to use GODLIKE instead:

% trainIdx_fixed = trainIdx; % capture loop var for closure

% min1_wrapper = @(x) min1(x, trainIdx_fixed);

% [sol,fval,x, fvals, exitflag,output] = GODLIKE(min1_wrapper,lb,ub,[],'NumObjectives',3,...

% 'algorithms', {'PSO';'GA';'DE';'ASA'},...

% 'display' , 'plot', ...

% 'UseParallel','true', ...

% 'popsize' , 100 );

% Evaluate each solution on held-out BPA

valF = zeros(size(x,1), 3);

for i = 1:size(x,1)

valF(i,:) = min1(x(i,:), holdoutIdx);

end

% Store full set (no bestIdx decision now)

results_cv{k}.optParams_all = x; % Nx4

results_cv{k}.trainScores_all = fvals; % Nx3

results_cv{k}.validation_all = valF; % Nx3

results_cv{k}.distance_all = vecnorm(fvals - valF, 2, 2); % Nx1

results_cv{k}.foldIdx = repmat(holdoutIdx, size(x,1), 1); % Nx1

end

%% === Compile All Pareto Candidates from Cross-Validation ===

all_candidates = []; % Will collect [foldIdx, x(3), fvals(3), valF(3), dist]

for i = 1:numBPA

fold = results_cv{i}.foldIdx; % Nx1

x = results_cv{i}.optParams_all; % Nx4

train = results_cv{i}.trainScores_all; % Nx3

val = results_cv{i}.validation_all; % Nx3

dist = results_cv{i}.distance_all; % Nx1

rows = [fold, x, train, val, dist]; % Nx12

all_candidates = [all_candidates; rows];

end

%% Sort by validation distance first, then validation metrics

results = all_candidates; % [fold, Xi0, Xi1, Xi2, Xi3, train (3), val (3), dist]

results_sort = sortrows(results, [12 9 10 11 6 7 8]); % sort by distance, then val, then train

%% De-normalize to get physical parameters

x_actual = [results_sort(:,2)/100, 10.^results_sort(:,3), 10.^results_sort(:,4), results_sort(:,5)];

results_sort_actual = [results_sort(:,1), x_actual, results_sort(:,6:end)];

%% Pick best solution (later, flexible)

pick = 78;

sol_actual = results_sort_actual(pick, 2:5); % [Xi0, Xi1, Xi2, Xi3]

[f, bpa] = minimizeExtX3(sol_actual(1), sol_actual(2), sol_actual(3), sol_actual(4), 1:4); % [f: 4x3], [bpa: full struct]

fprintf('\nPerformance with sol_actual:\n');

disp(array2table(f, 'VariableNames', {'RMSE', 'FVU', 'MaxResidual'}, ...

'RowNames', cellstr(labels')));

%% Plot results

%% --- Define color scheme and labels ---

c = cell(8,1);

c{1} = '#FFD700'; % gold ? Hybrid

c{2} = '#FFB14E'; % orange

c{3} = '#FA8775'; % light orange

c{4} = '#EA5F94'; % pink

c{5} = '#CD34B5'; % magenta ? Predicted

c{6} = '#9D02D7'; % magenta 2

c{7} = '#0000FF'; % indigo ? Measured

c{8} = '#000000'; % black

labels = ["42cm", "42cm-tendon", "46cm", "48cm"];

% tileIdxs = [1, 5, 8, 12]; % A, B, C, D

tileIdxs = [1, 5, 10]; % A, B, C

tileSpans = [1 3]; % Span: [rows cols]

tileOrder = [4, 3, 1, 2];

tileLabels = {'(A)', '(B)', '(C)', '(D)'};

% Annotation positions [x, y] in normalized figure units

% xAnn = [0.035, 0.51, 0.035, 0.51]; % (A), (B), (C), (D)

% yAnn = [0.89, 0.89, 0.41, 0.41]; % (A), (B), (C), (D)

xAnn = [0.035, 0.51, 0.265]; % (A), (B), (C)

yAnn = [0.89, 0.89, 0.41]; % (A), (B), (C)

sz = 60;

%for plotting

%% --- Torque Figure with tiles ---

figT = figure('Name','Torque','Color','w');

figT.Position = [100 100 950 700];

tT = tiledlayout(2,7,'TileSpacing','loose','Padding','loose');

for j = 1:3

i = tileOrder(j);

ax = nexttile(tileIdxs(j), tileSpans);

hold on

% Plot order: hybrid (gold), experimental (indigo), original (gray dash), predicted (magenta)

scatter(bpa(i).A_h, bpa(i).M_h, sz, 'filled', 'MarkerFaceAlpha', 0.75, ...

'MarkerFaceColor', c{1}, 'DisplayName', 'Hybrid');

scatter(bpa(i).Aexp, bpa(i).Mexp, sz, 'filled', 'MarkerFaceAlpha', 0.75, ...

'MarkerFaceColor', c{7}, 'DisplayName', 'Measured');

plot(bpa(i).Ak, bpa(i).M, '--', 'Color', [0.4 0.4 0.4], 'LineWidth', 2, ...

'DisplayName', 'Original');

plot(bpa(i).Ak, bpa(i).M_p(:,3), '-', 'Color', c{5}, 'LineWidth', 2.5, ...

'DisplayName', 'Predicted');

% Tile-specific title and annotation label

title(['\bf ' labels(i)], 'Interpreter','tex');

annotation(figT, 'textbox', [xAnn(j) yAnn(j) 0.05 0.05], 'String', ['\bf ' tileLabels{j}], ...

'FontSize', 12, 'FontName', 'Arial', 'EdgeColor', 'none', 'HorizontalAlignment','center');

% Axis config

set(gca, ...

'FontSize', 12, ...

'FontWeight', 'bold', ...

'FontName', 'Arial', ...

'LineWidth', 2, ...

'XMinorTick', 'on', ...

'YMinorTick', 'on', ...

'YLim', [0 15], ...

'TickLength', [0.025 0.05], ...

'GridLineStyle','none');

end

%shared axes labels

ylabel(tT,'\bf Torque, N\cdotm','Interpreter','tex')

xlabel(tT,'\bf \theta_{k} , \circ','Interpreter','tex')

% Legend in top-right tile only

lg = legend(tT.Children(end-1));

lg.Location = 'northeast';

lg.FontSize = 8;

%% --- Muscle Length Figure with tiles---

figL = figure('Name','Muscle Length','Color','w');

figL.Position = [100 100 950 700];

tL = tiledlayout(2,7,'TileSpacing','loose','Padding','loose');

for j = 1:3

i = tileOrder(j);

ax = nexttile(tileIdxs(j), tileSpans);

hold on

% Predicted

Lm_p = bpa(i).Lmt_p - 2 * bpa(i).fitn - bpa(i).ten;

Lm = bpa(i).Lmt - 2 * bpa(i).fitn - bpa(i).ten;

scatter(bpa(i).A_h, bpa(i).Lm_h, sz, 'filled', 'MarkerFaceAlpha', 0.75, ...

'MarkerFaceColor', c{7},'DisplayName', 'Measured'); % Hybrid (gold)

plot(bpa(i).Ak, Lm, '--', 'Color', [0.4 0.4 0.4], 'LineWidth', 2,'DisplayName', 'Original'); % Original

plot(bpa(i).Ak, Lm_p, '-', 'Color', c{5}, 'LineWidth', 2.5,'DisplayName', 'Predicted'); % Predicted

title(['\bf ' labels(i)], 'Interpreter', 'tex');

% Tile-specific title and annotation label

title(['\bf ' labels(i)], 'Interpreter','tex');

annotation(figL, 'textbox', [xAnn(j) yAnn(j) 0.05 0.05], 'String', ['\bf ' tileLabels{j}], ...

'FontSize', 12, 'FontName', 'Arial', 'EdgeColor', 'none', 'HorizontalAlignment','center');

% Axis config

set(gca, ...

'FontSize', 12, ...

'FontWeight', 'bold', ...

'FontName', 'Arial', ...

'LineWidth', 2, ...

'XMinorTick', 'on', ...

'YMinorTick', 'on', ...

'TickLength', [0.025 0.05], ...

'GridLineStyle','none');

end

%shared axes labels

ylabel(tL,'\bf Torque, N\cdotm','Interpreter','tex')

xlabel(tL,'\bf \theta_{k} , \circ','Interpreter','tex')

% Legend in top-right tile only

lg = legend(tL.Children(end-1));

lg.Location = 'northeast';

lg.FontSize = 8;

%% --- Moment Arm Figure with tiles ---

figMA = figure('Name','Moment Arm - 2x2','Color','w');

figMA.Position = [100 100 950 700];

tMA = tiledlayout(2,7,'TileSpacing','loose','Padding','loose');

for j = 1:3

i = tileOrder(j);

ax = nexttile(tileIdxs(j), tileSpans);

hold on

G_p = hypot(bpa(i).mA_p(:,1), bpa(i).mA_p(:,2));

scatter(bpa(i).A_h, bpa(i).mA_h, sz, 'filled', 'MarkerFaceAlpha', 0.75, ...

'MarkerFaceColor', c{7},'DisplayName', 'Measured'); % Hybrid

plot(bpa(i).Ak, bpa(i).mA, '--', 'Color', [0.4 0.4 0.4], 'LineWidth', 2,'DisplayName', 'Original'); % Original

plot(bpa(i).Ak, G_p, '-', 'Color', c{5}, 'LineWidth', 2.5,'DisplayName', 'Predicted'); % Predicted

title(['\bf ' labels(i)], 'Interpreter', 'tex');

% Tile-specific title and annotation label

title(['\bf ' labels(i)], 'Interpreter','tex');

annotation(figMA, 'textbox', [xAnn(j) yAnn(j) 0.05 0.05], 'String', ['\bf ' tileLabels{j}], ...

'FontSize', 12, 'FontName', 'Arial', 'EdgeColor', 'none', 'HorizontalAlignment','center');

% Axis config

set(gca, ...

'FontSize', 12, ...

'FontWeight', 'bold', ...

'FontName', 'Arial', ...

'LineWidth', 2, ...

'XMinorTick', 'on', ...

'YMinorTick', 'on', ...

'TickLength', [0.025 0.05], ...

'GridLineStyle','none');

end

%shared axes labels

ylabel(tMA,'\bf Torque, N\cdotm','Interpreter','tex')

xlabel(tMA,'\bf \theta_{k} , \circ','Interpreter','tex')

% Legend in top-right tile only

lg = legend(tMA.Children(end-1));

lg.Location = 'northeast';

lg.FontSize = 8;

%% --- Strain Figure with tiles ---

figS = figure('Name','Relative Strain','Color','w');

figS.Position = [100 100 950 700];

tS = tiledlayout(2,7,'TileSpacing','loose','Padding','loose');

for j = 1:3

i = tileOrder(j);

ax = nexttile(tileIdxs(j), tileSpans);

hold on

strain_h = (bpa(i).rest - bpa(i).Lm_h)/bpa(i).rest;

kmax = (bpa(i).rest - bpa(i).Kmax)/bpa(i).rest;

scatter(bpa(i).A_h, strain_h/kmax, 60, 'filled', 'MarkerFaceAlpha', 0.75, 'MarkerFaceColor', '#FFD700','DisplayName', 'Measured');

plot(bpa(i).Ak, bpa(i).strain/kmax, '--', 'Color', [0.4 0.4 0.4], 'LineWidth', 2,'DisplayName', 'Original');

plot(bpa(i).Ak, bpa(i).strain_p/kmax, '-', 'Color', '#CD34B5', 'LineWidth', 2.5,'DisplayName', 'Predicted');

title(['\bf ' labels(i)], 'Interpreter', 'tex');

% Tile-specific title and annotation label

title(['\bf ' labels(i)], 'Interpreter','tex');

annotation(figS, 'textbox', [xAnn(j) yAnn(j) 0.05 0.05], 'String', ['\bf ' tileLabels{j}], ...

'FontSize', 12, 'FontName', 'Arial', 'EdgeColor', 'none', 'HorizontalAlignment','center');

% Axis config

set(gca, ...

'FontSize', 12, ...

'FontWeight', 'bold', ...

'FontName', 'Arial', ...

'LineWidth', 2, ...

'XMinorTick', 'on', ...

'YMinorTick', 'on', ...

'TickLength', [0.025 0.05], ...

'GridLineStyle','none');

end

%shared axes labels

ylabel(tS,'\bf Torque, N\cdotm','Interpreter','tex')

xlabel(tS,'\bf \theta_{k} , \circ','Interpreter','tex')

% Legend in top-right tile only

lg = legend(tS.Children(end-1));

lg.Location = 'northeast';

lg.FontSize = 8;

%% Helper functions

function ff = min1(x, trainIdx)

if numel(x) == 4 && size(x,1) == 1

% OK

else

error('min1: Input x must be a 1x4 vector');

end

Xi0 = x(1) / 100;

Xi1 = 10^x(2);

Xi2 = 10^x(3);

Xi3 = x(4);

try

[f_all, ~] = minimizeExtX3(Xi0, Xi1, Xi2, Xi3, trainIdx); % Nx3 matrix (e.g., 3x3 if 3 training BPAs)

ff = mean(f_all(trainIdx, :), 1, 'omitnan'); % Return 1x3: [mean RMSE, mean FVU, mean MaxResidual]

if ~isnumeric(ff) || numel(ff) ~= 3

ff = [Inf, Inf, Inf]; % Defensive return if shape is wrong

end

catch

ff = [Inf, Inf, Inf]; % Defensive return if minimizeExtX3 throws

end

end

%% --- Nonlinear constraint

function [c, ceq] = nonlinc(X, baseline, trainIdx)

% Inputs:

% X = [Xi0_cm, log10(Xi1), log10(Xi2), , Xi3_%]

% baseline = baselineScores (size: 4x3)

% trainIdx = which BPAs are being optimized

try

% Convert to physical parameters

Xi0 = X(1) / 100;

Xi1 = 10^X(2);

Xi2 = 10^X(3);

Xi3 = X(4);

% Call model with current X on the training BPAs

[f_all, ~] = minimizeExtX3(Xi0, Xi1, Xi2, Xi3, trainIdx);

% beat the average baseline, not per-BPA

mean_baseline = mean(baseline(trainIdx,:), 1, 'omitnan'); % 1x3

mean_model = mean(f_all, 1, 'omitnan'); % 1x3

c = mean_model - mean_baseline; % Element-wise (positive means violation)

ceq = [];

if any(c > 0)

% fprintf('[nonlinc] Violated mean at x = %.4f, %.4f, %.4f %.4f\n', X);

end

catch

% fprintf('[nonlinc] Error — invalid at x = %.4f, %.4f, %.4f %.4f\n', X);

c = ones(4, 1) * 1e3; % Large penalty

ceq = [];

end

end

function [c, ceq] = nonlcon2(x)

% Inequality constraints (c <= 0)

c = x(3) - x(2); % This ensures x(3) < x(2)

% No equality constraints

ceq = [];

end

function [state, options, optchanged] = debugPop(options, state, flag)

optchanged = false; % required for gamultiobj

if strcmp(flag, 'iter') || strcmp(flag, 'done')

if isfield(state, 'Population')

fprintf('[debugPop] Generation %d\n', state.Generation);

assignin('base', 'currentPop', state.Population);

assignin('base', 'currentScores', state.Score);

end

end

end

function [state, options, optchanged] = gaplotpareto3D_simple(options, state, flag)

optchanged = false; % Must be returned even if unchanged

persistent figHandle

if strcmp(flag, 'init') || isempty(figHandle) || ~isvalid(figHandle)

figHandle = figure(99);

set(figHandle, 'Name', 'Live Pareto Front', 'NumberTitle', 'off');

end

if strcmp(flag, 'iter') || strcmp(flag, 'done')

scores = state.Score;

if ~isempty(scores) && isnumeric(scores) && size(scores,2) == 3

figure(figHandle);

scatter3(scores(:,1), scores(:,2), scores(:,3), 50, 'filled');

xlabel('\bf RMSE', 'FontSize', 12);

ylabel('\bf FVU', 'FontSize', 12);

zlabel('\bf Max Residual', 'FontSize', 12);

title('\bf Pareto Front (Training Set)', 'FontSize', 14);

grid on;

view(135, 30);

drawnow;

end

end

end

Here is my matlab code for minimizeFlxPin10mm.m

%%minimizeFlxPin10mm.m

%Minimization scheme

clear; clc; close all

[a, b, ~] = minimizeFlxPin(0,Inf,Inf); %Get current goodness of fit measures with no extra length and infinite bracket stiffness

%% Problem setup

lb = [-0.03*100, 3, 3];

ub = [0.03*100, 9, 9];

%% Solve

opts = optimoptions('gamultiobj', ...

'UseParallel', true, ...

'Display', 'iter', ...

'InitialPopulationRange',[-.003*100 log10(700) log10(370); 0.015*100 5 4], ...

'PopulationSize', 75, ...

'MaxGenerations', 600, ...

'MutationFcn', {@mutationadaptfeasible}, ...

'CrossoverFraction', 0.8, ...

'CrossoverFcn', {@crossoverscattered}, ...

'PlotFcn', {@gaplotpareto}, ...

'FunctionTolerance', 1e-5);

goal = [0 0 0];

weight = [1 3 0.25];

opts.HybridFcn = {@fgoalattain, goal, weight};

[x, fvals, exitflag, output, population, scores] = gamultiobj( ...

@min1, 3, ...

[], [], [], [], ...

lb, ub, ...

@(x) nonlinc(x), ...

opts);

% [sol,fval,Pareto_front, Pareto_Fvals, exitflag,output] = GODLIKE(@min1,lb,ub,[],'NumObjectives',3,...

% 'algorithms', {'DE';'GA';'ASA';'PSO'},...

% 'display' , 'plot',...

% 'popsize' , 75 );

% x = Pareto_front;

% fvals = Pareto_Fvals;

%% Get validation GoF results from pareto front

val_Fvals = zeros(size(fvals));

for i = 1:length(x)

val_Fvals(i,:) = min2([x(i,1),x(i,2),x(i,3)]); %Get validation Fvals for all Pareto_front points

end

%% Sort results

ind = 1:length(x); %Index to original Pareto_front and Pareto_Fvals

relate = vecnorm(fvals-val_Fvals,2,2); %Find the distance between the optimization and validation solutions for the same input

results = [ind', x, fvals, val_Fvals, relate];

results_sort = sortrows(results,[11 8 9 10 5 6 7]); %Sort results first on distance between optimization and validation, then on validation columns, then on original Fvals columns.

results_sort_actual = [results_sort(:,1), results_sort(:,2)/100, 10.^results_sort(:,3), 10.^results_sort(:,4), results_sort(:,5:end)];

%% Pick ultimate solution

pick = 1; %Pick the best solution from the sorted results (should be 1)

sol_actual = results_sort_actual(pick, 2:4); %Best solution

[u,v,bpa] = minimizeFlxPin(sol_actual(1),sol_actual(2),sol_actual(3)); % Now pull bpa structures out

%% --- Define color scheme and labels ---

c = cell(8,1);

c{1} = '#FFD700'; % gold ? Hybrid

c{2} = '#FFB14E'; % orange

c{3} = '#FA8775'; % light orange

c{4} = '#EA5F94'; % pink

c{5} = '#CD34B5'; % magenta ? Predicted

c{6} = '#9D02D7'; % magenta 2

c{7} = '#0000FF'; % indigo ? Measured

c{8} = '#000000'; % black

tileLabels = {'(A)', '(B)', '(C)', '(D)'};

% Annotation positions [x, y] in normalized figure units

xAnn = [0.035, 0.51, 0.035, 0.51]; % (A), (B), (C), (D)

yAnn = [0.89, 0.89, 0.41, 0.41]; % (A), (B), (C), (D)

sz = 60;

%% Plot torque curves, Optimized and validation

load ForceStrainForFit.mat z

X = linspace(0,620,20); %Pressure for interpolation

X = X(2:20);

Y = linspace(0,1,30); %Relative strain range for interpolation

str = ["Optimization"; "Validation"];

str2 = ["Torque"; "Muscle Length"; "Moment Arm"];

for i = 1:2

%Find old old torque, then plot everything

clear Yq Xq Vq Fold Fq Mold

Yq = bpa(i).strain./((bpa(i).rest-bpa(i).Kmax)/bpa(i).rest);

Xq = bpa(i).P;

Vq = zeros(size(bpa(i).unitD,1),1);

for j = 1:size(bpa(i).unitD, 1)

if bpa(i).strain(j) >=-0.03 && Yq(j) <=1

Vq(j) = interp2(X, Y, z, Xq, Yq(j));

% Vq(j) = f10(Yq(j),Xq);

elseif Yq(j)>1

Vq(j) = 0;

elseif bpa(i).strain(j) < -0.03

Vq(j) = NaN;

end

end

Fold = Vq.*bpa(i).unitD; %Force vector

Fq = (Fold(:,1).^2+Fold(:,2).^2).^(1/2);

Mold = -bpa(i).mA.*Fq;

figure

ax = gca;

hold on

scatter(bpa(i).Aexp,bpa(i).Mexp,[],'filled','DisplayName','Experiment')

scatter(bpa(i).A_h,bpa(i).M_h,[],'filled','DisplayName','Hybrid')

plot(bpa(i).Ak,bpa(i).M_p(:,3),'DisplayName','New predict')

plot(bpa(i).Ak,bpa(i).M,'DisplayName','Predict original') %"original" is with updated BPA characterization

plot(bpa(i).Ak,Mold,'DisplayName','Predict old') %"original" is with updated BPA characterization

hold off

title(sprintf('Torque, %s',str(i)))

xlabel('\theta_{k}, \circ')

ylabel('Torque, N\cdotm')

legend

end

%% Plot muscle length, optimization and validation

for i = 1:2

figure

ax = gca;

Lm = bpa(i).Lmt-2*bpa(i).fitn-bpa(i).ten; %Original predicted muscle length

Lm_p = bpa(i).Lmt_p-2*bpa(i).fitn-bpa(i).ten; %Optimized muscle length (Lmt_p uses sol_actual(1)

hold on

scatter(bpa(i).A_h,bpa(i).Lm_h,[],'filled','DisplayName','Measured')

plot(bpa(i).Ak,Lm_p,'DisplayName','New predict')

plot(bpa(i).Ak,Lm,'DisplayName','Predict original')

hold off

title(sprintf('Muscle length, %s',str(i)))

xlabel('\theta_{k}, \circ')

ylabel('Length, m')

legend

end

%% Plot moment arm, optimization and validation

for i = 1:2

figure

ax = gca;

G_p = (bpa(i).mA_p(:,1).^2+bpa(i).mA_p(:,2).^2).^(1/2); %z-axis moment arm for optimized

hold on

scatter(bpa(i).A_h,bpa(i).mA_h,[],'filled','DisplayName','Measured')

plot(bpa(i).Ak,G_p,'DisplayName','New predict')

plot(bpa(i).Ak,bpa(i).mA,'DisplayName','Predict original')

hold off

title(sprintf('Moment arm, %s',str(i)))

xlabel('\theta_{k}, \circ')

ylabel('Length, m')

legend

end

%% Helper functions

function ff = min1(x)

ff = minimizeFlxPin(x(:,1)./100,10.^x(:,2),10.^x(:,3)); %get GOF vector

end

function gg = min2(x)

[~, gg] = minimizeFlxPin(x(:,1)./100,10.^x(:,2),10.^x(:,3)); %get validation vector

end

function [c, ceq] = nonlinc(X)

% Evaluate the model

[f, g] = minimizeFlxPin(X(:,1)/100, 10^X(:,2), 10^X(:,3));

% Baseline a, b must be pre-loaded or set globally

persistent a_local b_local

if isempty(a_local) || isempty(b_local)

[a_local, b_local, ~] = minimizeFlxPin(0, Inf, Inf);

end

% Constraints: f < a and g < b

c = [f - a_local; g - b_local];

ceq = [];

end

I want the axes and colors of minimizeFlxPin10mm to match minimizeExt10mmX3, and I want the general plotting style of the later not the former. Keep the rest of the code the same as much as possible. For my plots, I want 1 figure for Torque, 1 figure for muscle length, 1 figure for moment arm, and 1 figure for relative strain. These figures will be 2x2 tiles. The shared axes y label will be Torque for figure 1, just as it in in minimizeExt10mmX3, and likewise the next figure’s y labels will change like in the example code. The shared x axis label will be the knee angle. The first row will have a y label title (tile 1) “Pre-optimization” and the second row will have a y label title (tile 3) of “Optimized”. Put a title on tile 1 labeled “Optimization”, that will represent column 1, and put a title on tile 2 labelled “Validation”, that will represent the second column. Put a legend in tile 2 and tile 4. In the first row, put in data for Hybrid (gold) and Measured (indigo). Then put in what was called “Predict, old” as a black dashed line and change display name as “Original”. Put in data for what was called ‘Predict original’ and change display name to ‘Improved BPA model’. In the second row, put in data for Measured, Improved BPA model, and ‘New predict’, but change display name to ‘Optimized prediction’. Make sure the axes are bold thick lines with minor tick marks like in minimizeExt10mmX3. Make the X axis limit [-120 20] and the y axis limit [-35 0] for the Torque figure.
