Agile-and-Adaptive-Robotics/Bipedal_Robot/Documentation/Reports and Papers/Knee_Torque_Test/Figures/bktFrame.pdf

(A)

(B)

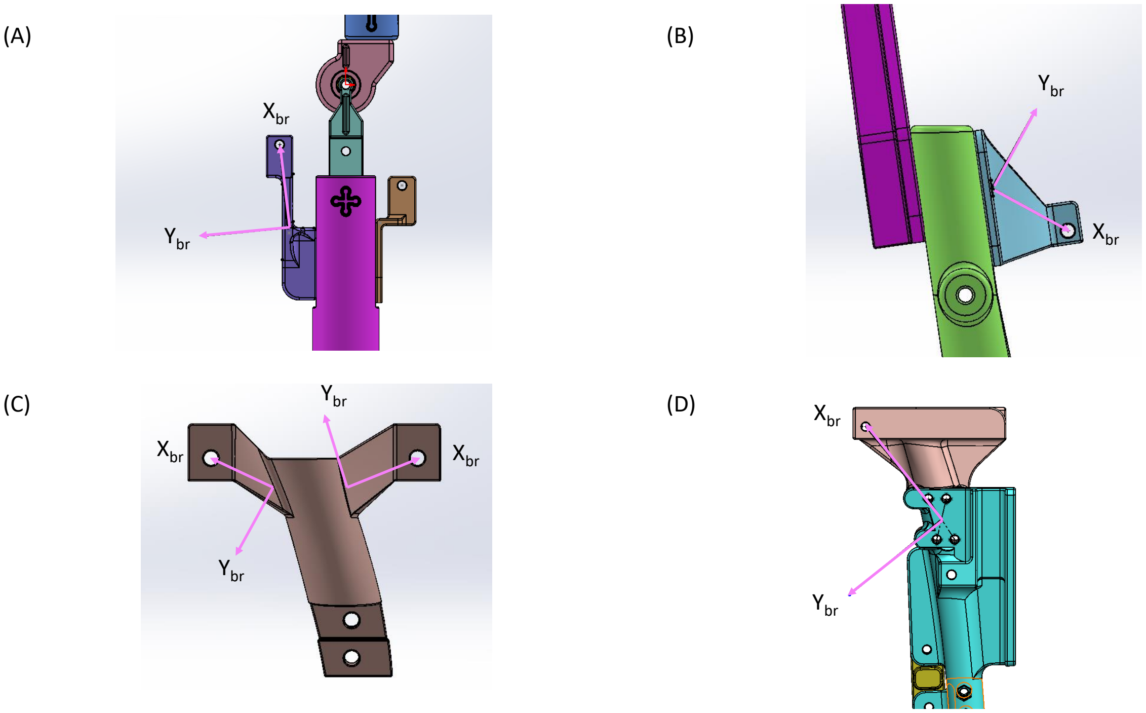
[picture p251: page 1]

(C)

(D)

Ybr

Y

Xbr br | Ybr Ybr Ybr Xbr | Xbr

Xbr

Xbr
