Agile-and-Adaptive-Robotics/Bipedal_Robot/Testing_Data/StraightForceTest.xlsx

Sheet: 11.2 cm, no T
resting length (mm) | 112 |  | Batch | D21
max contraction (mm) | 94
Max Strain | 0.1607142857
inflated length (mm) | Force (lbs) | Force (N) | Pressure (kPa) | strain | relative strain
111 | 73.1 | 325.164999 | 620 | 0.008928571429 | 0.05555555556
107 | 56.8 | 252.6589869 | 620 | 0.04464285714 | 0.2777777778
102 | 30.5 | 135.6707588 | 620 | 0.08928571429 | 0.5555555556
98 | 20.1 | 89.40925416 | 620 | 0.125 | 0.7777777778
93 | 3 | 13.3446648 | 620 | 0.1696428571 | 1.055555556
94 | 0 | 0 | 620 | 0.1607142857 | 1
 |  |  |  |  |  | x | F'
 |  |  |  |  |  | 111 | 325
 |  |  |  |  |  | 415 | 445
 | Fmax | 343.3
 | 0.9471744799
 | 0.7359714153
 | 0.3951959184
 | 0.2604405889
 | 0.03887172968
 | 0
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
