Agile-and-Adaptive-Robotics/Bipedal_Robot/Testing_Data/2022_02_Festo/Results_table_10mm_pinned_FishScale.xlsx

Sheet: ExtTest10mm_1
Extensor Test 10mm
Resting muscle length |  | 457
 | expected max contract | 379.31
 | tendon | 0
 | Test # | 1 | 2 | 3 | 4 | 5 | 6 | 7 | 8 | 9 | 10 | 11 | 12 | 13 | 14 | 15
 | Load (N) | 22.3 | 21.6 | 18.6 | 13.7 | 9.8 | 7.8 | 5.9 | 4.9 | 0
 | Knee angle | -102 | -100 | -81.5 | -66 | -47 | -35 | -17 | -11 | -5
Hand | Load cell angle (real ICR) | 68.1 | 67.9 | 68.6 | 70.8 | 70.8 | 72.3 | 74.9 | 75.4 | 77.5
 | Load cell angle (tibia)
 | muscle length | 430 | 430 | 420 | 415 | 410 | 401 | 390 | 388 | 385
MA | ICR (spline)
 | Tibia origin (matlab) | 268.06 | 268.06 | 268.06 | 268.06 | 268.06 | 268.06 | 268.06 | 268.06 | 268.06 | 268.06 | 268.06 | 268.06 | 268.06 | 268.06
 | ICR to muscle | 30 | 30 | 30 | 30 | 34 | 35 | 45 | 50 | 55
 | dl/dtheta
 | Torque | 5.969270431 | 5.781894229 | 4.978853364 | 3.667219951 | 2.623266826 | 2.087906249 | 1.579313702 | 1.311633413 | 0 | 0 | 0 | 0 | 0 | 0
 |  |  |  |  |  | *Fish scale seems to be +/- 1 N
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
