Agile-and-Adaptive-Robotics/Bipedal_Robot/Testing_Data/2022_02_Festo/Results_table_10mm_pinned_LoadCell.xlsx

Sheet: ExtTest10mm_1
Extensor Test 10mm
Resting muscle length |  | 486 |  |  | ^ Collected by Jason
 | expected max contract | 403.38
 | actual max contraction | 405
 | Test # | 1 | 2 | 3 | 4 | 5 | 6 | 7 | 8 | 9 | 10 | 11 | 12 | 13 | 14 | 15 | 16 | 17 | 18 | 19 | 20 | 21 | 22 | 23 | 24 | 25 | 26 | 27 | 28 | 29 | 30 | 31 | 32 | 33
 | Load (N) | 17.55 | 17.081 | 16.28 | 15.18 | 12.961 | 10.72 | 5.8839 | 4.644 | 1.68 | -0.311 | 2.074 | 4.8477 | 8.542 | 12.151 | 14.59 | 16.151 | 17.783 | 18.549 | 19.586 | 23.168
 | Knee angle | -121.5 | -108.5 | -101.5 | -94 | -83 | -75 | -61.5 | -65 | -32 | -18 | -32.5 | -47.5 | -57.5 | -69.5 | -80 | -90.5 | -96.5 | -104 | -113.5 | -123
Hand | Load cell angle (real ICR) | 93 | 93 | 93 | 93 | 93 | 93 | 82 | 82 | 82 | 80 | 80 | 80 | 90.6 | 90.6 | 90.6 | 84.4 | 84.4 | 84.4 | 84.4 | 84.4
 | Load cell angle (tibia)
 | muscle length | 455.5 | 461 | 451 | 451 | 440 | 438.5 | 435 | 415.5 | 413 | 410 | 409.5 | 418 | 426.5 | 438 | 442.5 | 441.5 | 450 | 458.5 | 455.5 | 463
MA | ICR (spline)
 | Tibia origin (matlab) | 264 | 264 | 264 | 264 | 264 | 264 | 264 | 264 | 264 | 264 | 264 | 264 | 264 | 264 | 264 | 264 | 264 | 264 | 264 | 264 | 264 | 264 | 264
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
