Agile-and-Adaptive-Robotics/Bipedal_Robot/Testing_Data/2021_12_Festo/Results_table.xlsx

Sheet: ExtTest1
Flex Test 3
Resting muscle length |  | 375
 | Test # | 1 | 2 | 3 | 4 | 5 | 6 | 7 | 8 | 9 | 10 | 11 | 12 | 13 | 14 | 15
 | Load (N) | 27.163
 | Knee angle | 118
Hand | Load cell angle | 17
 | muscle length | 354
MA | ICR (spline)
 | ICR (hand) | 234
 | Tibia origin (matlab) | 249.71 | 249.71 | 249.71 | 249.71 | 249.71 | 249.71 | 249.71 | 249.71 | 249.71 | 249.71 | 249.71 | 249.71 | 249.71 | 249.71 | 249.71
 | ICR to muscle | 55
 | dl/dtheta
 | Torque | 6.486791673 | 0 | 0 | 0 | 0 | 0 | 0 | 0 | 0 | 0 | 0 | 0 | 0 | 0 | 0

Sheet: FlxTest1
Flex Test 3
Resting muscle length |  | 375
 | Test # | 1 | 2 | 3 | 4 | 5 | 6 | 7 | 8 | 9 | 10 | 11 | 12 | 13 | 14 | 15
 | Load (N) | 27.163
 | Knee angle | 35
Hand | Load cell angle (real ICR) | 6
 | Load cell angle (tibia)
 | muscle length | 418
MA | ICR (spline)
 | ICR (hand) | 225
 | Tibia origin (matlab) | 249.71 | 249.71 | 249.71 | 249.71 | 249.71 | 249.71 | 249.71 | 249.71 | 249.71 | 249.71 | 249.71 | 249.71 | 249.71 | 249.71 | 249.71
 | ICR to muscle | 72
 | dl/dtheta
 | Torque | 6.682074618 | 0 | 0 | 0 | 0 | 0 | 0 | 0 | 0 | 0 | 0 | 0 | 0 | 0 | 0
