Agile-and-Adaptive-Robotics/Bipedal_Robot/Testing_Data/2021_05_Festo10mm/Results_table.xlsx

Flex Test 3
Resting muscle length |  | 375
 | Test # | 1 | 2 | 3 | 4 | 5 | 6 | 7 | 8 | 9 | 10 | 11 | 12 | 13 | 14 | 15
 | Load (N) | 33.36 | 30.25 | 29.3583 | 21.7963 | 20.4618 | 16.4584 | 13.3447 | 11.5654 | 10.2309 | 8.0068 | 6.6723 | 4.44482 | 2.6689 | 1.7793 | 0.4448
 | Knee angle | 26.828 | 31.174 | 30.936 | 36.081 | 39.67 | 41.189 | 42.614 | 45.733 | 47.827 | 49.955 | 53.13 | 53.673 | 54.199 | 56.56 | 58.392
Image | Load cell angle | 69.796 | 76.013 | 72.005 | 72.267 | 73.513 | 71.546 | 73.569 | 71.214 | 71.264 | 71.483 | 69.388 | 67.57 | 76.22 | 75.854 | 80.57
 | muscle length | 344.2
Hand | Load cell angle | 13
 | muscle length | 341
MA | ICR (spline) | 227.2552926 | 227.1109592 | 227.1188732 | 226.9467087 | 226.8232909 | 226.7696427 | 226.7183467 | 226.6021678 | 226.5208311 | 226.4354965 | 226.3034272 | 226.2802961 | 226.2577429 | 226.154786 | 226.073032
 | ICR (image)
 | Theta1
 | dl/dtheta
 | Torque | 7.113136537 | 6.665293601 | 6.340343593 | 4.71060257 | 4.449527719 | 3.539596694 | 2.901372937 | 2.480600054 | 2.194234049 | 1.718798005 | 1.412978615 | 0.9294550496 | 0.5863815642 | 0.3901288722 | 0.09918663424
