Agile-and-Adaptive-Robotics/Bipedal_Robot/Testing_Data/2021_03_Festo10mm/10 mm Model Generated Torque Data_Mar2021.xlsx

Sheet: Notes
In the next four sheets, I've tabulated data for the force and torque generation for each muscle/muscle group and pam.
The human extensor muscle is a combination of three muscles that compose the vastus group, making direct comparison a little more difficult.
The x direction refers to point away and in front of the body horizontally.
The y direction refers to points toward the top of the head vertically.
The z direction refers to pointing toward the right side of the body horizontally.

Sheet: Flexor Muscle
Human Muscle (Bicep Femoris Short Head)
Force (N) |  |  | Torque (Nm) |  |  | Moment Arm (m)
X Force | Y Force | Z Force | X Torque | Y Torque | Z Torque | X Moment Arm | Y Moment Arm | Z Moment Arm | Angle
-508.0709101 | -202.4478931 | -19.37342673 | 6.568432261 | -15.31525919 | -12.21711597 | 0.007267597875 | -0.02115020931 | 0.0304210636 | -119.9999999
-513.7455667 | -189.2025395 | -19.38009605 | 6.184557102 | -15.48002432 | -12.81876422 | 0.007081918959 | -0.02234344763 | 0.03039884643 | -118.6868685
-519.1758296 | -175.8316703 | -19.38801154 | 5.797086855 | -15.6377394 | -13.41537975 | 0.006833166578 | -0.02352554176 | 0.03037549134 | -117.3737372
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
