Agile-and-Adaptive-Robotics/Bipedal_Robot/Documentation/Reports and Papers/Isometric_Force_Test/Tables/CoefficientTable.xlsx

Sheet: Coefficient table
Equation | Coefficient | CI (95\%) | Model |  |  | Validation
 |  |  | Adj. R^2 | RMSE | Max. Error | Adj. R^2 | RMSE | Max. Error
\ref{eq:Fmax10} | $a_1 =\qty{304.3}{\N}$ | (298.2, 310.5) | 0.9832 | 13.62 | 28.8 N | -- | -- | --
 | $a_2 = \qty{19.66}{\per\m}$ | (17.44, 21.88)
\ref{eq:Fmax_3D} | $a_1 = \qty{0.4909}{\N\per\kPa}$ | (0.481, 0.5008) | 0.9868 | 13.62 N | 28.8 N | 0.922 | 14.08 N | 51 N
 | $a_2 = \qty{0.03171}{\per\kPa\per\m}$ | (0.02813, 0.03528)
\ref{eq:Fmax20} | $a_1 = \qty{1.51}{\N\per\kPa}$ | (1.494, 1.526) | 0.9927 | 27.4 N | 75.5 N | -- | -- | --
 | $a_2=\qty{0.0224}{\per\kPa\per\m}$ | (0.02138, 0.02337)
\ref{eq:exp10mm}, Festo data | a_0 = -0.4039 | (-0.4279, -0.3799) | 0.9945 | 0.02657 | 6.9\% | 0.9826 | 0.0465 | 14.2\%
 | a_1 = 6.269 | (5.794, 6.745)
 | a_2 = 0.9842 | (0.9067, 1.062)
\ref{eq:exp10mm}, Experiment data | a_0 = -0.5756 | (-0.6105, -0.5406) | 0.9958 | 0.02268 | 16.8\% | 0.9884 | 0.03874 | 10.7\%
 | a_1 = 4.085 | (3.666, 4.505)
 | a_2 = 0.5497 | (0.4913, 0.681)
\ref{eq:exp20mm} | b_0 = -0.2404 | (-0.2639, -0.2169) | 0.9959 | 0.01838 | 6.4\% | -- | -- | --
 | b_1 = 7.047 | (6.18, 7.915)
 | b_2 = 1.412 | (1.296, 1.528)
\ref{eq:exp40mm} | c_0 = -0.119 | (-0.1501, -0.08788) | 0.9853 | 0.03754 | 9.6\% | -- | -- | --
 | b_1 = 10.83 | (7.391, 14.28)
 | b_2 = 2.141 | (1.828, 2.455)

Sheet: F_rel
Equation | Coefficient | CI (95\%) | Model |  |  | Validation
 |  |  | Adj. $R^2$ | RMSE | Max. Error | Adj. $R^2$ | RMSE | Max. Error
\ref{eq:exp},\\ $\phi\qty{10}{\mm}$,\\ Festo data | $c_0 = 0.3976$ | (0.3753, 0.42) | 0.9948 | 0.02583 | 6.9\% | 0.9882 | 0.03877 | 14.4\% | *LAR
 | $c_1 = 6.482$ | (6.022, 6.943)
 | $c_2 = 0.998$ | (0.9238, 1.072)
\ref{eq:exp},\\ $\phi\qty{10}{\mm}$,\\ Experiment data | $c_0 = 0.5822$ | (0.5742, 0.5902) | 0.9998 | 0.004537 | 10.6\% | 0.9878 | 0.03966 | 11.4\% | *LAR
 | $c_1 = 4.142$ | (4.043, 4.241)
 | $c_2 = 0.5368$ | (0.5235, 0.55)
\ref{eq:exp},\\ $\phi\qty{20}{\mm}$,\\ Festo data | $c_0 = 0.2165$ | (0.1922, 0.2408) | 0.9952 | 0.01992 | 3.8\% | 0.9904 | 0.02626 | 7.6\% | *LAR
 | $c_1 = 7.583$ | (6.557, 8.609)
 | $c_2 = 1.515$ | (1.384, 1.646)
\ref{eq:exp},\\ $\phi\qty{20}{\mm}$,\\ Experiment data | $c_0 = 0.2607$ | (0.2442, 0.2773) | 0.9927 | 0.02291 | 6.9\% | 0.995 | 0.02019 | 6.5\% | *LAR
 | $c_1 = 6.398$ | (5.584, 7.212)
 | $c_2 = 1.303$ | (1.228, 1.378)
\ref{eq:exp40} | $c_0 = 0.1224$ | (0.08954, 0.1552) | 0.9834 | 0.03911 | 10.0\% | -- | -- | -- | *LAR
 | $c_1 = 10.47$ | (6.955, 13.99)
 | $c_2 = 2.023$ | (1.715, 2.331)

Sheet: Fmax
Equation | Coefficient | CI (95\%) | Model |  |  | Comparison
 |  |  | Adj. $R^2$ | RMSE | Max. Error | Adj. $R^2$ | RMSE | Max. Error
\ref{eq:Fmax_3D} | $a_1 = \qty{0.4895}{\N\per\kPa}$ | (0.4822, 0.4968) | 0.9945 | 11.61 N | 55.3 N | 0.9854 | 14.7 N | 30.9 N | *Bisquare
 | $a_2 = \qty{0.03068}{\per\kPa\per\m}$ | (0.0282, 0.03317)
\ref{eq:Fmax10} | $b_1 =\qty{303.5}{\N}$ | (300, 308) | 0.9854 | 14.72 N | 30.9 N | -- | 189.9 N | 375.6 N | *No robustness
 | $b_2 = \qty{19.03}{\per\m}$ | (17.48, 20.57)
\ref{eq:Fmax20} | $b_1 = \qty{922.4}{\N}$ | (914.2, 930.7) | 0.9945 | 23.83 N | 62.1 N | -- | 668.4 N | 1590.1 N | *Bisquare
 | $b_2=\qty{15.37}{\per\m}$ | (14.75, 15.98)
kmax | p1 = 0.03309
f(x) = p1*x + p2 | p2 = 0.153 |  | 0.4671 | 0.008326 | 0.1855

Sheet: Gof_FlxExt
Configuration |  | \phi | BPA l_{rest}, cm | Pre-optimization |  |  | Optimized
 |  |  |  | RMSE, N\cdotm | FVU | Max. Residual, N\cdotm | RMSE, N\cdotm | FVU | Max. Residual, N\cdotm
Flexor | Pinned knee | 10 | 48.5 | 4.8706 | 0.7233 | 9.8648 | 1.6075 | 0.0948 | 3.2421
 |  | 10 | 45.7 | 3.0239 | 0.1632 | 6.7526 | 1.9151 | 0.0716 | 4.6946
 | Biomimetic knee | 10 | 41.5 | 7.4482 | 5.5566 | 13.3084 | 0.6803 | 0.0522 | 1.0546
 |  | 20 | 41.5 | 14.8028 | 3.3656 | 23.7147 | 2.8676 | 0.1263 | 3.5498
Extensor | Pinned knee | 10 | 41.5 | 4.519708138 | 3.972200431 | 11.74121097 | 2.041789489 | 0.8444249692 | 3.587614524
 |  | 10 | 45.7 | 1.999201948 | 0.8921370037 | 4.609207977 | 0.8956232284 | 0.1790477706 | 1.846391082
 |  | 10 | 48 | 0.8447056029 | 0.2317390051 | 1.951453724 | 0.6817848963 | 0.1509673878 | 2.067683579
 | Biomimetic knee | 10 | 51.8 | 3.032222218 | 4.485553101 | 5.587035721 | 1.460932969 | 1.041248841 | 2.755151592

Sheet: Optimized values
 | X0 | X1 | X2 | X3
Flexor | 0.0119 | 101740 | 10648 | N/A
Extensor | -0.0109 | 102000 | 10600 | 0.123
