Agile-and-Adaptive-Robotics/Bipedal_Robot/Documentation/Reports and Papers/Bolen_LM2023/Figures/Figure components/_deprecated/TestSchematic/TestSchematic.pptx

Swing Arm

Knee Joint

Pressurized Air

Load Cell

Tibia

Pressure Sensor

Air

Air

Physical Connections

BPA

Air

Valves

Data

Data

Amplifier

Microcontroller

Ground

Transistor

Negative

Computer

Data

On/Off

24V

+

Data

Power Supply
