Agile-and-Adaptive-Robotics/Bipedal_Robot/Code/Matlab/Bone_Mesh_Plots/testAnimated.gif

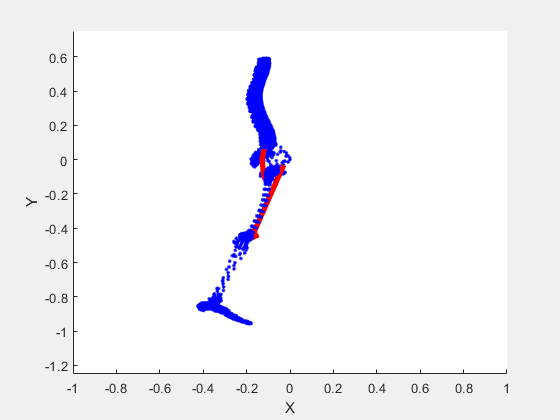
Code/Matlab/Bone_Mesh_Plots/testAnimated.gif
