Agile-and-Adaptive-Robotics/Bipedal_Robot/Documentation/Reports and Papers/Bolen_LM2023/Figures/Figure components/testJig/kinked.jpg

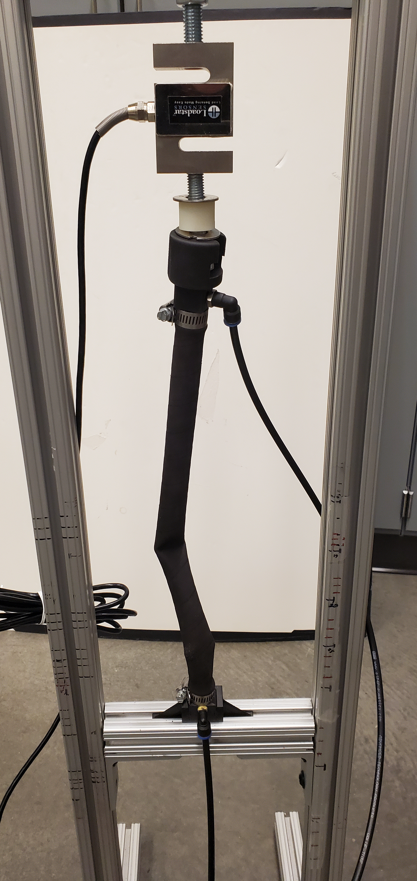
Documentation/Reports and Papers/Bolen_LM2023/Figures/Figure components/testJig/kinked.jpg
