Agile-and-Adaptive-Robotics/Bipedal_Robot/Documentation/Reports and Papers/Isometric_Force_Test/Abstract.png

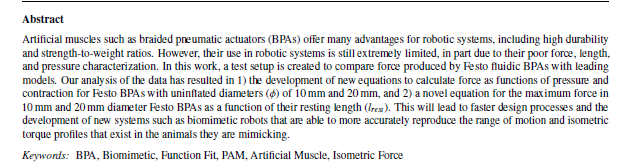
Documentation/Reports and Papers/Isometric_Force_Test/Abstract.png
