Agile-and-Adaptive-Robotics/Bipedal_Robot/Documentation/Reports and Papers/Isometric_Force_Test/Bending_bracket_math.jpg

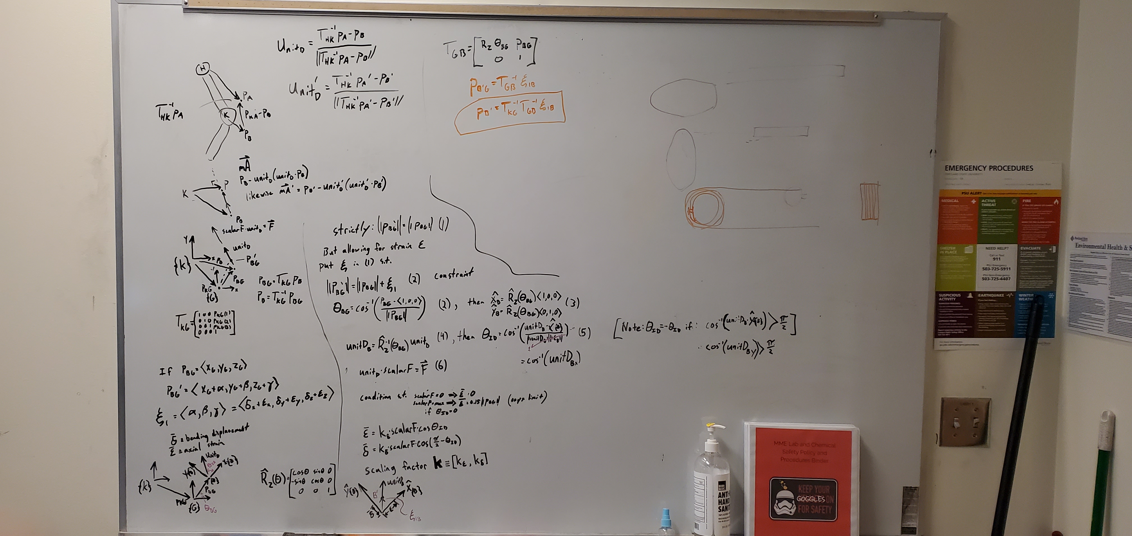
Documentation/Reports and Papers/Isometric_Force_Test/Bending_bracket_math.jpg
