Agile-and-Adaptive-Robotics/Bipedal_Robot/Documentation/Reports and Papers/Isometric_Force_Test/Figures/FlxPin_angleMisalign.png

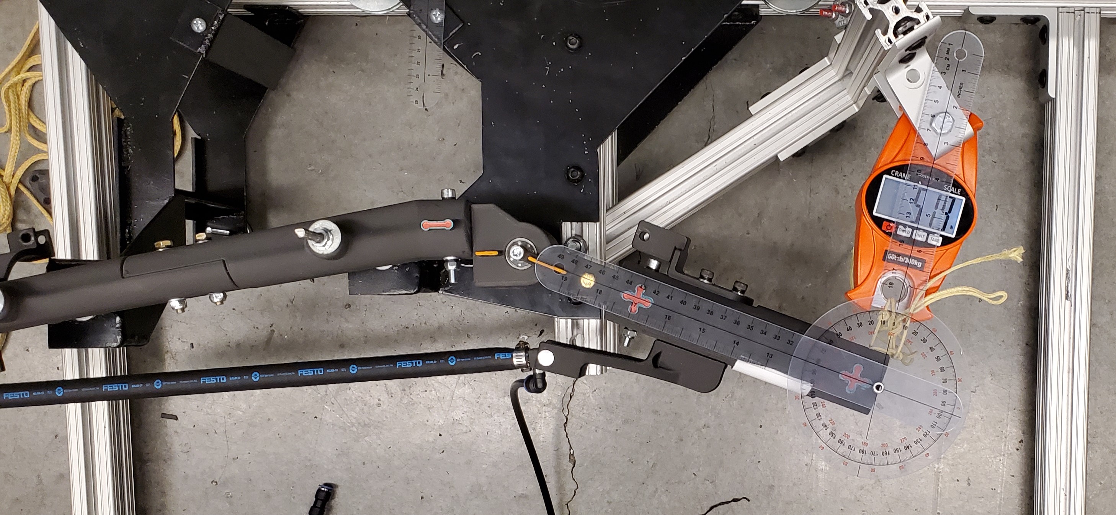
Documentation/Reports and Papers/Isometric_Force_Test/Figures/FlxPin_angleMisalign.png
