Agile-and-Adaptive-Robotics/Bipedal_Robot/Documentation/Reports and Papers/Knee_Torque_Test/Figures/extensor_misalign.png

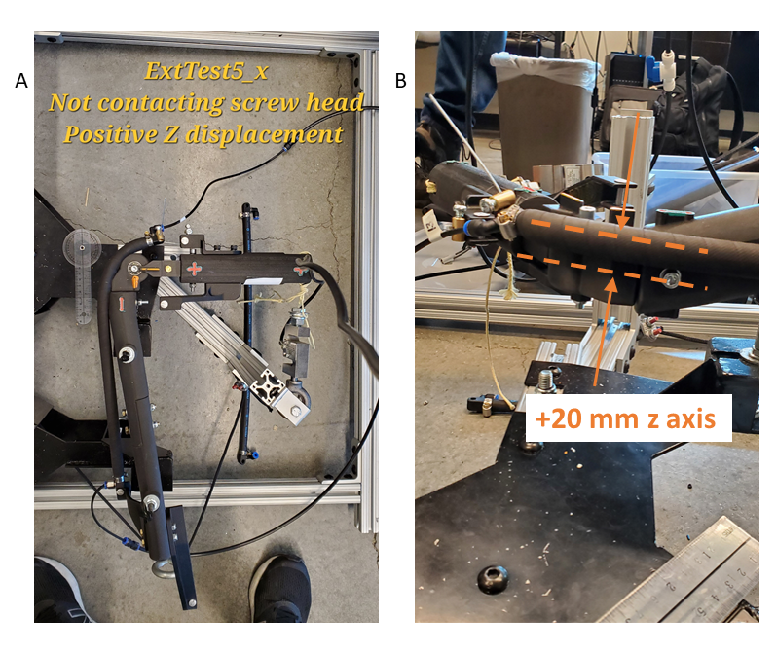
Documentation/Reports and Papers/Knee_Torque_Test/Figures/extensor_misalign.png
