Agile-and-Adaptive-Robotics/Bipedal_Robot/Documentation/Reports and Papers/Knee_Torque_Test/Figures/Flx20mm_42cm.png

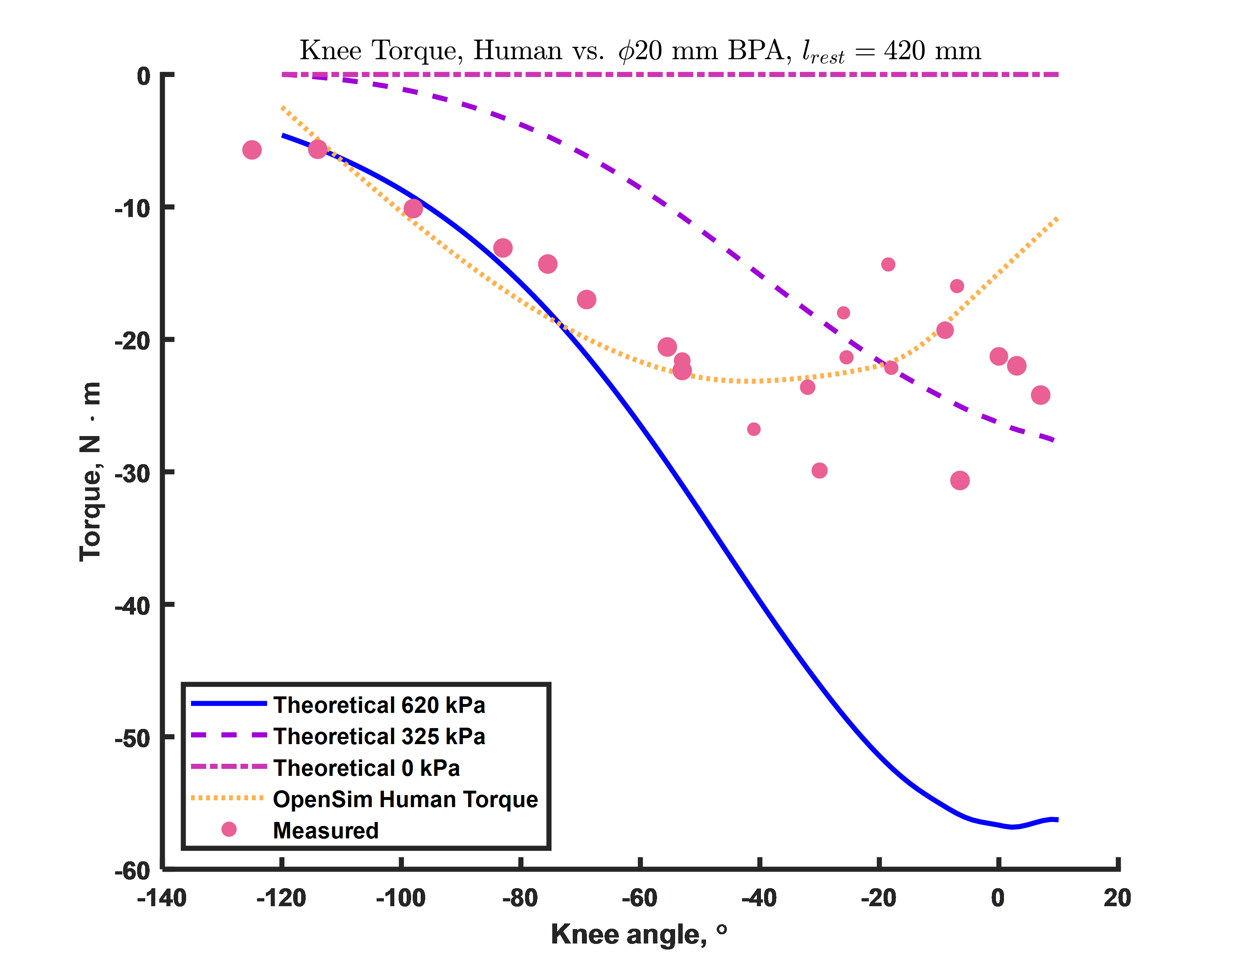
Documentation/Reports and Papers/Knee_Torque_Test/Figures/Flx20mm_42cm.png
