Agile-and-Adaptive-Robotics/Bipedal_Robot/Documentation/Reports and Papers/Knee_Torque_Test/Figures/Flx_brktBend.png

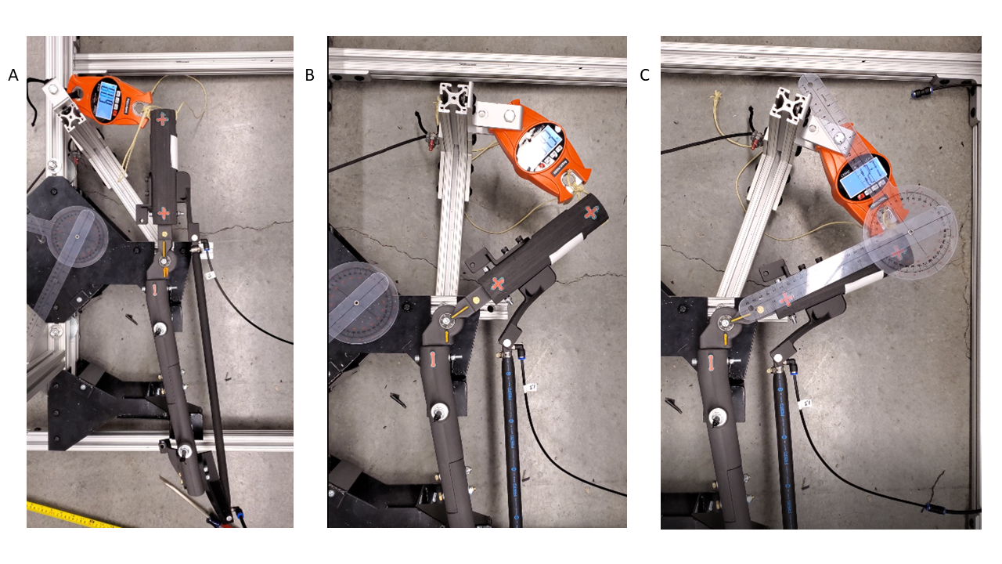
Documentation/Reports and Papers/Knee_Torque_Test/Figures/Flx_brktBend.png
