Agile-and-Adaptive-Robotics/Bipedal_Robot/Solid_Models/Biomimetics_2022-Knee_Test/Patella cutout sketch.png

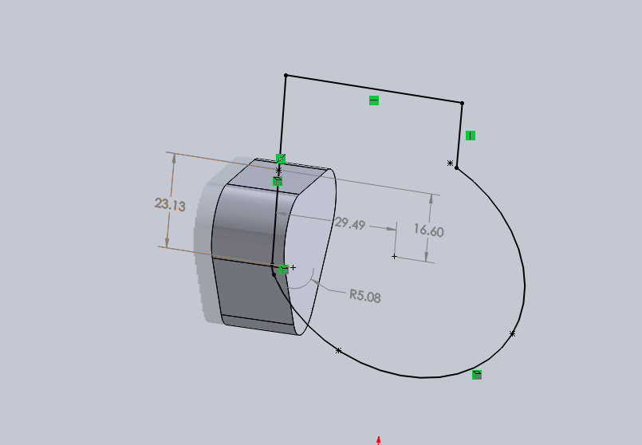
Solid_Models/Biomimetics_2022-Knee_Test/Patella cutout sketch.png
