Agile-and-Adaptive-Robotics/Bipedal_Robot/(threads)

Thread 20 (2020-08-26):

Adjust foot design to incorporate better attachment mechanisms

Conroy135, 2020-08-26:
Currently the foot design that Ty came up with is very akin to a puzzle box, i.e. it is held together by components that slide into a locking mechanism. This should be changed to allow for easier construction with the use of bolts and nuts.

Thread 21 (2020-08-26):

Adjust foot design to include bearings and axles

Conroy135, 2020-08-26:
The current foot design by Ty uses 3D printed components as axles and has multiple parts that slide against one another. The design should be updated to include bearings and metal axles to reduce friction.

Thread 23 (2020-08-26):

Create attachments for the Illums in the pelvis

Conroy135, 2020-08-26:
The current Pelvis has illums floating in space without support. The design intended to have BPAs fitted onto them to act as joints. I believe more investigation needs to go into this

Thread 24 (2020-08-26):

Alter the leg bone attachments

Conroy135, 2020-08-26:
Current attachments made by David between the femur and knee, knee and tibia, and tibia and foot each include a single bolt acting transaxially to the length of the leg. I'm worried this is allow for excessive warping or bending at the joints. Should look into an bolt that acts axially along the length of the leg or other alternatives.
