Agile-and-Adaptive-Robotics/Bipedal_Robot/Documentation/Reports and Papers/Knee_Torque_Test/Figures/Ext40mm_56cm.pdf

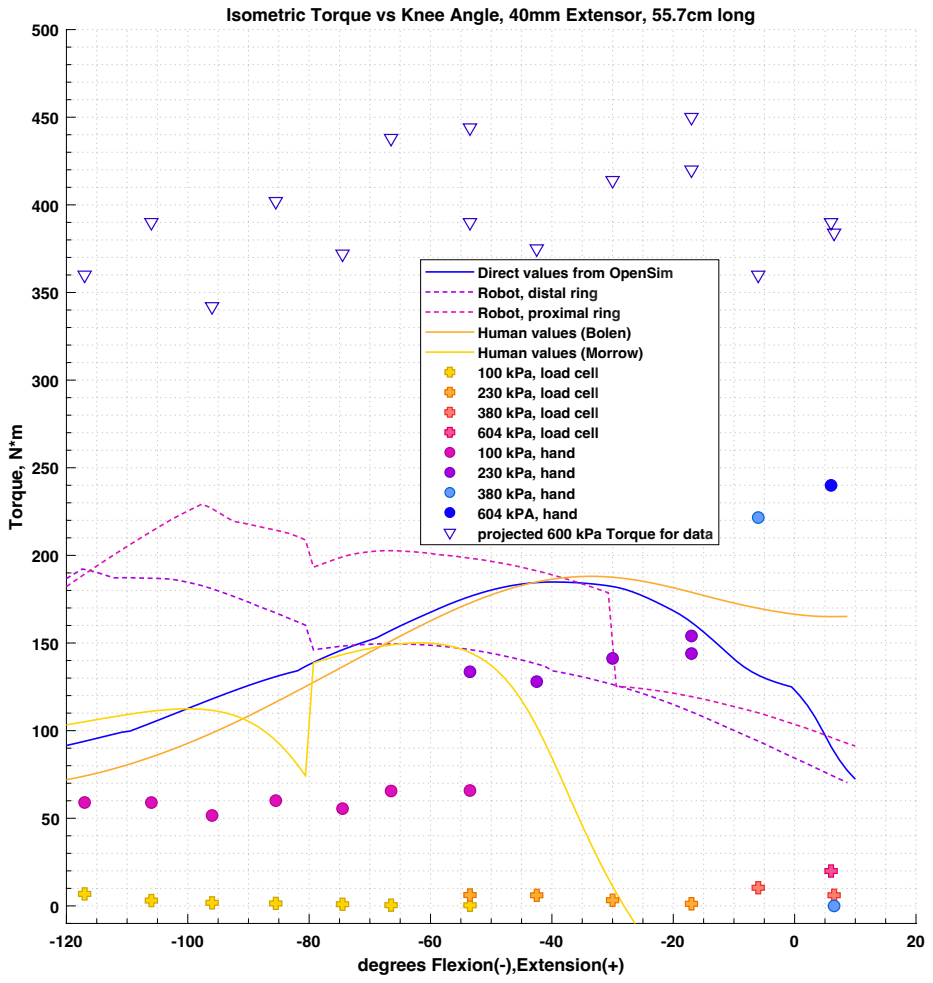
[picture p261: page 1]
Torque, N*

Isometric Torque vs Knee Angle, 40mm Extensor, 55.7cm long

Direct values from OpenSim

Robot, distal ring
Robot, proximal ring
Human values (Bolen)
Human values (Morrow)
100 kPa, load cell
230 kPa, load cell

380 kPa, load cell

604 kPa, load cell
100 kPa, hand
230 kPa, hand
380 kPa, hand
604 kPA, hand
projected 600 kPa Torque for data

degrees Flexion(-),Extension(+)
