Agile-and-Adaptive-Robotics/Bipedal_Robot/Documentation/Reports and Papers/Bolen_LM2023/Figures/Figure components/testJig/testJig.pdf

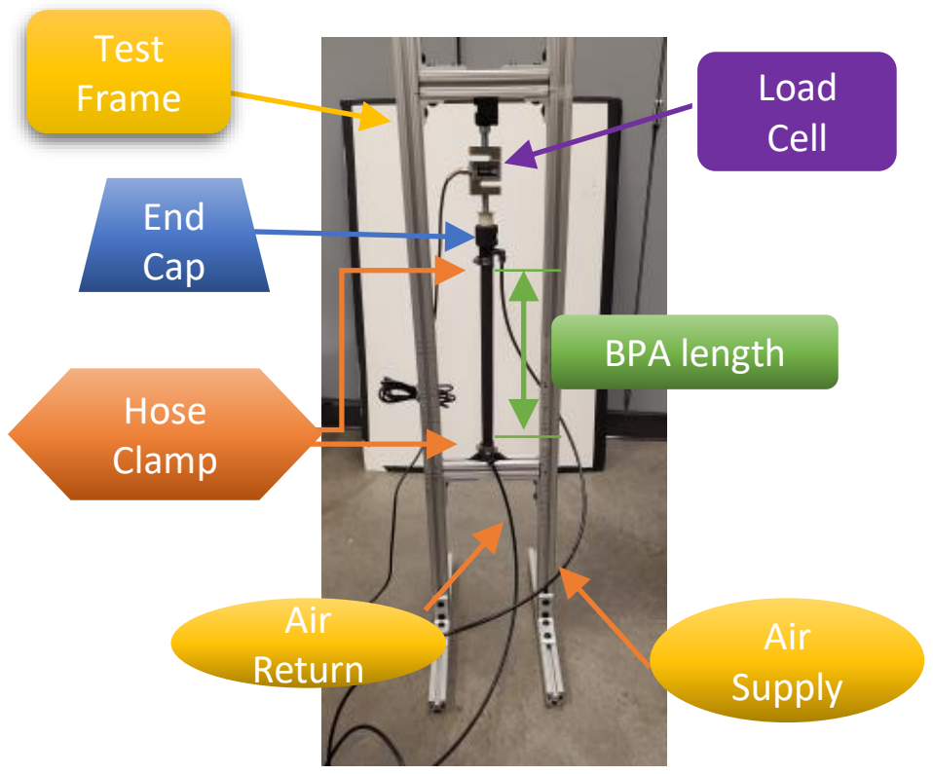
[picture p262: page 1]
Air Supply; Air Return; Load Cell; Test Frame; BPA length; End Cap; Hose Clamp
