Agile-and-Adaptive-Robotics/Bipedal_Robot/Code/Matlab/MinimizerRunTime2.pdf

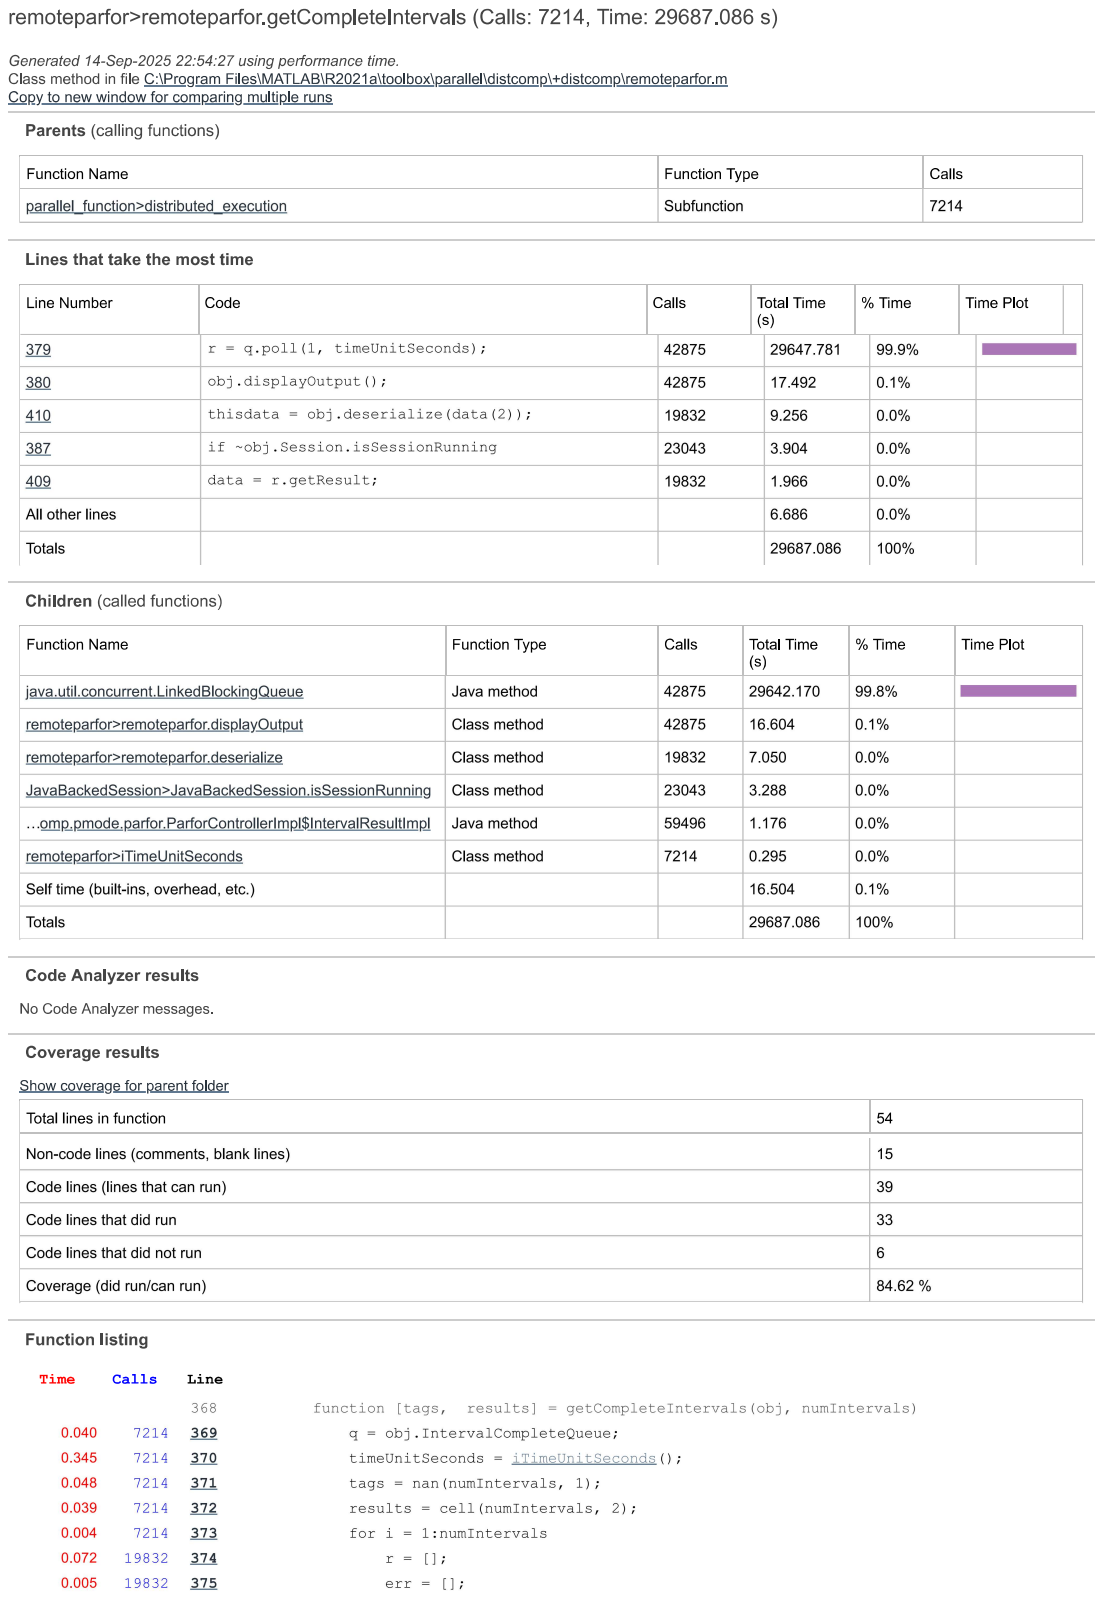
[picture p263: page 1]

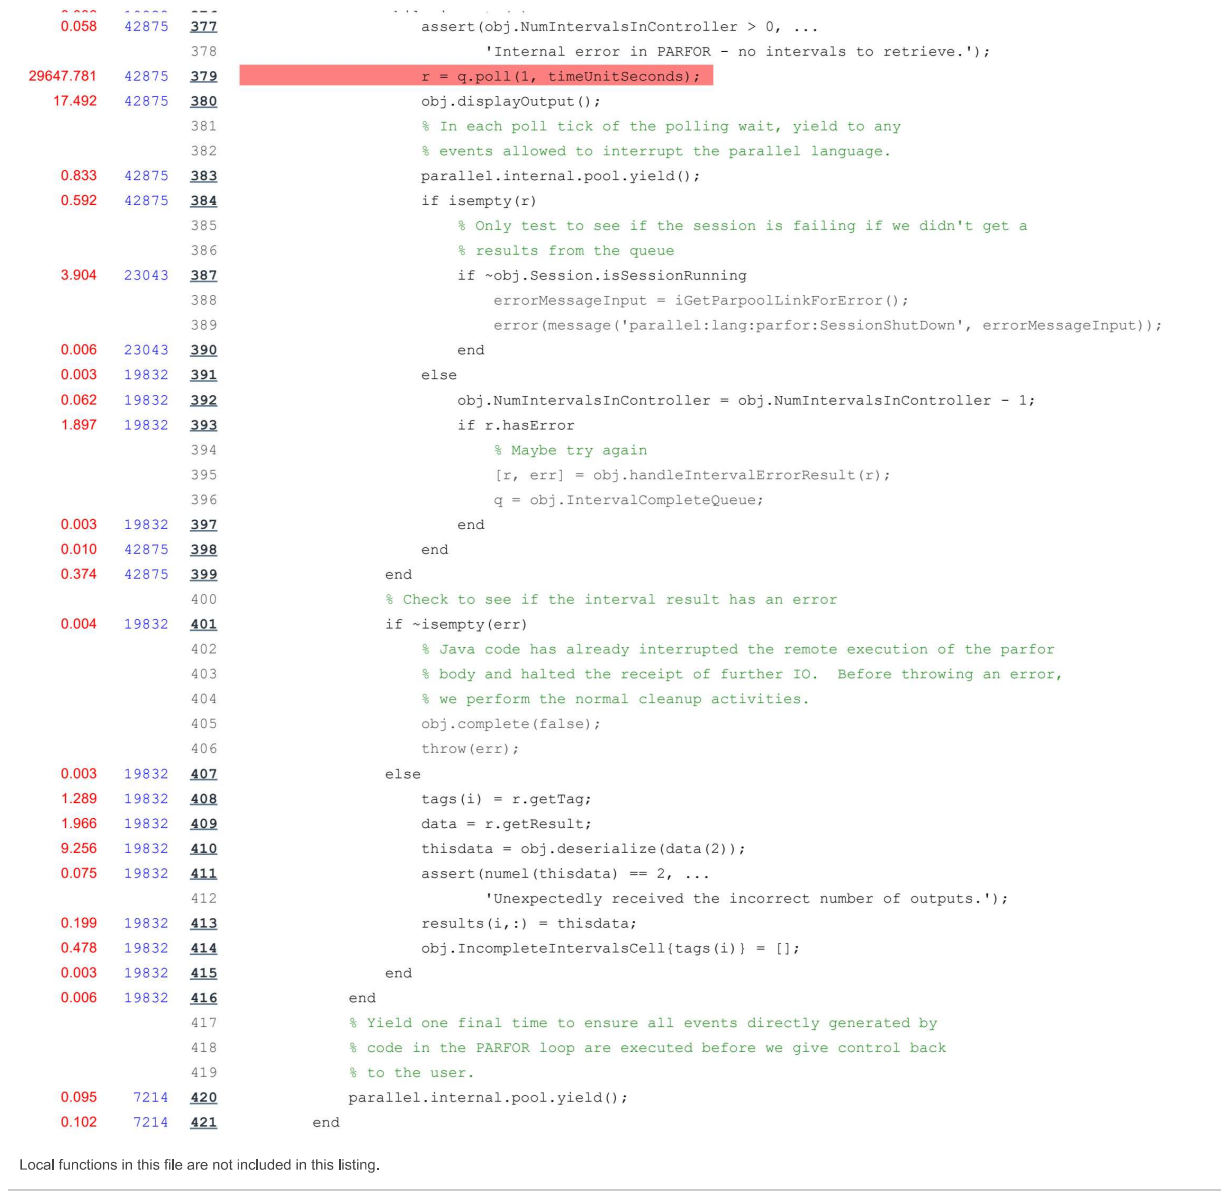
[picture p264: page 2]
