Agile-and-Adaptive-Robotics/Bipedal_Robot/Code/Matlab/MinimizerRunTime3.pdf

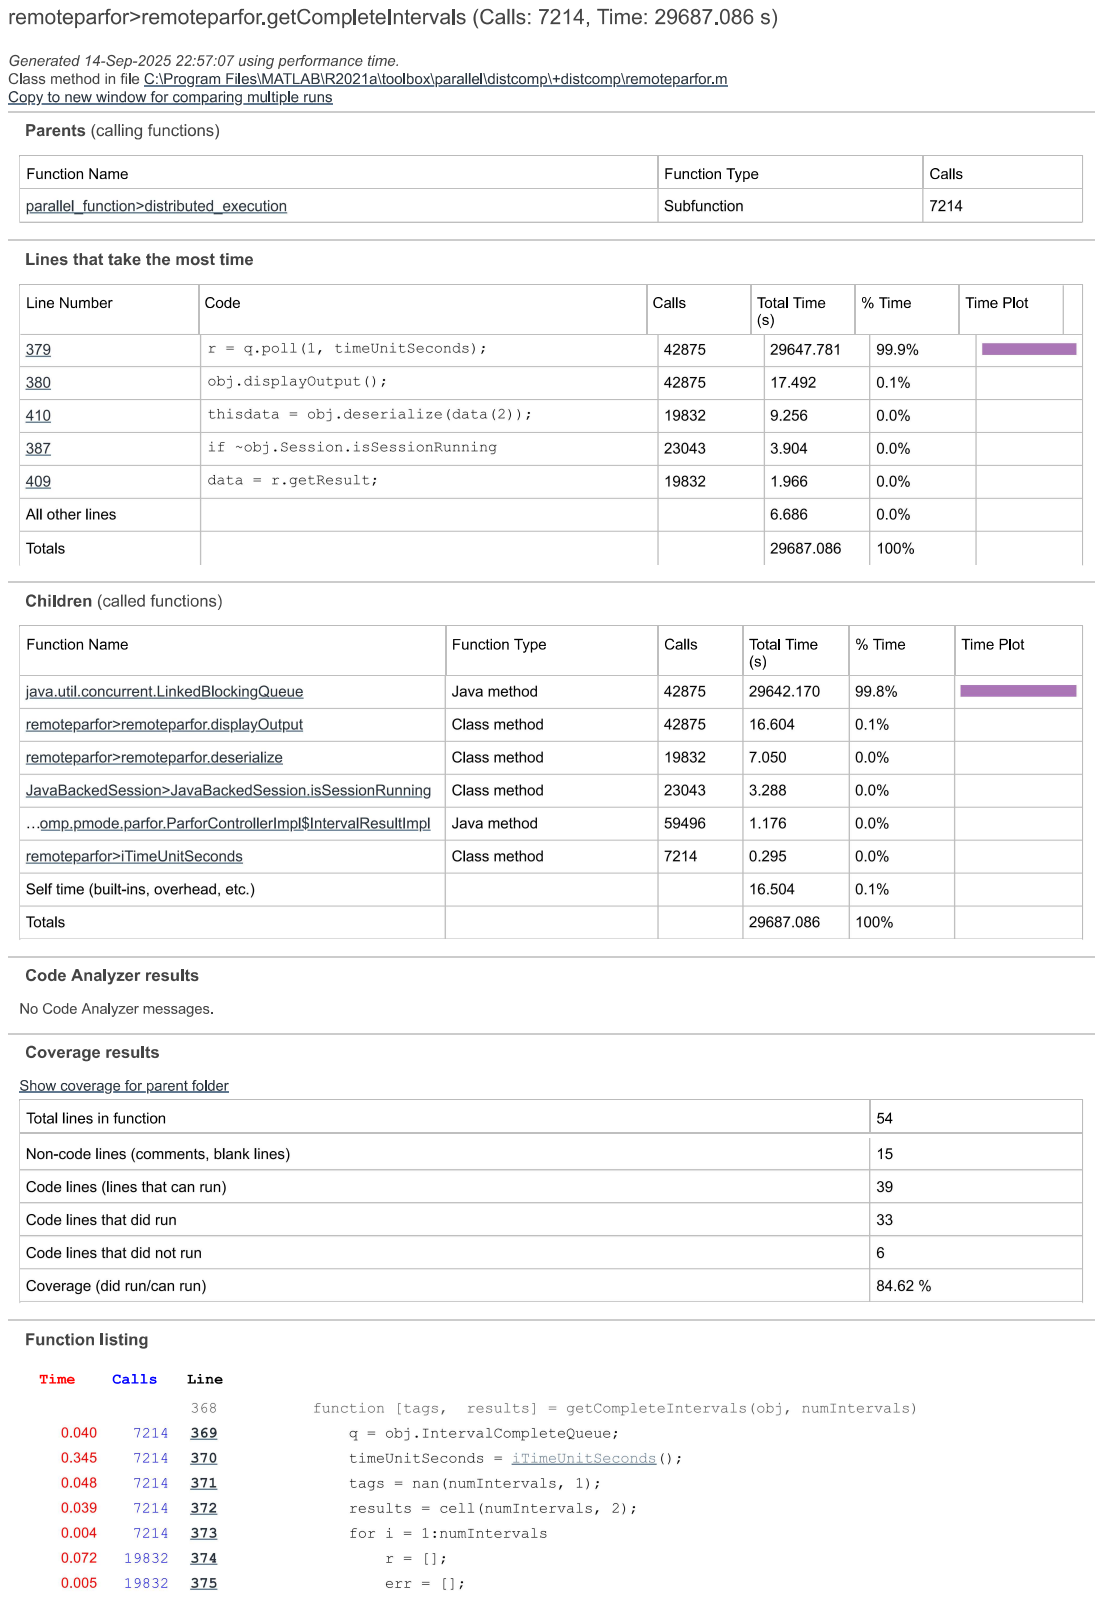
[picture p265: page 1]
