Agile-and-Adaptive-Robotics/Bipedal_Robot/Documentation/Reports and Papers/Bolen_LM2023/Figures/Figure components/_deprecated/TestSchematic/TestSchematic.pdf

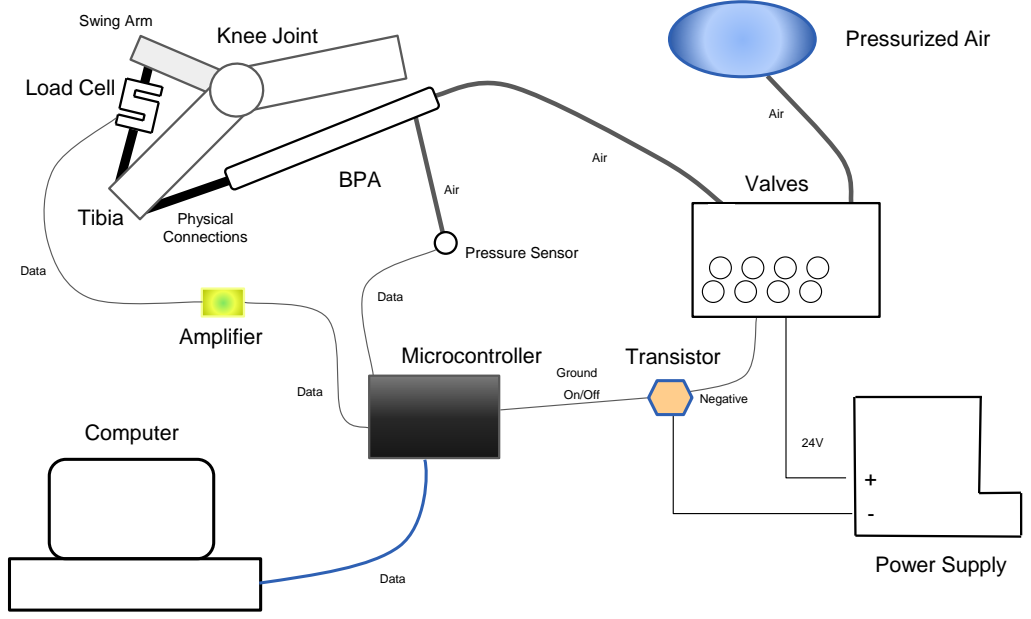
[picture p267: page 1]
Pressurized Air; BPA; Valves; Power Supply; Pressure Sensor; Microcontroller; Transistor; Knee Joint; Amplifier; Air; Physical Connections; On/Off; Negative; Data; Ground; Load Cell; Swing Arm; Tibia; Computer
