Agile-and-Adaptive-Robotics/Bipedal_Robot/Documentation/Reports and Papers/Knee_Torque_Test/Figures/Figure components/_deprecated/Ext10mm_pin_42_compare/Ext10mm_pin_42cm_compare_calc.pdf

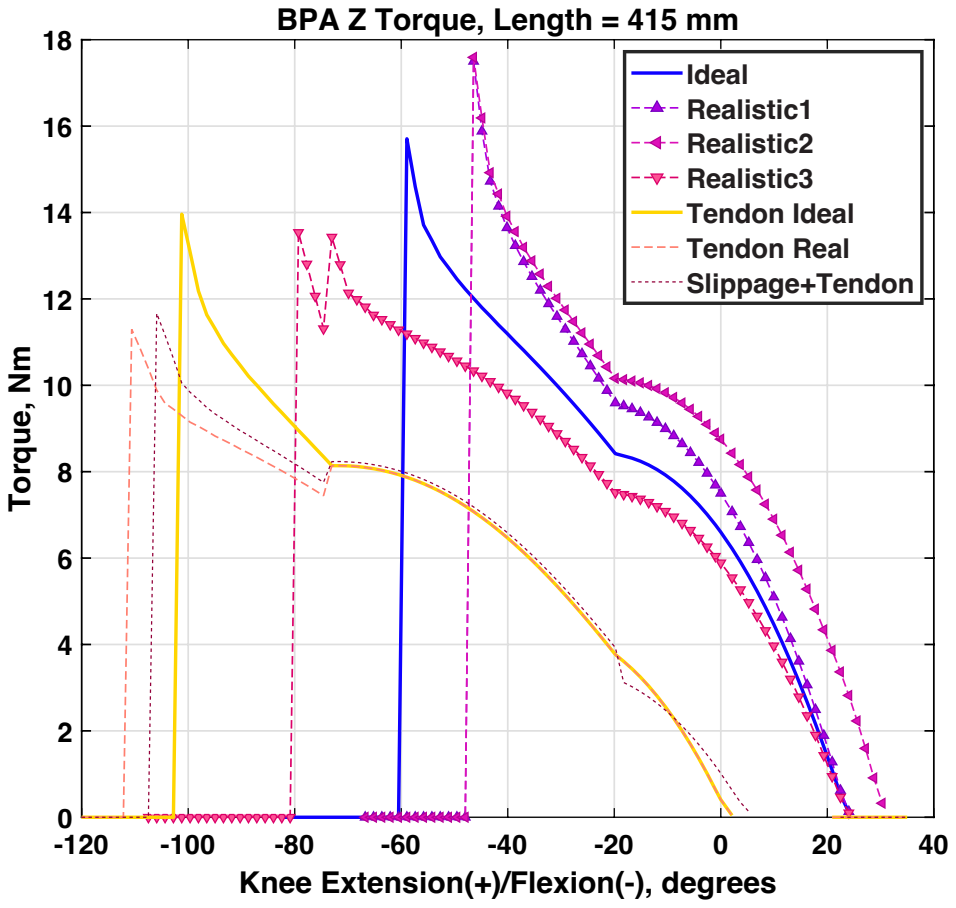
[picture p268: page 1]
Torque, Nm

BPA Z Torque, Length = 415 mm

Ideal Realistic1
Realistic2 Realistic3 Tendon Ideal

Tendon Real Slippage+Tendon

Knee Extension(+)/Flexion(-), degrees
