Agile-and-Adaptive-Robotics/Bipedal_Robot/Documentation/Reports and Papers/Knee_Torque_Test/Figures/Figure components/_deprecated/Ext10mm_pin_42_compare/Ext10mm_pin_42cm_compare_notendon.pdf

## Z axis Torque, 10mm Extensor, 41.5cm long, no tendon

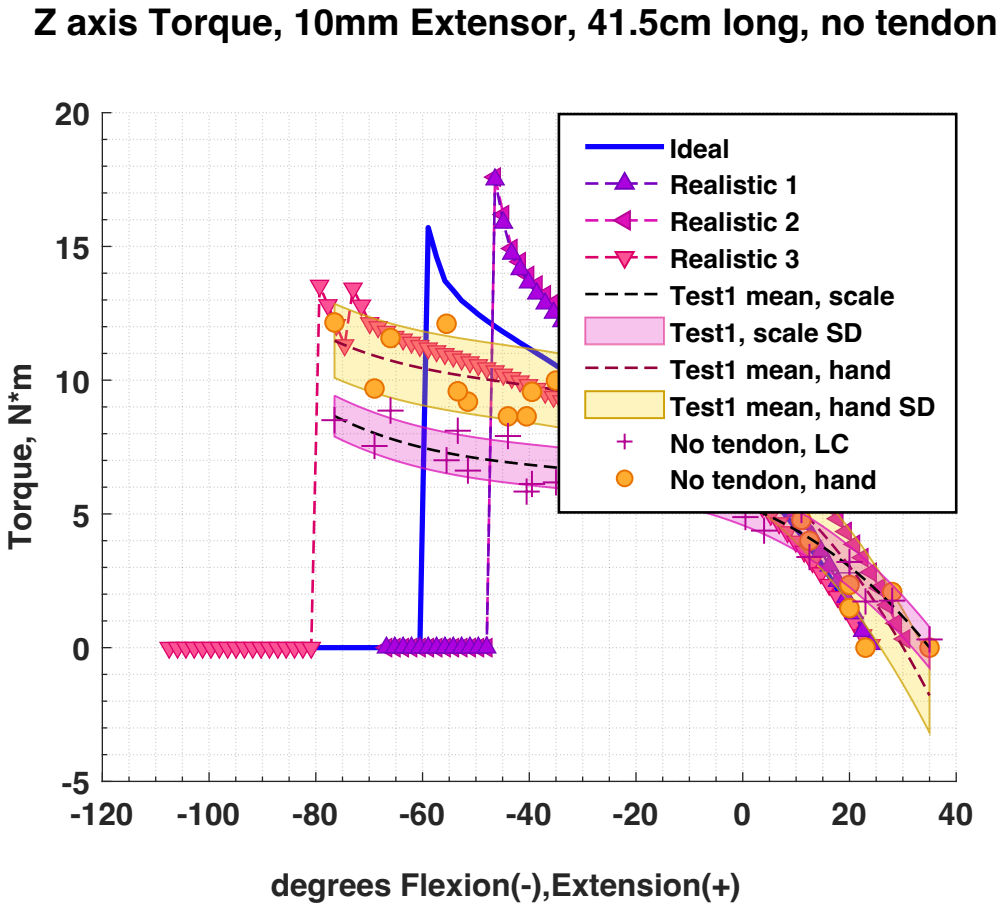
[picture p269: page 1]
Torque, N*m

Ideal
Realistic 1
Realistic 2
Realistic 3
Test1 mean, scale
Test1, scale SD
Test1 mean, hand
Test1 mean, hand SD
No tendon, LC
No tendon, hand

degrees Flexion(-),Extension(+)
