Agile-and-Adaptive-Robotics/Bipedal_Robot/Documentation/Reports and Papers/Knee_Torque_Test/Figures/Figure components/_deprecated/Ext10mm_pin_42_compare/Ext10mm_pin_42cm_compare_tendon.pdf

## Z axis Torque, 10mm Extensor, 41.5cm long, 22 mm tendon

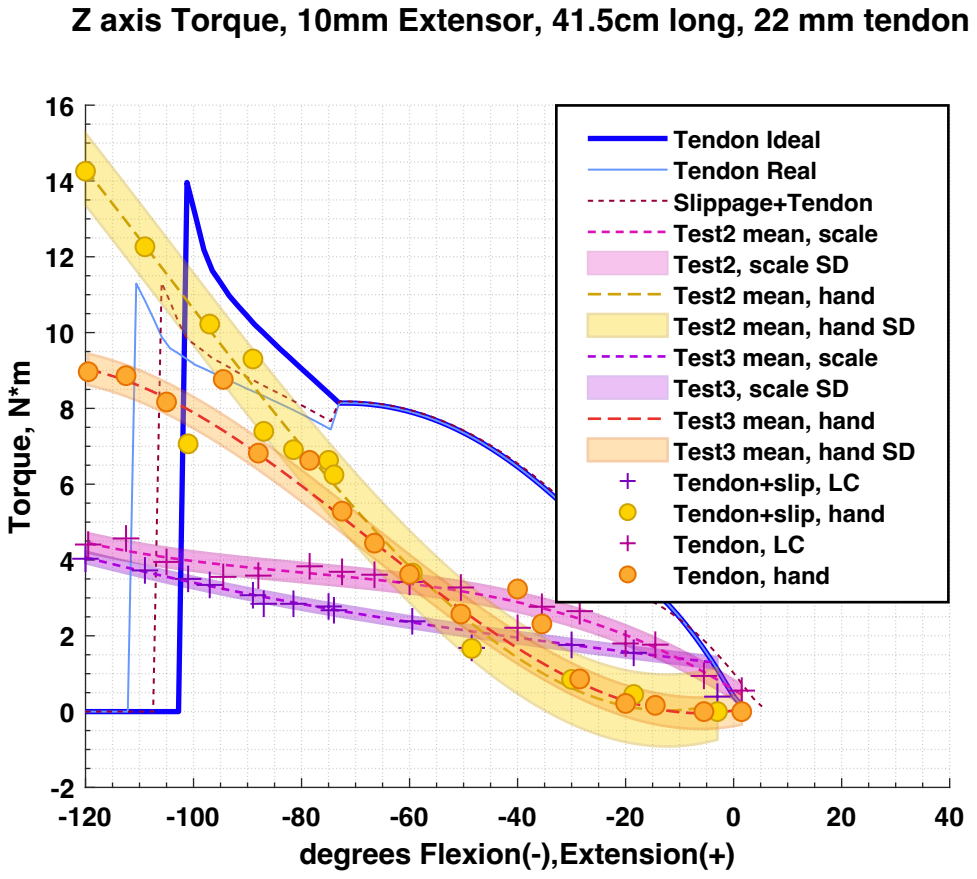
[picture p270: page 1]
Torque, N*m

Tendon Ideal
Tendon Real
Slippage+Tendon
Test2 mean, scale
Test2, scale SD
Test2 mean, hand
Test2 mean, hand SD
Test3 mean, scale
Test3, scale SD
Test3 mean, hand
Test3 mean, hand SD
Tendon+slip, LC
Tendon+slip, hand
Tendon, LC
Tendon, hand

degrees Flexion(-),Extension(+)
