Agile-and-Adaptive-Robotics/Bipedal_Robot/Documentation/Reports and Papers/Knee_Torque_Test/Figures/Figure components/_deprecated/RobotSim_frames/09_BA_001.pdf

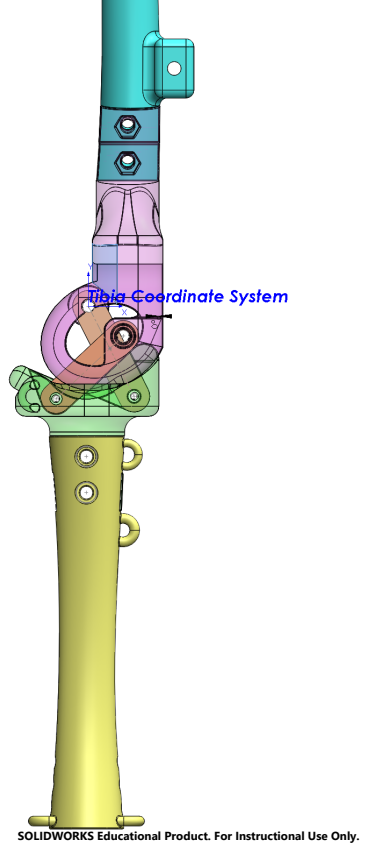
[picture p271: page 1]

SOLIDWORKS Educational Product. For Instructional Use Only.
