Agile-and-Adaptive-Robotics/Bipedal_Robot/(list of files, drawings)

Other design files:
Jeffrey's practice pcb/altium_practice.SchDoc
Jeffrey's practice pcb/PCB1.PcbDoc
