Agile-and-Adaptive-Robotics/Bipedal_Robot/Jeffrey's practice pcb/first schematic.brd

## EAGLE design Jeffrey's practice pcb/first schematic.brd (2022-02-05)

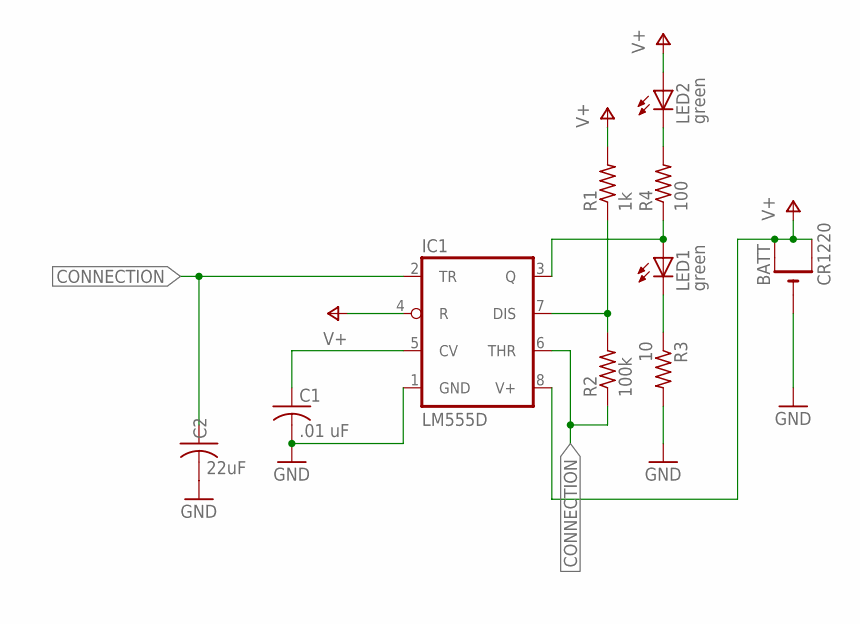
[picture p272: schematic first schematic.sch]

Parts:
BATT: CR1220; CR1220-SMD
C1: .01 uF; C0805; MPN CDR31BX103AKZS
C2: 22uF; C0805
IC1: LM555D; SO08
LED1, LED2: green; CHIPLED_0805
R1: 1k; R0805
R2: 100k; R0805
R3: 10; R0805
R4: 100; R0805

Connections:
CONNECTION: C2.1, IC1.2 (TR), IC1.6 (THR), R2.1
GND: BATT.-, C1.2, C2.2, IC1.1 (GND), R3.2
unnamed: IC1.3 (Q), LED1.A, R4.1
unnamed: LED2.C, R4.2
unnamed: LED1.C, R3.1
unnamed: IC1.7 (DIS), R1.1, R2.2
unnamed: C1.1, IC1.5 (CV)
V+: BATT.+$1 (+), BATT.+$2 (+1), IC1.4 (R), IC1.8 (V+), LED2.A, R1.2

Board: 2 copper layers, 10 parts (0 on the bottom side), 8 nets, no tracks yet.
