Agile-and-Adaptive-Robotics/Bipedal_Robot/(commit log)

2020-01-14 First Upload
    Adding all current files to the Master Branch
    [Calcaneus_Mesh_Points.xlsx, Femur_Mesh_Points.xlsx, Pelvis_R_Mesh_Points.xlsx, Sacrum_Mesh_Points.xlsx, Spine_Mesh_Points.xlsx, Talus_Mesh_Points.xlsx, Tibia_Mesh_Points.xlsx, Toes_Mesh_Points.xlsx]
2020-01-14 Reorganization
    Reorganizing file structure for ease of use.
    [Calcaneus_Mesh_Points.xlsx, Femur_Mesh_Points.xlsx, Pelvis_R_Mesh_Points.xlsx, Sacrum_Mesh_Points.xlsx, Spine_Mesh_Points.xlsx, Talus_Mesh_Points.xlsx, Tibia_Mesh_Points.xlsx, Toes_Mesh_Points.xlsx]
2020-02-04 No more bugs with base code. Changed Axes to be more robust with torque calculation
2020-02-28 Adding Muscles and Updating Pam
    Added a bunch of muscles to the Bi_Hip calculations. Also made the Pam Data script more robust. Now allows for attachment point locations that move (like insertion points on the Patella). Pam Data also can calculate torque about one joint, if the muscle starts before the first joint listed in the group.
2020-02-28 Update Axis Labels
    Changed axis function slightly. If only one axis was of interest, it was put into the first element of its row, even if it was a z axis (which typically is the third element). Changed it so that the axis of interest was stored in its similar vector position.
2020-03-07 smoothing out multi muscle calculation
    Making the code work nicer with multiple muscles. Making preliminary addition of a wireframe skeleton to look at the distance of the muscle from the bone.
2020-04-10 Added a timer
    The break functionality does work in the primary iteration loop, so I included a timer function to observe how long the iterations take.
2020-04-23 Corrections and Distance
    Corrected the algorithm to add up all the muscles, during one iteration loop, instead of the one that was being changed that iteration. Also added a term to the cost function to account for distance moved away from the starting Location. Also corrected surface plots to account for the best robot torque and the starting Robot torque.
2020-04-23 Changed some parameter
    Changed a few of the gains to keep the attachment points closer to the body.
2020-05-18 Added Two Bipedal Animatlab Models
    Added two bipedal animatlab models. One is the basis of what we will be workings with. The second is a model that includes more degrees of freedom in the legs.
2020-05-25 Completed Sensory Motor Network
    Completed all the nodes for the sensory motor network. The synapse types still need to be check and the network needs to be tuned much more.
2020-05-25 Added PF and RG
    Added the PF and RG networks. Not currently connected to the sensory motor layer, trying to tune them first to produce oscillation
2020-05-27 PF Layer and Sensorimotor
    PF layer now oscillates. Working on updating the sensorimotor network to output properly. When that works, will begin connecting layers
2020-05-28 Connected RG, PF, and Sensorimotor Layers
    All Layers are now connected
2020-05-28 Pretty Good Hip Motion
    Updated the sensorimotor parameters, mostly focusing on the Ia connection. The hip now has good rotation
2020-05-28 R hip sensory motor network
    Made the right hip sensory motor network, hooked everything up, now the legs oscillate back and forth
2020-06-01 Neural Subsystem Change of Ca Channel Voltage
    Changed the CA Channel voltage to try to emulate a Na channel. RG still won't oscillate
2020-06-10 Update Walker_2_Layer_CPG.aproj
    Added contact sensors. The in-air kinematics looked good, but after I changed the feeback to the Ib neurons to Ib discharge rate everything seemed to not work as well.
2020-06-10 Revert back to previous commit without step sensor
2020-06-10 Switching Adapter Neurons
2020-06-17 Added David's Solid models
    Got the work that David did on the Solid model and put it in a new folder.
    [BackLinkV1.SLDPRT, BoneConnectionScrews_97763A348_McMaster.SLDPRT, BrassInsert_94459A380_McMaster.SLDPRT, CushioningWasher_93650A145_McMaster.SLDPRT, FemorBone_111219_V2_DP.SLDPRT, FemorKneeEnd_103119_V13_DP.SLDPRT, FemoralAssembly_V3_022820.SLDASM, FemoralHead_010620_V1_DP.SLDPRT]
2020-06-23 Added models from the Bipedal Robot's Solid Models folder (and all subfolders)
    [Ankle shell.SLDPRT, Assem2.SLDASM, Base part tibial bone connection.SLDPRT, Falanges RB.SLDPRT, Falanges RL.SLDPRT, Falanges.SLDPRT, Femoral Connection with attachments.SLDPRT, Femoral end.SLDPRT]
2020-06-24 Added Files from the Ankle/foot project
    [Ankle assembly old.SLDASM, Ankle assembly.SLDASM, Ankle shell old.SLDPRT, Ankle shell.SLDPRT, Axle.SLDPRT, Falanges RB - Copy.SLDPRT, Falanges RB.SLDPRT, Falanges RL new.SLDPRT]
2020-07-08 Solidworks Naming Convention
    Made grammar fixes and added the list of current assmbly name ideas
2020-07-14 Created a folder for intern solid models.
    Added my foot model the folder.
    [01_01_00_01_ML.SLDPRT, 01_01_00_02_ML.SLDPRT, 01_01_00_03_ML.SLDPRT, 01_01_00_04_ML.SLDPRT, 01_01_01_01_ML.SLDPRT, 01_01_01_02_ML.SLDPRT, 01_01_01_03_ML.SLDPRT, 01_01_01_ML.SLDASM]
2020-07-20 File reorganization
    Reorganized Agility robotics and Robot 2019, and moved David tibia into Robot 2019. Added in new Fitzgerald model.
    [01_01_01_02_ML.SLDPRT, 01_ML.SLDASM, Ankle Assembled.SLDASM, Ankle Bottom Joint.SLDPRT, Ankle Exterior.SLDPRT, Ankle Interior Joint.SLDPRT, Ankle Lock 1.SLDPRT, Ankle Lock 2.SLDPRT]
2020-07-20 Organized Fitzgerald Foot, removed Agility Robotics folder.
    Files from agility robotics have been moved to unused parts. Fitzgerald foot now has ankle and foot subfolders.
    [01_01_00_02_ML.SLDPRT, 01_01_01_01_ML.SLDPRT, Ankle Assembled.SLDASM, Ankle Bottom Joint.SLDPRT, Ankle Exterior.SLDPRT, Ankle Interior Joint.SLDPRT, Ankle Lock 1.SLDPRT, Ankle Lock 2.SLDPRT]
2020-07-21 Reorganized Cad Files, Updated assembly file paths
    [01_01_00_01_ML.SLDPRT, 01_01_00_02_ML.SLDPRT, 01_01_00_03_ML.SLDPRT, 01_01_00_04_ML.SLDPRT, 01_01_01_01_ML.SLDPRT, 01_01_01_02_ML.SLDPRT, 01_01_01_03_ML.SLDPRT, 01_01_01_ML.SLDASM]
2020-07-22 Renamed RobotAssembly Files
    [01_01_L2 with Attachments.SLDPRT, 01_02_L4.SLDPRT, 01_02_L5 with Attatchments.SLDPRT, 02_01_Sacrum.SLDPRT, 04_01_Femoral Knob.SLDPRT, 04_02_Femoral Head.SLDPRT, 04_03_Femoral Head Mirrored.SLDPRT, 04_04_Femor Bone.SLDPRT]
2020-07-23 Deleted Random folder
    yes
    [01_01_00_01_ML.SLDPRT, 01_01_00_02_ML.SLDPRT, 01_01_00_03_ML.SLDPRT, 01_01_00_04_ML.SLDPRT, 01_01_01_01_ML.SLDPRT, 01_01_01_02_ML.SLDPRT, 01_01_01_03_ML.SLDPRT, 01_01_01_ML.SLDASM]
2020-07-23 Renaming
    Renaming
    [01_01_L2wAttachments.SLDPRT, 01_02_L5wAttatchments.SLDPRT]
2020-07-29 Solidworks Naming Tree
    List and folders of Prospective Parts and RobotAssembly2019
    [Solidworks Naming Tree.xlsx]
2020-07-31 New Femoral Head Connection
    [RedoneFemoralAssembly.SLDASM, RedoneFemoralHead.SLDPRT]
2020-07-31 Foot Model Modifications
    Updated connections between parts, added in more chamfers.
    [01_01_00_04_ML.SLDPRT, 01_01_01_01_ML.SLDPRT, 01_01_01_02_ML.SLDPRT, 01_01_01_03_ML.SLDPRT, 01_01_01_ML.SLDASM, 01_ML - 01_01_00_01_ML-1.STL, 01_ML - 01_01_00_01_ML-2.STL, 01_ML - 01_01_00_01_ML-3.STL]
2020-08-06 Updated parts
    [01_01_00_01_ML.SLDPRT, 01_01_00_02_ML.SLDPRT, 01_01_00_03_ML.SLDPRT, 01_01_00_04_ML.SLDPRT, 01_01_01_01_ML.SLDPRT, 01_01_01_02_ML.SLDPRT, 01_01_01_ML.SLDASM, 01_ML.SLDASM]
2020-08-06 Streamlined model
    [01_01_00_01_ML.SLDPRT, 01_01_00_02_ML.SLDPRT, 01_01_00_03_ML.SLDPRT, 01_01_01_01_ML.SLDPRT, 01_01_01_02_ML.SLDPRT, 01_01_01_ML.SLDASM, 01_ML.SLDASM]
2020-08-06 Changed model position
    [01_01_01_ML.SLDASM, 01_ML.SLDASM]
2020-08-06 Reoriented Pinhole
    [01_01_00_03_ML.SLDPRT, 01_01_01_03_ML.SLDPRT, 01_01_01_ML.SLDASM]
2020-08-06 Recolored Robot
    recolored robot2019, created "robot2019MickFoot", which uses 01_ML instead of foot2018.
    [01_01_00_02_ML.SLDPRT, 01_01_01_01_ML.SLDPRT, 01_01_01_03_ML.SLDPRT, 01_ML.SLDASM]
2020-08-07 Foot files
    [Assem1.SLDASM, Part1.SLDPRT, Part2.SLDPRT, Part3.SLDPRT, Part4.SLDPRT]
2020-08-11 Major File Reorganization
    Working on making the Robot assembly easy to open and to remove errors. Created many new folders for organization and have begun saving parts as Solidworks 2020 parts
    [01_01_00_01_ML.SLDPRT, 01_01_00_02_ML.SLDPRT, 01_01_00_03_ML.SLDPRT, 01_01_01_01_ML.SLDPRT, 01_01_01_02_ML.SLDPRT, 01_01_01_03_ML.SLDPRT, 01_01_01_ML.SLDASM, 01_01_L2wAttachments.SLDPRT]
2020-08-11 End of Day commit
    Still working on organizing the folders, condensing the number of parts to only the used parts, and creating sub assemblies for the final bipedal assembly
    [03_01_Femoral Knob.SLDPRT, 03_01_Femoral_Knob_Right.SLDPRT, 03_02_Femoral Head.SLDPRT, 03_02_Femoral_Head_Right.SLDPRT, 03_03_Femoral Head Mirrored.SLDPRT, 03_03_Femur_Right.SLDPRT, 03_04_Femor Bone.SLDPRT, 03_05_Femor Bone Mirrored.SLDPRT]
2020-08-24 Continued Assembly Redux
    Created 00_Bipedal_Robot assembly, with new folder structure. Missing feet
    [01_01_L2wAttachments.SLDPRT, 01_02_L4.SLDPRT, 01_02_L5wAttatchments.SLDPRT, 01_Spine.SLDASM, 03_01_Femoral_Knob_Right.SLDPRT, 03_02_Femoral_Head_Right.SLDPRT, 03_03_Femur_Right.SLDPRT, 03_Femur_Right.SLDASM]
2020-08-25 Added Ty foot design
    Added Ty foot design to the bipedal assembly. Began the interface between the ankle and the tibia.
    [01_01_01_01_ML.SLDPRT, 01_01_01_02_ML.SLDPRT, 01_01_01_ML.SLDASM, 01_ML.SLDASM, 04_Femur_Left.SLDASM, 05_Knee_Right.SLDASM, 06_Knee_Left.SLDASM, Ankle Assembled.SLDASM]
2020-08-26 Finished Assembling Bipedal Robot
    Created a mirror of Ty foot design to be used on the left side of the robot. Completed the assembly of the robot with the feet included. Ready to close this branch.
    [04_Femur_Left.SLDASM, 06_Knee_Left.SLDASM, 09_01_Ankle_Exterior_Shell.SLDPRT, 09_02_Ankle_Middle_Shell.SLDPRT, 09_03_Ankle_Interior_Joint.SLDPRT, 09_04_Ankle_Bottom_Joint.SLDPRT, 09_05_Ankle_Lock.SLDPRT, 09_06_Foot_Tarsals.SLDPRT]
2020-09-30 Adding axle
    In the ankle design I created and axle with bearings
2020-09-30 Extra Scripts and Location Tracking update
    Broke out the optimization script that contained information for each joint into separate scripts; one for each joint. Began updating OptimizationMaster to be more generic so it can perform optimization on the various joints instead of just the back. This meant updating how location for the cross over points was tracked. Made them bigger matrices essentially.
2020-10-05 Updating LocationTracker and BiHip locations
    The location tracker in the optimization script is being updated to properly track the locations using the new matrix and cell paradigm. Also updating the BiHip location variable so that it uses cell references to properly update throughout the iterations.
2020-10-12 Added code to save files better
    Optimization Master now saves it's results in the Trial Results folder, with a name that reflects the joint observed and the date it was run. Would like to include an incremental component in case multiple workspaces are saved in a day.
2020-10-12 Knee test ssolid models
    Solid models for the robotics components of the Knee test. Was originally for a Living Machines 2020 paper, so I updated it to 2021, although we may submit it to another journal. Contains Alex Steel's solid models. Contains part of the air fittings for the puppy model, including ones I made for the 20 mm and 40 mm Festo hoses. We will rename them and add them into our robot following our naming convention. For example 11_01_001 for 20 mm end cap.
    [AARL_Puppy_18_02_01_000.SLDASM, AARL_Puppy_18_02_01_001.SLDPRT, AARL_Puppy_18_02_01_002.SLDPRT, AARL_Puppy_18_02_01_002.STL, AARL_Puppy_18_02_01_003.SLDPRT, AARL_Puppy_18_02_01_004-QSML-M3-4.sldprt, AARL_Puppy_18_02_01_005-SK-8-16.SLDPRT, AARL_Puppy_18_02_01_006.SLDPRT]
2020-10-14 Began creating Bone Mesh Script
    Began creating a bone mesh script, based on the previous one, that will be run at the end of optimization. It will grab the best results of the muscle optimization and plot it on a wireframe skeleton of the model. This will help visualize the results quickly
2020-10-14 Solid models for static BPA test
    Added folder for BPA static test solid models. Parts are for the frame jig designed by David P. Parts are for 10 mm Festo muscles, and force sensor that was used in David's project. We need similar parts for 20 and 40 mm I.D. BPAs. David reported that deflection is a major design consideration, so the 10 mm can be reinforced with carbon fiber but the larger sizes probably need ribs added at the very least.
    [BPAConnectionToFrame4.SLDPRT, BPAtoMeter.SLDPRT, DrillBitBPA.SLDPRT, MeterToFrame.SLDPRT, PlugDesignFinal.SLDPRT, PlugForFrame.SLDPRT]
2020-10-17 Got rid of temp files, modifying femur
    Got rid of the autosave files that start wtih $. Started working on femur redesign but need to work on it on a different computer.
    [Assem2.51_test.SLDASM, Femoral end with hardware - bone connection.SLDPRT, Femur.SLDPRT, New link 1.SLDPRT, Patella_v3_template.SLDPRT, Split link 2.SLDPRT, Tibia.SLDPRT, Tibial head with hardware - bone connection.SLDPRT]
2020-10-17 Vendor solid models added
    Added a folder to put Vendor solid models in. Added Straight and elbow push to connect fittings, so we can try to decrease the inflation time for larger BPAs. Added hose clamps for 20 mm and 40 mm BPA. Added a BoM so it is easy to track what each solid model is and where to find it.
    [5225K566_PUSH-TO-CONNECT TUBE FITTING FOR AIR.SLDPRT, 5388K180_WORM-DRIVE CLAMPS FOR FIRM HOSE AND TUBE.SLDPRT, 5388K260_WORM-DRIVE CLAMPS FOR FIRM HOSE AND TUBE.SLDPRT, 5779K109_PUSH-TO-CONNECT TUBE FITTING FOR AIR.SLDPRT, 5779K152_PUSH-TO-CONNECT TUBE FITTING FOR AIR.SLDPRT, 5779K246_PUSH-TO-CONNECT TUBE FITTING FOR AIR.SLDPRT, 5779K286_PUSH-TO-CONNECT TUBE FITTING FOR AIR.SLDPRT, 5779K494_PUSH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]
2020-10-19 Added reference files
    Added reference files from current and past designs for Femur and tibia. Updated current designs to use metric units and correct part origins. Added clarification that the existing "Knee" folder was for reference, and not the actual TAROS knee that will be used in the test. Added AARL_Puppy brackets to get an idea of how to mount BPAs to bone.
    [03_01_Femoral_Knob_Right.SLDPRT, 03_02_Femoral_Head_Right.SLDPRT, 03_03_Femur_Right.SLDPRT, 03_Femur_Right.SLDASM, 07_Tibia_Right.SLDPRT, AARL_QR_FR_LE_PL_BL_009.SLDPRT, AARL_QR_FR_LE_PL_BL_010.SLDPRT, AARL_QR_HW_ChS_001.SLDPRT]
2020-10-20 Continued work on visualization
    Back can plot on the visualization. Trying to automate the process for other joints. Will likely hard code it
2020-11-07 Added Muscle Calculation
    Starting to rework how the open sim torque is calculated. New script, MuscleCalculation, will replace MuscleData in order to calculate the torque along a single axis. This can be more easily compared to the muscle group replacements with BPAs
2020-11-11 Femur and tibia for knee test
    Created a tibia and femur for the knee test. The semur is one part, split in two. Each solid body is saved as a part, but the one that contains both bodies is the controlling part. Will need to modify it based on feedback from Lindie.
    [03_03_Femur_Right.SLDPRT, 03_Femur_Right.SLDASM, Assem2.51_test.SLDASM, Femoral end with hardware - Latest.SLDPRT, Femoral head - Knee Test.SLDPRT, Femur shaft - knee test.SLDPRT, Femur.SLDPRT, Tibia.SLDPRT]
2020-11-13 working on the transformation matrix for monoarticular joints
2020-11-14 Finished monoarticulate, working on biarticulate
    finished the data creation for monoarticulate muscles, almost finished with biarticulate
    [Calcaneus_Mesh_Points.xlsx, Femur_Mesh_Points.xlsx, Pelvis_R_Mesh_Points.xlsx, Sacrum_Mesh_Points.xlsx, Spine_Mesh_Points.xlsx, Talus_Mesh_Points.xlsx, Tibia_Mesh_Points.xlsx, Toes_Mesh_Points.xlsx]
2020-11-17 Finished Biarticular class
    Finished creating the biarticular class object for calculating moment arms and torque about joints.
2020-11-19 BPA component models and assemblies
    Started building test assemblies so that I can modify 10, 20, and 40 mm BPA components.
    [8020-1515 X 15.SLDPRT, 8020-1515 X 36.SLDPRT, AARL_Puppy_18_02_01_012_Festo20mm_port.SLDPRT, AARL_Puppy_18_02_01_013-Festo20mm_cap.SLDPRT, AARL_Puppy_18_02_01_014_Festo40mm_port.SLDPRT, AARL_Puppy_18_02_01_015-Festo40mm_cap.SLDPRT, Static Test Assembly - 10mm.SLDASM]
2020-11-24 Added BiPamData
    Created an object for calculating the parameters for bpas that pass over two joints. Need to update calculations to have better force specifications.
2020-11-30 Reorganization, finishing biPamClass, beginning comparison
    Reorganized the file structure to hide all the previous optimization code and begin establishing a file system for the optimization code. Nearly done with the BiPamClass verification, still need to do some hand calcs to make sure everything is correct. Set up a script to compare the human adductor magnus muscles to the BPA adductor magnus.
    [Calcaneus_Mesh_Points.xlsx, Femur_Mesh_Points.xlsx, Pelvis_R_Mesh_Points.xlsx, Sacrum_Mesh_Points.xlsx, Spine_Mesh_Points.xlsx, Talus_Mesh_Points.xlsx, Tibia_Mesh_Points.xlsx, Toes_Mesh_Points.xlsx]
2020-12-01 Updated 20mm port
    Updated Festo 20 mm port to fit three different sizes. Put a rib in a frame attachment piece to stiffen it.
    [AARL_Puppy_18_02_01_012_Festo20mm_M5port.SLDPRT, AARL_Puppy_18_02_01_012_Festo20mm_NPTport.SLDPRT, AARL_Puppy_18_02_01_012_Festo20mm_U10port.SLDPRT, AARL_Puppy_18_02_01_012_Festo20mm_port.SLDPRT, MeterToFrame.SLDPRT, Static Test Assembly - 10mm.SLDASM]
2020-12-02 Updated end caps
    End caps with different size fittings
    [AARL_Puppy_18_02_01_012_Festo20mm_M5port.SLDPRT, AARL_Puppy_18_02_01_012_Festo20mm_M5port.STL, AARL_Puppy_18_02_01_012_Festo20mm_NPTport.SLDPRT, AARL_Puppy_18_02_01_012_Festo20mm_NPTport.STL, AARL_Puppy_18_02_01_012_Festo20mm_U10port.STL, AARL_Puppy_18_02_01_013_Festo20mm_M5cap.SLDPRT, AARL_Puppy_18_02_01_013_Festo20mm_M5cap.STL, AARL_Puppy_18_02_01_013_Festo20mm_NPTcap.SLDPRT]
2020-12-03 Added force calculation and completed 1 validation
    Added a curve fit to the BPA classes that fits the data from Festo to relate contraction to amount of force that can generated. Also ran through the calculations for the biarticular case where the next attachment point is two reference frames over.
2020-12-04 Finished Verification, continued work on optimizer test case
    Finished verifying the calculations for the bi and mono pam classes. Changed the contraction to be 0% at full length 100% at full contraction. Continued work on test case for comparison. Began to untangled the torque calculations when the joint of interest has multifple degrees of freedom.
2020-12-05 Plotting Torques
    Began writing scripts for comparing the torque plots. Also began working on better human muscle force calculation
2020-12-16 Adding test script for force calculation
    Trying to elegantly put together a muscle force calculation based on Millard, Hoy, and Thelen. The issue is we need to balance the tendon force and the muscle force. We can do this with built in Matlab solver, but I need to figure out how to make the function maleable enough to also bring in parameters from the muscle during the solving process.
2020-12-16 Added updated force calculation
    Updated the muscle classes to include a better force calculation, which iterates to find a solution to the muscle tendon force and the passive and elastic muscle force. This was done for the monoarticulate and biarticulate muscle classes. Kind of verified the mono case, want to verify the biarticulate case. After that I should update all of the muscle generators to include the optimal fiber length, pennation angle, and tendon slack length
2020-12-17 Finished updating muscle calculations for force
    Finished updating all of the muscle data entry to include tendon slack length, optimal fiber length, and pennation angle. All mono and bi articulate muscles were able to generate solutions to force. Takes some times for the solver to run through them, especially with a large number of positions.
2020-12-28 Updated both PAM classes as handles with dependent variables
    Updated the mono and bi pam classes so that they are handles with dependent variables (length, contraction, force direction, and torque, etc) so that they are calculated every time they are querried. This will hopefully make the optimization code easier to navigate.
    Try to check the values being calculated when running the optimization code. If there is anything sketchy, we can revert back to when the values are not dependent.
2020-12-30 Playing around with ways of calculating torque difference
    Ran through some simple examples to try to figure out how I wanted to quantify torque differences. When human torque is negative, we also want the PAM torque to be negative, so the algorithm needs to be slightly more nuances than just subtracting human torque from pam torque. I think I settled on a solution that just switches what is subtracted depending on the sign of the human torque. Later on, I will need to decide how to weight and add the torque difference to the cost function.
2021-01-04 Began torque comparison calculation
    Have a function that generates the adjusted torque difference between the human muscles and the robot muscles. Beginning to work on a gradient descent method and implementing constraints to the objective function.
2021-01-05 Wrote code that builds muscle pathing between opensim geometry
    The Pam class pulls points from the bone mesh geometry from Opensim to calculate torques
    [Calcaneus_Mesh_Points.xlsx, Femur_Mesh_Points.xlsx, Pelvis_R_Mesh_Points.xlsx, Sacrum_Mesh_Points.xlsx, Spine_Mesh_Points.xlsx, Talus_Mesh_Points.xlsx, Tibia_Mesh_Points.xlsx, Toes_Mesh_Points.xlsx]
2021-01-11 Completed calculation and plotting for 1 case
    Created code that will look at all the points the muscle can connect to and generates the best torque result. Those points are then plotted on a mesh skeleton. Done for adductor magnus
2021-01-12 Created a few mesh codes
    Created mesh calculations for the vas muscle group and the bicep femoral short head. However, they have shown that there are issues when calculating the contraction of the PAM, the tendon length, and the resting length.
2021-01-14 Finishing mesh calculation and updated monopam data
    Did a lot of fighting with the mesh calculation but the bicep femoral muscle code is now working, including both what orientation provides the best torque as well as if the muscle length is usable if it were an actual PAM. I had to also update the usability check in the monopam data, which included editing where the tendon length is calculated. I'll have to update BiPamData as well soon.
2021-01-17 New tibia and vendor parts
    Redesigned the tibia. Added vendor parts for screw and washer. Updated BoM.
    [91239A418_CLASS 10.9 STL BUTTON-HEAD SOCKET CAP SCREW.SLDPRT, 96025A249_CLIPPED WASHER.SLDPRT, Assem2.51_test.SLDASM, BoM.xlsx, Tibia.SLDPRT]
2021-01-18 Updated femur
    Updated femur. Now has 1/4-20 mounting holes on bosses instead of cutouts. One mounting point for each femur segment. Got rid of femur shaft because it is not needed for our test. Simplified profile so that there are planar faces to mount components on.
    [Assem2.51_test.SLDASM, Femur.SLDPRT]
2021-01-19 Finished femur
    Finished updating femur design. Added fillets and chamfers.
    [Assem2.51_test.SLDASM, Femur.SLDPRT]
2021-01-23 Started donuts
    Started donuts to test clearance. Computer was being slow and it's getting late. I will update later.
    [Femur_donut_1.SLDPRT, Femur_donut_2.SLDPRT, Tibia_donut1.SLDPRT]
2021-01-23 Removed BPA static test folder
    Removed the folder for "Living Machines 2021 - BPA Test." This folder was moved to the Muscle Sensory repository in a previous commit. This folder has the solid models for the BPA characterization test.
    [8020-1515 X 15.SLDPRT, 8020-1515 X 36.SLDPRT, BPAConnectionToFrame4.SLDPRT, BPAtoMeter.SLDPRT, DrillBitBPA.SLDPRT, MeterToFrame.SLDPRT, PlugDesignFinal.SLDPRT, PlugForFrame.SLDPRT]
2021-01-24 Shaft fit parts
    partial parts to check tolerances
    [Femur_donut_1.SLDPRT, Femur_donut_1.STL, Femur_donut_2.SLDPRT, Femur_donut_2.STL, Femur_donut_3.SLDPRT, Femur_donut_3.STL, Femur_donut_4.SLDPRT, Femur_donut_4.STL]
2021-01-25 Updated Cost Function, via point, refinement code, and multiple add mags
    Updated a specific cost function for the knee that penalizes deviation from the z torque more heavily than other axes, since that axis is the one of interest for the knee. When moving that to other joints, I might want an automated way to tell what axis is most important (thinking the adductor muscles want emphasis on the x axis). Also began creating an optimization code for after the mesh portion. Use the mesh solution to search around that area. I did that because for the bifemsh I added a via point and realized that was unnecessary, but what was necessary was getting away from the bone itself, since the OpenSim muscl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
    [Calcaneus_Mesh_Points.xlsx, Femur_Mesh_Points.xlsx, Pelvis_R_Mesh_Points.xlsx, Sacrum_Mesh_Points.xlsx, Spine_Mesh_Points.xlsx, Talus_Mesh_Points.xlsx, Tibia_Mesh_Points.xlsx, Toes_Mesh_Points.xlsx]
2021-01-26 Tibia and Femur parts for test
    Femur and Tibia STL parts modified and ready to print.
    [Assem2.51_test.SLDASM, Distal_Femur.SLDPRT, Femoral head - Knee Test.SLDPRT, Femur.SLDPRT, Proximal_Femur.SLDPRT, Tibia.SLDPRT, Tibial head with hardware - bone connection.SLDPRT]
2021-01-26 Parts ready to print
    Slightly modified Knee test parts. Sending Tibia and Femur to the printers now.
    [Distal_Femur.SLDPRT, Femur.SLDPRT, Tibia.SLDPRT]
2021-01-27 Checking Moment Arm
    Gather moment arm information from OpenSim and compared it to my code. The moment arm results are different, but following OpenSim's method I can generate the same result. Might change the moment arm to what they have instead.
    [Bifemsh_MomentArm_OpenSim.xlsx]
2021-01-31 Working on designing bracket
    Designing bracket to hold BPAs
    [AARL_Puppy_18_02_01_014_Festo40mm_M5port.SLDPRT, Upper_brkt_assy.SLDASM, Vastus_brkt_origin.SLDPRT]
2021-02-02 Finalized calculations for the bifemsh and vas
    Trying to get data for Ben and Lindie, so I created finalized locations for the bicep femoris and vastus muscles.
    [Bifemsh_Force_OpenSim.xlsx, Bifemsh_TendonForce_OpenSim.xlsx, Bifemsh_Torque_OpenSim.xlsx, Calcaneus_Mesh_Points.xlsx, Femur_Mesh_Points.xlsx, Pelvis_R_Mesh_Points.xlsx, Sacrum_Mesh_Points.xlsx, Spine_Mesh_Points.xlsx]
2021-02-02 Bracket work
    Working on bracket for vastus origin
    [Upper_brkt_assy.SLDASM, Vastus_BPA.SLDPRT, Vastus_brkt_origin.SLDPRT]
2021-02-09 added brackets
    added bracket parts.
    [BifemSH_brkt_insertion.SLDPRT, BifemSH_brkt_origin.SLDPRT, Tibia_vastus_brkt.SLDPRT]
2021-02-09 Made new folder
    Made a new folder to put all the solid models that will be used in the knee test. Renamed artificial tendon folder so that it is clear the folder is for conceptual design considerations and not solid works.
    [BifemSH_brkt_insertion.SLDPRT, BifemSH_brkt_origin.SLDPRT, Distal_Femur.SLDPRT, Femoral end with hardware - bone connection.SLDPRT, Femur.SLDPRT, New link 1.SLDPRT, Patella_v2.5.sldprt, Patella_v2.SLDPRT]
2021-02-10 Worked on brackets
    Worked on designing brackets that attach to tibia
    [BifemSH_brkt_origin.SLDPRT, Tibia_vastus_brkt.SLDPRT]
2021-02-10 Tibia brackets
    Make brackets for the Biceps Femoris, Short Head, and the Vastus, muscle insertion points on the tibia.
    [BifemSH_brkt_insertion.SLDPRT, BifemSH_brkt_origin.SLDPRT]
2021-02-24 New Patella and bracket configs
    New configurations for brackets and patella. Use of M8 screws, nuts, and clipped washers but no barrel adjusters.
    [BifemSH_brkt_insertion.SLDPRT, BifemSH_brkt_origin.SLDPRT, Patella_v3_template.SLDPRT, Tibia_vastus_brkt.SLDPRT]
2021-02-27 Bracket appearance
    Changed bracket appearance to give them color.
    [BifemSH_brkt_origin.SLDPRT, Femur.SLDPRT, Vastus_brkt_origin.SLDPRT]
2021-03-02 Clamp update
    Updated clamps on tibia. Bifemsh wire clamp axis along z axis now.
    [BifemSH_brkt_insertion.SLDPRT]
2021-03-02 modified bracket and knee
    Modified tibia brackets and patella. They are all M6 cable clamps now. They are ready to print.
    [BifemSH_brkt_insertion.SLDPRT, Patella_v3_template.SLDPRT, Tibia_vastus_brkt.SLDPRT, Vastus_brkt_origin.SLDPRT]
2021-03-02 Created M6 square washers
    Created M6 square washers. Created STL part ready to print.
    [M6_square_washer.SLDPRT, M6_square_washer.STL]
2021-03-03 Made two femur brackets
    Two femur brackets for knee flexion/extension. 10 mm Festo model. Made STL files.
    [BifemSH_brkt_origin.SLDPRT, BifemSH_brkt_origin.STL, Vastus_brkt_origin.SLDPRT]
2021-03-15 Added rough draft for Knee Test paper
    Knee torque test documentation folder now has rough draft pdf, and folders to put figures and bibliography.
2021-03-16 Created a bibliography
    Bibliography for knee torque test. Will add or remove sources later.
2021-03-25 Knee Torque Test Jig Components Added to Github
    [0.25-20_Rod_Model_3.3.SLDPRT, 8020_1515UL_CameraFrame_14in_3.3.SLDPRT, 8020_1515UL_CameraFrame_23in_3.3.SLDPRT, 8020_1515UL_CameraFrame_37in_3.3.SLDPRT, 8020_1515UL_Donor_3.3.SLDPRT, 8020_1515UL_GeneralFrameHorizontal_36in_3.3.SLDPRT, 8020_1515UL_GeneralFrame_Foot_15in_3.3.SLDPRT, 8020_1515UL_GeneralFrame_Foot_42in_3.3.SLDPRT]
2021-03-25 Test Jig Assembly Added. Individual components mapped to correct github path
    [0.25-20_Rod_Model.SLDPRT, 8020_1515UL_CameraFrame_14in.SLDPRT, 8020_1515UL_CameraFrame_23in.SLDPRT, 8020_1515UL_CameraFrame_37in.SLDPRT, 8020_1515UL_Donor.SLDPRT, 8020_1515UL_GeneralFrameHorizontal_36in.SLDPRT, 8020_1515UL_GeneralFrame_Foot_15in.SLDPRT, 8020_1515UL_GeneralFrame_Foot_42in.SLDPRT]
2021-03-25 Code Added for Knee Torque Tests
2021-03-25 Added Documentation for Knee Torque Test Jig
    Final Report for Burgess Winter 2021. Captures current status of Test Jig, calibration processes, very preliminary results
2021-03-25 March 2021 Preliminary Data Added for 10mm Festo
    [10 mm Model Generated Torque Data_Mar2021.xlsx, RawData_Mar2021.xlsx, Results_Extensor_10.csv, Results_Extensor_11.csv, Results_Extensor_3.csv, Results_Extensor_4.csv, Results_Extensor_5.csv, Results_Extensor_6.csv]
2021-03-29 Added read me files
    Due to leaving the lab, I have added Read Me files to most of the folders found within the "Code" folder structure. Tried to make the different scripts, function, and classes understandable and readable.
    [Bifemsh_Force_OpenSim.xlsx, Bifemsh_MomentArm_OpenSim.xlsx, Bifemsh_TendonForce_OpenSim.xlsx, Bifemsh_Torque_OpenSim.xlsx]
2021-04-10 Column for max. contracted length
    added a column for maximum contracted PAM length, theoretical (25%) and measured.
    [RawData_Mar2021.xlsx]
2021-04-12 Folder name change
    Changed the name of some of the folders.
    [03_01_Femoral_Knob_Right.SLDPRT, 03_02_Femoral_Head_Right.SLDPRT, 03_03_Femur_Right.SLDPRT, 03_Femur_Right.SLDASM, 07_Tibia_Right.SLDPRT, 5225K566_PUSH-TO-CONNECT TUBE FITTING FOR AIR.SLDPRT, 5388K180_WORM-DRIVE CLAMPS FOR FIRM HOSE AND TUBE.SLDPRT, 5388K260_WORM-DRIVE CLAMPS FOR FIRM HOSE AND TUBE.SLDPRT]
2021-04-12 Renamed folders, moved files
    Renamed some of the folders. Moved Lindie's knee test pieces to where they belong in the code, documentation, and solid model folders. Created a testing data folder.
    [0.25-20_Rod_Model.SLDPRT, 01_01_00_01_ML.SLDPRT, 01_01_00_02_ML.SLDPRT, 01_01_00_03_ML.SLDPRT, 01_01_00_04_ML.SLDPRT, 01_01_01_00_Ankle.SLDASM, 01_01_01_01_ABottom.SLDPRT, 01_01_01_01_ML.SLDPRT]
2021-04-23 Update RawData_Mar2021.xlsx
    Re-measured resting BPA length. Added measured values for maximum BPA contraction.
    [RawData_Mar2021.xlsx]
2021-04-26 Model updates
    Updated models to have larger ribs for the square washer. Changed chamfers for clearance holes from 1mm to 0.25mm. Increased thickness of square washer. Added pneumatic fittings for BPAs in assembly.
    [AARL_Puppy_18_02_01_000.SLDASM, AARL_Puppy_18_02_01_001.SLDPRT, AARL_Puppy_18_02_01_002.SLDPRT, AARL_Puppy_18_02_01_004-QSML-M3-4.sldprt, AARL_Puppy_18_02_01_005-SK-8-16.SLDPRT, AARL_Puppy_18_02_01_007.SLDPRT, AARL_Puppy_18_02_01_009-5388K140_Hose-Clamp.SLDPRT, AARL_Puppy_18_02_01_010.SLDPRT]
2021-05-10 Rationalized test names
    Flex test 2 now has 3 digits, the first digit is because it's the 2nd flex test (load cell mounted to tibia). Second and third digits are for test number (i.e. test 1 is flextest201). Added two tests, one at no pressure (flextest200), and one at maximum extension (flextest210).
2021-05-13 flex test 3
    flex test 3 data. New zero calibration since back to hanging strings method.
    [KneeTorqueTest.ino]
2021-05-23 Reworked code
    Added ASCII terminators to arduino KneeTorqueTest code. Reworked KneeTest in Matlab to use serialport and get rid of dated functions like serial, fopen, fclose. Once these programs are confirmed as working I will erase the others, and remove the "2" from the file name, making them the dominant files.
2021-05-23 data analysis
    Data analysis and code upgrade.
    [Flex3_01_horz_Results.csv]
2021-05-24 Add Lindie data and Ben data
    Added data and code from Lindie's tests, per email. Added table for Ben's results.
    [Lindie Muscle Force and Torque Data 10 mm.xlsx, Results_table.xlsx, TorqueByAngle_Mar21.xlsx]
2021-05-25 Added data
    Added data to spreadsheet and image files.
    [Results_table.xlsx]
2021-06-05 NWBS submission
    Completed the things needed for NWBS 2021 submission.
    [Results_table.xlsx]
2021-06-29 changed some names
    [01_01_L2.001.SLDPRT, 01_01_L2wAttachments.SLDPRT, 01_02_L4.SLDPRT, 01_02_L4_001.SLDPRT, 01_02_L5_001.SLDPRT, 01_02_L5wAttatchments.SLDPRT, 01_Spine.SLDASM, 03_01_FK_R_001.SLDPRT]
2021-06-29 finished all file names
    [01_Spine.SLDASM, 05_03_PL_R_001.SLDPRT, 05_04_AL_R_001.SLDPRT, 05_Knee_Right.SLDASM, 06_03_PL_L_001.SLDPRT, 06_04_AL_L_001.SLDPRT, 06_Knee_Left.SLDASM, 10_07_MM_L_001.SLDPRT]
2021-06-29 Fixed broken link
    Rebuilt, fixed broken link.
    [05_Knee_Right.SLDASM, 06_Knee_Left.SLDASM, 10_07_MM_L_001.SLDPRT, 10_Foot_Left.SLDASM]
2021-06-29 adding pressure sensor functionality
    Edited matlab file to store pressure sensor data (untested)
2021-06-30 adding pressure sending to matlab code
2021-06-30 adding sensor
2021-07-01 Knee encoder modifications complete
    I should figure out how to do this without copying every file
    [02_01_Pelvis.SLDPRT, 02_02_Sacrum.SLDPRT, 02_03_Ilium_Back_Right.SLDPRT, 02_04_Ilium_Front_Right.SLDPRT, 02_05_SocketShell_Back_Right.SLDPRT, 02_06_SocketShell_Front_Right.SLDPRT, 02_07_Ilium_Back_Left.SLDPRT, 02_08_Ilium_Front_Left.SLDPRT]
2021-07-01 completed force/pressure sensing
2021-07-09 Final
    Force & pressure sensing now fully working, arduino now also controls the valve to open when running tests
2021-07-12 increased baud rate of calibration sketches
2021-07-24 Created winch drum adapter
    Created an adapter for the winch drum, so the 1/8" wire rope doesn't have to be wound so tightly and then risk becoming unsprung during the testing.
    [WinchDrumAdapter.SLDPRT, WinchDrumAdapter.STL]
2021-07-26 started new leg mounts
    [03_01_FemurBone_Right.SLDPRT, 03_03_FemurBone_Left.SLDPRT, 04_05_BackLink.SLDPRT, 05_01_Tibial_Right.SLDPRT, 09_BipedalRobot_Assembly.SLDASM, PCB1.PcbDoc, altium_practice.SchDoc, first schematic.brd]
2021-07-26 changed winch drum expander to be smaller and have flange
    [WinchDrumAdapter.SLDPRT, WinchDrumAdapter.STL]
2021-07-26 Added coordinate system to tibia
    Playing around with changing the effective origin of the tibia without redesigning the part.
    [Tibia.SLDPRT]
2021-07-29 almost final
    board needs to be restarted after each test
2021-08-02 finished sketch of patella placement
    [AARL_Puppy_18_02_01_009-5388K140_Hose-Clamp.SLDPRT, AARL_Puppy_18_02_01_010.SLDPRT, AARL_Puppy_18_02_01_011.SLDPRT, BifemSH_brkt_insertion.SLDPRT, Patella_v3_template.SLDPRT, Tibia.SLDPRT, Tibia_vastus_brkt.SLDPRT]
2021-08-04 new files
    [02_01_PE_001.SLDPRT, 02_02_SA_001.SLDPRT, 02_03_IB_R_001.SLDPRT, 02_04_IF_R_001.SLDPRT, 02_05_SB_R_001.SLDPRT, 02_06_SF_R_001.SLDPRT, 02_07_IB_L_001.SLDPRT, 02_08_IF_L_001.SLDPRT]
2021-08-06 new names
    [02_11_PA_001.SLDASM, 02_11_Pelvis_Assembly.SLDASM, 03_03_FB_L_001.SLDPRT, 03_06_FH_001.SLDPRT, 03_06_HC_001.SLDPRT, 04_03_KT_L_001.SLDPRT, 04_04_KB_L_001.SLDPRT, 09_BA_001.SLDASM]
2021-08-06 final final final file names
    [03_04_FH_L_001.SLDPRT, 05_02_TI_001.SLDPRT]
2021-09-23 Removed autosave, fixed mates
    Removed the autosave files. Fixed the mates on one robot for the left and right femurs.
    [03_Femur_Right.SLDASM, 04_02_FH_L_001.SLDPRT, 04_Femur_Left.SLDASM, 10_07_MM_L_001.SLDPRT, 10_Foot_Left.SLDASM]
2021-09-29 Added missing components
    Added missing encoder and encoder mounting hardware. Some broken mates still need to be fixed.
    [60355K450_BALL BEARING.SLDPRT, 91287A344_18-8 Stainless Steel Hex Head Screw.SLDPRT, 97163A107_TAPERED HEAT-SET INSERTS FOR PLASTIC .SLDPRT, MAE3-X-236-220-7-X.SLDPRT]
2021-10-08 Made block sketches
    Made block sketches to track patella insertion as a function of knee angle. It doesn't seem to want to do what we want it to. Maybe just run the test and hand measure the position at different knee angles.
2021-10-09 Moved new Bipedal Assembly into Solid Models folder
    Moved David's updated robot assembly, 00_BipedalRobot_Redesign, into Solid Models folder. It will become the current version, give it a version number. The other one should be archived, and give it a version number (maybe 000, maybe a different version?).
    [01_01_00_01_ML.SLDPRT, 01_01_00_02_ML.SLDPRT, 01_01_00_03_ML.SLDPRT, 01_01_00_04_ML.SLDPRT, 01_01_01_00_Ankle.SLDASM, 01_01_01_01_ABottom.SLDPRT, 01_01_01_01_ML.SLDPRT, 01_01_01_02_AExterior.SLDPRT]
2021-11-02 Point cloud file attempt
    Attempting to create files to make point clouds out of test leg solidworks parts. They will then be used to do optimization for muscle origin/insertion locations in Matlab.
    [Assem2^Assem2.51_test_with_patella_sketch.SLDPRT]
2021-11-10 Added knee functions
    [Patella_v3_template.SLDPRT]
2021-11-17 Change opensim and matlab knee extensor
    Used via points in knee extensor file to make it more like OpenSim. Changed sign convention in tibia bracket and now the length graph looks more like it should. Changed opensim to call geometry path from D: drive.
2021-11-19 Changed Load cell pins.
    Tried to run Zero Factor and Calibration factor, too. But Arduino on this machine is being buggy. Will try it on another.
    [KneeTorqueTest.ino, SLoadCell_CalibrationFactorSketch.ino, SLoadCell_ZeroFactorSketch.ino]
2021-11-30 Changed baud rate, Added ppt to docs
    Changed baud rate for knee torque test to 57600. Also added Aidan's powerpoint documentation.
2021-12-02 Ignore autosave files, got sketches and function working.
    Data collection in Matlab and Arduino work correctly now.
    [SLoadCell_CalibrationFactorSketch.ino]
2021-12-10 Modified Muscle calculations to use cross product instead of dot product
    Muscle calculations now use cross product for moment arm instead of dot product. Seems to give a better result. Gait2392 was changed to show only uniarticular knee muscles. Other muscles are present, just hidden. Knee Function now graphs more data of interest.
2021-12-27 Removed testing images, changed code, changed solid models, collected data
    [10 mm Model Generated Torque Data_Mar2021.xlsx, BifemSH_brkt_insertion.SLDPRT, BifemSH_brkt_origin.SLDPRT, BifemSH_brkt_origin.STL, Femur_donut_1.SLDPRT, Femur_donut_1.STL, Femur_donut_2.SLDPRT, Femur_donut_2.STL]
2022-01-10 updating knee assembly parts
    Knee assembly parts being updated for "TAROS" knee test. Now modern knee test.
    [02_01_PE_001.SLDPRT, 03_01_FB_R_001.SLDPRT, 03_02_FH_R_001.SLDPRT, 03_03_FB_L_001.SLDPRT, 03_04_FH_L_001.SLDPRT, 04_01_KT_R_001.SLDPRT, 04_02_KB_R_001.SLDPRT, 04_02_KB_R_002.SLDPRT]
2022-01-11 Updating Assembly 3
    [0.25-20_Rod_Model.SLDPRT, 02_01_PE_001.SLDPRT, 03_01_FB_R_001.SLDPRT, 03_01_FB_R_002.SLDPRT, 03_01_Femoral_Knob_Right.SLDPRT, 03_02_FH_R_001.SLDPRT, 03_02_Femoral_Head_Right.SLDPRT, 03_03_FB_L_001.SLDPRT]
2022-01-14 FInishing Assembly 3
    [03_01_FB_R_002.SLDPRT, 05_01_TI_R_002.SLDPRT, 05_01_TI_R_002.STL, 09_BA_001.SLDASM]
2022-01-18 Finished Femur. Added muscle origin part.
    Muscle origin part is incomplete. Femur is ready to print.
    [03_01_FB_R_002.SLDPRT, 03_01_FB_R_002.STL, 05_01_TI_R_002.SLDPRT, 09_BA_001.SLDASM, MuscleOrigins.SLDPRT, Vastus_brkt_origin.SLDPRT]
2022-01-18 Modified muscle origin part
    Needs mating notch and connection to from femur body part to muscle origin parts.
    [09_BA_001.SLDASM, MuscleOrigins.SLDPRT]
2022-01-20 Modified endcap design and made configurations
    Modified 20 and 40 mm endcap designs. Made configurations for endcaps to use wire rope and not shoulder bolts.
    [09_BA_001.SLDASM, AARL_Puppy_18_02_01_012_Festo20mm_U10port.SLDPRT, AARL_Puppy_18_02_01_012_Festo20mm_U10port.STL, AARL_Puppy_18_02_01_012_U10port_cutout.SLDPRT, AARL_Puppy_18_02_01_012_U10port_cutout.STL, AARL_Puppy_18_02_01_014_Festo40mm_U10port.SLDPRT, AARL_Puppy_18_02_01_014_Festo40mm_U10port.STL, AARL_Puppy_18_02_01_014_U10port_withCutout.STL]
2022-01-20 Modified muscle origin piece
    Needs nut hole and to join main body to muscle origin locations.
    [09_BA_001.SLDASM, MuscleOrigins.SLDPRT]
2022-01-20 Updated muscle origins part(s)
    Tried to use configurations. Only kinda worked. STL files were made and are in the queue. Future muscle origin parts will need better configuration management or two separate parts.
    [09_BA_001.SLDASM, AARL_Puppy_18_02_01_010.SLDPRT, MuscleOrigins.SLDPRT, MuscleOrigins_001.SLDPRT, MuscleOrigins_001_fullSize.STL, MuscleOrigins_002.SLDPRT, MuscleOrigins_002.STL]
2022-01-24 Finished Muscle origins part.
    [05_01_TI_R_002.SLDPRT, 05_01_TI_R_003.SLDPRT, 05_01_TI_R_003.STL, 09_BA_001.SLDASM, AARL_Puppy_18_02_01_014_Festo40mm_U10port.SLDPRT, AARL_Puppy_18_02_01_014_Festo40mm_U10port.STL, AARL_Puppy_18_02_01_014_U10port_withCutout.STL, MuscleOrigins_001.SLDPRT]
2022-01-24 fixed end cap cutouts
    fixed endcap cutout depth on muscleorigins_002 part
    [MuscleOrigins_002.SLDPRT, MuscleOrigins_002.STL]
2022-01-29 Change moment arm calculation back to dot product method
    Changed the moment arm calculation back to Connor's dot product method.
2022-01-31 started testing
    Reverted back to Dot product method. Started testing 10mm Flexor.
    [09_BA_001.SLDASM, MuscleOrigins_001.SLDPRT, PressureSensorCalibration.xlsx, Results_table.xlsx, Results_table_10mm.xlsx]
2022-02-01 Finished 10mm flexor testing
    collected data for 10 mm Festo flexor testing.
    [PressureSensorCalibration.xlsx, Results_table_10mm.xlsx]
2022-02-02 Put in resting muscle length for extensor 10 mm
    [Results_table_10mm.xlsx]
2022-02-05 Did 2 10mm extensor tests
    [Results_table_10mm.xlsx]
2022-02-06 Redid measurements for 2 extensor tests
    [PressureSensorCalibration.xlsx, Results_table_10mm.xlsx]
2022-02-06 Finished Extensor 10 mm data collection
    [PressureSensorCalibration.xlsx, Results_table_10mm.xlsx]
2022-02-07 Added a moment arm line
    [09_BA_001.SLDASM]
2022-02-07 Update results with actual moment arm for extensor test
    [Results_table_10mm.xlsx]
2022-02-09 Organized test data, change muscle routing Location in matlab
    [04_02_KB_R_002.SLDPRT, 09_BA_001.SLDASM, MuscleOrigins_001.SLDPRT, Results_table_10mm.xlsx, Results_table_FullSize.xlsx]
2022-02-09 Updated muscle parts
    Part broke. Added a fillet for stress relief. Extensor boss was too wide. Created new STL file from updated part and it is being printed.
    [09_BA_001.SLDASM, MuscleOrigins_001.SLDPRT, MuscleOrigins_001.STL]
2022-02-12 Made changes to code and created new assembly.
    [Assem2.75.SLDASM]
2022-02-13 Collection of FlexTest 20mm
    I collected 17 data points for the flexor muscle with a 20mm BPA
    [Results_table_FullSize.xlsx]
2022-02-13 Created 3 new parts for pinned knee joint test
    3 new parts to make a pinned knee joint. To be used with previous femur and tibia from Assembly 2.51. Newer old assembly is 2.75. Modified descriptors in Femur and Tibia. Modified line 251 in MonoPamDataPhyscialFlexor to use the better interp1 method instead of outdated interp1q.
    [FemoralEnd_pinned^Assem2.75.STL, Femur.SLDPRT, Mating-Backpiece^Assem2.75.STL, Tibia.SLDPRT, TibiaEnd_pinned^Assem2.75.STL]
2022-02-14 Added Data Points for Flexor
    I added Extensor test 2-12 to the datapool
    [PressureSensorCalibration.xlsx, Results_table_FullSize.xlsx]
2022-02-14 Finished 40mm Extensor test
    ran ExtTest13. Results table FullSize is done. Extensor test has negative knee angle for flexion and positive for extension.
    [Results_table_FullSize.xlsx]
2022-02-18 created knee test pinned parts
    [BifemSH_brkt_insertion_pinned.SLDPRT, BifemSH_brkt_insertion_pinned.STL, BifemSH_brkt_origin.SLDPRT, BifemSH_brkt_origin_10mm.STL, FemoralEnd_pinned^Assem2.75.STL, Results_table_10mm_pinned_FishScale.xlsx, TibiaEnd_pinned^Assem2.75.STL, Tibia_vastus_brkt_pinned.SLDPRT]
2022-02-19 Update results 10mm pinned
    [Results_table_10mm_pinned_FishScale.xlsx]
2022-02-23 Working on making plots and graphs
    For experiments
    [BifemSH_brkt_origin.SLDPRT]
2022-02-28 Updated code and added graphs to pinned experiments
    [Results_table_10mm_pinned_FishScale.xlsx]
2022-03-04 Data analysis
    [Results_table_10mm_pinned_FishScale.xlsx]
2022-03-08 Added data collection runs for pinned knee with fish scale
    [PressureSensorCalibration.xlsx, Results_table_10mm_pinned_FishScale.xlsx]
2022-03-09 Collected more data
    [PressureSensorCalibration.xlsx, Results_table_10mm.xlsx, Results_table_10mm_pinned_FishScale.xlsx]
2022-03-10 Data collected
    [Results_table_10mm.xlsx, Results_table_10mm_pinned_FishScale.xlsx]
2022-03-11 Working on plotting data
    [Results_table_10mm.xlsx, Results_table_10mm_pinned_FishScale.xlsx]
2022-03-12 working on plots
    [Results_table_10mm_pinned_FishScale.xlsx]
2022-03-13 Collected data with load cell
    [Results_table_10mm_pinned_FishScale.xlsx, Results_table_10mm_pinned_LoadCell.xlsx]
2022-03-14 Took more data
    Data for multiple extensor tests was recorded. Zero factor and calibration factor were adjusted.
    [Results_table_10mm_pinned_FishScale.xlsx, Results_table_10mm_pinned_LoadCell.xlsx]
2022-03-17 Fixed spelling errors, made force calculation more accurate
    Made force calculation more accurate by taking into account known pressure and maximum BPA contraction %
    [Results_table_10mm_pinned_FishScale.xlsx, Results_table_10mm_pinned_LoadCell.xlsx]
2022-03-17 Saved results for different pinned extensor lengths
    Saved results for different pinned extensor lengths
    [BifemSH_brkt_insertion_pinned.SLDPRT, BifemSH_brkt_origin.SLDPRT, Results_table_10mm.xlsx, Results_table_10mm_pinned_FishScale.xlsx, Results_table_10mm_pinned_LoadCell.xlsx]
2022-03-18 Plotting functions
    Plotting functions to plot all the tests. Worked out the kinks. Created figures. Saved data.
    [Results_table_10mm_pinned_LoadCell.xlsx]
2022-03-18 Created pinned knee flexor figures, created Festo Lookup tables
    [Results_table_10mm_pinned_FishScale.xlsx]
2022-03-19 Working on curve fits
    Also one Fish Scale had the wrong length. Need to redo 48.5 cm long flex.
2022-03-20 Three New tests ran
    we ran flexor test 3 and extensor test 5 & 6
    [Results_table.xlsx, Results_table_10mm_pinned_LoadCell.xlsx]
2022-03-20 Created more figures
    Created more figures. Refined FestoLookupTable. Created MonoPamDataExplicit to be good for any PAM calculation given more initial information.
    [Results_table_10mm_pinned_FishScale.xlsx]
2022-03-21 Prep for 40mm test
    We setup the 40mm extensor test and see if it would explode or not. good news it didnt
    [PressureSensorCalibration.xlsx, Results_table_FullSize.xlsx]
2022-03-22 Moved data to single folder.
    Moved data to single overall folder for easier processing. Created .eps figures from matlab .figs. Removed autosave solidworks files. Added test jig to assembly 2.75 (pinned knee). Created folder for figures that will be used in Frontiers knee test paper.
    [BifemSH_brkt_insertion_pinned.SLDPRT, BifemSH_brkt_origin.SLDPRT, Results_table_10mm_pinned_LoadCell.xlsx, Test_Jig.SLDASM]
2022-03-22 Removed extra trend lines
    [Results_table_10mm_pinned_LoadCell.xlsx]
2022-03-24 Created better plots. Saved figures.
    [Results_table.xlsx, Results_table_10mm.xlsx, Results_table_10mm_pinned_FishScale.xlsx, Results_table_10mm_pinned_LoadCell.xlsx, Results_table_FullSize.xlsx]
2022-03-25 Created more figures. Broke leg.
    Created more figures for the report. Leg broke during testing of ExtTest2_2.
    [04_02_KB_R_002.SLDPRT, 09_BA_001.SLDASM, Results_table_10mm.xlsx, Results_table_10mm_pinned_FishScale.xlsx, Results_table_10mm_pinned_LoadCell.xlsx, Results_table_FullSize.xlsx]
2022-03-26 More figures, more robust code.
    [Results_table_10mm.xlsx, Results_table_10mm_pinned_LoadCell.xlsx, Results_table_FullSize.xlsx]
2022-03-27 created more figures for report
    more and more and more figures
    [04_02_KB_R_002.SLDPRT, 09_BA_001.SLDASM, Results_table_10mm_pinned_LoadCell.xlsx, Results_table_FullSize.xlsx]
2022-04-07 Working on plots for bionic knee
    10mm flexor and extensor. Making adjustments to plots and routing path for extensor. Hard to get everything to match.
    [09_BA_001.SLDASM, 10_AH_001.SLDASM, Results_table_10mm.xlsx, Results_table_10mm_pinned_LoadCell.xlsx, Results_table_FullSize.xlsx]
2022-04-09 Working on minimizing function
    Minimizing function to reduce guess and check for curve fit
    [Results_table_10mm.xlsx]
2022-04-14 Working on optimization
    Fixed festo4 and FestoLookup table to work for 20mm BPAs. Removed large section of Knee_Flexor_Pinned that delt with human muscle comparison. Changed minimization function to use experimental data (instead of fit) for comparison. Working on making Plot for KneeFlxPin10mm_46cm standardized.
2022-05-11 added Festo MuscleSIM program. Removed redundant files
    Removed redundant .mat files because otherwise program might call the wrong ones. Festo tool can be used to find Force, Contraction, Pressure, or Resting Length.
2022-05-16 FestoLookup40 works better
    Made a fit function for the festo 40 mm data using Poly52 or 51. Also saved curve fitting app data.
2022-05-19 Change call of ForceStrain
    Changing which columns to call for ForceStrain. Before it was assumed that the 20 columns of Force Strain was evenly spaced between 0 and 620 kPa. Now it is known that it is only columns 2:19 that represent evenly spaced pressure from 0 to 620 kPa.
2022-05-20 Corrected force functions
    FestoLookup should be good. The info for the 10mm during stretching reflects festo data.
    [Results_table_10mm.xlsx, Results_table_10mm_pinned_FishScale.xlsx, Results_table_10mm_pinned_LoadCell.xlsx]
2022-05-23 Create BPArestingLength_maxStrain.xlsx
    Ben, Dr. Hunt, and Lawrence used a variety of BPA resting Lengths. This workbook helps combine these data to see if there is a relationship between maximum strain and resting length.
    [BPArestingLength_maxStrain.xlsx]
2022-05-25 Updating graphs and data analysis
    [BPArestingLength_maxStrain.xlsx, Results_table_10mm_pinned_FishScale.xlsx, Results_table_10mm_pinned_LoadCell.xlsx, Results_table_FullSize.xlsx]
2022-05-26 Re-measured resting length and max contracted length
    Also deleted autosave files
    [BPArestingLength_maxStrain.xlsx, Results_table_10mm.xlsx, Results_table_10mm_pinned_FishScale.xlsx, Results_table_10mm_pinned_LoadCell.xlsx, Results_table_FullSize.xlsx]
2022-08-26 Added trendline
    Added 3rd degree polynomial in Results table for the flexor muscle. Got rid of the maxStrain table because it is also located in the Muscle Sensory repository under Lawrence's branch.
    [BPArestingLength_maxStrain.xlsx, Results_table_10mm_pinned_FishScale.xlsx]
2022-08-27 Created f10 and HuntEq m files
    f10 uses a function that was fit to the surface of Dr. Hunt's lookup table. HuntEq solves Dr. Hunt's festo BPA equation for force and can be called by other programs. This was previously in LookupTable_generate but was moved to a separate m-file because there are other times we may want to use it.
    2 comments added to MonoPamDataExplicit.
    Knee_Flexor_Pinned had human comparison data and plotting removed.
    FestoLookup had the save command commented out so that I can do some tests without overriding existing data and fits that seem to work fairly well. Might want to add a 10mm fit based off of the App we got from Festo.
2022-08-30 Delete unused pictures, add testing data for BPA
    Pictures were from an old testing method that we decided not to use. Started testing two BPA lengths for Force as a function of length at "max" pressure (620 kPa). Will test the longer BPA length with a few types of artificial tendon.
    [Flex3_01_horz_Results.csv, Results_Extensor_10.csv, Results_Extensor_11.csv, Results_Extensor_3.csv, Results_Extensor_4.csv, Results_Extensor_5.csv, Results_Extensor_6.csv, Results_Extensor_7.csv]
2022-08-31 Added test condition for BPA
    Tested 41.5 cm BPA with Paracord. Recalibrated SLoadCell.
    [StraightForceTest.xlsx]
2022-09-01 Trying to utilize Matlab's arduino support package
    Temperature Logging is an example sketch from Matlab to just have Matlab read and send information to arduino by skipping the arduino IDE. I'm converting it to read the pressure sensor. I also want it to use the LoadCell data from the HX711 but since it's a 24-bit ADC we need the microcontroller to do some of the processing before sending the information to Matlab. Therefore I've included the HX711 add-on code to the Matlab folder. It doesn't seem to work, but this may be a problem with my Matlab install on the EB590 machine "EB475WS4.cecs.pdx.edu".
2022-09-02 Added HX711 library for Matlab
    Reinstalled MATLAB. Installed Matlab HX711 library to use with Arduino add on. It works. Added another test on the 41.5 cm BPA with it using bicycle brake cable.
    [StraightForceTest.xlsx]
2022-09-03 added advanced hx711 library
    added advanced hx711 library. need to test it and basic usage still. Convert temperatureLogging to read LoadCell data.
2022-09-04 ran test on 45.5 cm 10mm BPA
    ran a test on 45.5 cm 10 mm BPA. Incomplete because Lawrence's part blew up in my face, again. Data recorded to StraightForceTest. Pressure sensor recalibrated. Temperature Logging doesn't work as given to me by Lawrence. I found this out after making a more advance copy called Pressure Data, which saves an excel spreadsheet called Pressure_Data. Updated HX711 app to include pressure data. It worked for a while but the bad thing about this app is that it needs to be recalibrated after every time it's started. HX711 library couldn't be found after a while. Maybe the computer just needs to restart.
    [PressureSensorCalibration.xlsx, StraightForceTest.xlsx]
2022-09-07 Modified README for functions
    Added the rest of the functions and their descriptions. Added a missing data point to straightforcetest graph. Tried to modify Alex's equation parameters to get the correct ForceStrainTable.
    [StraightForceTest.xlsx]
2022-09-13 Took two more data measurements
    the 45.5cm BPA might be finished.
    [StraightForceTest.xlsx]
2022-09-14 Took more data for 49 cm BPA
    Also created a hello world sketch. Having a hard time loading HX711 libraries in Matlab but it seems to be a problem with the WS4 computer because data was collected on my laptop.
    [StraightForceTest.xlsx]
2022-09-16 Results for 52 cm BPA
    Matlab HX711 app works now. I think the library for it under one of the HX711 v3.0 folder is corrupt. Will replace with working.
    [StraightForceTest.xlsx]
2022-09-20 Collected more data
    Collecting data to develop functions. One function will be maximum force (@ 620 kPa) as a function of resting length. The second will be for maximum strain as a function of resting length. Recalibrated pressure sensor. Incorporated modified pressure fit equation into app.
    [PressureSensorCalibration.xlsx, StraightForceTest.xlsx]
2022-09-21 More data measurements
    Tested multiple lengths of BPA. Noted what the suspected batch number is. No clear function for max strain as a function of length. Clear relationship between maximum force as a function of length.
    [StraightForceTest.xlsx]
2022-10-04 Added one more length
    Added one more length of BPA for max force measurement. Very short. Helps find the zero value for the max force equation.
    [StraightForceTest.xlsx]
2022-10-04 Curve fitting
    [StraightForceTest.xlsx]
2022-10-05 added lawrence's Fmax and kmax data
    [StraightForceTest.xlsx]
2022-10-06 Improved fit. Max. force function is good to go.
    Maximum force at max pressure as a function of resting length is good. Maximum force as a function of resting length and pressure is really good. Hypothesis that max strain is a linear or quadratic function of resting length is disproven.
    [StraightForceTest.xlsx]
2022-10-14 Created maxBPAforce function, modified 10mm characterization data
2022-10-23 Modified 10mm BPA force functions
    Created normF10, to find the normalized force for a BPA given relative strain and relative pressure. Option to give four different force values, depending on function fit. Modified f10 for a better fit of coefficients. Created _final files to avoid a conflict un-pushed commits on Ben's machine in the lab. Created bpaForce10 to combine force values from maxBPAforce and norm10 functions.
2022-10-26 Working on 48cm plots.
2022-11-02 Working on optimization
    Save data with fitting length of 0.0254 m. Added RMSE values to 46 and 48cm plot scripts. It seems like polynomials have better fit. Need to explain why. Need to modify minimization function to find RMSE, but of which function? Could be simplified exponential, but have to explain why.
    [Results_table_10mm_pinned_FishScale.xlsx, Results_table_10mm_pinned_LoadCell.xlsx]
2022-11-05 Optimization function work
    Created a way to plot results for 46 and 48 cm after optimization runs
2022-12-08 Added picture
    added picture and updated bibliography. Picture compares human and robot knee joint locations as a function of knee angle, as well as robot ICR location.
2022-12-09 Added pictures
    Removed unnecessary pictures from folder. Added improved pictures for curve fit and Pinned Knee Flexor group. Optimized fitting length for 48cm flexor.
2022-12-10 Finished Bio Knee 10mm Flexor
    FIgures and code is complete for the 10mm Flexor BPA used in the biomimetic knee.
    [Results_table_10mm.xlsx, Results_table_10mm_pinned_FishScale.xlsx, Results_table_10mm_pinned_LoadCell.xlsx]
2022-12-11 Modified ExtPin10mm plot scripts
    Need to analyze and optimize data. Plotting scripts are good and standardized now.
    [Results_table_10mm.xlsx, Results_table_10mm_pinned_LoadCell.xlsx, StraightForceTest.xlsx]
2022-12-12 Modified plots
    Modified axis of plots to make comparisons between tendon and no tendon easier.
    [Results_table_10mm_pinned_LoadCell.xlsx]
2022-12-12 Updated MonoPamDataExplicit, moved figures
    Updated MonoPamDataExplicit so that it was the same as MonoPamDataExplicit_compare, except the force calculation for 10mm only calls the simplified exponential force model (Fn4) from normF10. Moved all of the pictures in the Figure Components folder into subfolders for easier organization. Should allow for easier type setting from editors, or deletion if needed. Also added a _deprecated subfolder for figures that I will probably delete but may still have a use for.
2022-12-13 More figures, added fits
    Added fit figures for f20 and f40. Normalized f20 and f40. Now when calling them use relative strain and relative pressure. Festo4 updated to calculate this. Created a figure for Ext10mm_group, even though 41.5cm results aren't optimized. Removed old ExtPin_10mm figures and files. MonoPamDataExplicit is updated to be like MonoPamDataExplicit_compare except to only call for force calculations using the simplified exponential equation.
    [Results_table_10mm_pinned_FishScale.xlsx, Results_table_10mm_pinned_LoadCell.xlsx]
2022-12-14 Figures
    Some figures need to be reworked. But the last one to make is the 20 mm Flexor configuration.
2022-12-18 Updated pdf
    Updated pdf of paper. Paper is not complete.
    [Results_table_10mm.xlsx, Results_table_FullSize.xlsx, StraightForceTest.xlsx]
2023-01-15 added pictures of tests
    For measurements of actual tendon length
    [Results_table_FullSize.xlsx]
2023-01-22 Added Functions
    Added more functions from the Modern Robotics toolbox, including Adjoint to calculate changing the Wrench frame of reference. Modified plot for Extensor pinned 42mm to update the tendon length. Started modifying the biomimetic knee calculations so that we can calculate torque about the Knee's ICR.
2023-01-23 Working on wrapping point locations for pinned extensor tests
    [0.25-20_Rod_Model.SLDPRT, 8020_1515UL_CameraFrame_14in.SLDPRT, 8020_1515UL_CameraFrame_23in.SLDPRT, 8020_1515UL_CameraFrame_37in.SLDPRT, 8020_1515UL_GeneralFrameHorizontal_36in.SLDPRT, 8020_1515UL_GeneralFrame_Foot_15in.SLDPRT, 8020_1515UL_GeneralFrame_Foot_42in.SLDPRT, 8020_1515UL_GeneralFrame_LowerPulleySupport_12in.SLDPRT]
2023-01-28 Updated 10mm biomimetic routing
    [03_01_FB_R_002.SLDPRT, 04_01_KT_R_002.SLDPRT, 04_02_KB_R_002.SLDPRT, 04_05_BL_001.SLDPRT, 04_06_FL_001.SLDPRT, 05_01_TI_R_002.SLDPRT, 05_01_TI_R_003.SLDPRT, 09_BA_001.SLDASM]
2023-01-29 Tried to improve modelling.
    [04_02_KB_R_002.SLDPRT, 09_BA_001.SLDASM]
2023-01-30 More modeling
    [09_BA_001.SLDASM, AARL_Puppy_18_02_01_010.SLDPRT]
2023-01-31 Updated results
    Now can quickly compare measured results to theoretical for 10mm extensor.
    [09_BA_001.SLDASM, Results_table_10mm.xlsx]
2023-02-11 improved biomimetic knee calculations
    [09_BA_001.SLDASM]
2023-02-11 new file
    separates biomimetic knee scripts for 10 and 20 mm ID flexor BPAs.
2023-03-13 Modifying calcs
    To measure actual torque
    [09_BA_001.SLDASM, Results_table_10mm.xlsx, Results_table_FullSize.xlsx]
2023-03-14 Working on flexor 20mm plot
    [Results_table_FullSize.xlsx]
2023-03-19 Collected more data for a 20mm 39cm flexor
    [PressureSensorCalibration.xlsx]
2023-03-21 Modified 2 parts for test
    [03_01_FB_R_003.SLDPRT, 03_01_FB_R_003.STL, 09_BA_001.SLDASM, MuscleOrigins_003.SLDPRT, MuscleOrigins_003.STL]
2023-03-22 Updated parts for strength
    [03_01_FB_R_003.SLDPRT, 03_01_FB_R_003.STL, 04_02_KB_R_002.SLDPRT, 04_02_KB_R_002.STL, 09_BA_001.SLDASM, AARL_Puppy_18_02_01_012_Festo20mm_M5port_ring.SLDPRT, AARL_Puppy_18_02_01_012_Festo20mm_M5port_ring.STL, MuscleOrigins_003.SLDPRT]
2023-03-22 Updated parts for ease of printing.
    [03_01_FB_R_003.SLDPRT, 03_01_FB_R_003.STL, 04_02_KB_R_002.SLDPRT, 05_01_TI_R_003.SLDPRT, 09_BA_001.SLDASM]
2023-03-23 Split femur part
    Created split femur part. Two bodies that will be easier to print if current part, 03_01_FB_R_004, fails to print or breaks during testing.
    [03_01_FB_R_004.SLDPRT, 03_01_FB_R_004_lateral.SLDPRT, 03_01_FB_R_004_lateral.STL, 03_01_FB_R_004_medial.SLDPRT, 03_01_FB_R_004_medial.STL]
2023-03-27 Added fillets to two areas
    Reduces the stress concentrations in these areas.
    [MuscleOrigins_003.SLDPRT, MuscleOrigins_003.STL]
2023-03-28 Trying to fix femur part
    [03_01_FB_R_003.SLDPRT, 04_01_KT_R_002.SLDPRT, 04_02_KB_R_002.SLDPRT, 04_05_BL_001.SLDPRT, 04_06_FL_001.SLDPRT, 05_01_TI_R_002.SLDPRT, 05_01_TI_R_003.SLDPRT, 09_BA_001.SLDASM]
2023-03-29 Removed simulation files. worked on strengthening parts.
    [03_01_FB_R_003.SLDPRT, 09_BA_001.SLDASM, MuscleOrigins_003.SLDPRT, MuscleOrigins_003.STL]
2023-04-04 Modified femur. Created folder for Bolen LM2023 document.
    [03_01_FB_R_003.SLDPRT, 03_01_FB_R_003.STL, 03_01_FB_R_004_lateral.SLDPRT, 03_01_FB_R_004_medial.SLDPRT, 04_01_KT_R_002.SLDPRT, 09_BA_001.SLDASM, MuscleOrigins_003.SLDPRT, MuscleOrigins_003.STL]
2023-04-08 New version of femur that can be printed in two parts.
    Also created a link that can span the posterior femur ribs.
    [03_01_FB_R_004_lateral.SLDPRT, 03_01_FB_R_004_lower.STL, 03_01_FB_R_004_medial.SLDPRT, 03_01_FB_R_004_ribLink.SLDPRT, 03_01_FB_R_004_ribLink.STL, 03_01_FB_R_004_upper.STL, 09_BA_001.SLDASM, MuscleOrigins_003.SLDPRT]
2023-04-12 Getting ready for data collection
    Need to adjust jig frame before collecting 20mm flexor data again.
    [Results_table_FullSize.xlsx]
2023-04-14 ran another test
    tibia ring broke, need to redesign and print.
    [Results_table_FullSize.xlsx]
2023-04-15 New part needed
    I want to finese the hamstring insertion location on the knee bottom before printing. Hand tuning some of the parametersfor a better torque match.
    [04_02_KB_R_002.SLDPRT, 09_BA_001.SLDASM, MuscleOrigins_003.SLDPRT]
2023-04-19 updated knee bottom design
    [04_02_KB_R_002.SLDPRT, 04_02_KB_R_002.STL, 09_BA_001.SLDASM]
2023-04-20 Broke femur, needs redesign
    [PressureSensorCalibration.xlsx, Results_table_FullSize.xlsx]
2023-04-21 Improved femur design
    Improved femur design by increasing the anterior rib's thickness and +X direction length, adding two side ribs to resist YZ plane bending, and simplifying the 4-bolt attachment area to reduce stress concentrations. During future test, it is also worth considering tying the knee extensor origin on MuscleOrigins_003 to the jig so that stress in the part will be reduced.
    [03_01_FB_R_004_lateral.SLDPRT, 03_01_FB_R_004_lateral.STL, 03_01_FB_R_004_medial.SLDPRT, 09_BA_001.SLDASM]
2023-04-24 New MESAday parts
    I should have this on google drive or something because it is not a Bipedal project.
    [Clip.SLDPRT, Cup.SLDPRT, Cup.STL, MotorHolder.SLDASM, Retainer.SLDPRT, Retainer.STL]
2023-04-24 Revised parts to fit together better slightly
    [Cup.SLDPRT, Cup.STL, MotorHolder.SLDASM, Retainer.SLDPRT, Retainer.STL]
2023-04-25 Finished MESA day part design
    Will move these files somewhere appropriate when possible.
    [Cup.SLDPRT, Cup.STL, MotorHolder.SLDASM, Retainer.SLDPRT, Retainer.STL, Sample.SLDPRT, Sample.STL]
2023-04-26 Took more data
    Showed that 42cm 20mm BPA can meet or exceed human isometric torque values for Bifemsh
    [09_BA_001.SLDASM, PressureSensorCalibration.xlsx, Results_table_FullSize.xlsx]
2023-05-11 Modified results plot so that data points will be sized based off of their pressure
2023-05-12 Improved results presentation
    For 20mm ID flexor on biomimetic knee
2023-05-17 Updated MESA day parts
    [Cup.SLDPRT, Cup.STL, Cup_tall.SLDPRT, Cup_tall.STL]
2023-05-17 Moved MESA day parts to Google Drive
    Since they're not part of my knee torque test
    [Clip.SLDPRT, Cup.SLDPRT, Cup.STL, Cup_tall.SLDPRT, Cup_tall.STL, MotorHolder.SLDASM, Retainer.SLDPRT, Retainer.STL]
2023-06-11 Working on balance equation
    Also added a table for equation fits and coefficient values
    [CoefficientTable.xlsx]
2023-06-12 Improved table
    Used table to build one in overleaf using https://tablesgenerator.com/
    [CoefficientTable.xlsx]
2023-06-13 Added 620 kPa fit
    Added fit using Fmax(strain,Pressure) equation, modified for 620 kPa, using only data recorded near 620 kPa. Uploaded most current version of paper so that I could print it out and make edits.
2023-09-21 Adding 10mm Festo data
    Added description to a couple of variables in Fmax_CurveFit. Created FestoLookup_v2 to modify FestoLookup by adding fit for 10 mm BPA. Also modifying 20 and 40 mm data to include force at 620 kPa.
2023-09-28 Working on 10mm fit
    Per Dr. Hunt's request
2023-10-23 Ben_Lawrence_data_10mm
    Is the working version that is being modified. The other one without the "_10mm" is an older version that was used for analysis. It will be deleted once the "_10mm" version is fully refined.
    [StraightForceTest.xlsx]
2023-10-28 Updated data processing script
    It matches the one in Muscle Sensory repository. Got rid of the other file to avoid confusion.
2023-11-07 Created an additional table
    One table for F^* and one for F_max, coefficients and gof
    [CoefficientTable.xlsx]
2023-12-01 Gantt chart
    let's get this paper outta 'ere
    [Paper Gantt chart.xlsx]
2023-12-05 Updated gantt chart and figures
    [Paper Gantt chart.xlsx]
2023-12-06 Updated Fmax figure
    All parts
    [Paper Gantt chart.xlsx]
2023-12-08 Created Fmax20 script
    Also updated Gantt chart.
    [Paper Gantt chart.xlsx]
2023-12-10 Finalized 10 and 20 mm normalized force fits
    For now
    [CoefficientTable.xlsx, StraightForceTest.xlsx]
2023-12-11 trying to add 8 more sets of data
    [StraightForceTest.xlsx]
2023-12-12 iimproved fit
    Not by increasing accuracy, but by increasing robustness of analysis. (removed errors)
    [CoefficientTable.xlsx, StraightForceTest.xlsx]
2023-12-12 curve fit finalizing
    some error in importing lawrence's code. time to go to sleep.
    [CoefficientTable.xlsx, StraightForceTest.xlsx]
2023-12-15 fit is ready
    looks like we should drop R2 tests (Nov_22)
    [StraightForceTest.xlsx]
2023-12-18 Now i just need a slice or something
    find out how to make isolines
    [Results_table_10mm.xlsx, Results_table_10mm_pinned_FishScale.xlsx, StraightForceTest.xlsx]
2023-12-20 GeneralizedForceFit figure and excel files
    GeneralizedForceFit saved as eps and sent to Alex. Coefficient tables and straight force test finished.
    [CoefficientTable.xlsx, StraightForceTest.xlsx]
2024-01-04 Compare 20mm data (actual) to Festo
    Also update bibliography.
2024-01-04 20mm characterization
    Good fit with festo, better when we discared 30cm resting length. 30 cm data is being recollected now.
2024-01-25 Updating fit
    Trying to get rid of "noisy" data per discussion w/ Alex. My 11cm and 45 cm l_rest and Lawrences 13 cm l_rest seem to have most scatter.
2024-01-29 curve fitting
    will this ever be done!?!?!
    [CoefficientTable.xlsx, StraightForceTest.xlsx]
2024-01-30 curve fitting
    Done with Fmax fits! Hopefully fr this time.
    [CoefficientTable.xlsx, StraightForceTest.xlsx]
2024-02-04 Curve fitting
    Curve fitting curve fitting curve fitting a;sldkfja;sdlfkja;sdfkj a;sdlfkj;fknadfvoiwejrf'[ajpl
    [CoefficientTable.xlsx]
2024-02-09 Slight modifications?
    [CoefficientTable.xlsx, StraightForceTest.xlsx]
2024-03-23 FlxPin_Group done
    Finished the coding and figure generation for FlxPin_Group with updated force calculation, minimization, etc. mapped out flow chart. Started working on extensor group. For pinned extensor, once knee is flexed more than about 80 degrees the moment arm seems to stay flat at about 30 mm. Model that.
2024-03-25 modify extensor charts
    [Results_table_10mm_pinned_LoadCell.xlsx]
2024-03-26 figures, models, plots
    [03_01_FB_R_004.SLDPRT, 09_BA_001.SLDASM]
2024-04-03 one value missing
    [Results_table_10mm.xlsx, Results_table_10mm_pinned_FishScale.xlsx, Results_table_10mm_pinned_LoadCell.xlsx]
2024-08-13 Created path guide for pinned extensor
    Don't need it or correction factor though.
    [Femur.SLDPRT, Path_guide.SLDPRT, Path_guide.STL]
2024-11-01 Updated FulSize
    To reflect remeasured values.
    [Results_table_10mm.xlsx, Results_table_FullSize.xlsx]
2024-11-05 Gettting this to work
    [Results_table_FullSize.xlsx]
2024-11-06 Remeasured BPA Lrest and Lmin (not tendon)
    Also added text to data points below 600 kPa
2025-04-02 Making updates
    need to check insertion location!
2025-04-09 Updated optimizer.
    Results are much better. I need to introduce a force balance for the tendon.
    [Results_table_FullSize.xlsx]
2025-04-18 Everything works now
    Just need to separate GoF values for 620 kPa and 325 kPa on the 20 mm BPA.
2025-04-25 Updating results
    Reconfigured fittings for 20 mm BPA. Need to measure irl again to make sure this is valid.
    [Results_table_FullSize.xlsx]
2025-05-07 Updated optimizer and code
    changed Xi0 calculation method back. results are much better. Made 3rd objective function SSE for low torque values instead of Max. Residual.
2025-05-13 Fine-tuning minimizeFlx and minimizeFlx10mm
    [09_BA_001.SLDASM, MuscleOrigins_002.SLDPRT]
2025-05-13 Update minimizeFlx.m
    Added switch for Pbr depending on BPA diameter. reference MuscleOrigins001 and 002 solidworks files.
2025-05-20 Extensor results improved
    But I think the 42cm length needs kmax to be 345 or 340 mm, and the 48cm l_rest needs kmax to be down to 405 or back to 398. I changed it based off of the readings, but muscle length row in the excel files should be taken with a grain of salt, since they were measured in place, which is harder than when doing it when the ends are free.
2025-05-23 Getting rid of 42cm tendon test
2025-05-29 Created real time plot
    Real time plot for scores in gamultobj. Made it easy to switch between gamultobj and GODLIKE optimization.
2025-06-03 Pick 78
    f values all below baseline, except for max. residual on 48 cm BPA.
2025-06-11 Tried to refresh robot knee ICR to correct values. Now the graphs don't plot correct.
    Check location matrix. Check p3 and p4 first, then check other wrapping points, then check knee ICr location.
    [Results_table_10mm.xlsx]
2025-06-11 Verified knee torque data
    Need to plot biotorque knee results with minimizeExt10mm.m file. I think it's almost ready.
2025-06-18 changed figure
    Added results filter
2025-09-09 Added explainer comments to minimizeExtX3, got rid of unnecessary folder
    Functions folder should be under Code/Matlab folder. Having this folder copied at a higher level creates the possibility of a script using an outdated function. Explainer comments on minimizeExtX3 so that I can modify minimizeFlx and minimizeFlxPin to calculate Bracket deformation after applying constant length offset.
2025-09-15 updated two figures.
    [09_BA_001.SLDASM]
2025-09-17 Working on fixing minimizeExtX3
    I'm getting a weird "tail" on the 42cm torque curve. I thought it was solved previously.
2025-09-18 Updated extensor pin group
2025-09-23 changing muscle pathway
    [09_BA_001.SLDASM, AARL_Puppy_18_02_01_010.SLDPRT]
2025-09-24 Working on results
    It's trying to give negative cable stretch, which doesn't make sense. I'm trying to find the error. Found an error in p5/v5 and in Pbr, fixed it.
    [09_BA_001.SLDASM]
2025-09-29 Upgrading code
    [MuscleOrigins_002.SLDPRT]
2025-10-01 more results, models
    Something seems reversed in the minimizeFlx/minimizeFlx10mm scripts. Check transformation matrices.
    [04_03_KT_L_001.SLDPRT, 05_01_TI_R_002.SLDPRT]
2025-10-01 Create minimizeFlxPin10_results_20251001_2transforms.mat
    This does a transform about the global Z axis and then the resulting frames body Y axis.
2025-10-24 values and figs updated
    [CoefficientTable.xlsx]
2025-12-09 Differentiated documentation into two journal articles
    [CoefficientTable.xlsx, Paper Gantt chart.xlsx]
